mfkiwl/Cornell_CM_Rev2_HW/ClockBuilderPRO/docs/step_11b.jpg

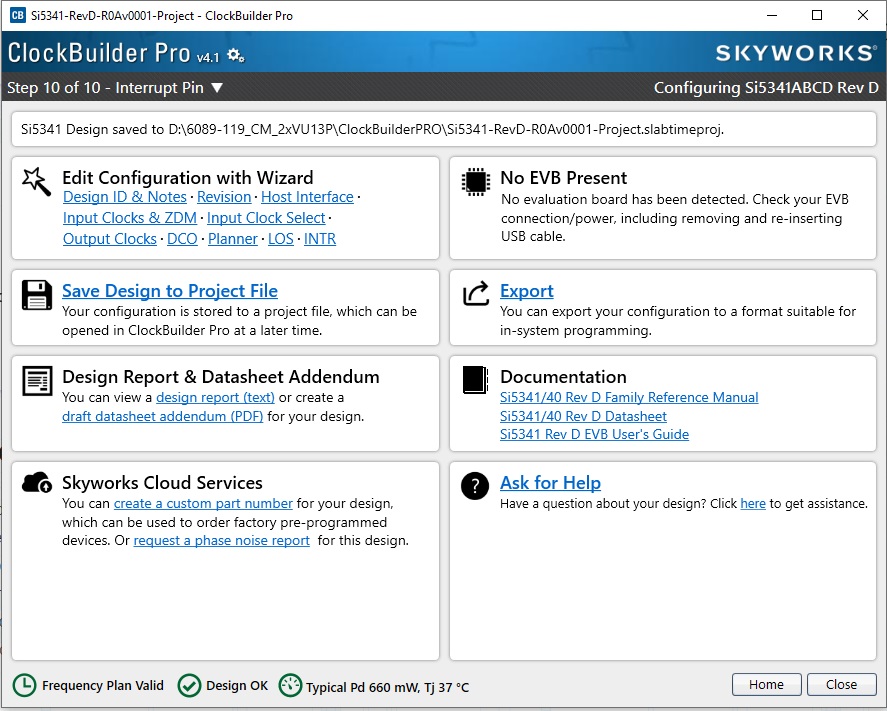
ClockBuilderPRO/docs/step_11b.jpg
