mfkiwl/Cornell_CM_Rev2_HW/ClockBuilderPRO/docs/step_12a.jpg

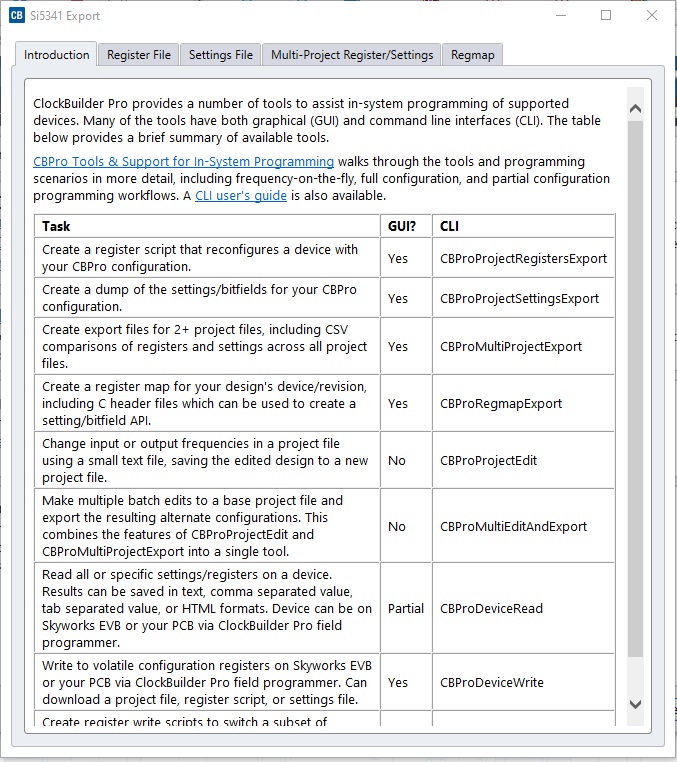
ClockBuilderPRO/docs/step_12a.jpg
