mfkiwl/Cornell_CM_Rev2_HW/Docs/MCU_serial_cable.pdf

MCU Serial Cable
1) The MCU serial cable should only be used when the CM is not mated to an SM. The connector just provides an on-board access point to a serial port that is connected to a serial port on the Zynq on the SM. Connecting the cable when the CM is mated to the SM could damage either the SM or the cable.
2) To use the MCU serial cable, connect it in the orientation shown in the photo below.

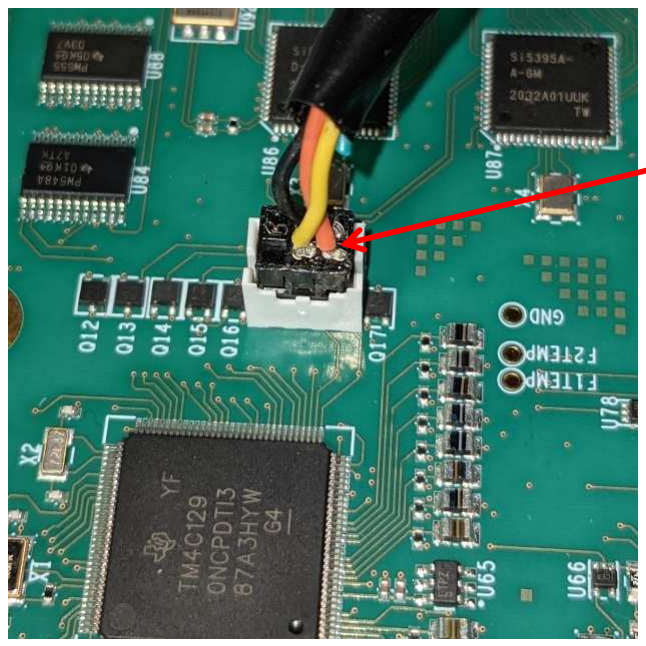
[picture p38: figure]

3) Notice that two pins should be cut off from inside the connector. If you insert the cable the wrong way, you would be trying to make a connection to these missing pins.

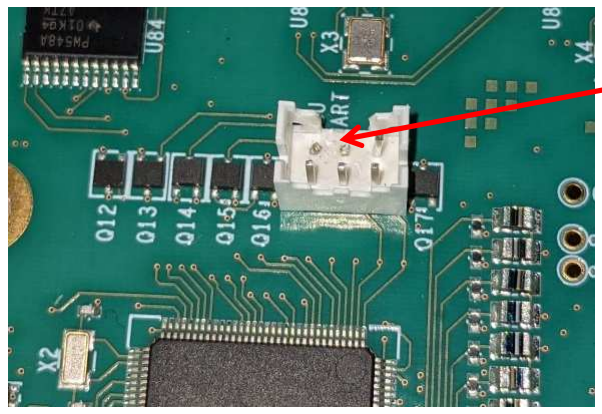
[picture p39: figure]

### Cut pins

### Orange wire at this

### corner
