mfkiwl/Cornell_CM_Rev2_HW/Docs/6089-119-RevB_summary_BOM_with_inventory_17May2022.xlsx

6089-119 |  | Rev B
Apollo Command Module V2, MK1
Qty | 11
Item | quan/board | Reference | Description | Vendor | Vendor Number | Manufacturer | Manufacturer Number | Value | Footprint | Required | On Hand | Excess | % Excess | Short | Unit Cost | Board Cost | DC Bias | Rating | Rating Mult
1 | 3 | BR1,BR2,BR3 | BRACKET FOR FRONT PANEL, SCREW M3 4 PIN PCB RA | DigiKey | 36-7761-ND | Keystone | 7761 | KEYSTONE_7761 | KEYSTONE_7761 | 33 | 35 | 2 | 6.060606061% | -2 | $0.34 | $1.03
2 | 4 | C97,C134,C136,C156 | CAP CER 12PF 50V C0G/NPO 0402 | DigiKey | 311-1641-6-ND | Yageo | CC0402FRNPO9BN120 | 12 PF | CAPC_EIA0402 | 44 | 100 | 56 | 127.2727273% | -56 | $0.02 | $0.09
3 | 2 | C296,C768 | CAP CER 470PF 16V NPO 0402 | DigiKey | 311-3745-6-ND | Yageo | CC0402JRNPO7BN471 | 470 PF | CAPC_EIA0402 | 22 | 100 | 78 | 354.5454545% | -78 | $0.03 | $0.07
4 | 6 | C2,C3,C4,C5,C6,C7 | CAP CER 10000PF 25V C0G/NP0 0603 | DigiKey | 399-7838-6-ND | Kemet | C0603C103J3GACTU | 0.01 UF | CAPC_EIA0603 | 66 | 82 | 16 | 24.24242424% | -16 | $0.21 | $1.25
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
18 | 8 | C455,C456,C488,C489,C673,C674,C702,C703 | CAP TANT POLY 220UF 6.3V 1411 | DigiKey | 399-5754-6-ND | Kemet | T520B227M006ATE035 | 220 UF | CAPTANT_3528_P1 | 88 | 94 | 6 | 6.818181818% | -6 | $0.71 | $5.70
19 | 10 | C22,C23,C24,C25,C26,C27,C227,C228,C295,C481 | CAP CER 330UF 2.5V X6S 1210 | DigiKey | 490-13972-6-ND | Murata | GRM32EC80E337ME05L | 330 UF | CAPC_EIA1210 | 110 | 106 | 8 | 7.272727273% | -8 | $1.13 | $11.33
 |  |  | Subst for Item 19 |  | 490-13974-1-ND | Murata | GRM32ER60E337ME05L | 330 UF | CAPC_EIA1210 |  | 12
20 | 48 | C449,C450,C451,C452,C453,C454,C482,C483,C484,C485,C486,C487,C500,C501,C504,C505,C516,C517,C518,C519,C525,C526,C527,C528,C586,C587,C588,C589,C609,C610,C611,C612,C627,C628,C645,C646,C667,C668,C669,C670,C671,C672,C696,C697,C698,C699,C700,C701 | CAP TANT 330UF 2.5V 20% 3528 | DigiKey | 399-18632-6-ND | Kemet | T520B337M2R5ATE018 | 330 UF | CAPTANT_3528_P1 | 528 | 524 | 54 | 10.22727273% | -54 | $0.57 | $27.41
 |  |  | Subst for Item 20 |  | 399-11709-1-ND | Kemet | T520B337M2R5ATE009 | 330 UF | CAPTANT_3528_P1 |  | 58
21 | 3 | D1,D2,D3 | LED RGB CLEAR 1206 SMD R/A | DigiKey | 1830-1052-1-ND | Inolux | IN-S126TASRGB | LED_RGB | LED_RGB_INS126T | 33 | 51 | 18 | 54.54545455% | -18 | $0.38 | $1.14
22 | 2 | D4,D5 | LED GREEN CLEAR 2SMD R/A | DigiKey | 754-1057-6-ND | Kingbright | APA2106CGCK | LED_GREEN | LED_APA2106 | 22 | 89 | 67 | 304.5454545% | -67 | $0.24 | $0.48
23 | 1 | J1 | MGRID HDR SHRD RA /SLOTSTDF | DigiKey | WM9841-ND | Molex | 878335320 | CON_2X7_RA | CON_2X7_2MM_RA_XILINX | 11 | 17 | 6 | 54.54545455% | -6 | $1.76 | $1.76
24 | 2 | J2,J3 | CONN RCPT USB2.0 MINI B SMD R/A | DigiKey | H11671CT-ND | Hirose | UX60SC-MB-5ST(80) | CON5 | USB_MINI_B_UX60SC_MB_5ST | 22 | 29 | 7 | 31.81818182% | -7 | $0.55 | $1.10
25 | 1 | J4 | CONN HEADER SMD R/A 10POS 1.27MM | DigiKey | SAM11216-ND | Samtec | FSH-105-04-L-DH-SL | CON10A | CONN_10PIN_FSH | 11 | 13 | 2 | 18.18181818% | -2 | $2.03 | $2.03
26 | 2 | J5,J6 | CONN RCPT HDMI 1.4 R/A NO FLANGE | DigiKey | 380-SS-53000-001-ND | Stewart | SS-53000-001 | CON_HDMI19_SS_53000_001 | CON_HDMI19_SS_53000_001 | 22 | 29 | 7 | 31.81818182% | -7 | $0.53 | $1.06
27 | 1 | J7 | PIN HEADER, SMT, DUAL ROW, 2.00 | DigiKey | 1849-PM20C03HBDN-ND | Metz | PM20C03HBDN | CON6 | HEADER_2MM_2x3_SMD_RA | 11 | 20 | 9 | 81.81818182% | -9 | $0.30 | $0.30
28 | 1 | J10 | TERM BLOCK HDR 4POS VERT 3.81MM | DigiKey | A98202-ND | TE | 284517-4 | TB4 | TB4 | 11 | 16 | 5 | 45.45454545% | -5 | $0.94 | $0.94
29 | 2 | J11,J12 | CONN HEADER SMD 20POS 1MM | DigiKey | SAM15625-ND | Samtec | FTM-110-03-L-DV | CON20A | CONN_FTM_20 | 22 | 23 | 1 | 4.545454545% | -1 | $3.95 | $7.89
30 | 4 | L1,L2,L3,L4 | FERRITE BEAD 600 OHM 0603 1LN | DigiKey | 732-1593-1-ND | Wurth | 742792651 | 600 OHM | IND_EIA0603 | 44 | 87 | 43 | 97.72727273% | -43 | $0.23 | $0.90
31 | 48 | L5,L6,L7,L8,L9,L10,L11,L12,L13,L14,L15,L16,L17,L18,L19,L20,L21,L22,L23,L24,L25,L26,L27,L28,L29,L30,L31,L32,L33,L34,L35,L36,L37,L38,L39,L40,L41,L42,L43,L44,L45,L46,L47,L48,L49,L50,L51,L52 | FIXED IND 1UH 2.8A 66 MOHM SMD | DigiKey | 445-180339-6-ND | TDK | TFM201608ALC-1R0MTCA | 1.0 UH | IND_0806 | 528 | 621 | 93 | 17.61363636% | -93 | $0.26 | $12.29
32 | 1 | P1 | CONN, RIGHT-ANGLE POWER/SIGNAL HEADER | Samtec | ET60T-D02-3-08-000-S-R1-S | Samtec | ET60T-D02-3-08-000-S-R1-S | ET60T | ET60T-02-24-00-X-RT1-GP | 11 | 12 | 1 | 9.090909091% | -1 | $8.40 | $8.40
33 | 2 | P2,P3 | CONN, RIGHT-ANGLE ERM8 2X13 | Samtec | ERM8-013-01-S-D-RA-TR | Samtec | ERM8-013-01-S-D-RA-TR | ERM8 | ERM8-RA-2X13 | 22 | 24 | 2 | 9.090909091% | -2 | $9.18 | $18.36
34 | 17 | Q1,Q2,Q3,Q4,Q5,Q6,Q7,Q8,Q9,Q10,Q11,Q12,Q13,Q14,Q15,Q16,Q17 | MOSFET N-CH 20V 1.5A 1.8V LOGIC LEVEL TUMT3 | DigiKey | RUF015N02TLDKR-ND | Rohm | RUF015N02TL | FET_N_1.8V | RUF015N02_FET | 187 | 260 | 73 | 39.03743316% | -73 | $0.26 | $4.42
35 | 12 | C882,C889,R301,R302,R384,R387,R399,R410,R421,R434,R441,R446 | RES SMD 0 OHM JUMPER 1/16W 0402 | DigiKey | 311-0.0JRTR-ND | Yageo | RC0402JR-070RL | 0 | CAPC_EIA0402 | 132 | 1000 | 868 | 657.5757576% | -868 | $0.0012 | $0.01
36 | 60 | R76,R77,R78,R79,R162,R187,R188,R190,R191,R205,R235,R268,R284,R287,R290,R292,R294,R309,R316,R335,R359,R374,R381,R382,R393,R462,R463,R464,R465,R466,R467,R473,R474,R480,R481,R484,R486,R487,R492,R494,R622,R623,R633,R634,R636,R638,R640,R642,R648,R652,R654,R656,R658,R663,R664,R665,R670,R676,R677,R678 | RES SMD 0.0OHM JUMPER 1/10W 0603 | DigiKey | 311-0.0GRTR-ND | Yageo | RC0603JR-070RL | 0 | RESC_EIA0603 | 660 | 1000 | 340 | 51.51515152% | -340 |  | $0.00
37 | 1 | R145 | RES 0.001 OHM 1% 3W 1216 | DigiKey | 541-3135-6-ND | Vishay | WSK12161L000FEB | 0.001 | RESC_WSK1216_4WIRE | 11 | 23 | 12 | 109.0909091% | -12 | $0.8080 | $0.81
38 | 2 | R20,R146 | RES 0.005 OHM 1% 1/2W 1206 4-WIRE | DigiKey | FC4TR005FERDKR-ND | Ohmite | FC4TR005FER‎ | 0.005 | RESC_FC4T_4WIRE_1206 | 22 | 81 | 59 | 268.1818182% | -59 | $0.3800 | $0.76
39 | 2 | R73,R74 | RES 0.01 OHM 1% 1/2W 1206 4-WIRE | DigiKey | FC4TR010FERDKR-ND | Ohmite | FC4TR010FER | 0.01 | RESC_FC4T_4WIRE_1206 | 22 | 84 | 62 | 281.8181818% | -62 | $0.3800 | $0.76
40 | 12 | R80,R83,R93,R97,R103,R108,R115,R119,R124,R129,R137,R138 | RES SMD 33 OHM 1% 1/10W 0603 | DigiKey | 311-33.0HRDKR-ND | Yageo | RC0603FR-0733RL | 33 | RESC_EIA0603 | 132 | 200 | 68 | 51.51515152% | -68 | $0.0029 | $0.03
41 | 80 | R33,R34,R35,R36,R37,R38,R39,R40,R41,R42,R43,R44,R45,R46,R47,R48,R49,R50,R51,R52,R53,R54,R55,R56,R57,R58,R59,R60,R61,R62,R63,R64,R65,R66,R67,R68,R69,R70,R71,R72,R498,R499,R500,R501,R502,R503,R504,R505,R506,R507,R508,R509,R510,R511,R512,R513,R514,R515,R516,R517,R518,R519,R520,R521,R522,R523,R524,R525,R526,R527,R528,R529,R530,R531,R532,R533,R534,R535,R536,R537 | RES SMD 49.9 OHM 1% 1/10W 0402 | DigiKey | 311-49.9LRDKR-ND | Yageo | RC0402FR-0749R9L | 49.9 | RESC_EIA0402 | 880 | 2000 | 1120 | 127.2727273% | -1120 | $0.0018 | $0.14
42 | 75 | R85,R86,R87,R88,R89,R90,R91,R92,R94,R96,R102,R104,R118,R121,R125,R127,R130,R132,R133,R135,R136,R139,R257,R258,R259,R260,R270,R271,R272,R273,R274,R275,R276,R277,R278,R279,R280,R281,R310,R311,R312,R313,R330,R331,R333,R334,R337,R338,R350,R351,R352,R353,R354,R355,R356,R358,R424,R425,R426,R427,R428,R429,R430,R431,R435,R436,R439,R440,R443,R444,R447,R469,R470,R471,R472 | RES SMD 100 OHM 0.1% 1/16W 0402 | DigiKey | YAG2301DKR-ND | Yageo | RT0402BRD07100RL | 100 | RESC_EIA0402 | 825 | 1210 | 385 | 46.66666667% | -385 | $0.0530 | $3.98
43 | 6 | R3,R4,R6,R7,R9,R10 | RES SMD 150 OHM 1% 1/10W 0603 | DigiKey | 311-150HRDKR-ND | Yageo | RC0603FR-07150RL | 150 | RESC_EIA0603 | 66 | 100 | 34 | 51.51515152% | -34 | $0.0032 | $0.02
44 | 14 | R317,R336,R370,R385,R386,R395,R400,R432,R442,R450,R453,R459,R461,R468 | RES SMD 240 OHM 1% 1/16W 0402 | DigiKey | 311-240LRCT-ND | Yageo | RC0402FR-07240RL | 240 | RESC_EIA0402 | 154 | 1000 | 846 | 549.3506494% | -846 | $0.0018 | $0.03
45 | 2 | R98,R99 | RES SMD 249 OHM 0.1% 1/5W 0805 | DigiKey | TNP249ABCT-ND | Vishay | TNP249ABCT-ND | 249 | RESC_EIA0805 | 22 | 29 | 7 | 31.81818182% | -7 | $0.3780 | $0.76
46 | 9 | R1,R2,R5,R8,R11,R185,R186,R189,R192 | RES SMD 270 OHM 1% 1/10W 0603 | DigiKey | 311-270HRDKR-ND | Yageo | RC0603FR-07270RL | 270 | RESC_EIA0603 | 99 | 200 | 101 | 102.020202% | -101 | $0.0029 | $0.03
47 | 1 | R675 | RES SMD 348 OHM 0.1% 1/10W 0603 | DigiKey | P348DBDKR-ND | Panasonic | ERA-3AEB3480V | 348 | RESC_EIA0603 | 11 | 50 | 39 | 354.5454545% | -39 | $0.1590 | $0.16
48 | 1 | R149 | RES SMD 432 OHM 0.1% 1/5W 0603 | DigiKey | P19930DKR-ND | Panasonic | ERJ-PB3B4320V | 432 | RESC_EIA0603 | 11 | 44 | 33 | 300% | -33 | $0.2290 | $0.23
49 | 1 | R107 | RES SMD 499 OHM 0.1% 1/16W 0402 | DigiKey | P499DCDKR-ND | Panasonic | ERA-2AEB4990X | 499 | RESC_EIA0402 | 11 | 84 | 73 | 663.6363636% | -73 | $0.1680 | $0.17
50 | 24 | R75,R140,R299,R300,R306,R307,R308,R375,R377,R388,R389,R394,R397,R409,R411,R422,R437,R438,R445,R448,R451,R452,R456,R460 | RES SMD 1K OHM 1% 1/16W 0402 | DigiKey | 311-1.00KLRCT-ND | Yageo | RC0402FR-071KL | 1K | RESC_EIA0402 | 264 | 1000 | 736 | 278.7878788% | -736 | $0.0018 | $0.04
51 | 92 | R113,R150,R151,R160,R161,R173,R174,R203,R204,R215,R216,R233,R234,R247,R248,R283,R285,R315,R332,R360,R361,R362,R363,R364,R365,R367,R368,R369,R371,R372,R373,R379,R392,R406,R417,R418,R457,R458,R495,R496,R540,R541,R544,R545,R548,R549,R552,R553,R556,R557,R560,R561,R564,R565,R568,R569,R572,R573,R576,R577,R580,R581,R584,R585,R588,R589,R592,R593,R596,R597,R600,R601,R604,R605,R608,R609,R612,R613,R616,R617,R639,R641,R643,R653,R655,R657,R659,R660,R661,R671,R672,R673 | RES SMD 2.2K OHM 1% 1/10W 0603 | DigiKey | 311-2.20KHRCT-ND | Yageo | RC0603FR-072K2L | 2.2k | RESC_EIA0603 | 1012 | 2000 | 988 | 97.6284585% | -988 | $0.0029 | $0.27
52 | 40 | R538,R539,R542,R543,R546,R547,R550,R551,R554,R555,R558,R559,R562,R563,R566,R567,R570,R571,R574,R575,R578,R579,R582,R583,R586,R587,R590,R591,R594,R595,R598,R599,R602,R603,R606,R607,R610,R611,R614,R615 | RES SMD 3.3K OHM 1% 1/10W 0603 | DigiKey | 311-3.30KHRDKR-ND | Yageo | RC0603FR-073K3L | 3.3K | RESC_EIA0603 | 440 | 1000 | 560 | 127.2727273% | -560 | $0.0029 | $0.12
53 | 8 | R153,R164,R165,R207,R208,R219,R237,R238 | RES SMD 3.74K OHM 1% 1/10W 0603 | DigiKey | P3.74KHDKR-ND | Panasonic | ERJ-3EKF3741V | 3.74K | RESC_EIA0603 | 88 | 200 | 112 | 127.2727273% | -112 | $0.0180 | $0.14
54 | 41 | R14,R15,R16,R17,R18,R19,R101,R114,R116,R126,R147,R148,R172,R176,R195,R196,R197,R198,R218,R295,R296,R297,R329,R383,R401,R402,R403,R404,R405,R412,R479,R483,R682,R683,R684,R685,R686,R687,R688,R689,R690 | RES SMD 4.7K OHM 1% 1/10W 0603 | DigiKey | 311-4.70KHRDKR-ND | Yageo | RC0603FR-074K7L | 4.7K | RESC_EIA0603 | 451 | 1000 | 549 | 121.72949% | -549 | $0.0029 | $0.12
55 | 96 | R12,R81,R82,R84,R95,R100,R105,R106,R117,R120,R122,R123,R128,R156,R157,R168,R169,R179,R180,R211,R212,R222,R223,R229,R230,R241,R242,R267,R269,R282,R286,R288,R289,R291,R293,R304,R314,R318,R320,R322,R324,R326,R328,R340,R342,R344,R345,R347,R349,R357,R366,R376,R378,R390,R398,R454,R455,R475,R476,R477,R478,R482,R485,R488,R489,R490,R491,R493,R497,R618,R619,R620,R621,R625,R626,R627,R628,R629,R630,R631,R632,R637,R644,R645,R646,R647,R649,R650,R651,R662,R666,R667,R668,R669,R674,R680 | RES SMD 10K OHM 1% 1/10W 0603 | DigiKey | 311-10.0KHRDKR-ND | Yageo | RC0603FR-0710KL | 10K | RESC_EIA0603 | 1056 | 2000 | 944 | 89.39393939% | -944 | $0.0029 | $0.28
56 | 3 | R175,R217,R256 | RES SMD 11K OHM 1% 1/10W 0603 | DigiKey | 311-11.0KHRDKR-ND | Yageo | RC0603FR-0711KL | 11.0K | RESC_EIA0603 | 33 | 100 | 67 | 203.030303% | -67 | $0.0029 | $0.01
57 | 5 | R13,R152,R226, R194,R253 | RES SMD 12.1K OHM 1% 1/10W 0603 | DigiKey | 311-12.1KHRTR-ND | Yageo | RC0603FR--712K1L | 12.1K | RESC_EIA0603 | 55 | 100 | 45 | 81.81818182% | -45 | $0.0029 | $0.01
58 | 4 | R199,R246,R262,R263 | RES SMD 16.2KOHM 0.1% 1/10W 0603 | DigiKey | P16.2KDBDKR-ND | Panasonic | ERA-3AEB1622V | 16.2K | RESC_EIA0603 | 44 | 85 | 41 | 93.18181818% | -41 | $0.1590 | $0.64
59 | 2 | R200,R261 | RES SMD 17.8K OHM 0.1% 1/5W 0603 | DigiKey | P20112DKR-ND | Panasonic | ERJ-PB3B1782V | 17.8K | RESC_EIA0603 | 22 | 41 | 19 | 86.36363636% | -19 | $0.2290 | $0.46
60 | 6 | R21,R22,R23,R24,R25,R26 | RES SMD 28K OHM 0.1% 1/10W 0603 | DigiKey | P28KDBDKR-ND | Panasonic | ERA-3AEB2802V | 28.0K | RESC_EIA0603 | 66 | 81 | 15 | 22.72727273% | -15 | $0.1590 | $0.95
61 | 2 | R201,R265 | RES SMD 31.6K OHM 0.1% 1/5W 0603 | DigiKey | P20141DKR-ND | Panasonic | ERJ-PB3B3162V | 31.6K | RESC_EIA0603 | 22 | 41 | 19 | 86.36363636% | -19 | $0.2290 | $0.46
62 | 1 | R236 | RES SMD 38.3KOHM 0.1% 1/10W 0603 | DigiKey | 311-38.3KHRTR-ND | Yageo | RC0603FR-0738K3L | 38.3K | RESC_EIA0603 | 11 | 100 | 89 | 809.0909091% | -89 | $0.1730 | $0.17
63 | 2 | R691,R692 | RES SMD 47K OHM 1% 1/10W 0603 | DigiKey | 311-47.0KHRDKR-ND | Yageo | RC0603FR-0747KL | 47K | RESC_EIA0603 | 22 | 100 | 78 | 354.5454545% | -78 | $0.0029 | $0.01
64 | 6 | R27,R28,R29,R30,R31,R32 | RES SMD 60.4KOHM 0.1% 1/10W 0603 | DigiKey | P60.4KDBDKR-ND | Panasonic | ERA-3AEB6042V | 60.4K | RESC_EIA0603 | 66 | 82 | 16 | 24.24242424% | -16 | $0.1590 | $0.95
65 | 1 | R266 | RES SMD 61.9KOHM 0.1% 1/10W 0603 | DigiKey | P61.9KDBDKR-ND | Panasonic | ERA-3AEB6192V | 61.9K | RESC_EIA0603 | 11 | 93 | 82 | 745.4545455% | -82 | $0.1590 | $0.16
66 | 2 | R193,R255 | RES SMD 110K OHM 0.1% 1/10W 0603 | DigiKey | P110KDBDKR-ND | Panasonic | ERA-3AEB114V | 110K | RESC_EIA0603 | 22 | 100 | 78 | 354.5454545% | -78 | $0.0029 | $0.01
67 | 16 | R154,R159,R166,R171,R177,R182,R209,R214,R220,R225,R227,R232,R239,R244,R245,R254 | RES SMD 121K OHM 1% 1/10W 0603 | DigiKey | 311-121KHRTR-ND | Yageo | RC0603FR-07121KL | 121K | RESC_EIA0603 | 176 | 1000 | 824 | 468.1818182% | -824 | $0.0028 | $0.04
68 | 1 | R264 | RES SMD 147K OHM 0.1% 1/16W 0603 | DigiKey | A124705DKR-ND | TE | RN73C1J147KBTD | 147K | RESC_EIA0603 | 11 | 18 | 7 | 63.63636364% | -7 | $0.7892 | $0.79
69 | 6 | SW1,SW2,SW3,SW4,SW5,SW6 | SWITCH SLIDE DPDT 200MA 12V GOLD | DigiKey | 563-1345-6-ND | Nidec | CL-SB-22B-12T | SW DPDT |  | 66 | 88 | 22 | 33.33333333% | -22 | $0.94 | $5.62
70 | 2 | U1,U122 | DC DC CONVERTER 0.59-5.1V 30W | DigiKey | 454-1280-ND | Artesyn | LDO06C-005W05-HJ | LDO06C_HJ | LDO06C_HJ | 22 | 24 | 2 | 9.090909091% | -2 | $9.71 | $19.42
71 | 6 | U10,U12,U15,U18,U83,U88 | IC I/O EXPANDER I2C 16B 24TSSOP | DigiKey | 296-24827-1-ND | TI | TCA9555PWR | TCA9555 | TSSOP-24 | 66 | 83 | 17 | 25.75757576% | -17 | $0.96 | $5.75
72 | 7 | U105,U106,U107,U108,U109,U117,U118 | DC DC CONVERTER, 2 X 0.6-5.2V 40 AMP | DigiKey | 454-1792-6-ND | Artesyn | LGA80D-00DADJJ | LGA80D | LGA80D | 77 | 75 | -2 | -2.597402597% | 2 | $33.08 | $231.58
73 | 6 | U13,U16,U19,U20,U21,U22 | IC REG LIN POS ADJ 400MA SOT223 | DigiKey | 296-16909-6-ND | TI | TPS73601DCQR | TPS73601 | TPS73601_SOT223_6 | 66 | 84 | 18 | 27.27272727% | -18 | $1.47 | $8.80
74 | 3 | U2,U47,U48 | IC VOLT SUPERVISOR 1.8V SOT23-6 | DigiKey | 296-17192-6-ND | TI | TPS3808G18DBVR | TPS3808-1.8 | SOT23-6 | 33 | 38 | 5 | 15.15151515% | -5 | $1.42 | $4.25
75 | 5 | U23,U45,U46,U120,U123 | IC CURR SENSE 1 CIRCUIT GAIN=100 8SOIC | DigiKey | 296-INA240A3QDRQ1DKR-ND | TI | INA240A3QDRQ1 | INA240A3-Q1 | SOIC050P240-8 | 55 | 55 | 0 | 0% | 0 | $3.25 | $16.25
76 | 6 | U3,U4,U5,U6,U7,U8 | TVS DIODE 5.5V 14V 10USON | DigiKey | 296-40696-6-ND | TI | TPD4E05U06QDQARQ1 | TVS_TPD4E05 | TPD4E05_USON_10 | 66 | 81 | 15 | 22.72727273% | -15 | $0.47 | $2.83
77 | 5 | U49,U58,U62,U63,U73 | IC BUFFER NON-INVERT 5.5V SOT5 | DigiKey | 296-18013-1-ND | TI | SN74LVC1G126DRLR | 74LVC1G126 | SOT5_DRL | 55 | 84 | 29 | 52.72727273% | -29 | $0.24 | $1.19
78 | 8 | U50,U51,U52,U53,U54,U55,U80,U81 | IC TRNSLTR UNIDIRECTIONAL SC70-5 | DigiKey | 296-34900-6-ND | TI | SN74AUP1T34DCKR | 74AUP1T34 | SC-70-5 | 88 | 229 | 141 | 160.2272727% | -141 | $0.28 | $2.24
79 | 2 | U56,U57 | IC REG LINEAR 1.8V 3A 16TSSOP | DigiKey | LT1764AEFE-1.8#PBF-ND | Analog Devices | LT1764AEFE-1.8#PBF | LT1764A-1.8 | TSSOP-16_PAD | 22 | 23 | 1 | 4.545454545% | -1 | $6.01 | $12.01
80 | 6 | U59,U60,U67,U69,U74,U78 | IC BUFFER NON-INVERT 5.5V SOT5 | DigiKey | 296-18012-6-ND | TI | SN74LVC1G125DRLR | 74LVC1G125 | SOT5_DRL | 66 | 106 | 40 | 60.60606061% | -40 | $0.25 | $1.52
81 | 15 | U61,U66,U70,U110,U111,U112,U113,U114,U115,U116,U119,U121,U124,U125,U126 | IC GATE AND 1CH 2-INP SOT5 | DigiKey | 296-18011-1-ND | TI | SN74LVC1G08DRLR | 74LVC1G08 | SOT5_DRL | 165 | 212 | 47 | 28.48484848% | -47 | $0.17 | $2.54
82 | 1 | U64 | IC VOLT SUPERVISOR 3.3V SOT23-6 | DigiKey | 296-17195-6-ND | TI | TPS3808G33DBVR | TPS3808-3.3 | SOT23-6 | 11 | 18 | 7 | 63.63636364% | -7 | $1.45 | $1.45
83 | 1 | U65 | IC VREF SERIES 2.5V SOT23-6 | DigiKey | LT1790BIS6-2.5#TRMPBFCT-ND | Linear | LT1790BIS6-2.5#TRMPBF | LT1790-2.5V | TSOT23-6 | 11 | 17 | 6 | 54.54545455% | -6 | $2.35 | $2.35
84 | 1 | U68 | IC MCU 32BIT 1MB FLASH 128TQFP | DigiKey | 296-43658-1-ND | TI | TM4C1290NCPDTI3R | TM4C1290NCPDT | LQFP128 | 11 | 13 | 2 | 18.18181818% | -2 | $9.32 | $9.32
85 | 1 | U71 | XTAL OSC XO 200.0000MHZ LVDS | DigiKey | 336-2666-ND | Silicon Labs | 510BBA200M000AAG | SI510_200P0000 | SI510 | 11 | 12 | 1 | 9.090909091% | -1 | $4.19 | $4.19
86 | 2 | U72,U85 | IC FLASH 1GBIT SPI/QUAD 16SOP | DigiKey | 1092-1258-ND | Macronix | MX66U1G45GMI00 | MM66U1G45 | MM66U1G45_SO16 | 22 | 23 | 1 | 4.545454545% | -1 | $9.76 | $19.52
87 | 0 | U76,U79 | DNP | DigiKey | 296-12605-6-ND | TI | SN74LVC2G157DCUR | DNP | VSSOP-8 | 0 |  |  |  | 0 | $0.54 | $0.00
88 | 1 | U82 | IC BUFFER 2:4 LVDS MUX 16QFN | DigiKey | 336-4763-6-ND | Silicon Labs | SI53340-B-GM | SI53340 | QFN-16 | 11 | 22 | 11 | 100% | -11 | $1.56 | $1.56
89 | 1 | U86 | SI5341A-D SYNTH, 10-OUT, 1.028 GHZ, 64QFN | DigiKey | 336-3769-ND | Silicon Labs | SI5341A-D-GM | SI5341 | SI5341_QFN64 | 11 | 38 | 27 | 245.4545455% | -27 | $15.81 | $15.81
90 | 4 | U87,U89,U90,U91 | IC SNGL PLL JITTER ATTEN 64QFN | DigiKey | 336-4802-ND | Silicon Labs | SI5395A-A-GM | SI5395 | SI5341_QFN64 | 44 | 41 | -3 | -6.818181818% | 3 | $27.00 | $108.00
91 | 7 | U9,U11,U14,U17,U44,U84,U102 | IC I2C SW 8CH W/RESET 24TSSOP | DigiKey | 296-34905-6-ND | TI | TCA9548APWR | TCA9548A | TSSOP-24 | 77 | 94 | 17 | 22.07792208% | -17 | $0.98 | $6.85
92 | 1 | U92 | XTAL OSC XO 322.265625MHZ LVDS | DigiKey | 336-6124-ND | Silicon Labs | 545BAA000274BBG | SI545_322P265625 | SI545 | 11 | 11 | 0 | 0% | 0 | $13.17 | $13.17
93 | 1 | U93 | 512K 3.4MHZ I2C SERIAL EEPROM | DigiKey | 150-24CS512T-I/SNCT-ND | Microchip | 24CS512T-I/SN | 24CS512 | SOIC050P240-8 | 11 | 24 | 13 | 118.1818182% | -13 | $0.32 | $0.32
94 | 2 | U94,U95 | SENSOR ANALOG -40C-125C 6DFN | DigiKey | LTC2997HDCB#TRMPBFDKR-ND | Analog Devices | LTC2997HDCB#TRMPBF | LTC2997H | LTC2997H_DFN6 | 22 | 42 | 20 | 90.90909091% | -20 | $2.86 | $5.72
95 | 8 | U96,U97,U98,U99,U100,U101,U103,U104 | SI53342 | SI53342_QFN24 | 336-3840-ND | Silicon Labs | SI53342-B-GM | Si53342 | SI53342_QFN24 | 88 | 88 | 0 | 0% | 0 | $2.00 | $16.00
96 | 1 | X1 | CRYSTAL 16.0000MHZ 9PF SMD | DigiKey | XC1611DKR-ND | ECS | ECS-160-9-42-CKM-TR | 16 MHz | CRYSTAL_ECS_4P0X2P5 | 11 | 13 | 2 | 18.18181818% | -2 | $1.10 | $1.10
97 | 1 | X2 | CRYSTAL 32.7680KHZ 7PF SMD | DigiKey | XC2126DKR-ND | ECS | ECS-.327-7-34R-TR | 32.768 KHZ | CRYSTAL_ECS_3P2x1P5 | 11 | 13 | 2 | 18.18181818% | -2 | $1.03 | $1.03
98 | 5 | X3,X4,X5,X6,X7 | CRYSTAL 48.0000MHZ 8PF SMD | DigiKey | 1253-1377-1-ND | Kyocera | CX3225SB48000D0FPJC1 | 48 MHz | CRYSTAL_SMD4 | 55 | 51 | 6 | 10.90909091% | -6 | $0.80 | $3.98
 |  |  | Subst for Item 98 |  | 478-CX3225SB48000D0WPSC1CT-ND |  | CX3225SB48000D0WPSC1 | 48 MHz | CRYSTAL_SMD4 |  | 10
ADD NOTE ABOUT HOW TO POPULATE 2 CONNECTORS WITH SAME REF NUMBER
SORT REF NUMBERS SEQUENTIALLY
99 | 20 | U24,U27,U32,U34,U37,U42, U25,U28,U33,U35,U38,U43, U26,U29,U30,U31,U36,U39,U40,U41 | CONN, FIREFLY POWER | DigiKey | SAM13041CT-ND | Samtec | UCC8-010-1-H-S-1-A | UCC8 | CONN_SAMTEC_UCC8 | 220 | 231 |  |  | -11 | $2.62 | $52.36
100 | 20 | U24,U27,U32,U34,U37,U42, U25,U28,U33,U35,U38,U43, U26,U29,U30,U31,U36,U39,U40,U41 | CONN, FIREFLY SIGNAL | DigiKey | 612-UEC5-019-2-H-D-RA-1CT-ND | Samtec | UEC5-019-2-H-D-RA-1 | UEC5 | CONN_SAMTEC_UEC5 | 220 | 227 |  |  | -7 | $9.77 | $195.32
101 | 2 | R163,R206 | RES SMD 23.7K OHM 1% 1/10W 0603 | DigiKey | 311-23.7KHRDKR-ND | Yageo | RC0603FR-0723K7L | 23.7K | RESC_EIA0603 | 22 | 100 |  |  | -78 |  | $0.00
Parts below this line are DO NOT POPULATE
 | 6 | BR4,BR5,BR6,BR7,BR8,BR9 | COVER | ATCA_COVER_BLOCK | ATCA COVER BLOCK
 | 4 | C30,C31,C115,C1229 | CAP CER TBD | - | - | - | - | TBD | CAPC_EIA0603 |  |  |  |  |  | $0.00 | $0.00
 | 8 | H1,H2,H3,H4,H5,H6,H7,H8 | HOLE FOR M2.5 SCREW, PART OF PCB |  |  |  |  | DNP | HOLE_M2P5_STANDOFF |  |  |  |  |  | $0.00 | $0.00
 | 2 | J8,J9 | JUMPER ARRAY, DP3T, 0402 PADS |  |  |  |  | DNP | CAP_JUMPER_DP3T |  |  |  |  |  | $0.00 | $0.00
 | 26 | PM1,PM2,PM3,PM4,PM5,PM6,PM7,PM8,PM9,PM10,PM11,PM12,PM13,PM14,PM15,PM16,PM17,PM18,PM19,PM20,PM21,PM22,PM23,PM24,PM25,PM26 | THRU_TestPoint | TESTPT_C55H35 |  |  |  | DNP |  |  |  |  |  |  | $0.00 | $0.00
 | 23 | R109,R110,R111,R112,R141,R142,R143,R144,R319,R321,R323,R325,R327,R339,R341,R343,R346,R348,R408,R624,R635,R679,R681 | RESISTOR | DigiKey |  |  |  | DNP | RESC_EIA0603 |  |  |  |  |  | $0.00 | $0.00
 | 8 | R155,R158,R178,R181,R221,R224,R228,R231 | DNP | RESC_EIA0603 | RES SMD 10K OHM 1% 1/10W 0603 | DigiKey | 311-10.0KHRDKR-ND | Yageo | RC0603FR-0710KL |  |  |  |  |  | $0.00 | $0.00
 | 15 | R131,R134,R167,R170,R183,R184,R202,R210,R213,R240,R243,R249,R250,R251,R252 | DNP | RESC_EIA0603 | RES SMD TBD 1/10W 0603 | DigiKey | TBD | TBD | TBD |  |  |  |  |  | $0.00 | $0.00
 | 2 | R298,R305 | DNP | RESC_EIA0402 | RESISTOR | DigiKey |  |  |  |  |  |  |  |  | $0.00 | $0.00
 | 8 | R303,R380,R391,R396,R407,R423,R433,R449 | DNP | RESC_EIA0402 | RES SMD 0.0OHM JUMPER 0402 | DigiKey |  | Yageo |  |  |  |  |  |  | $0.00 | $0.00
 | 6 | R413,R414,R415,R416,R419,R420 | DNP | RESC_EIA0603 | RES SMD 2.2K OHM 1% 1/10W 0603 | DigiKey | 311-2.20KHRCT-ND | Yageo | RC0603FR-072K2L |  |  |  |  |  | $0.00 | $0.00
 | 2 | SP1,SP2 | SPLICE PLATE, CORNELL DWG 6089-???-RevA | - | - | - | - | DNP | SPLICE_PLATE_APOLLO |  |  |  |  |  | $0.00 | $0.00
 | 3 | TP1,TP2,TP3 | TEST POINT, PART OF PCB |  |  |  |  | DNP | TESTPT_SMPAD |  |  |  |  |  | $0.00 | $0.00
 | 104 | VA1,VA2,VA3,VA4,VA5,VA6,VA7,VA8,VA9,VA10,VA11,VA12,VA13,VA14,VA15,VA16,VA17,VA18,VA19,VA20,VA21,VA22,VA23,VA24,VA25,VA26,VA27,VA28,VA29,VA30,VA31,VA32,VA33,VA34,VA35,VA36,VA37,VA38,VA39,VA40,VA41,VA42,VA43,VA44,VA45,VA46,VA47,VA48,VA49,VA50,VA51,VA52,VA53,VA54,VA55,VA56,VA57,VA58,VA59,VA60,VA61,VA62,VA63,VA64,VA65,VA66,VA67,VA68,VA69,VA70,VA71,VA72,VA73,VA74,VA75,VA76,VA77,VA78,VA79,VA80,VA81,VA82,VA83,VA84,VA85,VA86,VA87,VA88,VA89,VA90,VA91,VA92,VA93,VA94,VA95,VA96,VA97,VA98,VA99,VA100,VA101,VA102,VA103,VA104 | VIA ARRAY, PART OF PCB |  |  |  |  | DNP | VIA_ARRAY_19H10 |  |  |  |  |  | $0.00 | $0.00
 | 2 | U75,U77 | FPGA_VU13P_A2577 |  |  |  |  |  | FPGA_A2577 |  |  |  |  |  | $0.00 | $0.00
 | 2320
