mfkiwl/Cornell_CM_Rev2_HW/Docs/6089-119-RevB_HARDWARE_BOM_17May2022.xlsx

6089-119
ATCA MEZZANINE BOARD WITH DUAL VU13P
Qty | 11
Item | quan/board | Description | Vendor | Vendor Number | Manufacturer | Manufacturer Number | Value | Required | Min Excess | Min Qty | On Hand | Short | Ordered | Received | Unit Cost | Board Cost | Total Cost | Cost Source
 | 1 | HEAT SINK, TOP FPGA, CORNELL DWG 6089-123-RevA |  |  |  |  |  | 11 | 0 | 11 | 14 |  |  |  | $50.00 | $50.00 | $0.00 | $34 in quantity
 | 1 | HEAT SINK, BOTTOM FPGA, CORNELL DWG 6089-124-RevA |  |  |  |  |  | 11 | 0 | 11 | 11 |  |  |  | $50.00 | $50.00 | $0.00 | $34 in quantity
 | 1 | HEAT SINK, FIREFLY, CORNELL DWG 6089-121-RevA |  |  |  |  |  | 11 | 0 | 11 | 12 |  |  |  | $50.00 | $50.00 | $0.00
 | 1 | HEAT SINK, LGA80D, CORNELL DWG 6089-122-RevA |  |  |  |  |  | 11 | 0 | 11 | 12 |  |  |  | $50.00 | $50.00 | $0.00
 | 2 | SPLICE PLATE, CORNELL DWG 6089-114-RevA |  |  |  |  |  | 22 | 0 | 22 | 24 |  |  |  | $10.00 | $20.00 | $0.00
 | 1 | FRONT SUBPANEL, CORNELL DWG 6089-xxx-RevA |  |  |  |  |  | 11 | 0 | 11 | 6 | 5 |  |  | $60.00 | $60.00 | $0.00
 | 14 | ATCA COVER MOUNTING BLOCK, CORNELL DWG 6089-120 6 FOR CM, 8 FOR SM |  |  |  |  |  | 154 | 0 | 154 | 160
 | 8 | PEMNUT, M3 THREAD, 3 MM LONG FOR SPLICE PLATES | D.B. Roberts | SOA-M3-3 | Penn Engineering | SOA-M3-3 |  | 88 | 6 | 94 | 100 |  |  |  | $0.18 | $1.48 | $0.00
 | 8 | SPRING, PRESSURE FOR FPGA HEAT SINK | Alpha Novatech | S001YJ24 | Alpha Novatech | S001YJ24 |  | 88 | 6 | 94 | 77 | 17 |  |  | $0.95 | $7.60 | $0.00
 | 4 | SPRING, PRESSURE FOR FIREFLY HEAT SINK | Alpha Novatech | S001YJ1D | Alpha Novatech | S001YJ1D |  | 44 | 4 | 48 | 95 |  |  |  | $0.95 | $3.80 | $0.00
 | 8 | HEX STANDOFF M3 12 MM 8 FOR FPGA HEATSINK CUSTOM ORDER NOT NECESSARY | DigiKey | 36-24434-ND | Keystone | 24434 | 12 MM X M3 | 88 | 6 | 94 | 200 |  |  |  | $1.42 | $11.38 | $0.00
 | 5 | HEX STANDOFF M2.5X0.45 BRASS 8MM 4 FOR FIREFLY HEATSINK 1 FOR TOP COVER LOCATION UNDER THE SM'S FRONT PANEL BOARD CUSTOM ORDER NOT NECESSARY | DigiKey | AE10868-ND | Assmann | V6516B | 8 MM X M2.5 | 55 | 4 | 59 | 86 |  |  |  | $0.13 | $0.64 | $0.00
 | 8 | HEX STANDOFF M2.5 45 MM FOR FRONT PANEL FIBER FEEDTHRUS CONSIDER SHORTER STANDOFFS IF FIREFLY BOOTS ALLOW | DigiKey | 732-13036-ND | Wurth | 970450155 | 45 MM X M2.5 | 88 | 6 | 94 | 0 | 94 | 100 |  | $1.04 | $8.32 | $104.06
 | 15 | HEX STANDOFF M2.5 20 MM 5 MOUNTED ON CM FOR TOP COVERS 10 MOUNTED ON SM FOR TOP COVERS CUSTOM ORDER 21.5 MM LENGTH | DigiKey | 732-12874-ND | Wurth | 970200154 | 20 MM X M2.5 | 165 | 10 | 175 | 24 | 151 | 150 |  | $0.55 | $8.23 | $82.32
 | 4 | HEX STANDOFF M2.5 12 MM FOR LGA80D HEATSINK CUSTOM ORDER 13 MM LENGTH | DigiKey | AE10793-ND | Assmann | V6622C | 12 MM X M2.5 | 44 | 4 | 48 | 65 |  |  |  | $0.16 | $0.66 | $0.00
 | 8 | SHOULDER WASHER M3 8 FOR FPGA HEATSINK | DigiKey | RPC4366-ND | Essentra | MNI M3-2.5 |  | 88 | 6 | 94 | 91 |  | 100
 | 4 | SHOULDER WASHER M2.5 4 FOR FIREFLY HEATSINK | DigiKey | RP932-ND | Essentra | MNI-M2.5-1.3 |  | 44 | 4 | 48 | 92 |  | 100
 | 8 | SCREW, M3-0.5, 12 MM LONG, PHILLIPS CHEESE HEAD, 8 FOR FPGA HEATSINK DO NOT CHANGE THE LENGTH. THE 12 MM SCREW FROM THE TOP SHOULD HIT THE 8 MM SCREW FROM THE BOTTOM. | Grainger | 31JT08 |  |  |  | 88 | 6 | 94 | 200 |  |  |  | $0.05 | $0.44 | $0.00
 | 8 | SCREW, M3-0.5, 8 MM LONG, PHILLIPS CHEESE HEAD, 8 FOR FPGA HEATSINK STANDOFFS DO NOT CHANGE THE LENGTH. THE 12 MM SCREW FROM THE TOP SHOULD HIT THE 8 MM SCREW FROM THE BOTTOM. | Grainger | 31JT06 |  |  |  | 88 | 6 | 94 | 200 |  |  |  | $0.05 | $0.44 | $0.00
 | 11 | SCREW,M3-0.5, 6 MM LONG, PHILLIPS CHEESE HEAD 8 FOR SPLICE PLATES 3 FOR FRONT SUBPANEL | Grainger | 31JT05 |  |  |  | 121 | 8 | 129 | 200 |  |  |  | $0.06 | $0.62 | $0.00
 | 12 | SCREW, M2.5-0.45, 6 MM LONG, SLOTTED CHEESE HEAD, 4 FOR LGA80D HEATSINK STANDOFFS 4 FOR FIREFLY HEATSINK STANDOFFS 4 FOR LGA80D HEATSINK | Grainger | 6HY87 |  |  |  | 132 | 8 | 140 | 200 |  |  |  | $0.05 | $0.65 | $0.00
 | 14 | SCREW, M2.5-0.45, 8 MM LONG, SLOTTED CHEESE HEAD, 6 FOR CM BOTTOM COVER MOUNTING BLOCKS 8 FOR SM BOTTOM COVER MOUNTING BLOCKS THESE MUST BE SLOTTED. THE HOLE IS NOT DEEP ENOUGH FOR A PHILLIPS PLUS A LOCKWASHER. | Grainger | 6HY88 |  |  |  | 154 | 9 | 163 | 200 |  |  |  | $0.05 | $0.76 | $0.00
 | 12 | SCREW, M2.5-0.45, 12 MM LONG, SLOTTED CHEESE HEAD, 4 FOR FIREFLY HEATSINK 8 FOR MTP FEEDTRHU TO STANDOFF | Grainger | 6HY90 |  |  |  | 132 | 8 | 140 | 200 |  |  |  | $0.05 | $0.65 | $0.00
 | 29 | SCREW, M2.5-0.45, 4 MM LONG, PHILLIPS FLAT HEAD, 9 FOR CM TOP COVER 6 FOR CM BOTTOM COVER 6 FOR SM TOP COVER 8 FOR SM BOTTOM COVER | Grainger | 38EA08 |  |  |  | 319 | 17 | 336 | 200 |  |  |  | $0.05 | $1.58 | $0.00
 | 8 | LOCK WASHER, M3 8 FOR FPGA HEATSINK | Grainger | 22UK30 |  |  |  | 88 | 6 | 94 | 200 |  |  |  |  | $0.00
 | 35 | LOCK WASHER, M2.5 15 FOR BOTTOM COVER MOUNTING BLOCKS 4 FOR FIREFLY HEATSINK STANDOFFS 4 FOR LGA80D HEATSINK STANDOFFS 4 FOR LGA80D HEATSINK 8 FOR FRONT PANEL FIBER FEEDTHRUS | Grainger | 22UK29 |  |  |  | 385 | 21 | 406 |  |  |  |  |  | $0.00
 | 4 | MTP FEEDTHRU, GANGED 1X6, STRAIGHT | FiberTronics | 12697 | US Conec | 12697 |  | 44 | 4 | 48 | 10 |  | 25 |  | $32.48 | $129.92 | $812.00
 |  |  |  |  |  |  |  |  |  |  |  |  |  |  |  | $0.00
 |  |  |  |  |  |  |  |  |  |  |  |  |  |  |  | $457.17
