mfkiwl/Cornell_CM_Rev2_HW/Docs/Segger_adapter_wiring.pdf

Segger MCU JTAG Adapter
1) Plug the cable for the Segger adapter into the front panel MCU JTAG connector. The polarization pin and the red stripe should be as shown below.

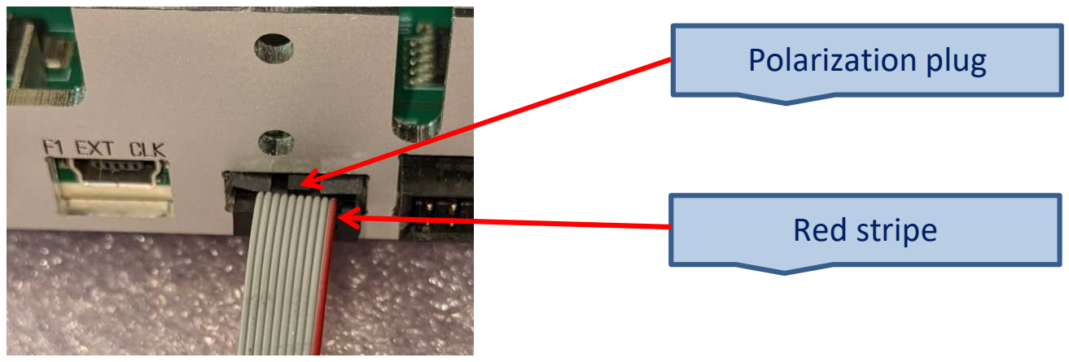
[picture p52: figure]
Polarization plug; Red stripe

2) Connect the other end of the cable to a Segger adapter that is wired according to the following table and the photo as shown below. The names in the “Segger 20-pin header name” column are printed on the left side of the adapter. The numbers in the “Adapter 10-pin cable number” column are printed on the right side of the adapter.
Segger 20-pin header number | Segger 20-pin header name | Adapter 10-pin cable number | Color
1 | VTREF (1) | 10 | Yellow
5 | TDI (5) | 1 | Blue
7 | TMS/SWDIO (7) | 7 | Red
9 | TCK/SWCLK (9) | 5 | Red
13 | TDO/SWO (13) | 3 | Yellow
| GND | 2, 4, 6, 8 | White

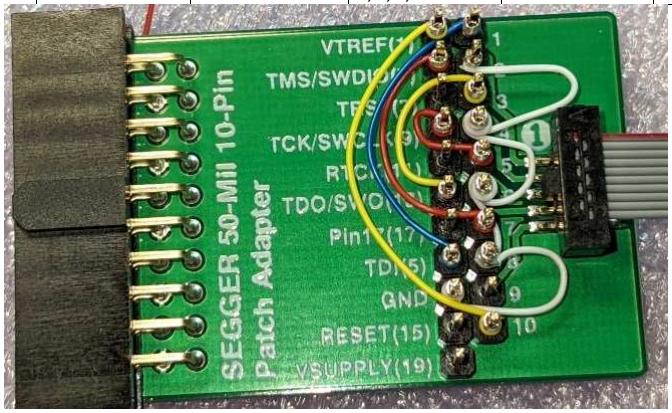
[picture p53: figure]
