mfkiwl/Cornell_CM_Rev2_HW/ClockBuilderPRO/projects/ConfigurationIndex.xlsx

Name | Xtal | In 0 | In 1 | In 2 | FB In | Out 0A | Out 0 | Out 1 | Out 2 | Out 3 | Out 4 | Out 5 | Out 6 | Out 7 | Out 8 | Out 9 | Out 9A
R0Av0001 |  | 322.265625 |  |  | 322.265625 |  |  |  | 322.265625 | 322.265625 |  |  |  |  |  | 322.265625
R0Av0002 |  | 322.265625 |  |  | 322.265625 |  |  | 322.265625 | 322.265625 | 322.265625 | 322.265625
R0Av0003 |  | 322.265625 |  |  | 322.265625 |  |  |  |  |  |  |  |  |  | 40
R0Av0004 |  | 322.265625 |  |  | 322.265625 |  | 322.265625 | 322.265625 | 322.265625 | 322.265625 | 322.265625 | 322.265625 | 322.265625 | 322.265625 | 322.265625 | 322.265625
R0Av0005 |  | 322.265625 |  |  |  |  | 200 | 200 | 243 | 265 | 312 | 312 | 243 | 265 | 300
R0Av0006 |  | 322.265625 |  |  |  |  | 320 | 320 | 320 | 320 | 320 | 320 | 320 | 320 | 320 | 320
R0Bv0001 | 48 |  |  |  |  |  | 322.265625 | 322.265625 | 322.265625 | 322.265625 | 322.265625 | 322.265625 | 322.265625 | 322.265625 | 322.265625 |  | 322.265625
R0Bv0002 |  |  |  | 40 |  |  | 320 | 320 | 320 | 320 | 320 | 320 | 320 | 320 | 320
R0Bv0003 |  | 40 |  |  | 40 |  | 320 | 320 | 320 | 320 | 320 | 320 | 320 | 320 | 320 |  | 40
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
