mfkiwl/Cornell_CM_Rev2_HW/ClockBuilderPRO/projects/R1Bv0005_outputs.jpg

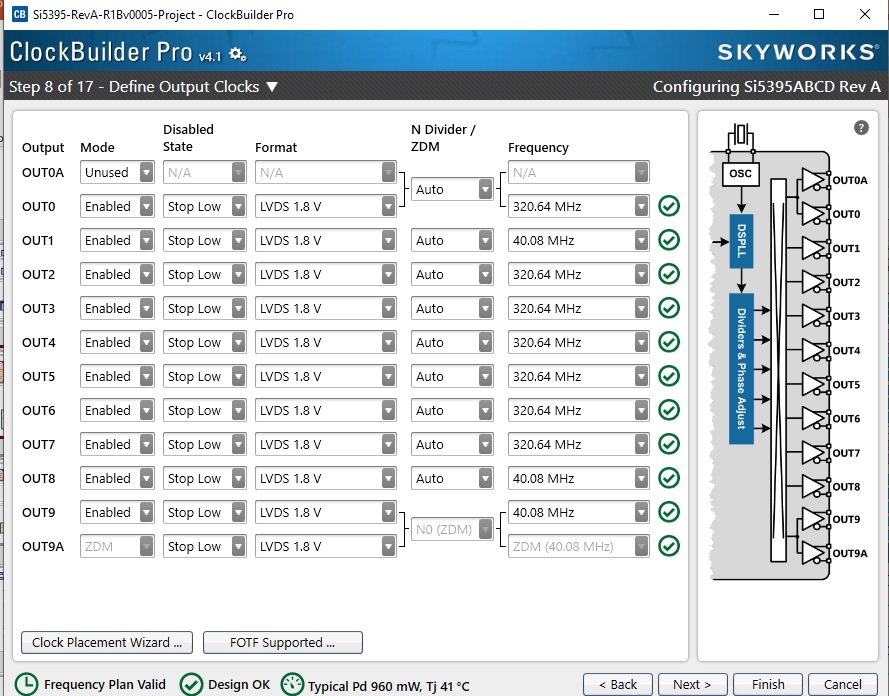
ClockBuilderPRO/projects/R1Bv0005_outputs.jpg
