mfkiwl/Cornell_CM_Rev2_HW/PCB_Rev2B/Schematic_6089-119-revb_13Feb2023.pdf

D | D
C | C
B | B
A | A

# THIS IS A FLAT SCHEMATIC, NOT A HIERARCHICAL ONE. NETS USE "OFFPAGE CONNECTOR" SYMBOLS TO GO FROM PAGE TO PAGE. ON ANY PAGE, THE NUMBER OF THE CONNECTING PAGE(S) IS SHOWN IN A SMALL NUMBER

BELOW THE SIGNAL NAME.

THE SCHEMATIC IS DIVIDED INTO SECTIONS OF RELATED FUNCTIONALITY.

THE SECTIONS ARE: 1: NOTES AND BLOCK DIAGRAMS 2: OFF-BOARD SIGNALS (SM AND FRONT PANEL), GLOBAL CLOCKING 3: POWER SOURCES AND CONTROLS 4: I2C CONTROLS 5: FPGA#1 POWER AND SIGNAL (NON-MGT) 6: FPGA#2 POWER AND SIGNAL (NON-MGT) 7: FPGA#1 GTY TRANSCEIVERS (MOSTLY FIREFLY) 8: FPGA#2 GTY TRANSCEIVERS (MOSTLY FIREFLY) 9: BETWEEN-FPGA GTY TRANSCEIVERS

# TO DO:

# These are some general signal naming conventions:

1) Signals connected to the FPGAs contain either "F1" or "F2".
2) Signals connected to the Service Module contain "SM".
3) Signals connected to the Front Panel contain "FP".

# 4) Signal names starting with “PG” are “Power Good” signals from power

modules.

# 5) Signal names starting with “EN” are “Enable” signals to turn on power

modules.

6) GTY reference clock names indicate FPGA followed by side (F1L, F1R,

# F2L, F2R), then the reference clock (R0 or R1), finishing with the sequence

order (1 thru 7).

# 7) Power source names start with "V_", then the voltage with the letter "V" as a decimal point. (V_3V3 is a 3.3 volt source)

# 8) The MCU I/Os are 3.3 volt and the FPGA I/Os are 1.8 volt. Level shifters are used for the conversion. Signal names on the FPGA side are prefaced with "lov" (low voltage) and signals on the MCU side are prefaced with "hiv"

(high voltage).

Title

Size | Document Number | Rev
Date: | Sheet | of
| 6089-119 | B

# 1.01: NOTES

Tuesday, January 25, 2022 | 1 | 84

# APOLLO CM W/ DUAL A2577, MK1

# 1.01: NOTES

Tuesday, January 25, 2022 | 1 | 84

# 1.01: NOTES

Tuesday, January 25, 2022 | 1 | 84

# 1.02: BLOCK DIAGRAM

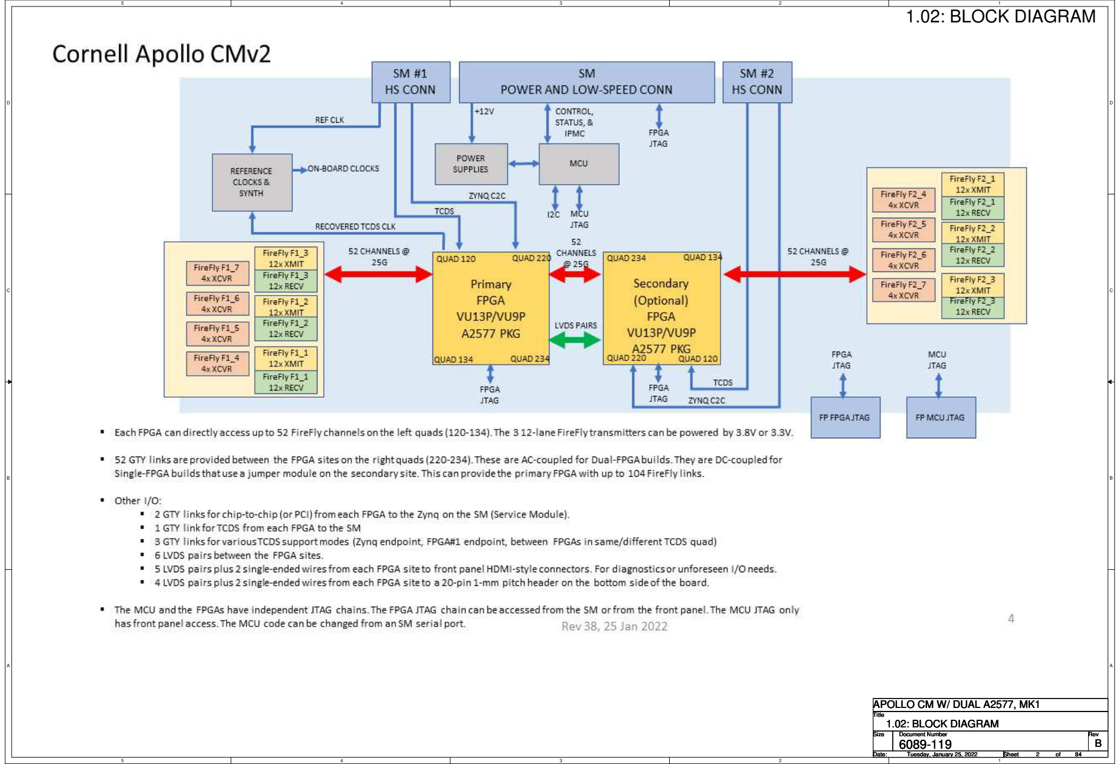
[picture p55: page 2]
1.02: BLOCK DIAGRAM; Tuesday, January 25, 2022

# 1.03: DUAL VU13P

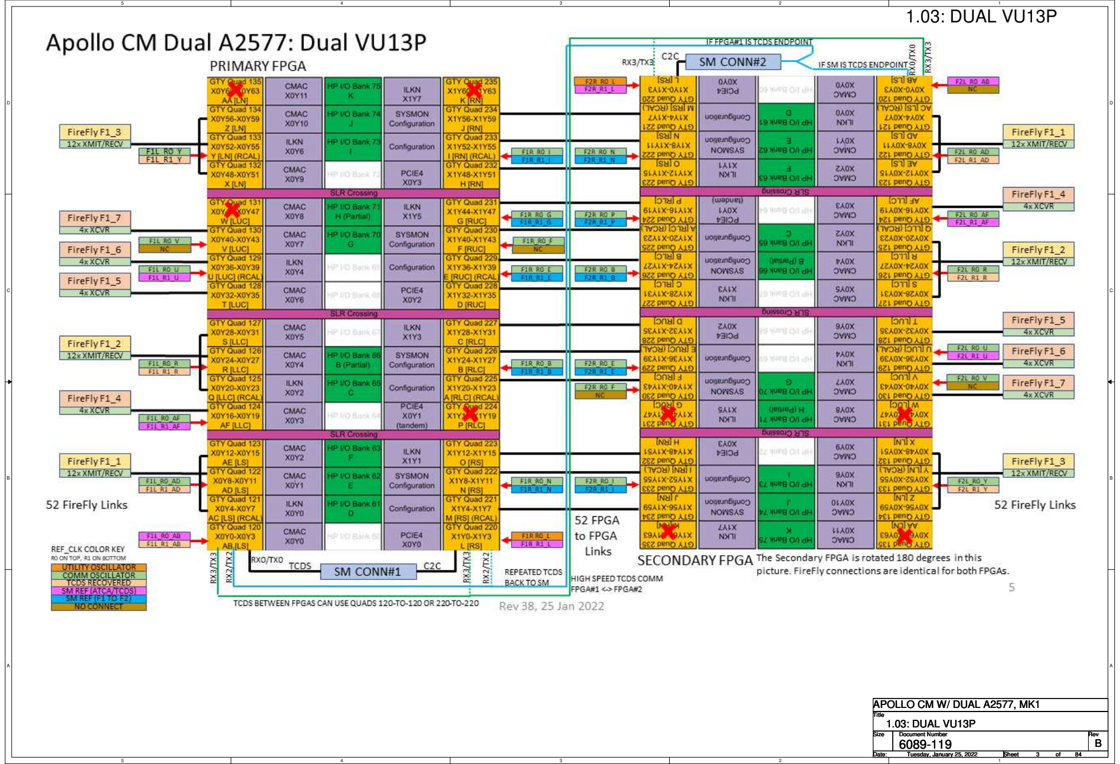
[picture p56: page 3]
1.03: DUAL VU13P; Tuesday, January 25, 2022

# 1.04: SINGLE VU13P AND JUMPER

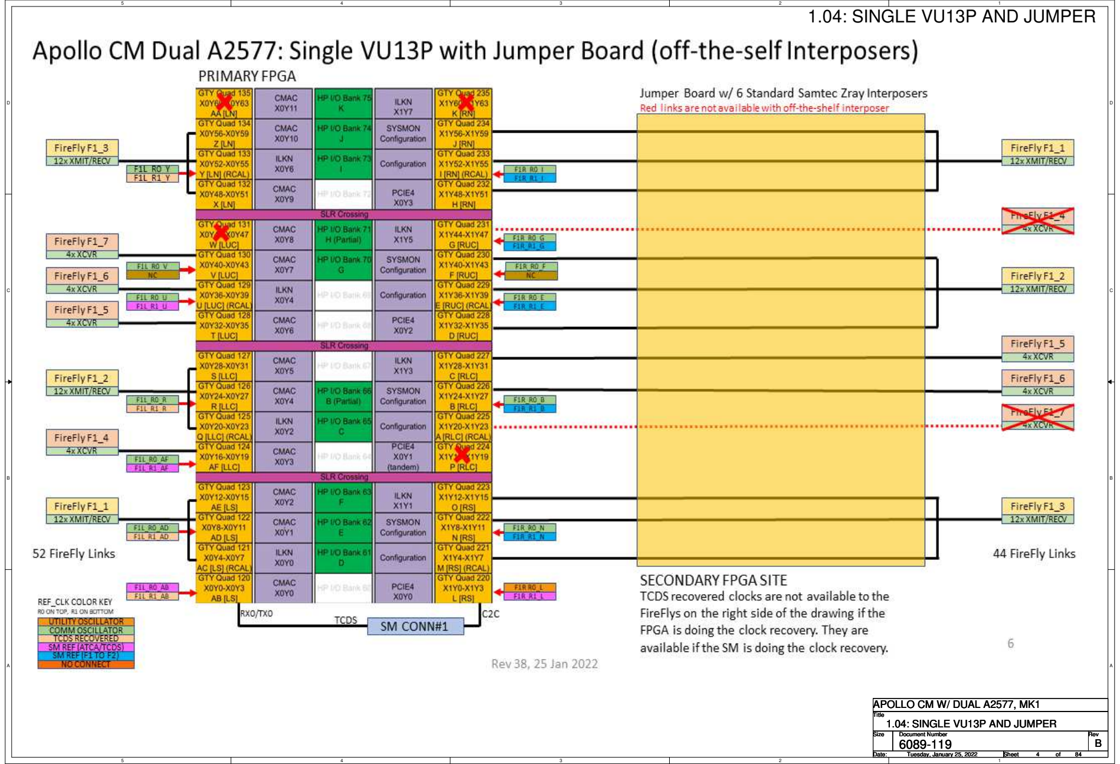
[picture p57: page 4]
Tuesday, January 25, 2022

1.04: SINGLE VU13P AND JUMPER

# 1.05: SINGLE VU13P

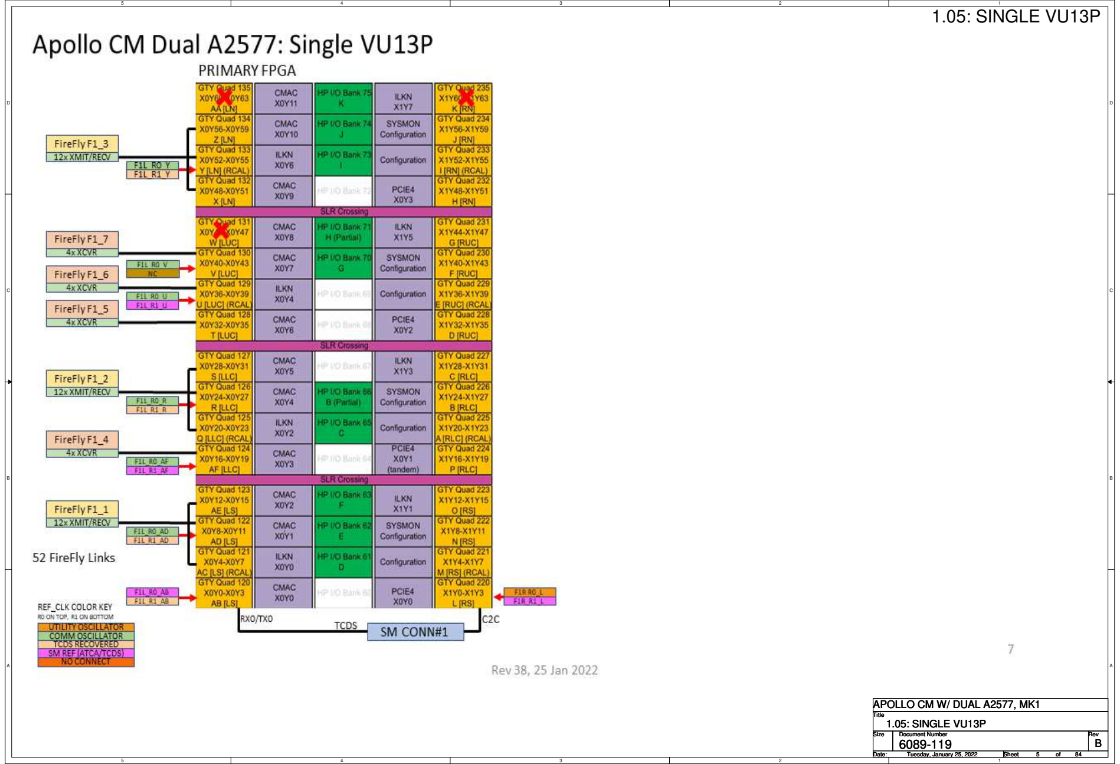
[picture p58: page 5]
1.05: SINGLE VU13P; Tuesday, January 25, 2022

# 1.06: DUAL VU9P

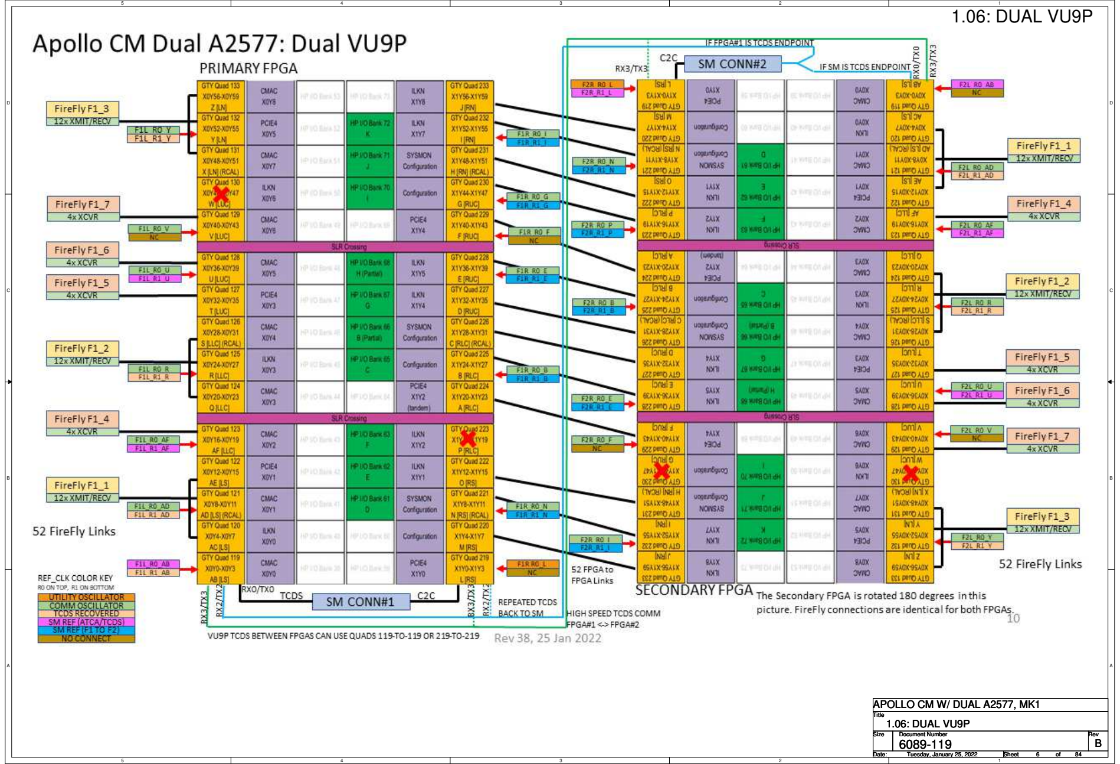
[picture p59: page 6]
1.06: DUAL VU9P; Tuesday, January 25, 2022

# 1.07: SIX 10X20 INTERPOSERS

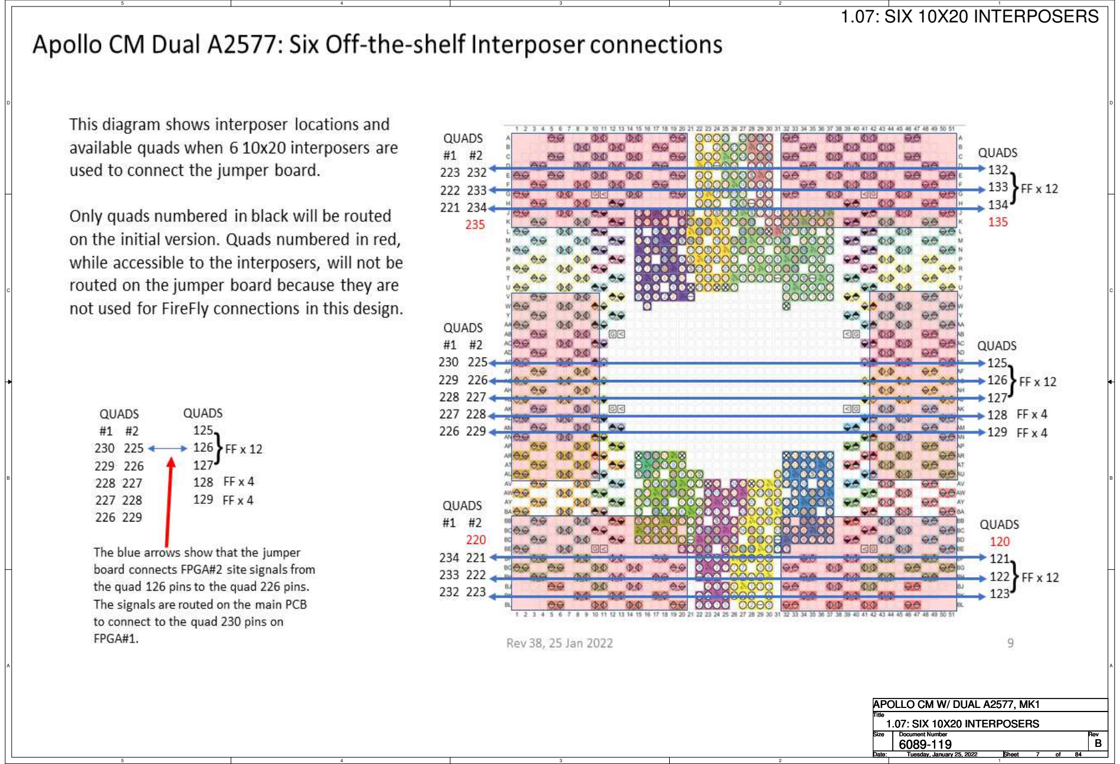
[picture p60: page 7]
1.07: SIX 10X20 INTERPOSERS; Tuesday, January 25, 2022

# 1.08: POWER

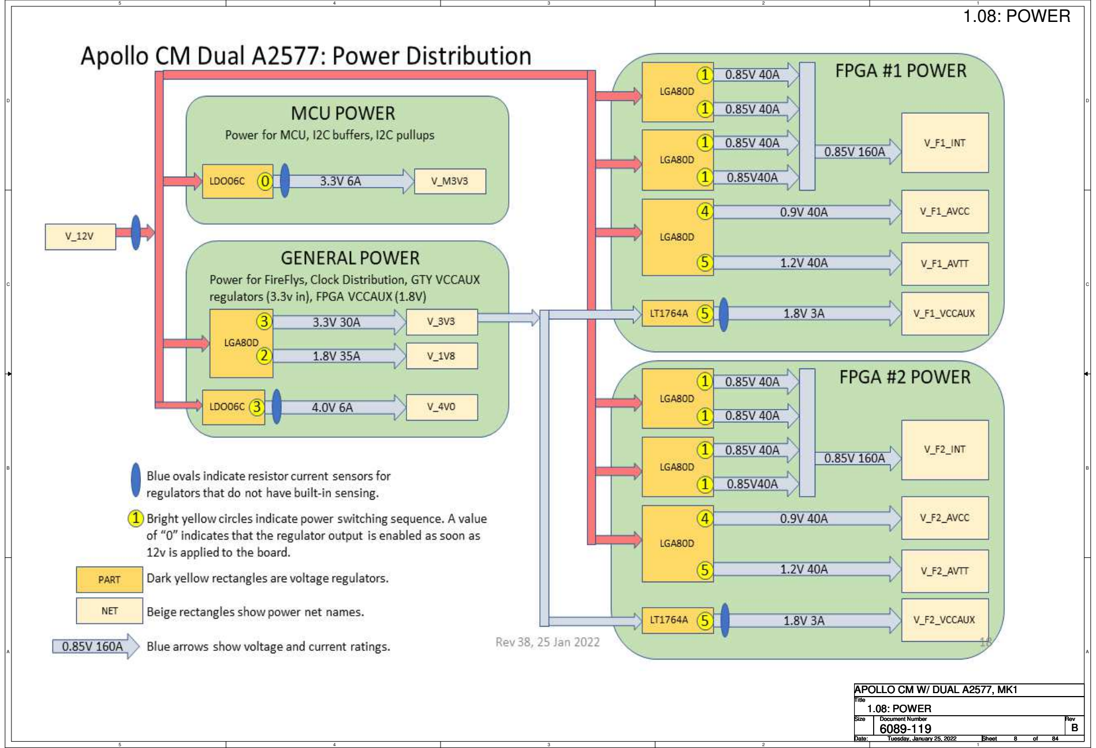
[picture p61: page 8]
1.08: POWER; Tuesday, January 25, 2022

# 1.09: ON-BOARD OSCILLATOR CLOCKS

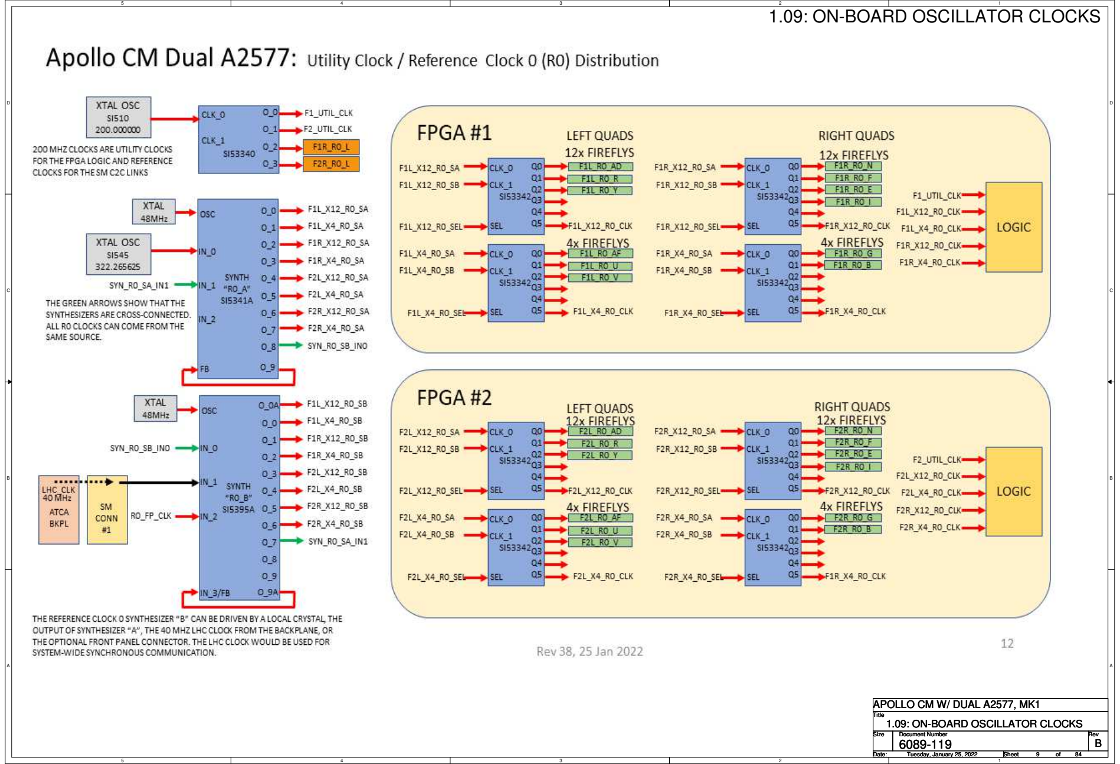
[picture p62: page 9]
Tuesday, January 25, 2022

1.09: ON-BOARD OSCILLATOR CLOCKS

# 1.10: EXTERNAL CLOCKS

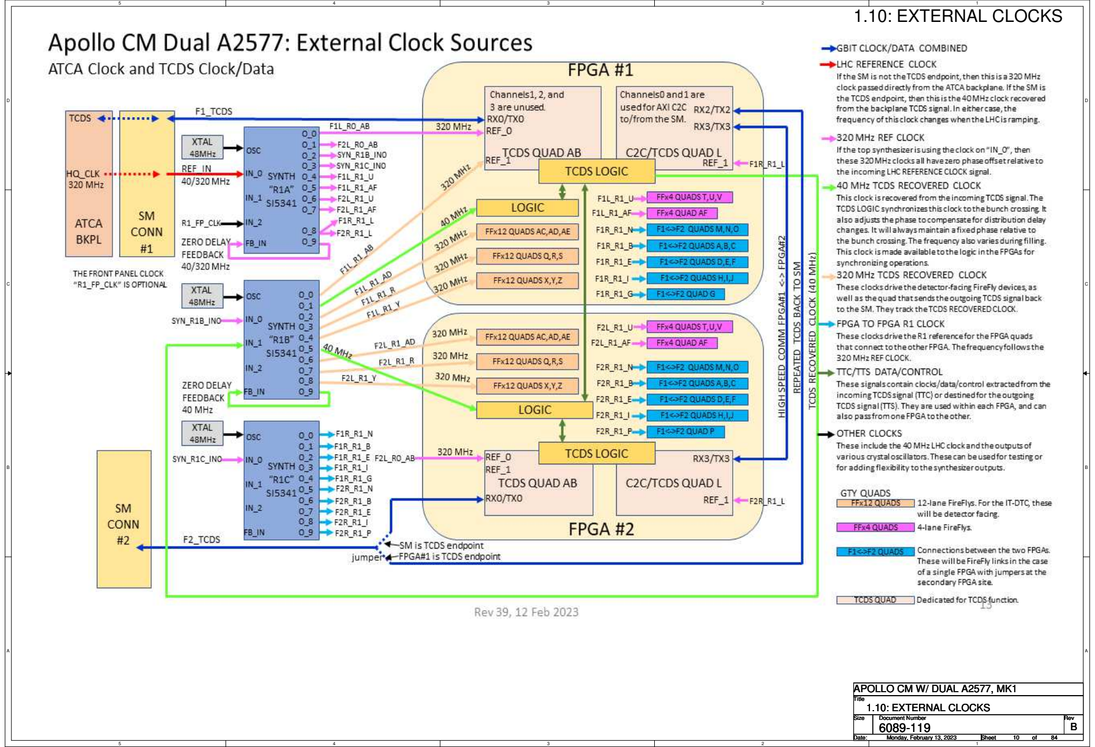
[picture p63: page 10]
1.10: EXTERNAL CLOCKS; Monday, February 13, 2023

# 1.11: TCDS SIMPLIFIED

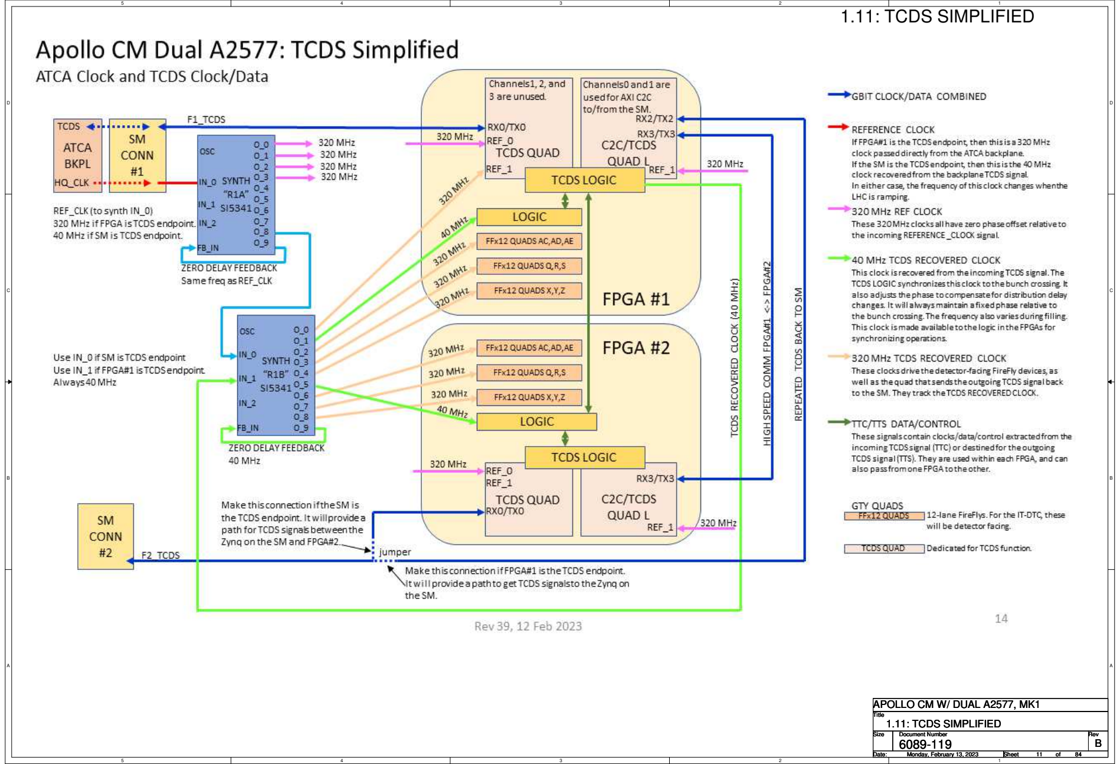
[picture p64: page 11]
1.11: TCDS SIMPLIFIED; Monday, February 13, 2023

# 1.12: MCU I/O AND INTERNALS

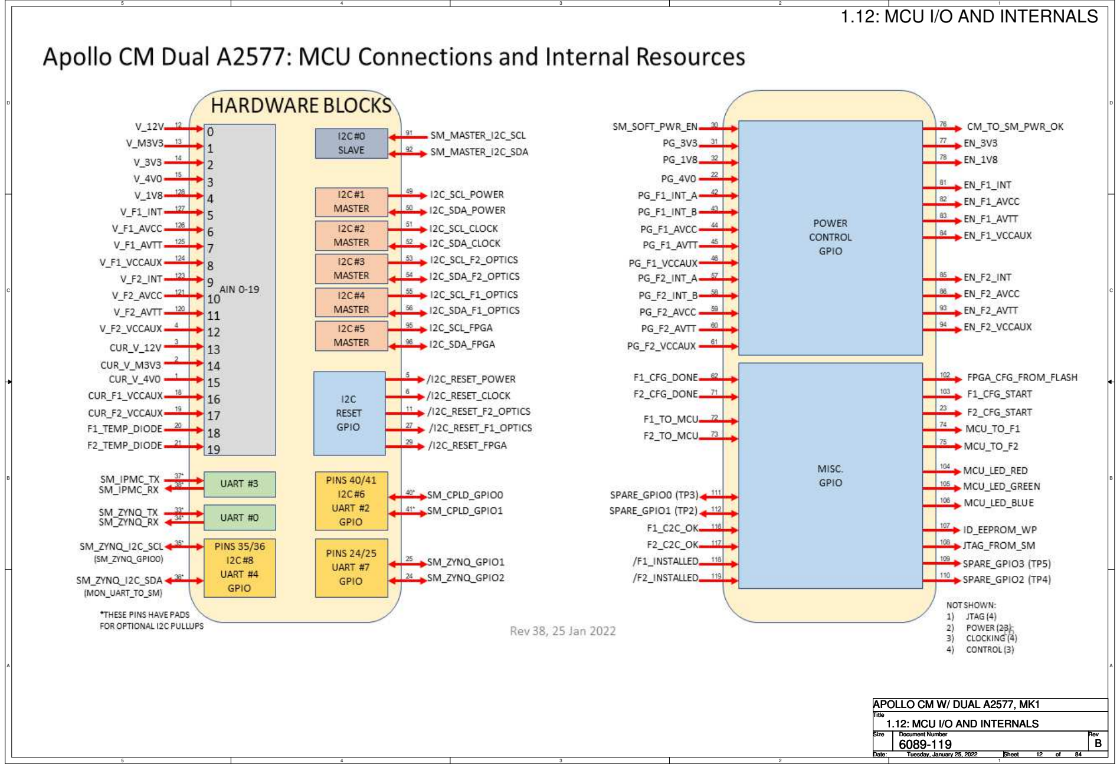
[picture p65: page 12]
Tuesday, January 25, 2022

1.12: MCU I/O AND INTERNALS

# 2.01: SM POWER AND CONTROL CONNECTOR

## V_12V

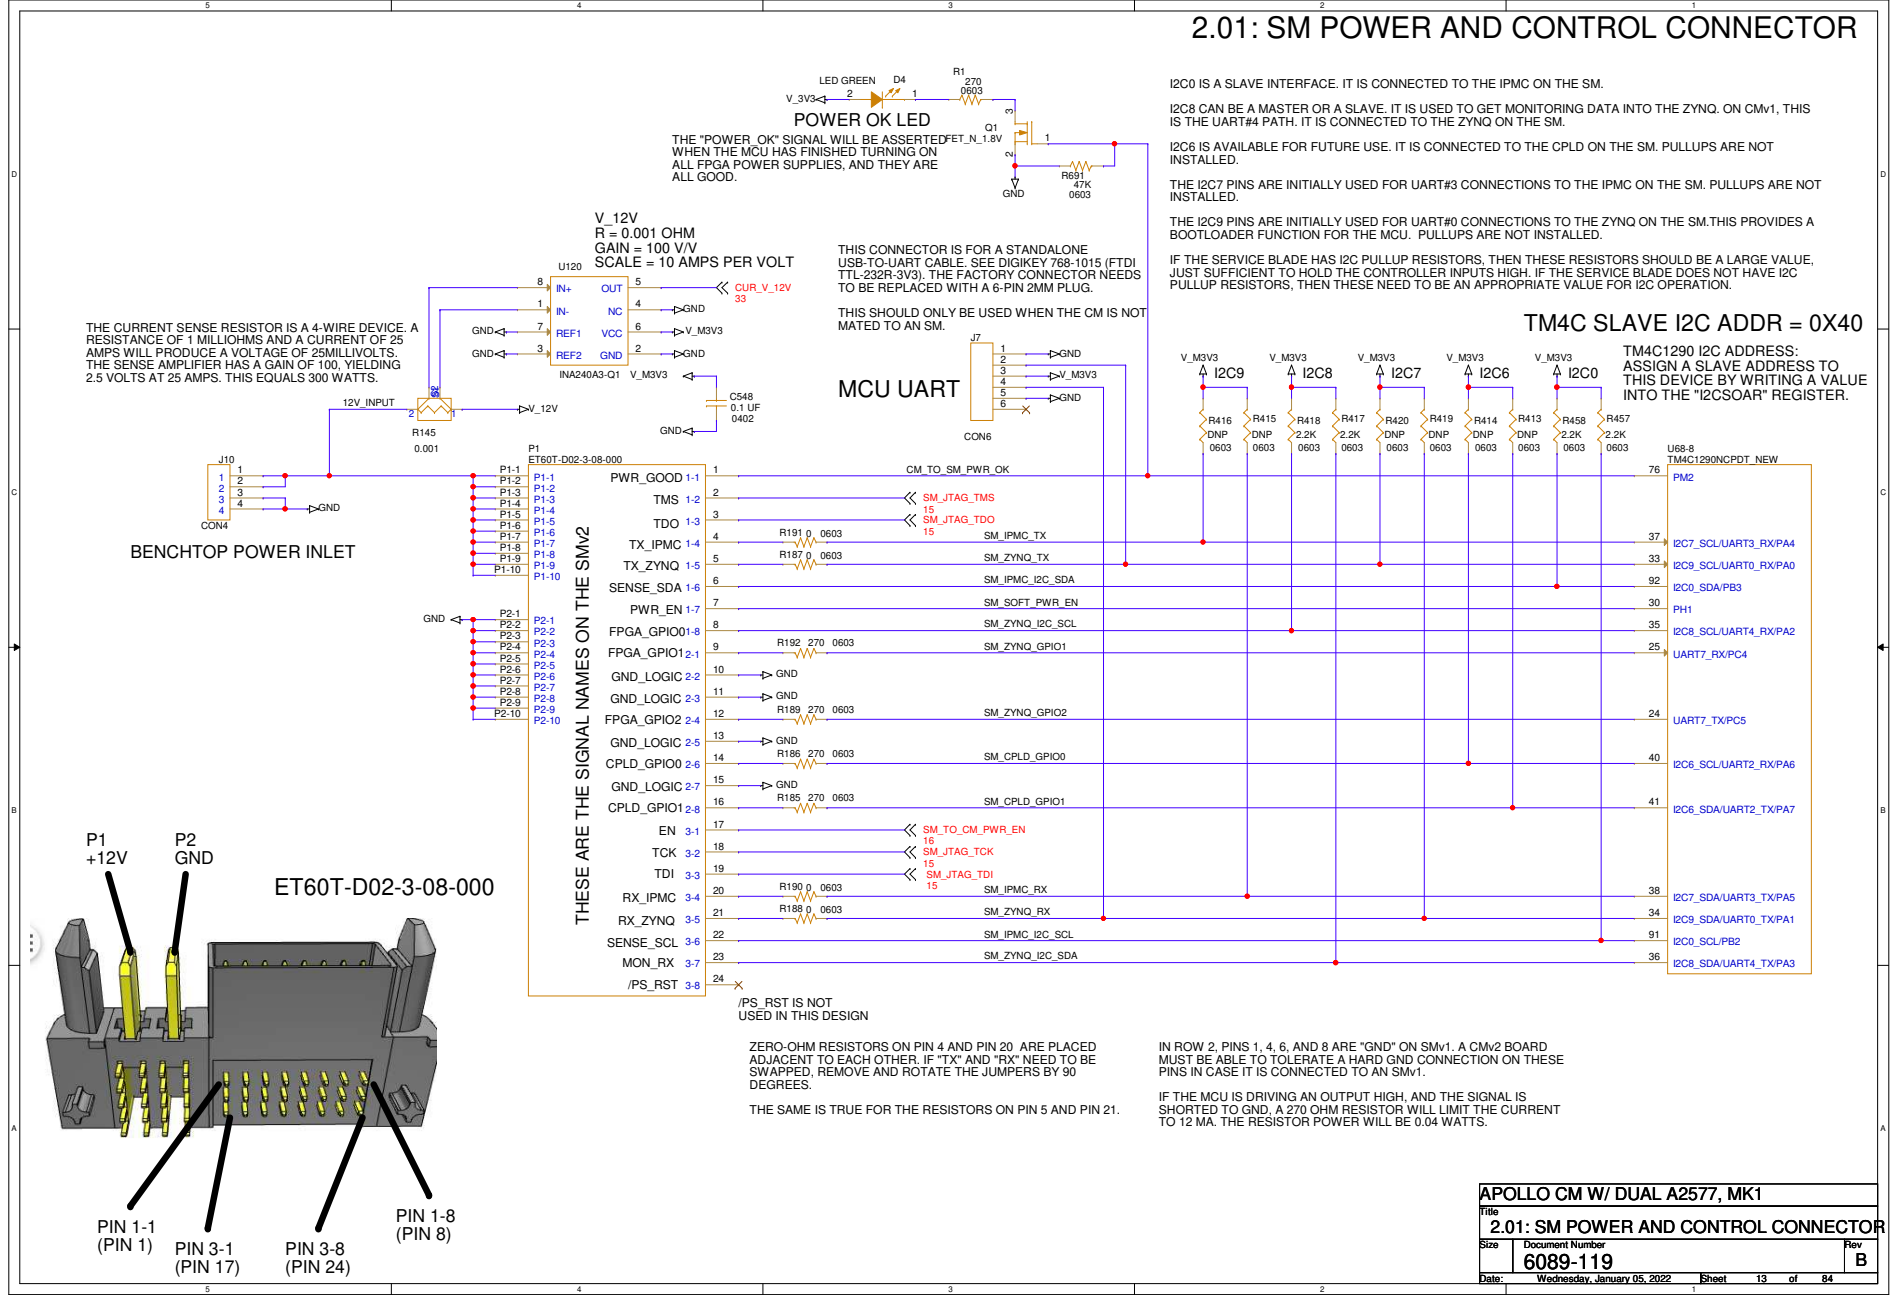
[picture p66: page 13]

I2C0 IS A SLAVE INTERFACE. IT IS CONNECTED TO THE IPMC ON THE SM.

I2C8 CAN BE A MASTER OR A SLAVE. IT IS USED TO GET MONITORING DATA INTO THE ZYNQ. ON CMv1, THIS
IS THE UART#4 PATH. IT IS CONNECTED TO THE ZYNQ ON THE SM.

THE "POWER_OK" SIGNAL WILL BE ASSERTED
WHEN THE MCU HAS FINISHED TURNING ON
ALL FPGA POWER SUPPLIES, AND THEY ARE
ALL GOOD.

I2C6 IS AVAILABLE FOR FUTURE USE. IT IS CONNECTED TO THE CPLD ON THE SM. PULLUPS ARE NOT
INSTALLED.

THE I2C7 PINS ARE INITIALLY USED FOR UART#3 CONNECTIONS TO THE IPMC ON THE SM. PULLUPS ARE NOT

R = 0.001 OHM
GAIN = 100 V/V
SCALE = 10 AMPS PER VOLT

THE I2C9 PINS ARE INITIALLY USED FOR UART#0 CONNECTIONS TO THE ZYNQ ON THE SM.THIS PROVIDES A
BOOTLOADER FUNCTION FOR THE MCU. PULLUPS ARE NOT INSTALLED.

THIS CONNECTOR IS FOR A STANDALONE
USB-TO-UART CABLE. SEE DIGIKEY 768-1015 (FTDI
TTL-232R-3V3). THE FACTORY CONNECTOR NEEDS
TO BE REPLACED WITH A 6-PIN 2MM PLUG.

IF THE SERVICE BLADE HAS I2C PULLUP RESISTORS, THEN THESE RESISTORS SHOULD BE A LARGE VALUE,
JUST SUFFICIENT TO HOLD THE CONTROLLER INPUTS HIGH. IF THE SERVICE BLADE DOES NOT HAVE I2C
PULLUP RESISTORS, THEN THESE NEED TO BE AN APPROPRIATE VALUE FOR I2C OPERATION.

THIS SHOULD ONLY BE USED WHEN THE CM IS NOT
MATED TO AN SM.

THE CURRENT SENSE RESISTOR IS A 4-WIRE DEVICE. A
RESISTANCE OF 1 MILLIOHMS AND A CURRENT OF 25
AMPS WILL PRODUCE A VOLTAGE OF 25MILLIVOLTS.
THE SENSE AMPLIFIER HAS A GAIN OF 100, YIELDING
2.5 VOLTS AT 25 AMPS. THIS EQUALS 300 WATTS.

TM4C1290 I2C ADDRESS:
ASSIGN A SLAVE ADDRESS TO
THIS DEVICE BY WRITING A VALUE
INTO THE "I2CSOAR" REGISTER.

THESE ARE THE SIGNAL NAMES ON THE SMv2 GND_LOGIC GND_LOGIC GND_LOGIC FPGA_GPIO1 FPGA_GPIO2 CPLD_GPIO1 CPLD_GPIO0 BENCHTOP POWER INLET

/PS_RST IS NOT
USED IN THIS DESIGN

ZERO-OHM RESISTORS ON PIN 4 AND PIN 20 ARE PLACED
ADJACENT TO EACH OTHER. IF "TX" AND "RX" NEED TO BE
SWAPPED, REMOVE AND ROTATE THE JUMPERS BY 90
DEGREES.

IN ROW 2, PINS 1, 4, 6, AND 8 ARE "GND" ON SMv1. A CMv2 BOARD
MUST BE ABLE TO TOLERATE A HARD GND CONNECTION ON THESE
PINS IN CASE IT IS CONNECTED TO AN SMv1.

THE SAME IS TRUE FOR THE RESISTORS ON PIN 5 AND PIN 21.

IF THE MCU IS DRIVING AN OUTPUT HIGH, AND THE SIGNAL IS
SHORTED TO GND, A 270 OHM RESISTOR WILL LIMIT THE CURRENT
TO 12 MA. THE RESISTOR POWER WILL BE 0.04 WATTS.

2.01: SM POWER AND CONTROL CONNECTOR

# FPGA#1 AND BACKPLANE CLOCK SIGNALS

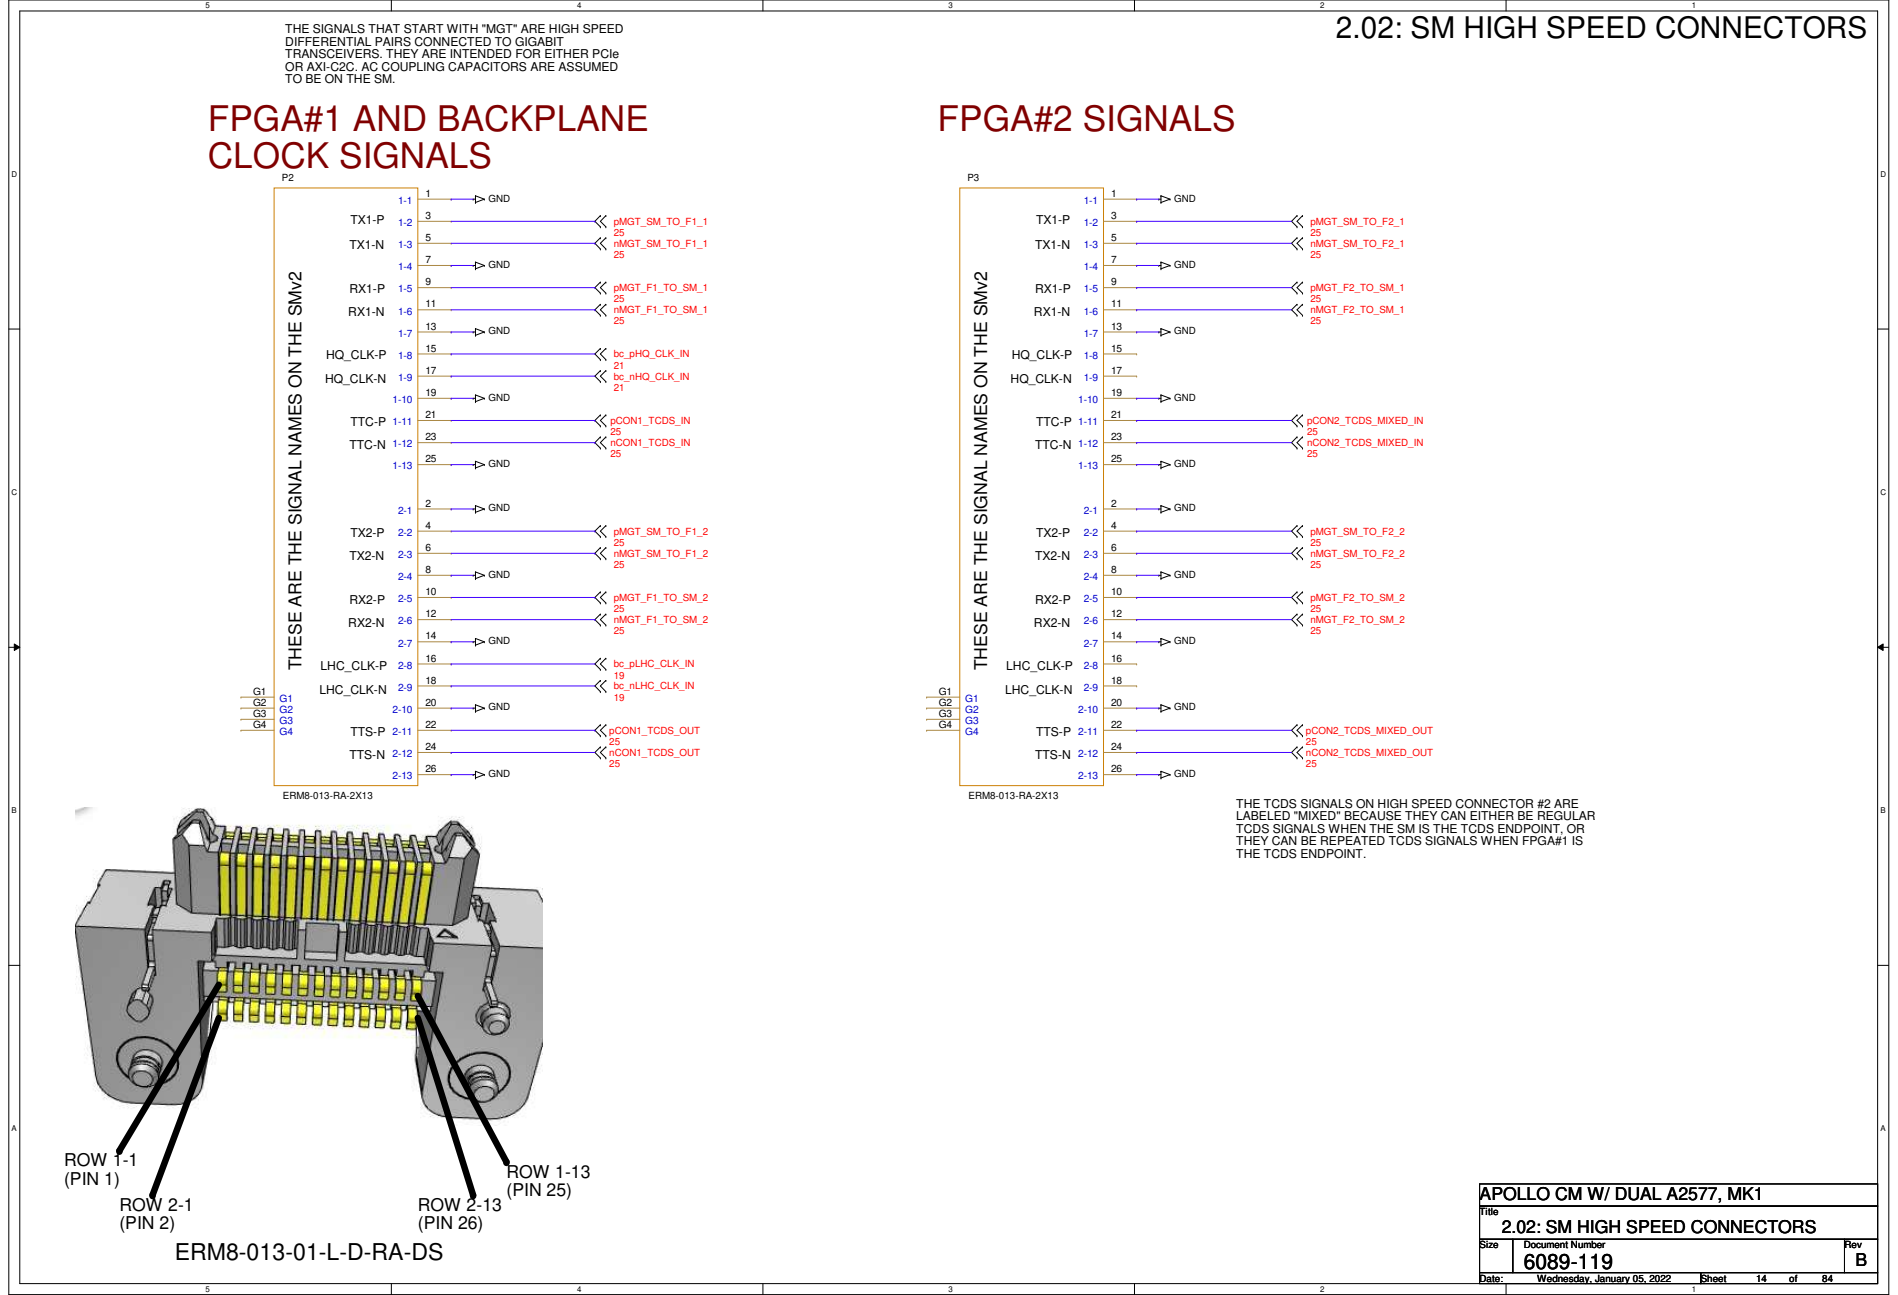
[picture p67: page 14]
ERM8-013-01-L-D-RA-DS; ROW 1-1 (PIN 1); ROW 2-13 (PIN 26); ROW 2-1 (PIN 2); ROW 1-13 (PIN 25); LHC_CLK-P; LHC_CLK-N; HQ_CLK-P; HQ_CLK-N; TTC-P; TTC-N; TTS-P; TTS-N; FPGA#2 SIGNALS; GND; bc_pLHC_CLK_IN 19 bc_nLHC_CLK_IN 19; bc_pHQ_CLK_IN 21 bc_nHQ_CLK_IN 21; pMGT_SM_TO_F1_1 25 nMGT_SM_TO_F1_1 25; pMGT_F1_TO_SM_1 25 nMGT_F1_TO_SM_1 25; pMGT_SM_TO_F1_2 25 nMGT_SM_TO_F1_2 25; pMGT_F1_TO_SM_2 25 nMGT_F1_TO_SM_2 25; pMGT_SM_TO_F2_1 25 nMGT_SM_TO_F2_1 25; pMGT_F2_TO_SM_1 25 nMGT_F2_TO_SM_1 25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

2.02: SM HIGH SPEED CONNECTORS

THE SIGNALS THAT START WITH "MGT" ARE HIGH SPEED
DIFFERENTIAL PAIRS CONNECTED TO GIGABIT
TRANSCEIVERS. THEY ARE INTENDED FOR EITHER PCIe
OR AXI-C2C. AC COUPLING CAPACITORS ARE ASSUMED
TO BE ON THE SM.

THESE ARE THE SIGNAL NAMES ON THE SMv2

THE TCDS SIGNALS ON HIGH SPEED CONNECTOR #2 ARE
LABELED "MIXED" BECAUSE THEY CAN EITHER BE REGULAR
TCDS SIGNALS WHEN THE SM IS THE TCDS ENDPOINT, OR
THEY CAN BE REPEATED TCDS SIGNALS WHEN FPGA#1 IS
THE TCDS ENDPOINT.

# FPGA#2 JTAG

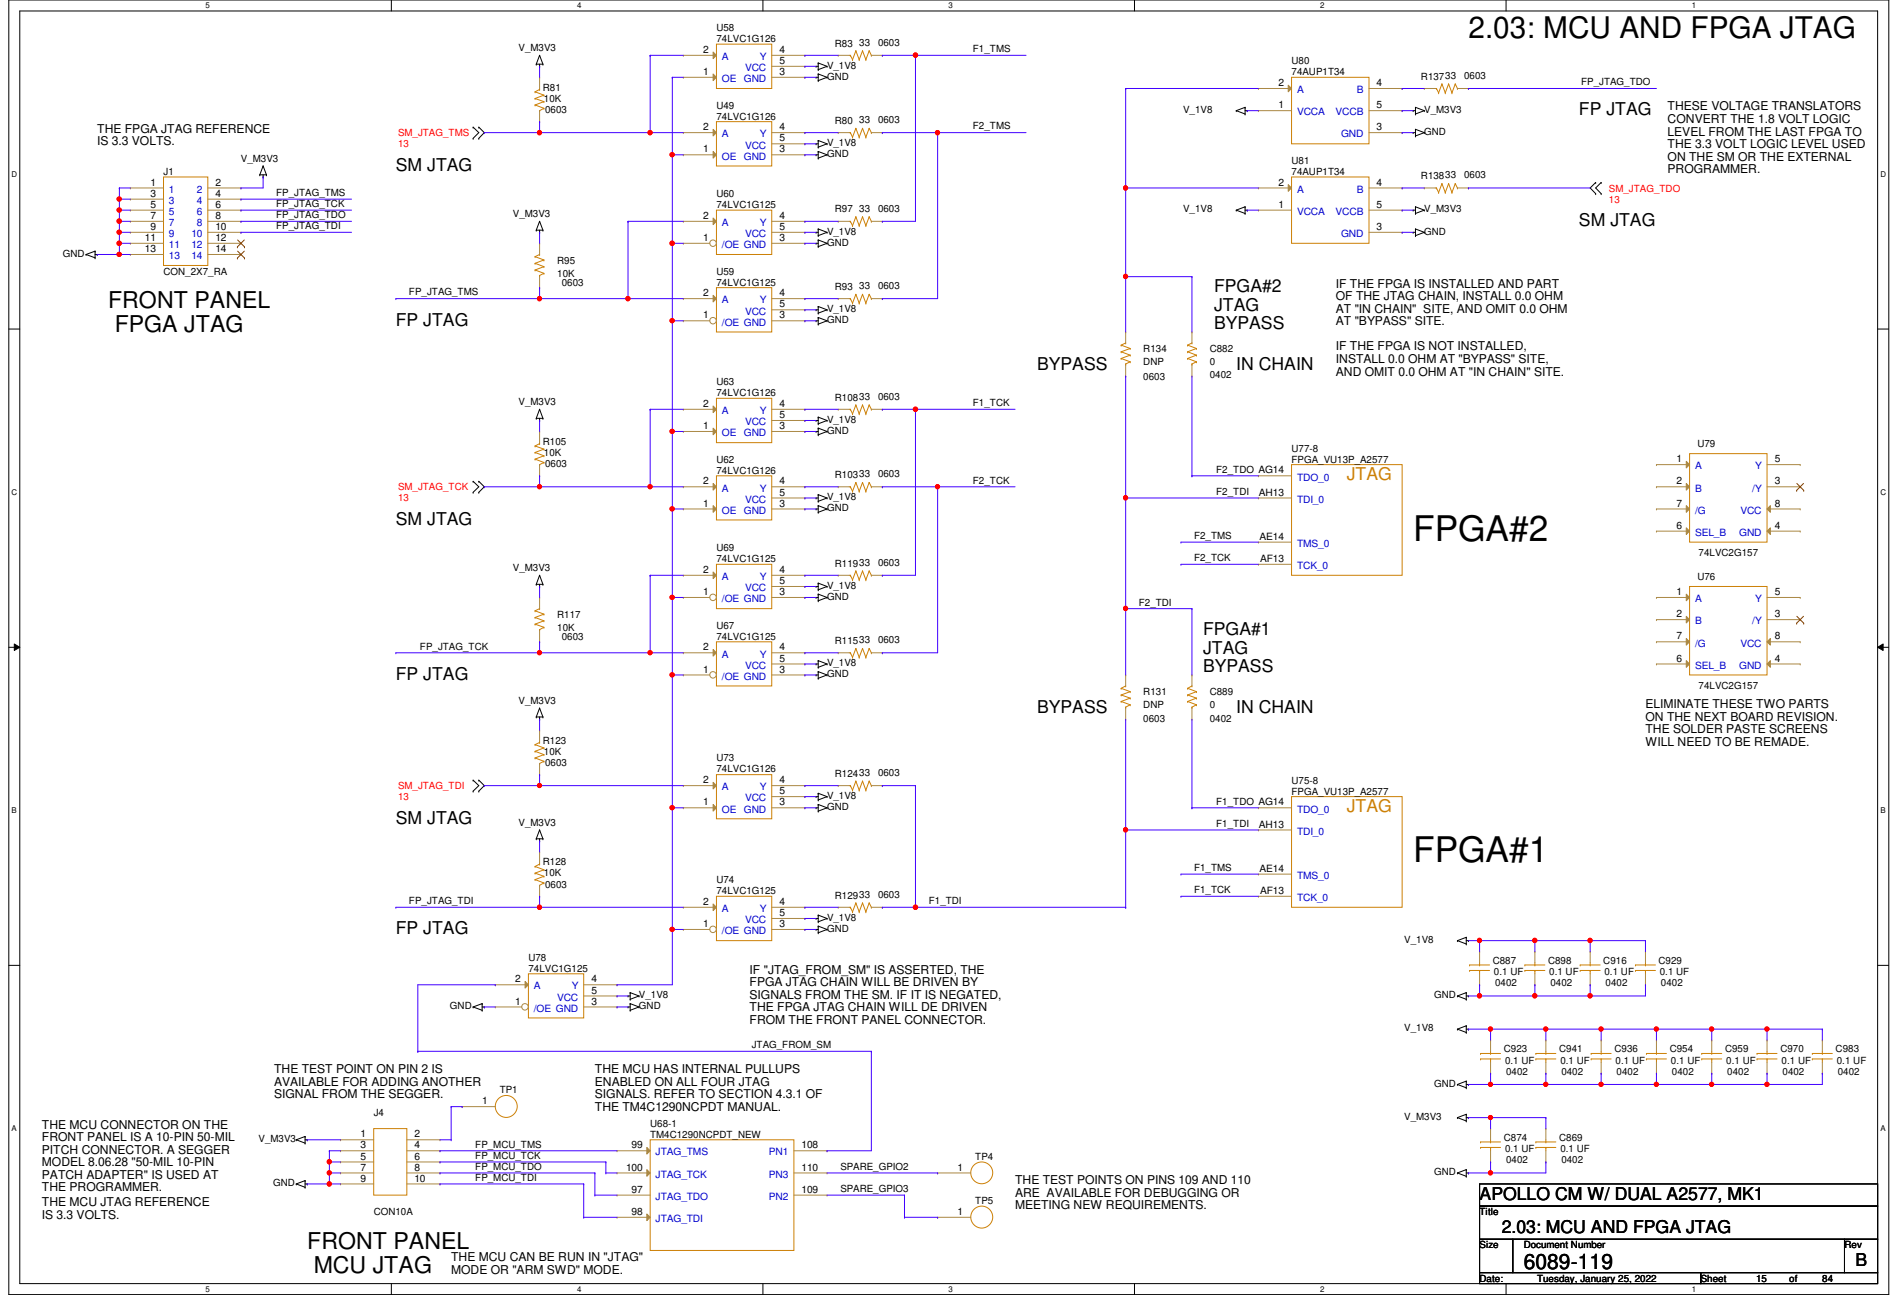
[picture p68: page 15]

2.03: MCU AND FPGA JTAG

THESE VOLTAGE TRANSLATORS
CONVERT THE 1.8 VOLT LOGIC
LEVEL FROM THE LAST FPGA TO
THE 3.3 VOLT LOGIC LEVEL USED
ON THE SM OR THE EXTERNAL
PROGRAMMER.

THE FPGA JTAG REFERENCE
IS 3.3 VOLTS.

IF THE FPGA IS INSTALLED AND PART
OF THE JTAG CHAIN, INSTALL 0.0 OHM
AT "IN CHAIN" SITE, AND OMIT 0.0 OHM
AT "BYPASS" SITE.

IF THE FPGA IS NOT INSTALLED,
INSTALL 0.0 OHM AT "BYPASS" SITE,

AND OMIT 0.0 OHM AT "IN CHAIN" SITE. BYPASS

ELIMINATE THESE TWO PARTS
ON THE NEXT BOARD REVISION.
THE SOLDER PASTE SCREENS
WILL NEED TO BE REMADE.

IF "JTAG_FROM_SM" IS ASSERTED, THE
FPGA JTAG CHAIN WILL BE DRIVEN BY
SIGNALS FROM THE SM. IF IT IS NEGATED,
THE FPGA JTAG CHAIN WILL DE DRIVEN
FROM THE FRONT PANEL CONNECTOR.

THE TEST POINT ON PIN 2 IS
AVAILABLE FOR ADDING ANOTHER
SIGNAL FROM THE SEGGER.

THE MCU HAS INTERNAL PULLUPS
ENABLED ON ALL FOUR JTAG
SIGNALS. REFER TO SECTION 4.3.1 OF
THE TM4C1290NCPDT MANUAL.

THE MCU CONNECTOR ON THE
FRONT PANEL IS A 10-PIN 50-MIL
PITCH CONNECTOR. A SEGGER
MODEL 8.06.28 "50-MIL 10-PIN
PATCH ADAPTER" IS USED AT
THE PROGRAMMER.
THE MCU JTAG REFERENCE

THE TEST POINTS ON PINS 109 AND 110
ARE AVAILABLE FOR DEBUGGING OR
MEETING NEW REQUIREMENTS.

THE MCU CAN BE RUN IN "JTAG"
MODE OR "ARM SWD" MODE.

# 2.04: MCU I/O AND POWER

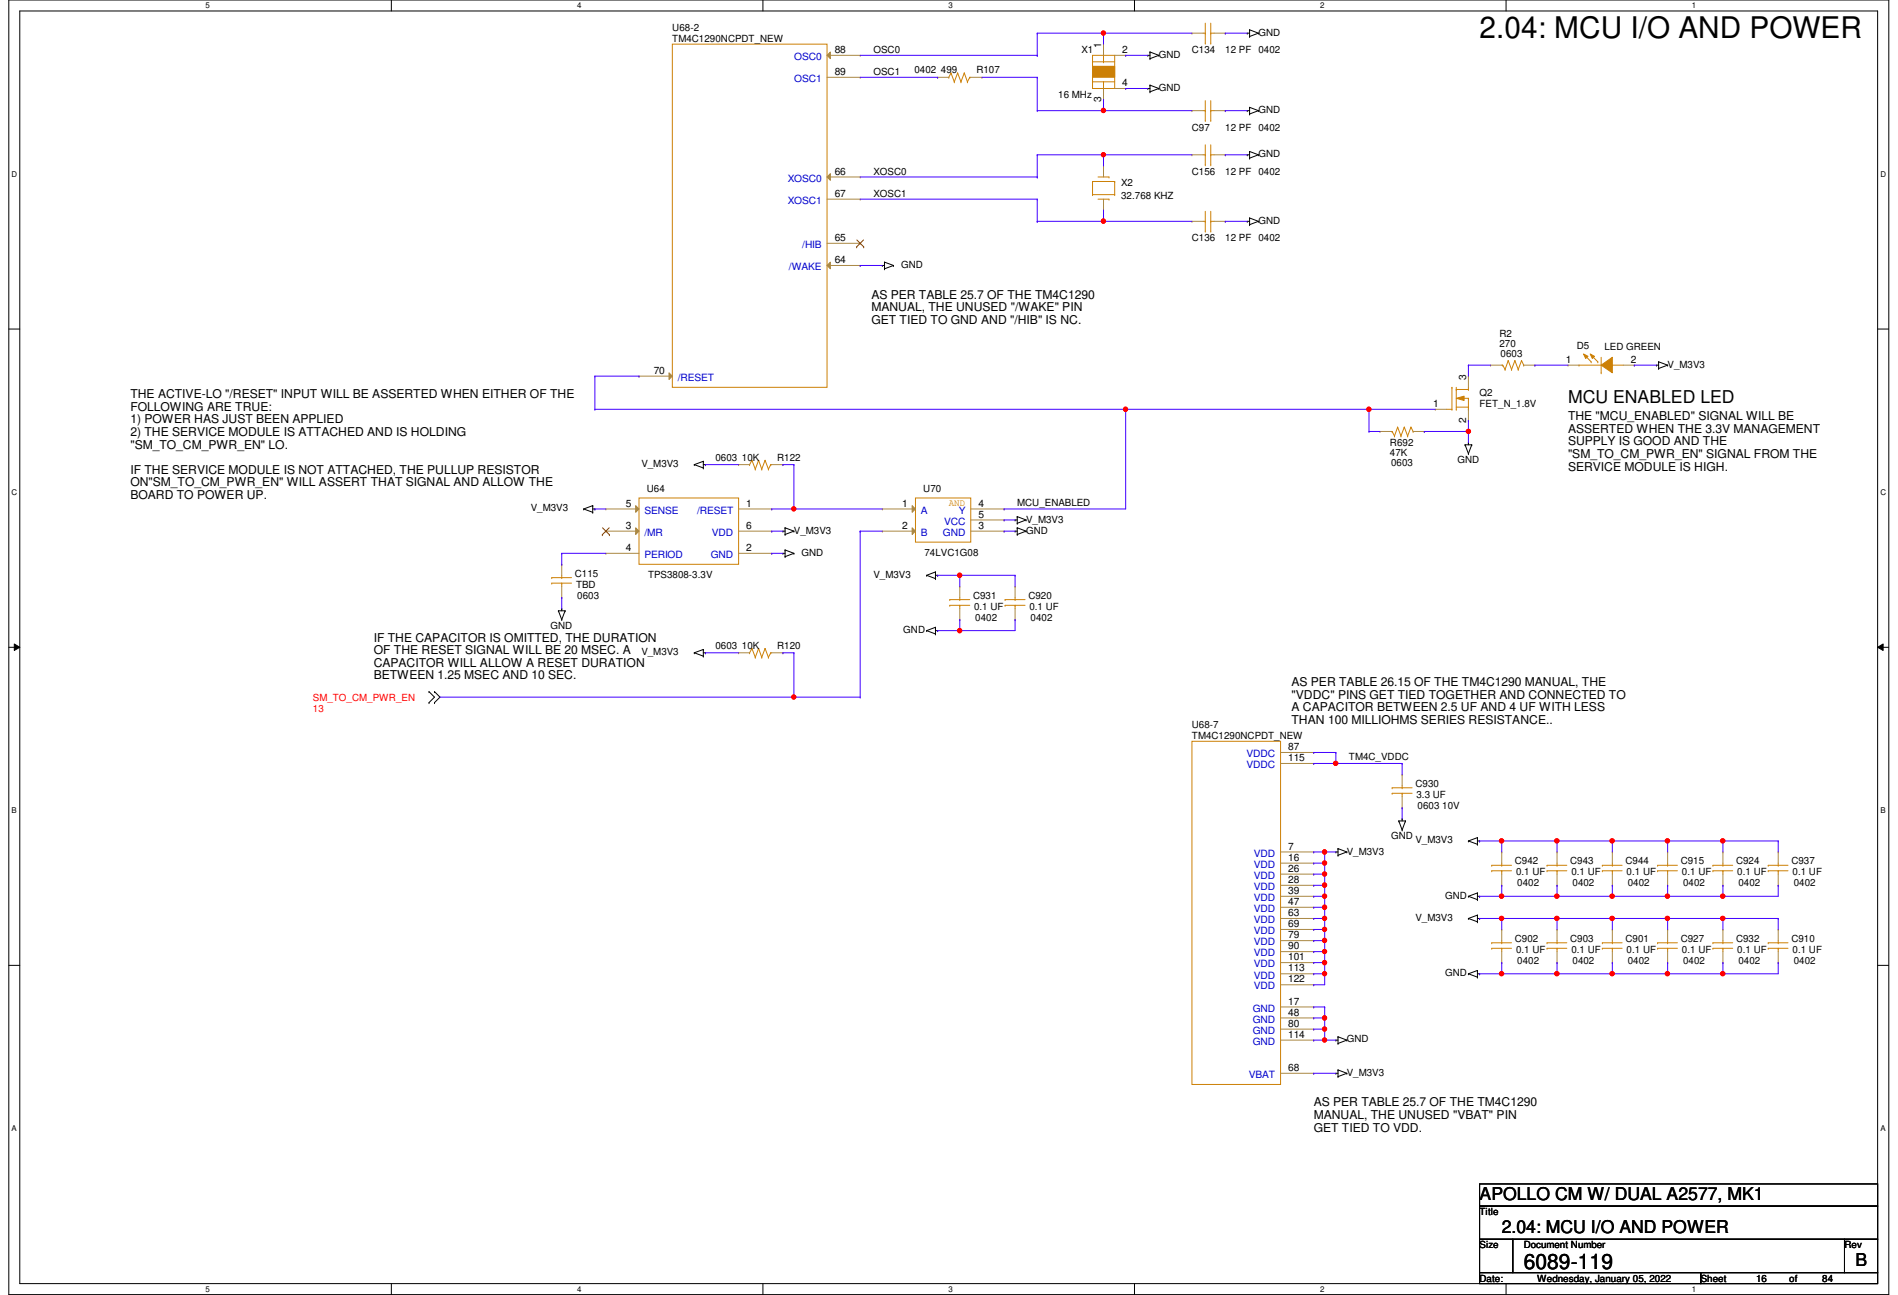
[picture p69: page 16]

AS PER TABLE 25.7 OF THE TM4C1290
MANUAL, THE UNUSED "/WAKE" PIN
GET TIED TO GND AND "/HIB" IS NC.

THE ACTIVE-LO "/RESET" INPUT WILL BE ASSERTED WHEN EITHER OF THE
FOLLOWING ARE TRUE:
1) POWER HAS JUST BEEN APPLIED
2) THE SERVICE MODULE IS ATTACHED AND IS HOLDING
"SM_TO_CM_PWR_EN" LO.

MCU ENABLED LED
THE "MCU_ENABLED" SIGNAL WILL BE
ASSERTED WHEN THE 3.3V MANAGEMENT
SUPPLY IS GOOD AND THE
"SM_TO_CM_PWR_EN" SIGNAL FROM THE
SERVICE MODULE IS HIGH.

IF THE SERVICE MODULE IS NOT ATTACHED, THE PULLUP RESISTOR
ON"SM_TO_CM_PWR_EN" WILL ASSERT THAT SIGNAL AND ALLOW THE
BOARD TO POWER UP.

IF THE CAPACITOR IS OMITTED, THE DURATION
OF THE RESET SIGNAL WILL BE 20 MSEC. A
CAPACITOR WILL ALLOW A RESET DURATION
BETWEEN 1.25 MSEC AND 10 SEC.

AS PER TABLE 26.15 OF THE TM4C1290 MANUAL, THE
"VDDC" PINS GET TIED TOGETHER AND CONNECTED TO
A CAPACITOR BETWEEN 2.5 UF AND 4 UF WITH LESS
THAN 100 MILLIOHMS SERIES RESISTANCE..

MANUAL, THE UNUSED "VBAT" PIN
GET TIED TO VDD.

# 2.05: UTILITY CLOCK

# F2 LOGIC

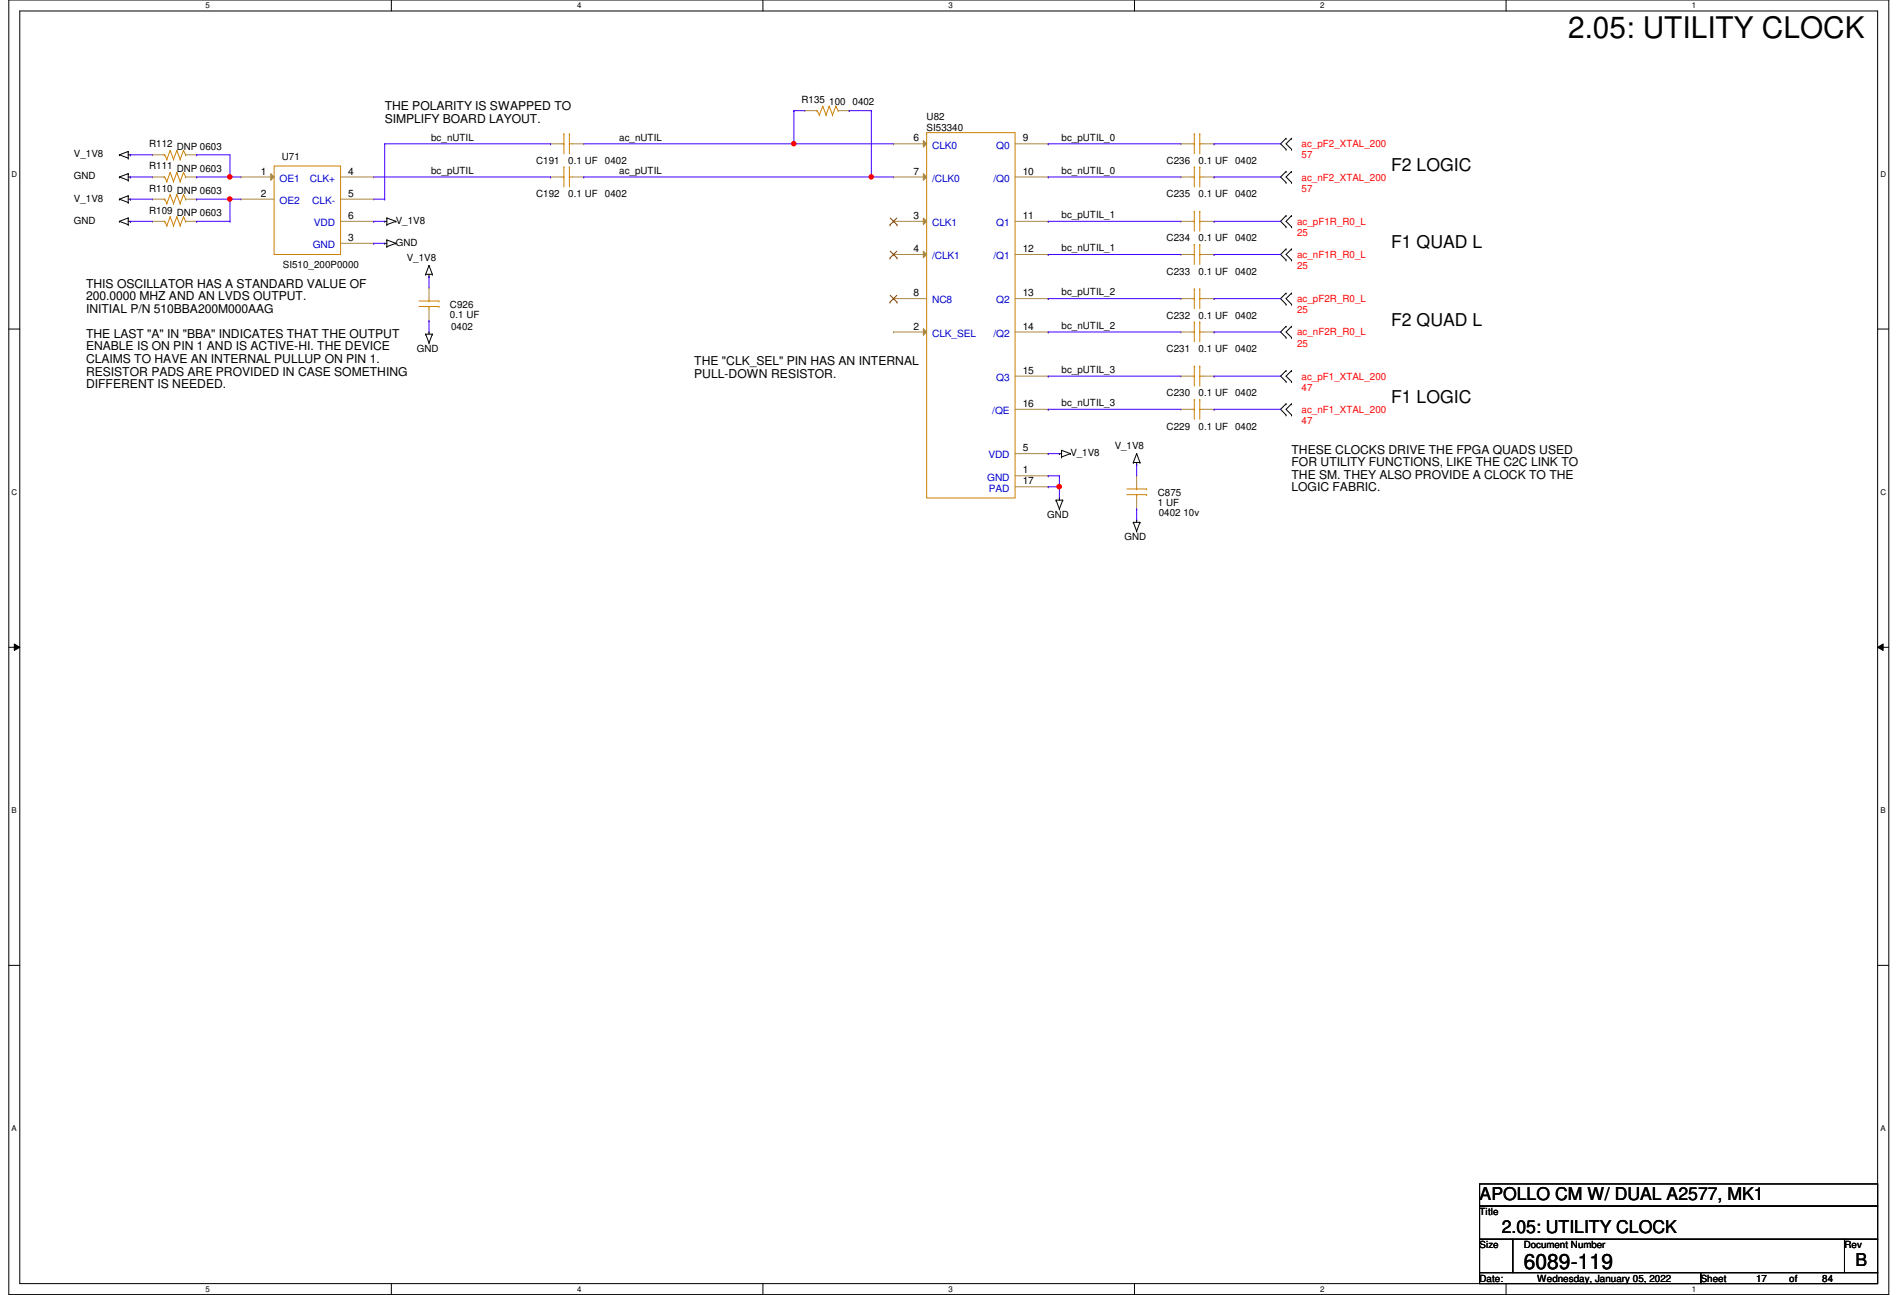
[picture p70: page 17]

THE POLARITY IS SWAPPED TO
SIMPLIFY BOARD LAYOUT.

THIS OSCILLATOR HAS A STANDARD VALUE OF
200.0000 MHZ AND AN LVDS OUTPUT.
INITIAL P/N 510BBA200M000AAG

THE LAST "A" IN "BBA" INDICATES THAT THE OUTPUT
ENABLE IS ON PIN 1 AND IS ACTIVE-HI. THE DEVICE
CLAIMS TO HAVE AN INTERNAL PULLUP ON PIN 1.
RESISTOR PADS ARE PROVIDED IN CASE SOMETHING
DIFFERENT IS NEEDED.

THE "CLK_SEL" PIN HAS AN INTERNAL
PULL-DOWN RESISTOR.

THESE CLOCKS DRIVE THE FPGA QUADS USED
FOR UTILITY FUNCTIONS, LIKE THE C2C LINK TO
THE SM. THEY ALSO PROVIDE A CLOCK TO THE
LOGIC FABRIC.

# 2.06: REFCLK SYNTHESIZER R0A

# F1 R0 LEFT QUADS

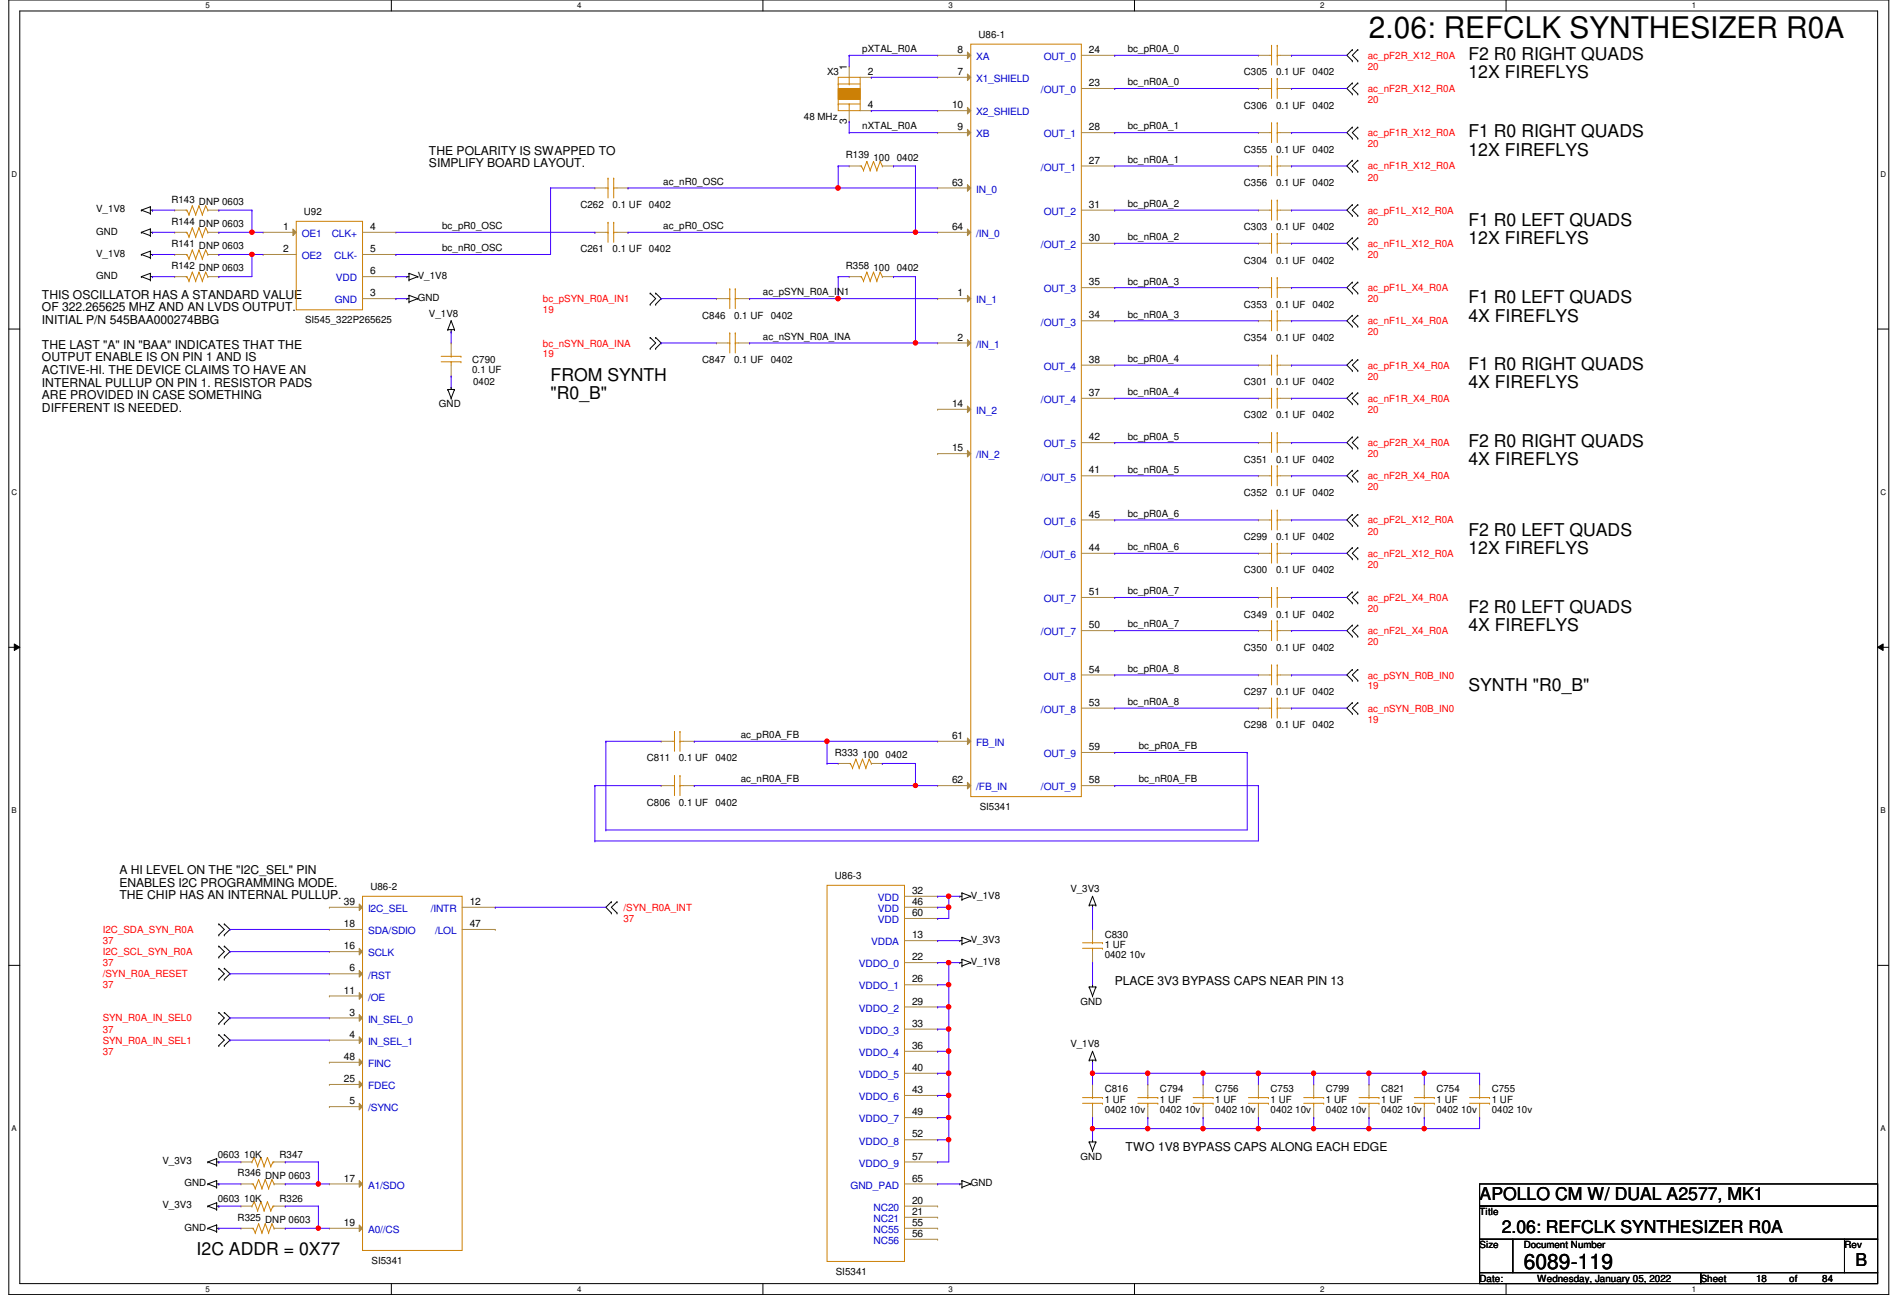
[picture p71: page 18]

THE POLARITY IS SWAPPED TO
SIMPLIFY BOARD LAYOUT.

THIS OSCILLATOR HAS A STANDARD VALUE
OF 322.265625 MHZ AND AN LVDS OUTPUT.
INITIAL P/N 545BAA000274BBG

THE LAST "A" IN "BAA" INDICATES THAT THE
OUTPUT ENABLE IS ON PIN 1 AND IS
ACTIVE-HI. THE DEVICE CLAIMS TO HAVE AN
INTERNAL PULLUP ON PIN 1. RESISTOR PADS
ARE PROVIDED IN CASE SOMETHING
DIFFERENT IS NEEDED.

A HI LEVEL ON THE "I2C_SEL" PIN
ENABLES I2C PROGRAMMING MODE.
THE CHIP HAS AN INTERNAL PULLUP.

PLACE 3V3 BYPASS CAPS NEAR PIN 13

TWO 1V8 BYPASS CAPS ALONG EACH EDGE

# LHC_CLK

# 2.07: REFCLK SYNTHESIZER R0B

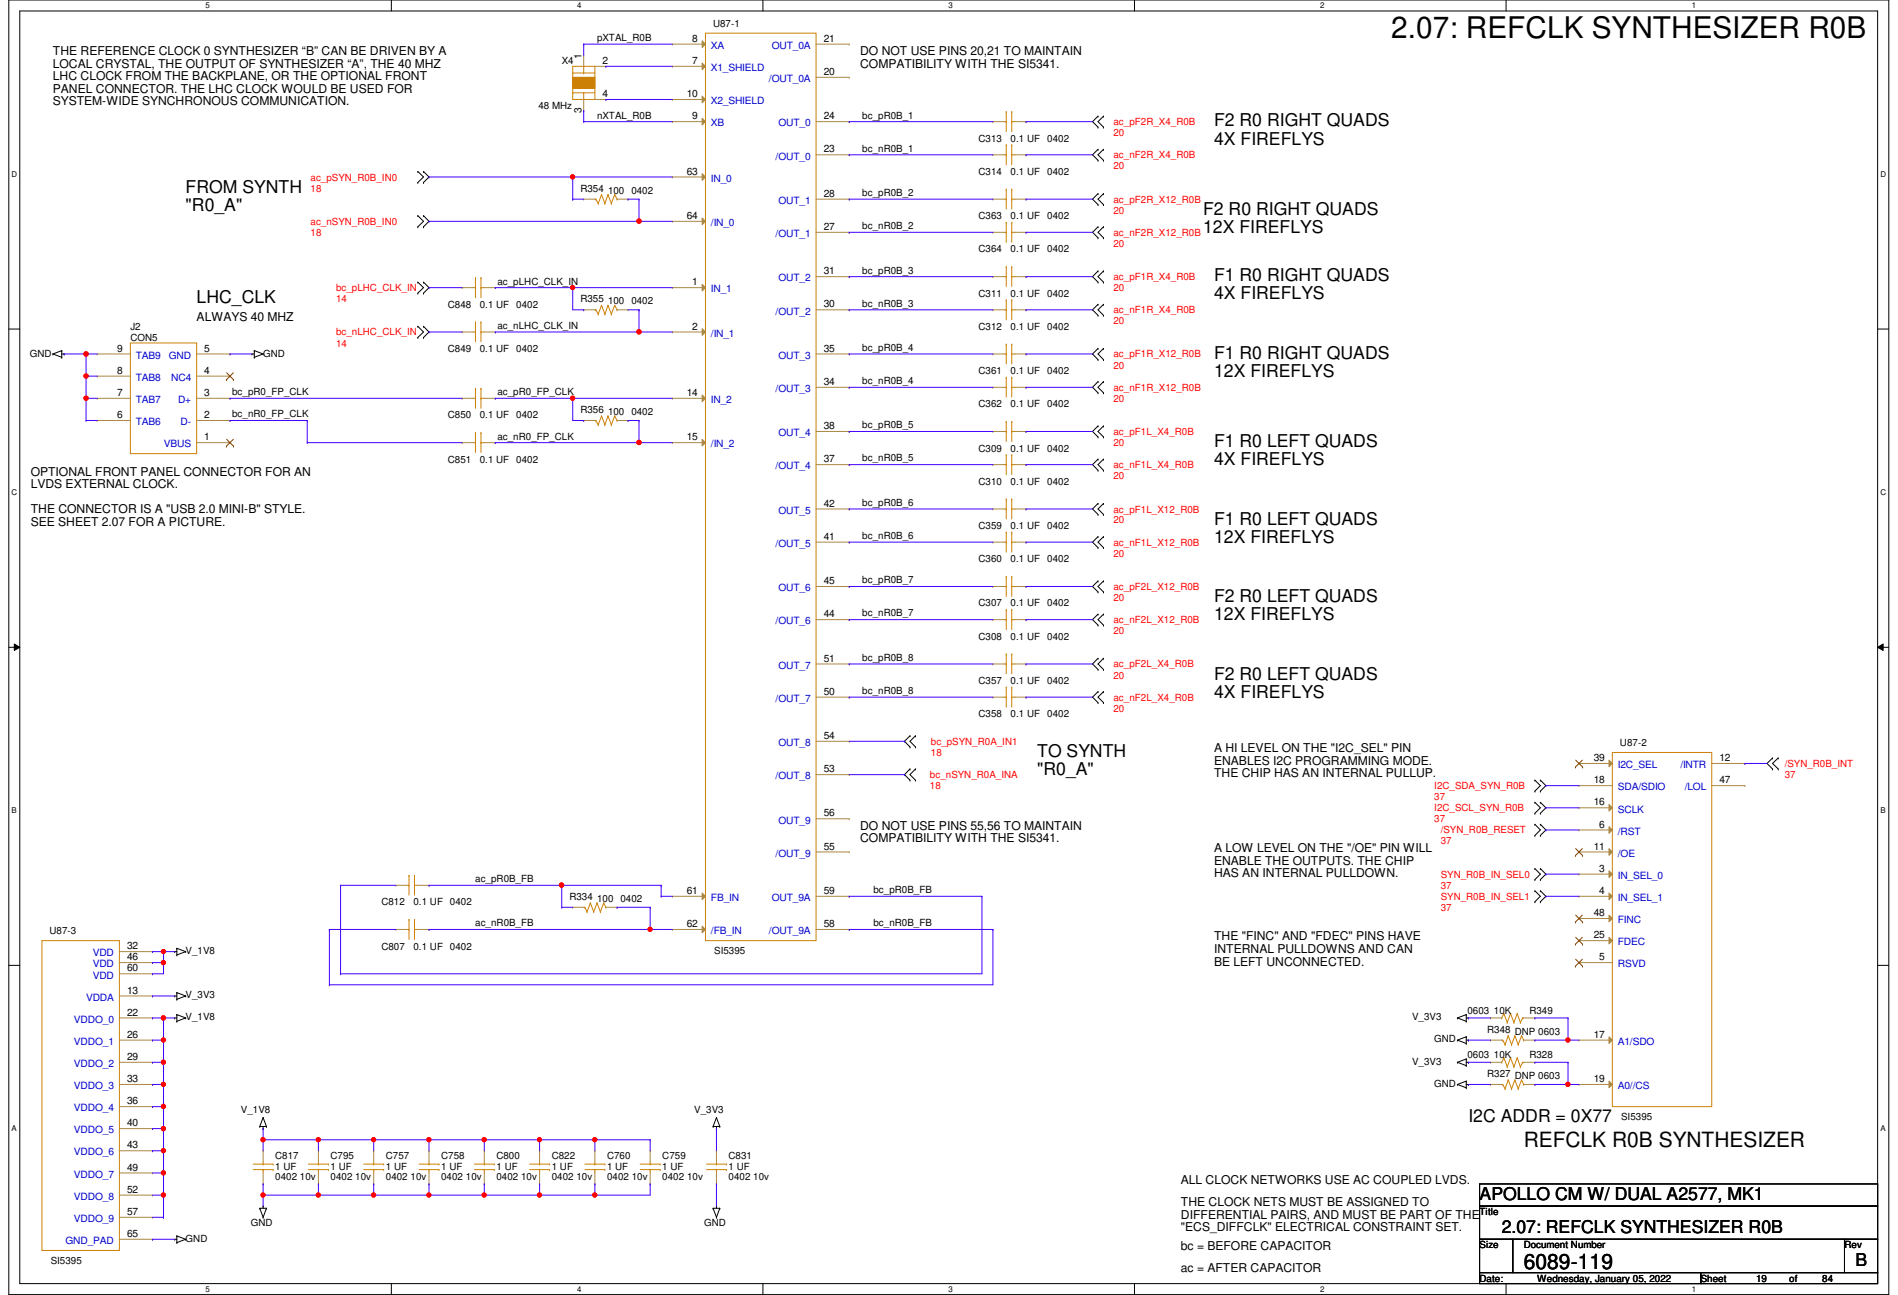
[picture p72: page 19]

THE REFERENCE CLOCK 0 SYNTHESIZER “B” CAN BE DRIVEN BY A
LOCAL CRYSTAL, THE OUTPUT OF SYNTHESIZER “A”, THE 40 MHZ
LHC CLOCK FROM THE BACKPLANE, OR THE OPTIONAL FRONT
PANEL CONNECTOR. THE LHC CLOCK WOULD BE USED FOR
SYSTEM-WIDE SYNCHRONOUS COMMUNICATION.

DO NOT USE PINS 20,21 TO MAINTAIN
COMPATIBILITY WITH THE SI5341.

OPTIONAL FRONT PANEL CONNECTOR FOR AN
LVDS EXTERNAL CLOCK.

THE CONNECTOR IS A "USB 2.0 MINI-B" STYLE.
SEE SHEET 2.07 FOR A PICTURE.

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

DO NOT USE PINS 55,56 TO MAINTAIN

A LOW LEVEL ON THE "/OE" PIN WILL
ENABLE THE OUTPUTS. THE CHIP
HAS AN INTERNAL PULLDOWN.

THE "FINC" AND "FDEC" PINS HAVE
INTERNAL PULLDOWNS AND CAN
BE LEFT UNCONNECTED.

ALL CLOCK NETWORKS USE AC COUPLED LVDS.

THE CLOCK NETS MUST BE ASSIGNED TO
DIFFERENTIAL PAIRS, AND MUST BE PART OF THE
"ECS_DIFFCLK" ELECTRICAL CONSTRAINT SET.
bc = BEFORE CAPACITOR

FPGA#1 LEFT | FPGA#1 RIGHT

# 2.08: REFCK_R0_FANOUT

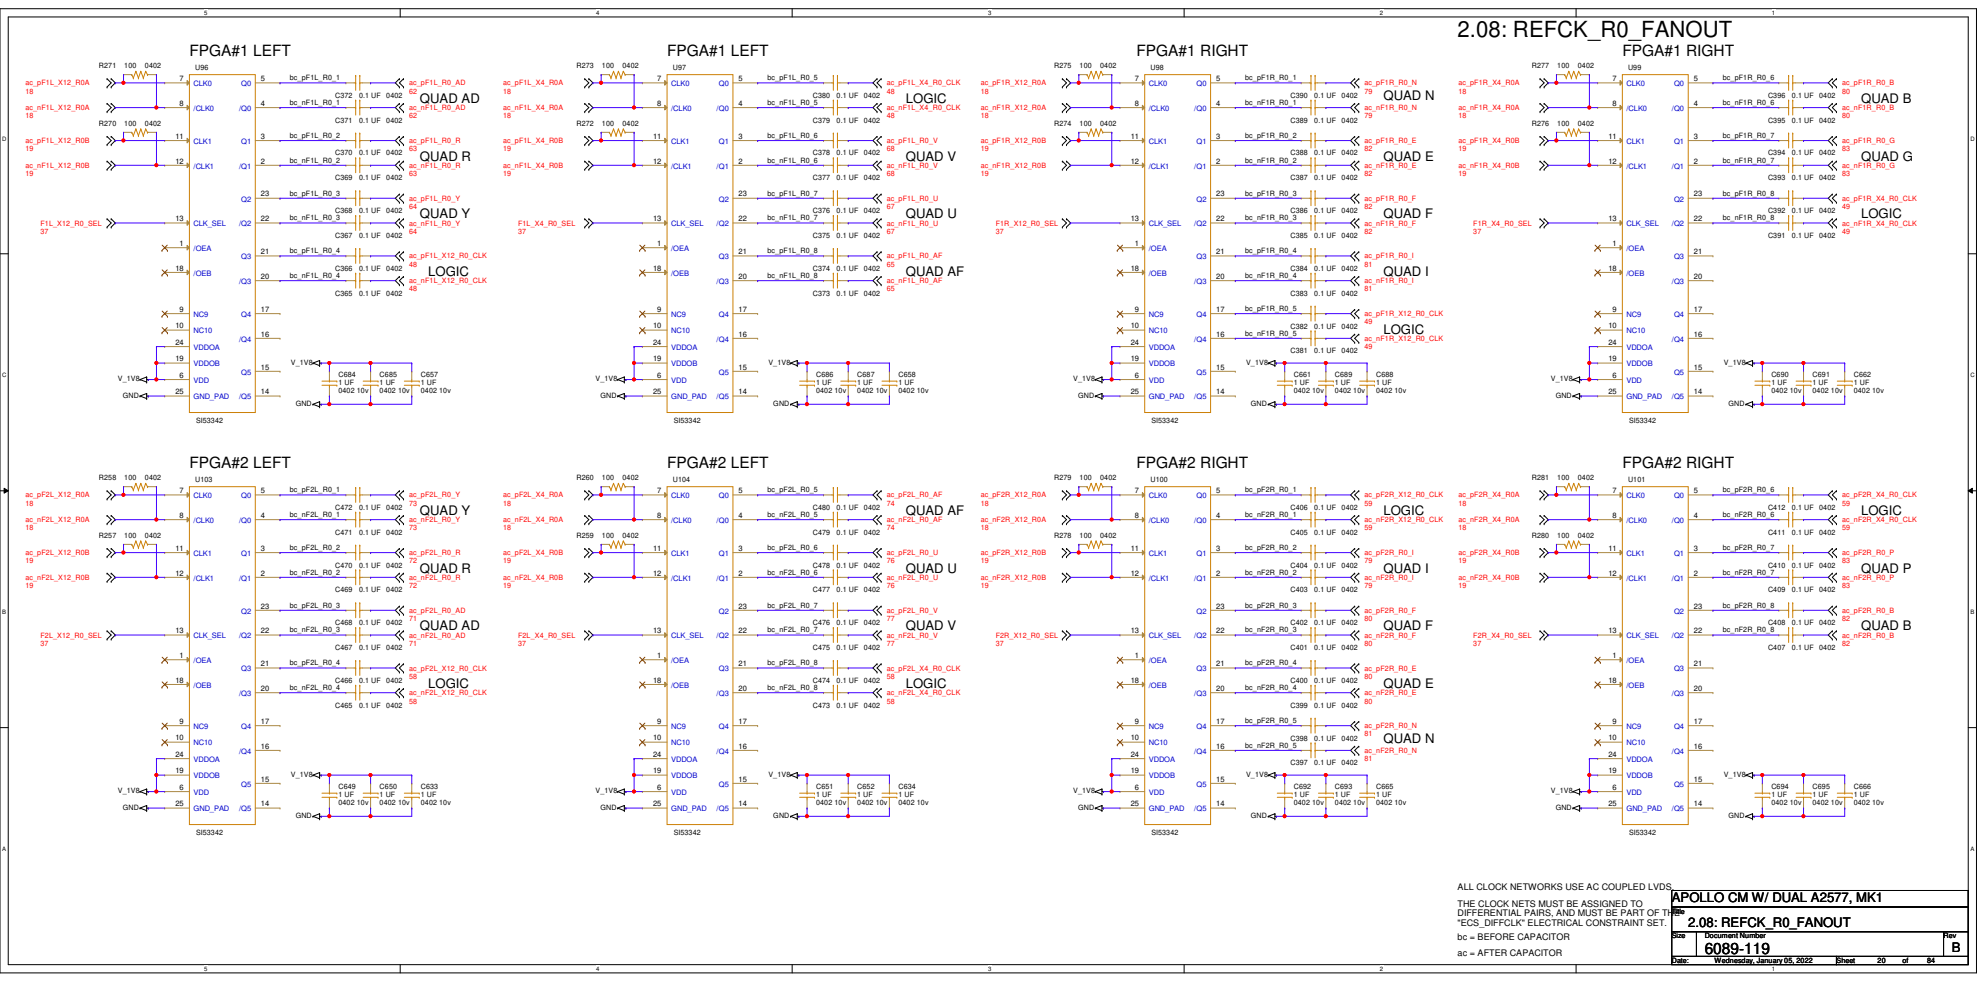
[picture p73: page 20]

ALL CLOCK NETWORKS USE AC COUPLED LVDS.
THE CLOCK NETS MUST BE ASSIGNED TO
DIFFERENTIAL PAIRS, AND MUST BE PART OF THE
"ECS_DIFFCLK" ELECTRICAL CONSTRAINT SET.
bc = BEFORE CAPACITOR
ac = AFTER CAPACITOR

# HQ_CLK

# 2.09: REFCLK SYNTHESIZER R1A

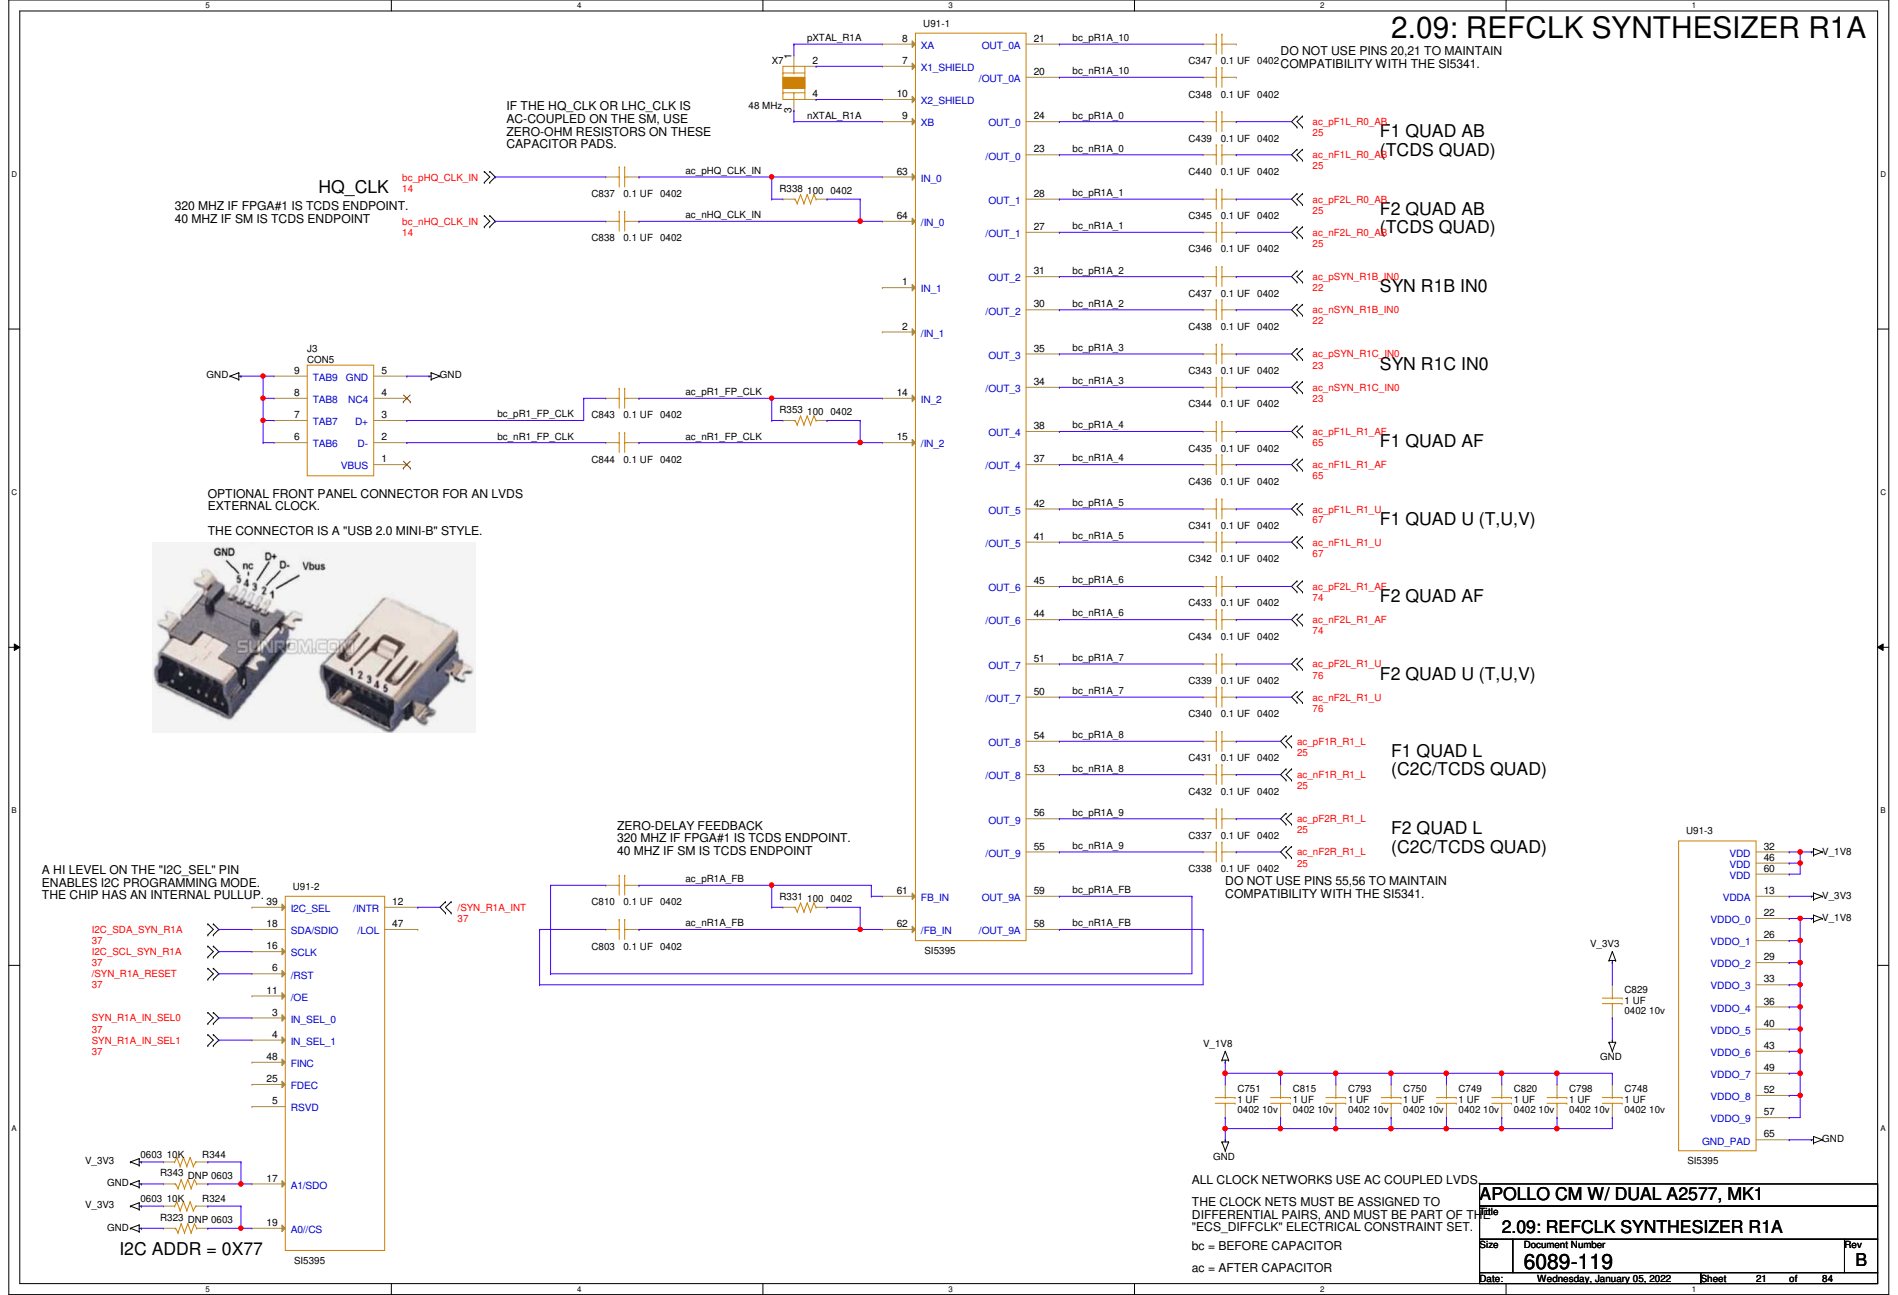
[picture p74: page 21]

DO NOT USE PINS 20,21 TO MAINTAIN
COMPATIBILITY WITH THE SI5341.

IF THE HQ_CLK OR LHC_CLK IS
AC-COUPLED ON THE SM, USE
ZERO-OHM RESISTORS ON THESE
CAPACITOR PADS.

320 MHZ IF FPGA#1 IS TCDS ENDPOINT.
40 MHZ IF SM IS TCDS ENDPOINT

OPTIONAL FRONT PANEL CONNECTOR FOR AN LVDS
EXTERNAL CLOCK.

THE CONNECTOR IS A "USB 2.0 MINI-B" STYLE.

ZERO-DELAY FEEDBACK

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

DO NOT USE PINS 55,56 TO MAINTAIN

ALL CLOCK NETWORKS USE AC COUPLED LVDS.

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

# F1 QUAD AB (TCDS QUAD)

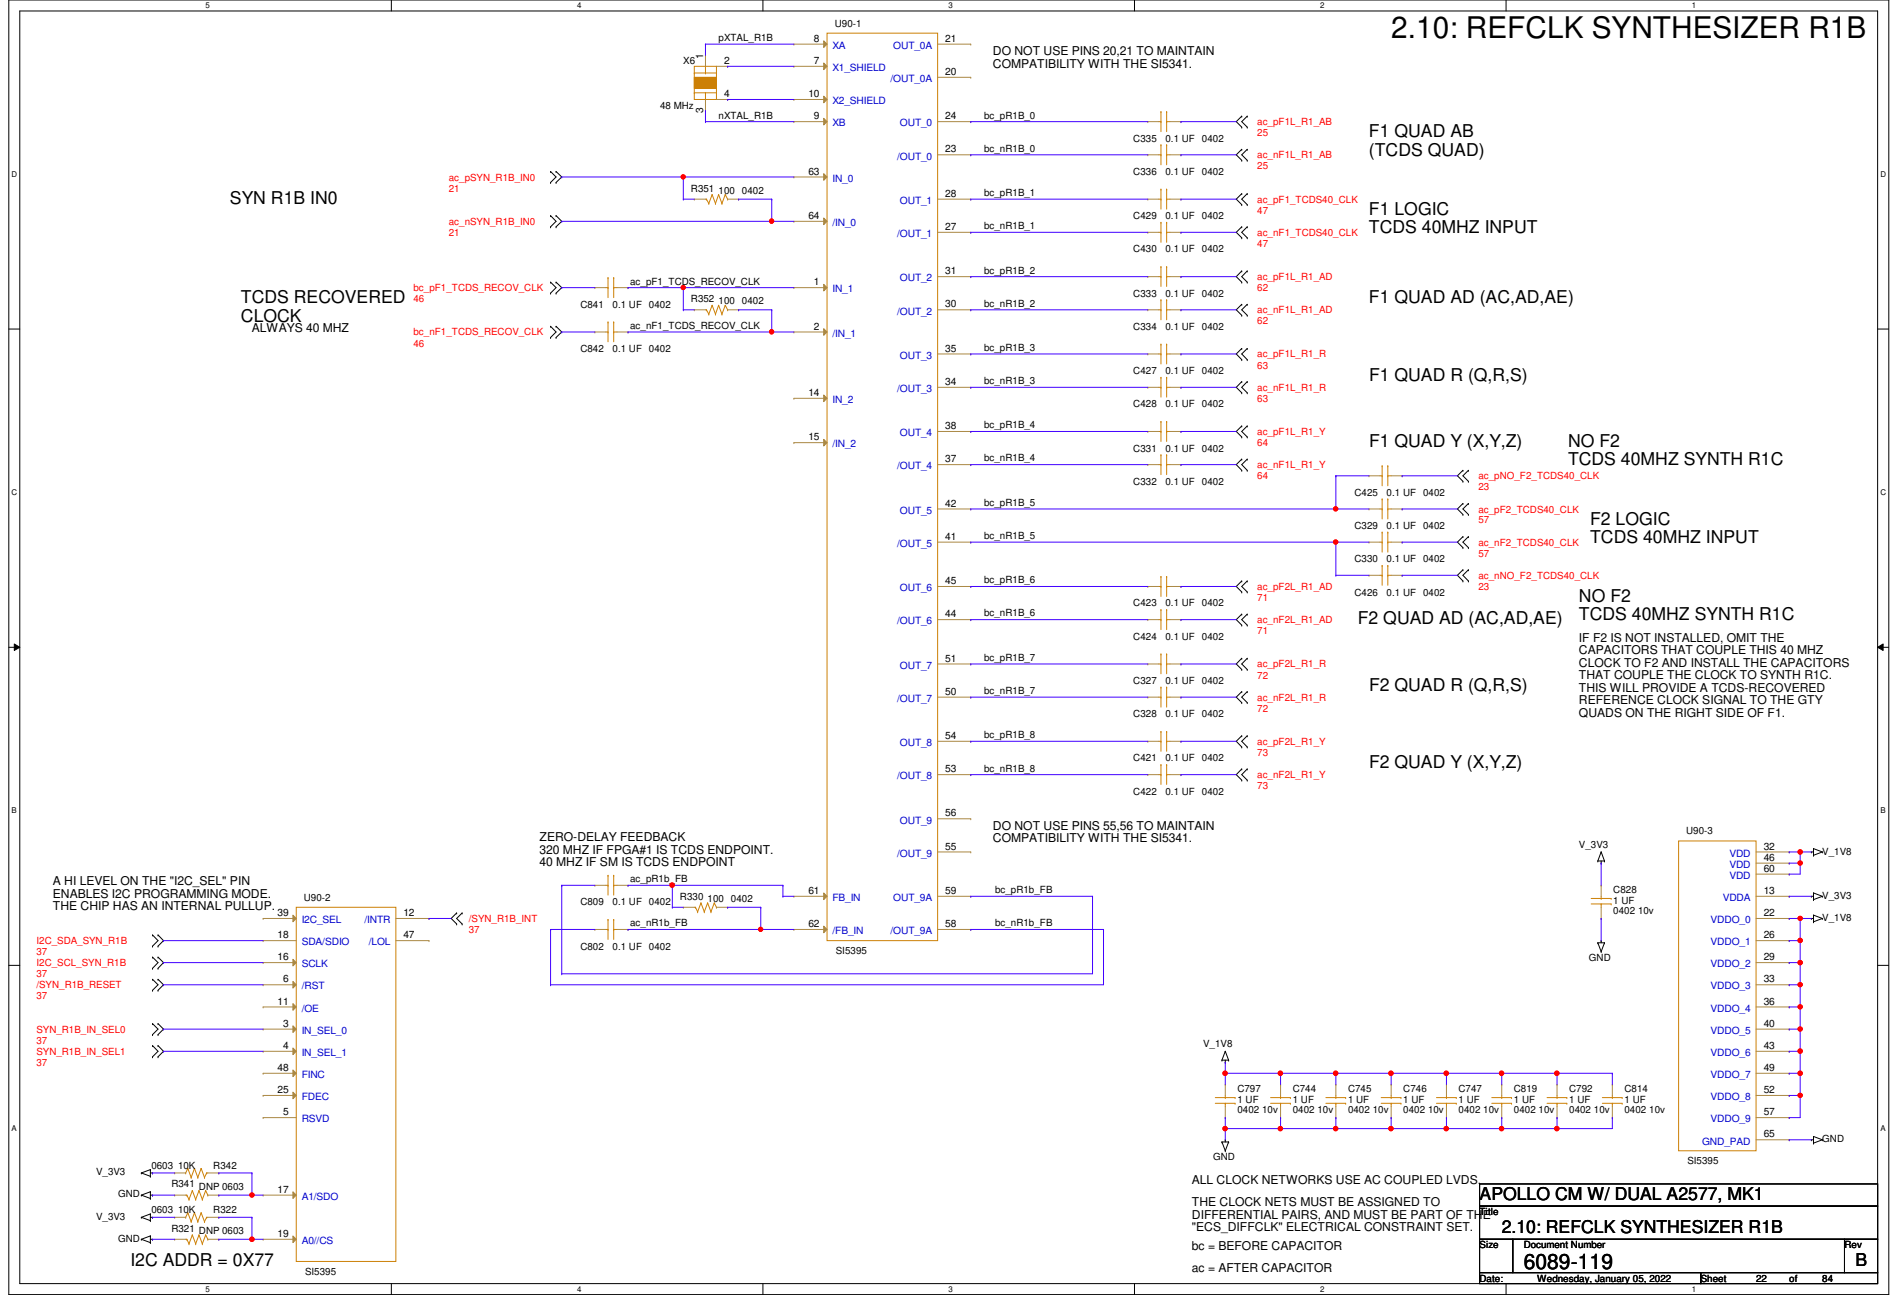
[picture p75: page 22]

DO NOT USE PINS 20,21 TO MAINTAIN
COMPATIBILITY WITH THE SI5341.

F2 QUAD AD (AC,AD,AE)

IF F2 IS NOT INSTALLED, OMIT THE
CAPACITORS THAT COUPLE THIS 40 MHZ
CLOCK TO F2 AND INSTALL THE CAPACITORS
THAT COUPLE THE CLOCK TO SYNTH R1C.
THIS WILL PROVIDE A TCDS-RECOVERED
REFERENCE CLOCK SIGNAL TO THE GTY
QUADS ON THE RIGHT SIDE OF F1.

DO NOT USE PINS 55,56 TO MAINTAIN

ZERO-DELAY FEEDBACK
320 MHZ IF FPGA#1 IS TCDS ENDPOINT.
40 MHZ IF SM IS TCDS ENDPOINT

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

ALL CLOCK NETWORKS USE AC COUPLED LVDS.

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

# SYN R1C IN0

# NO F2

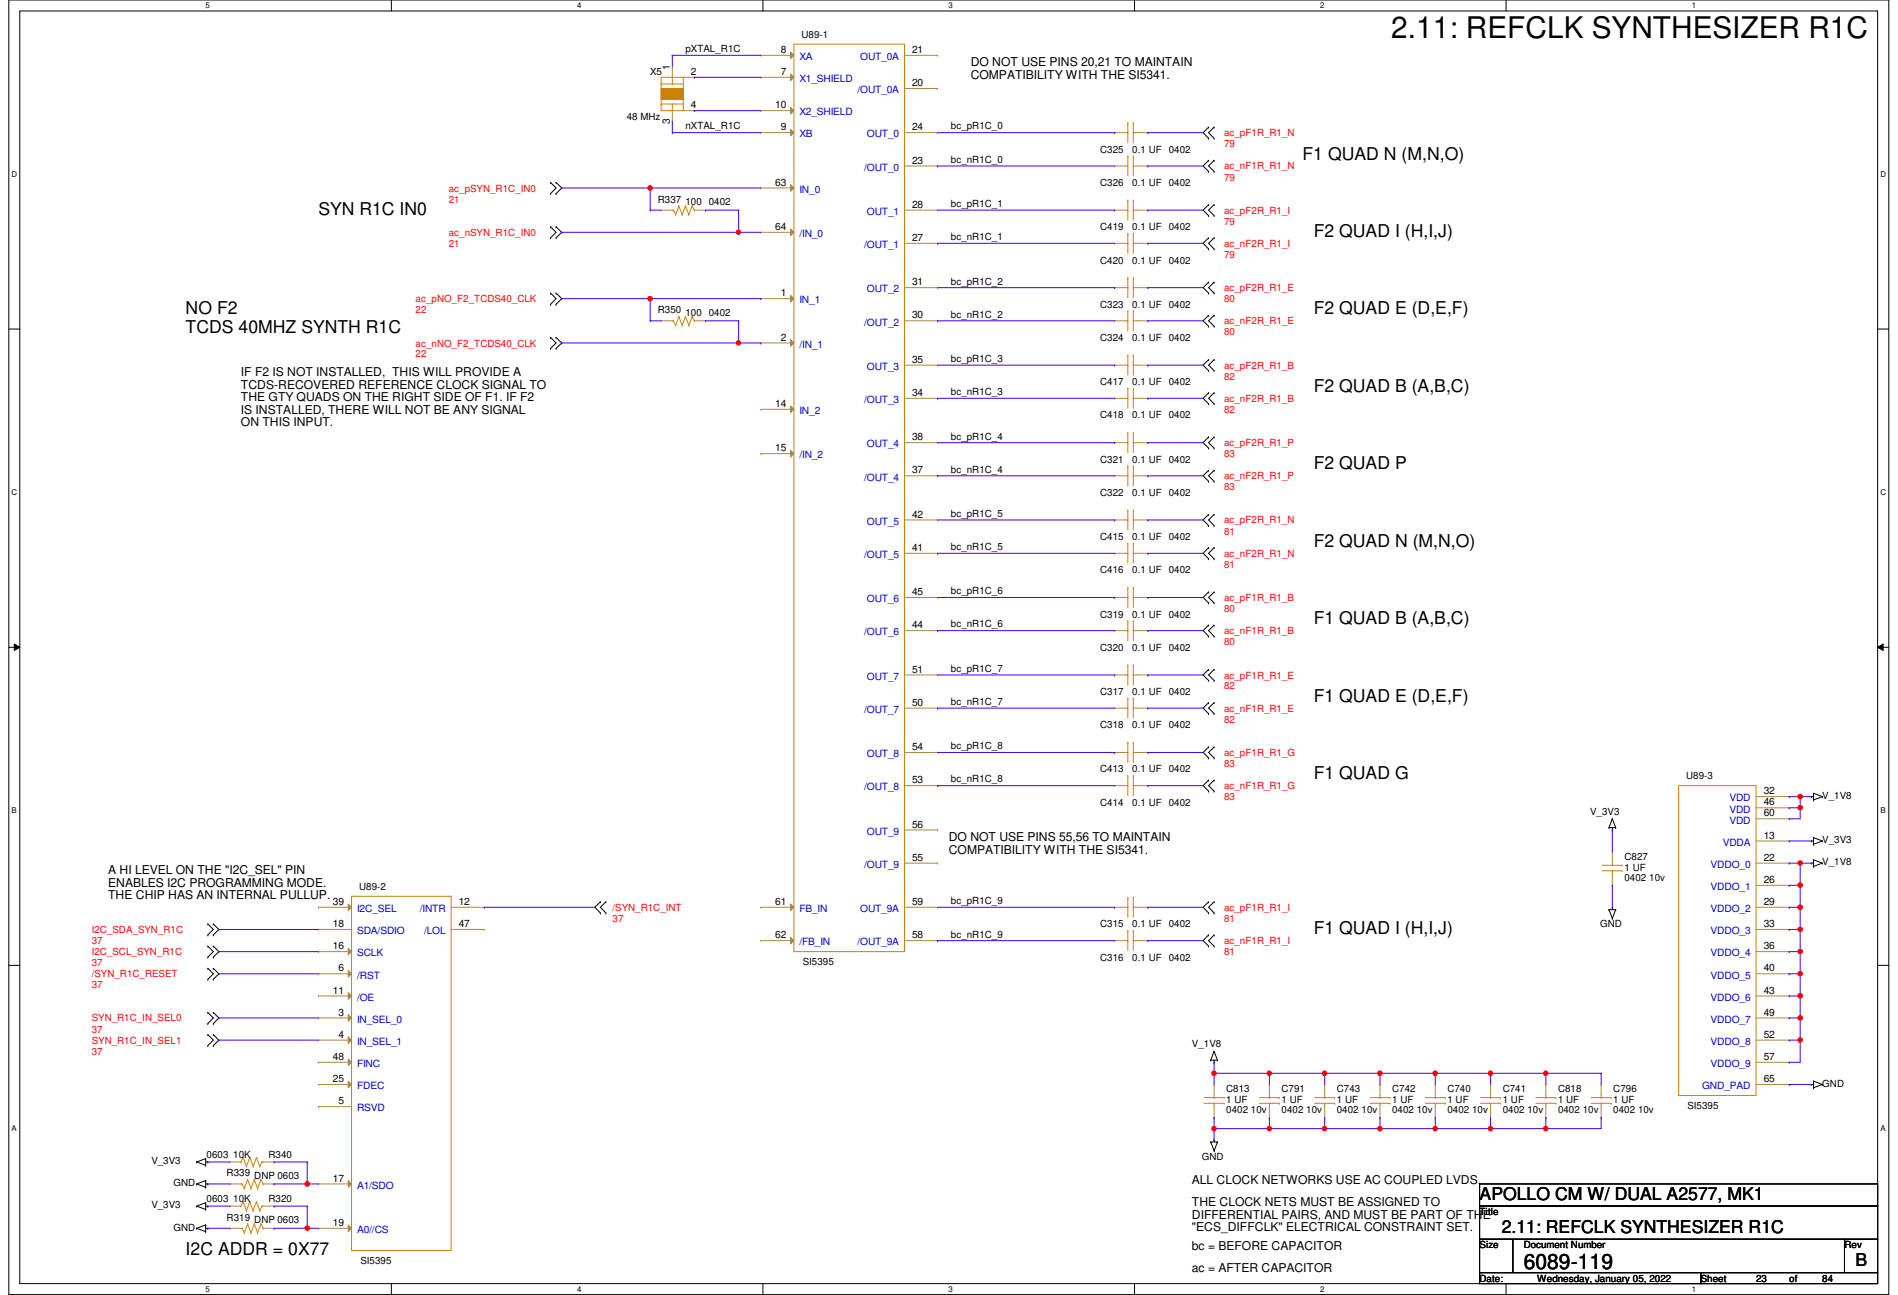
[picture p76: page 23]

DO NOT USE PINS 20,21 TO MAINTAIN
COMPATIBILITY WITH THE SI5341.

IF F2 IS NOT INSTALLED, THIS WILL PROVIDE A
TCDS-RECOVERED REFERENCE CLOCK SIGNAL TO
THE GTY QUADS ON THE RIGHT SIDE OF F1. IF F2
IS INSTALLED, THERE WILL NOT BE ANY SIGNAL
ON THIS INPUT.

DO NOT USE PINS 55,56 TO MAINTAIN

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

ALL CLOCK NETWORKS USE AC COUPLED LVDS.

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

# 2.12: LEDS AND LEVEL SHIFTERS

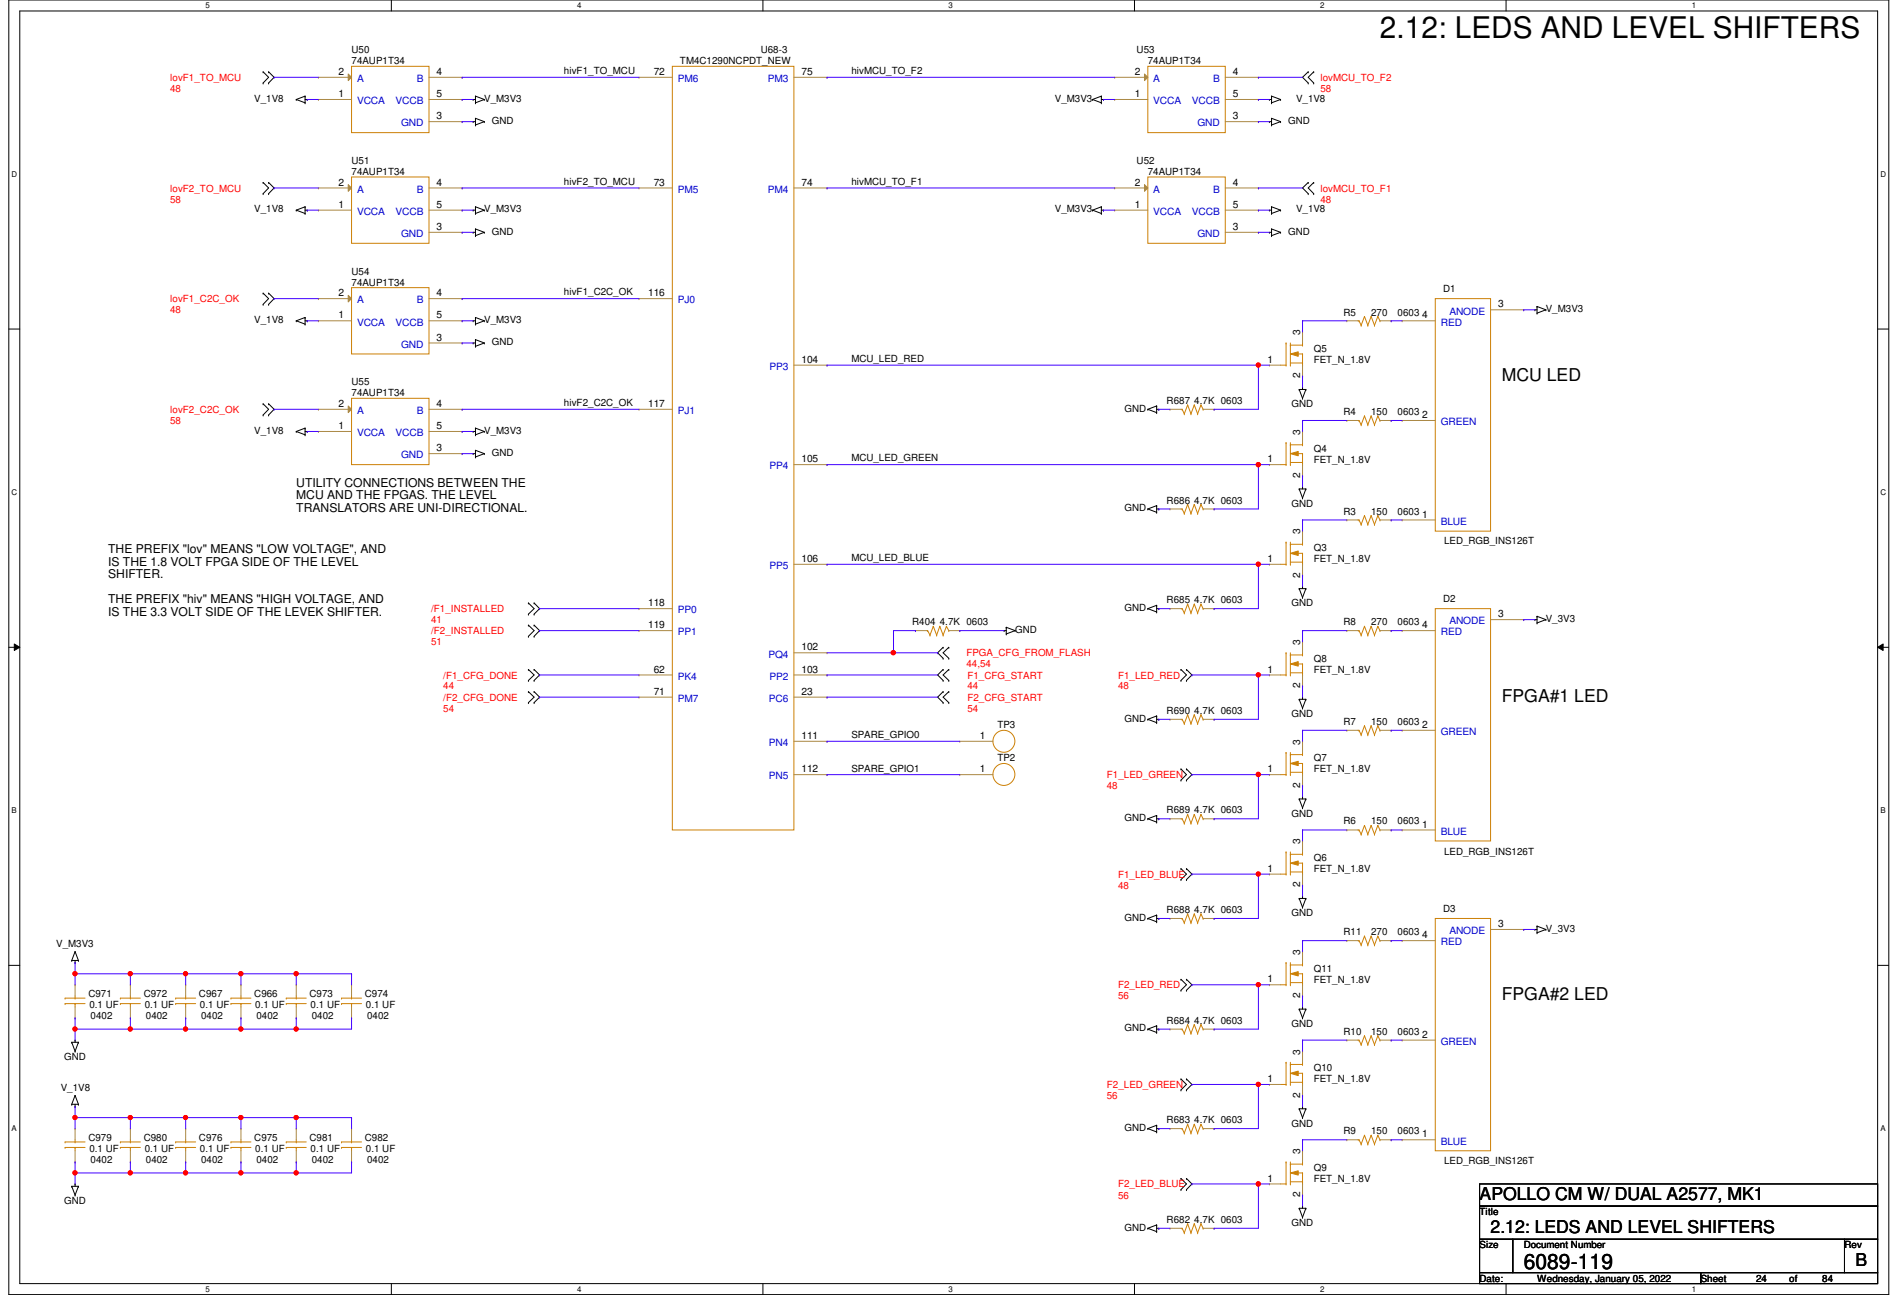
[picture p77: page 24]

UTILITY CONNECTIONS BETWEEN THE
MCU AND THE FPGAS. THE LEVEL
TRANSLATORS ARE UNI-DIRECTIONAL.

THE PREFIX "lov" MEANS "LOW VOLTAGE", AND
IS THE 1.8 VOLT FPGA SIDE OF THE LEVEL
SHIFTER.

THE PREFIX "hiv" MEANS "HIGH VOLTAGE, AND
IS THE 3.3 VOLT SIDE OF THE LEVEK SHIFTER.

2.12: LEDS AND LEVEL SHIFTERS

# THE "AB" QUADS ARE DEDICATED TO TCDS SIGNALS. THE "L" QUADS CONTAIN BOTH

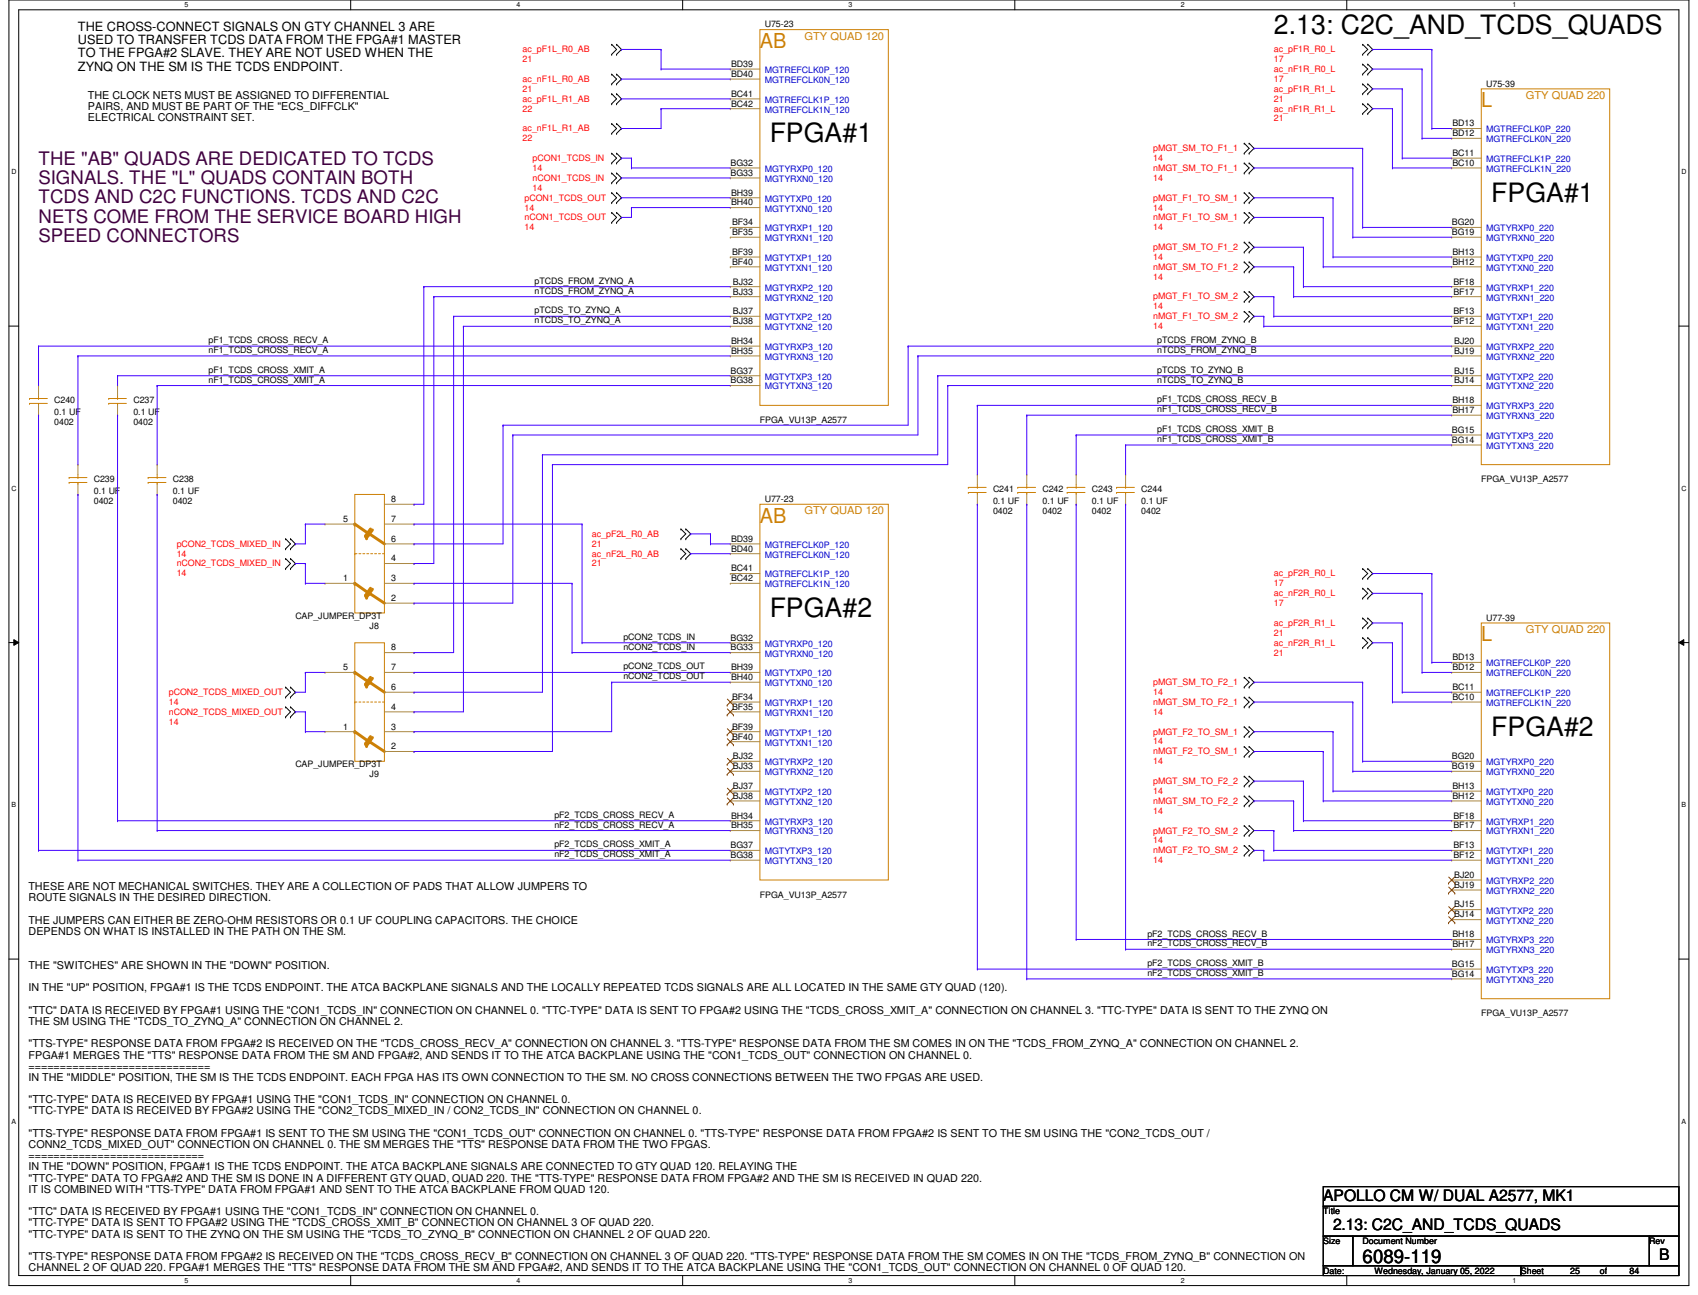
[picture p78: page 25]

THE CROSS-CONNECT SIGNALS ON GTY CHANNEL 3 ARE
USED TO TRANSFER TCDS DATA FROM THE FPGA#1 MASTER
TO THE FPGA#2 SLAVE. THEY ARE NOT USED WHEN THE
ZYNQ ON THE SM IS THE TCDS ENDPOINT.

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

TCDS AND C2C FUNCTIONS. TCDS AND C2C
NETS COME FROM THE SERVICE BOARD HIGH
SPEED CONNECTORS

THESE ARE NOT MECHANICAL SWITCHES. THEY ARE A COLLECTION OF PADS THAT ALLOW JUMPERS TO
ROUTE SIGNALS IN THE DESIRED DIRECTION.

THE JUMPERS CAN EITHER BE ZERO-OHM RESISTORS OR 0.1 UF COUPLING CAPACITORS. THE CHOICE
DEPENDS ON WHAT IS INSTALLED IN THE PATH ON THE SM.

THE "SWITCHES" ARE SHOWN IN THE "DOWN" POSITION.

IN THE "UP" POSITION, FPGA#1 IS THE TCDS ENDPOINT. THE ATCA BACKPLANE SIGNALS AND THE LOCALLY REPEATED TCDS SIGNALS ARE ALL LOCATED IN THE SAME GTY QUAD (120).

"TTC" DATA IS RECEIVED BY FPGA#1 USING THE "CON1_TCDS_IN" CONNECTION ON CHANNEL 0. "TTC-TYPE" DATA IS SENT TO FPGA#2 USING THE "TCDS_CROSS_XMIT_A" CONNECTION ON CHANNEL 3. "TTC-TYPE" DATA IS SENT TO THE ZYNQ ON
THE SM USING THE "TCDS_TO_ZYNQ_A" CONNECTION ON CHANNEL 2.

"TTS-TYPE" RESPONSE DATA FROM FPGA#2 IS RECEIVED ON THE "TCDS_CROSS_RECV_A" CONNECTION ON CHANNEL 3. "TTS-TYPE" RESPONSE DATA FROM THE SM COMES IN ON THE "TCDS_FROM_ZYNQ_A" CONNECTION ON CHANNEL 2.
FPGA#1 MERGES THE "TTS" RESPONSE DATA FROM THE SM AND FPGA#2, AND SENDS IT TO THE ATCA BACKPLANE USING THE "CON1_TCDS_OUT" CONNECTION ON CHANNEL 0.
IN THE "MIDDLE" POSITION, THE SM IS THE TCDS ENDPOINT. EACH FPGA HAS ITS OWN CONNECTION TO THE SM. NO CROSS CONNECTIONS BETWEEN THE TWO FPGAS ARE USED.

"TTC-TYPE" DATA IS RECEIVED BY FPGA#1 USING THE "CON1_TCDS_IN" CONNECTION ON CHANNEL 0.
"TTC-TYPE" DATA IS RECEIVED BY FPGA#2 USING THE "CON2_TCDS_MIXED_IN / CON2_TCDS_IN" CONNECTION ON CHANNEL 0.
"TTS-TYPE" RESPONSE DATA FROM FPGA#1 IS SENT TO THE SM USING THE "CON1_TCDS_OUT" CONNECTION ON CHANNEL 0. "TTS-TYPE" RESPONSE DATA FROM FPGA#2 IS SENT TO THE SM USING THE "CON2_TCDS_OUT /
CONN2_TCDS_MIXED_OUT" CONNECTION ON CHANNEL 0. THE SM MERGES THE "TTS" RESPONSE DATA FROM THE TWO FPGAS.
IN THE "DOWN" POSITION, FPGA#1 IS THE TCDS ENDPOINT. THE ATCA BACKPLANE SIGNALS ARE CONNECTED TO GTY QUAD 120. RELAYING THE
"TTC-TYPE" DATA TO FPGA#2 AND THE SM IS DONE IN A DIFFERENT GTY QUAD, QUAD 220. THE "TTS-TYPE" RESPONSE DATA FROM FPGA#2 AND THE SM IS RECEIVED IN QUAD 220.
IT IS COMBINED WITH "TTS-TYPE" DATA FROM FPGA#1 AND SENT TO THE ATCA BACKPLANE FROM QUAD 120.

"TTC" DATA IS RECEIVED BY FPGA#1 USING THE "CON1_TCDS_IN" CONNECTION ON CHANNEL 0.
"TTC-TYPE" DATA IS SENT TO FPGA#2 USING THE "TCDS_CROSS_XMIT_B" CONNECTION ON CHANNEL 3 OF QUAD 220.
"TTC-TYPE" DATA IS SENT TO THE ZYNQ ON THE SM USING THE "TCDS_TO_ZYNQ_B" CONNECTION ON CHANNEL 2 OF QUAD 220.

"TTS-TYPE" RESPONSE DATA FROM FPGA#2 IS RECEIVED ON THE "TCDS_CROSS_RECV_B" CONNECTION ON CHANNEL 3 OF QUAD 220. "TTS-TYPE" RESPONSE DATA FROM THE SM COMES IN ON THE "TCDS_FROM_ZYNQ_B" CONNECTION ON
CHANNEL 2 OF QUAD 220. FPGA#1 MERGES THE "TTS" RESPONSE DATA FROM THE SM AND FPGA#2, AND SENDS IT TO THE ATCA BACKPLANE USING THE "CON1_TCDS_OUT" CONNECTION ON CHANNEL 0 OF QUAD 120.

# 3.01: POWER MANAGEMENT M3V3

## NOTE 1

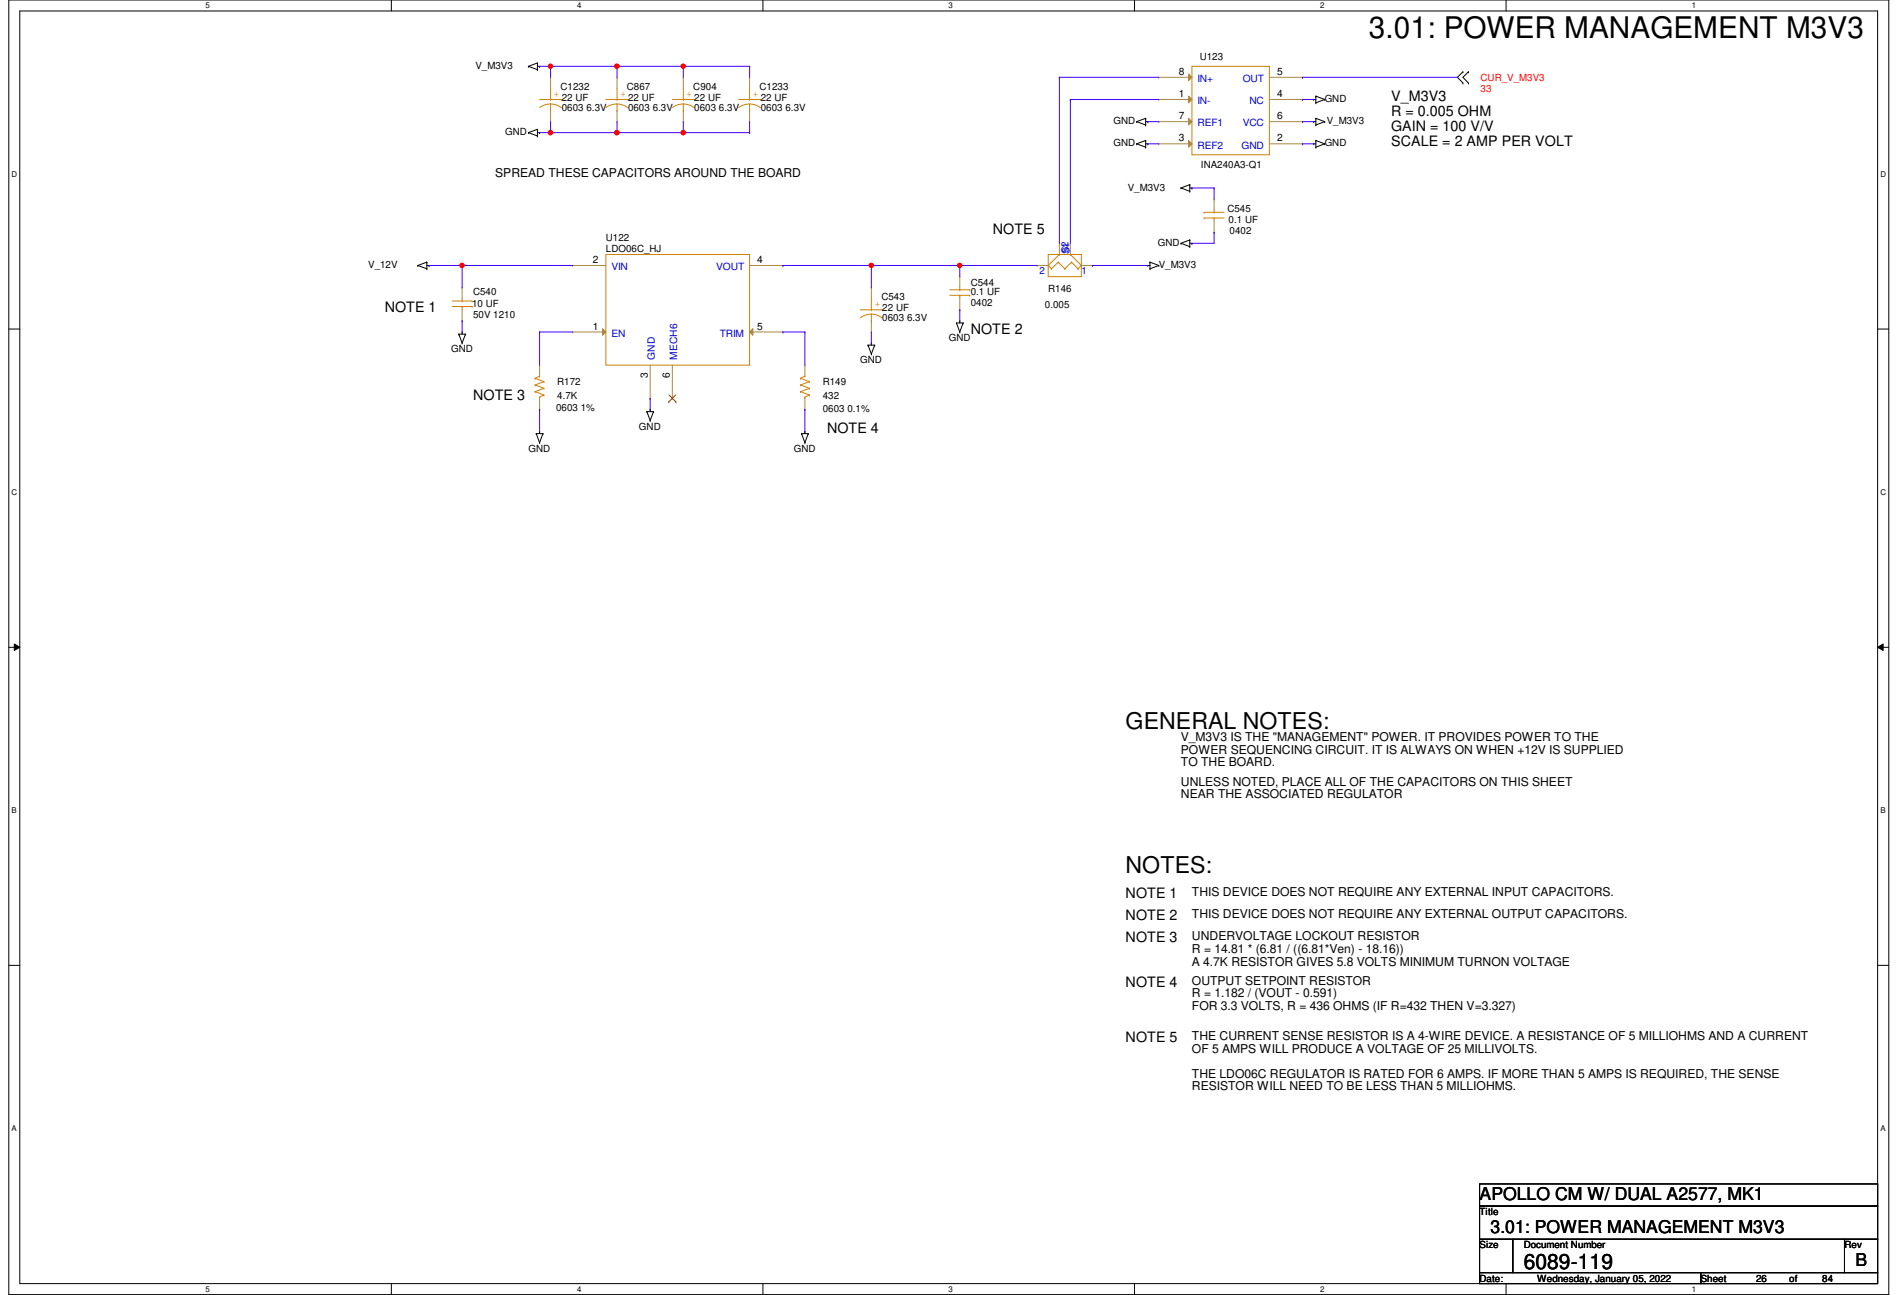
[picture p79: page 26]

SPREAD THESE CAPACITORS AROUND THE BOARD

V_M3V3 IS THE "MANAGEMENT" POWER. IT PROVIDES POWER TO THE
POWER SEQUENCING CIRCUIT. IT IS ALWAYS ON WHEN +12V IS SUPPLIED
TO THE BOARD.
UNLESS NOTED, PLACE ALL OF THE CAPACITORS ON THIS SHEET
NEAR THE ASSOCIATED REGULATOR

THIS DEVICE DOES NOT REQUIRE ANY EXTERNAL INPUT CAPACITORS.

THIS DEVICE DOES NOT REQUIRE ANY EXTERNAL OUTPUT CAPACITORS.

UNDERVOLTAGE LOCKOUT RESISTOR
R = 14.81 * (6.81 / ((6.81*Ven) - 18.16))
A 4.7K RESISTOR GIVES 5.8 VOLTS MINIMUM TURNON VOLTAGE
OUTPUT SETPOINT RESISTOR
R = 1.182 / (VOUT - 0.591)
FOR 3.3 VOLTS, R = 436 OHMS (IF R=432 THEN V=3.327)

THE CURRENT SENSE RESISTOR IS A 4-WIRE DEVICE. A RESISTANCE OF 5 MILLIOHMS AND A CURRENT
OF 5 AMPS WILL PRODUCE A VOLTAGE OF 25 MILLIVOLTS.

THE LDO06C REGULATOR IS RATED FOR 6 AMPS. IF MORE THAN 5 AMPS IS REQUIRED, THE SENSE
RESISTOR WILL NEED TO BE LESS THAN 5 MILLIOHMS.

# I2C ADDR = 0X40 (AND 0X41)

## NOTE 5

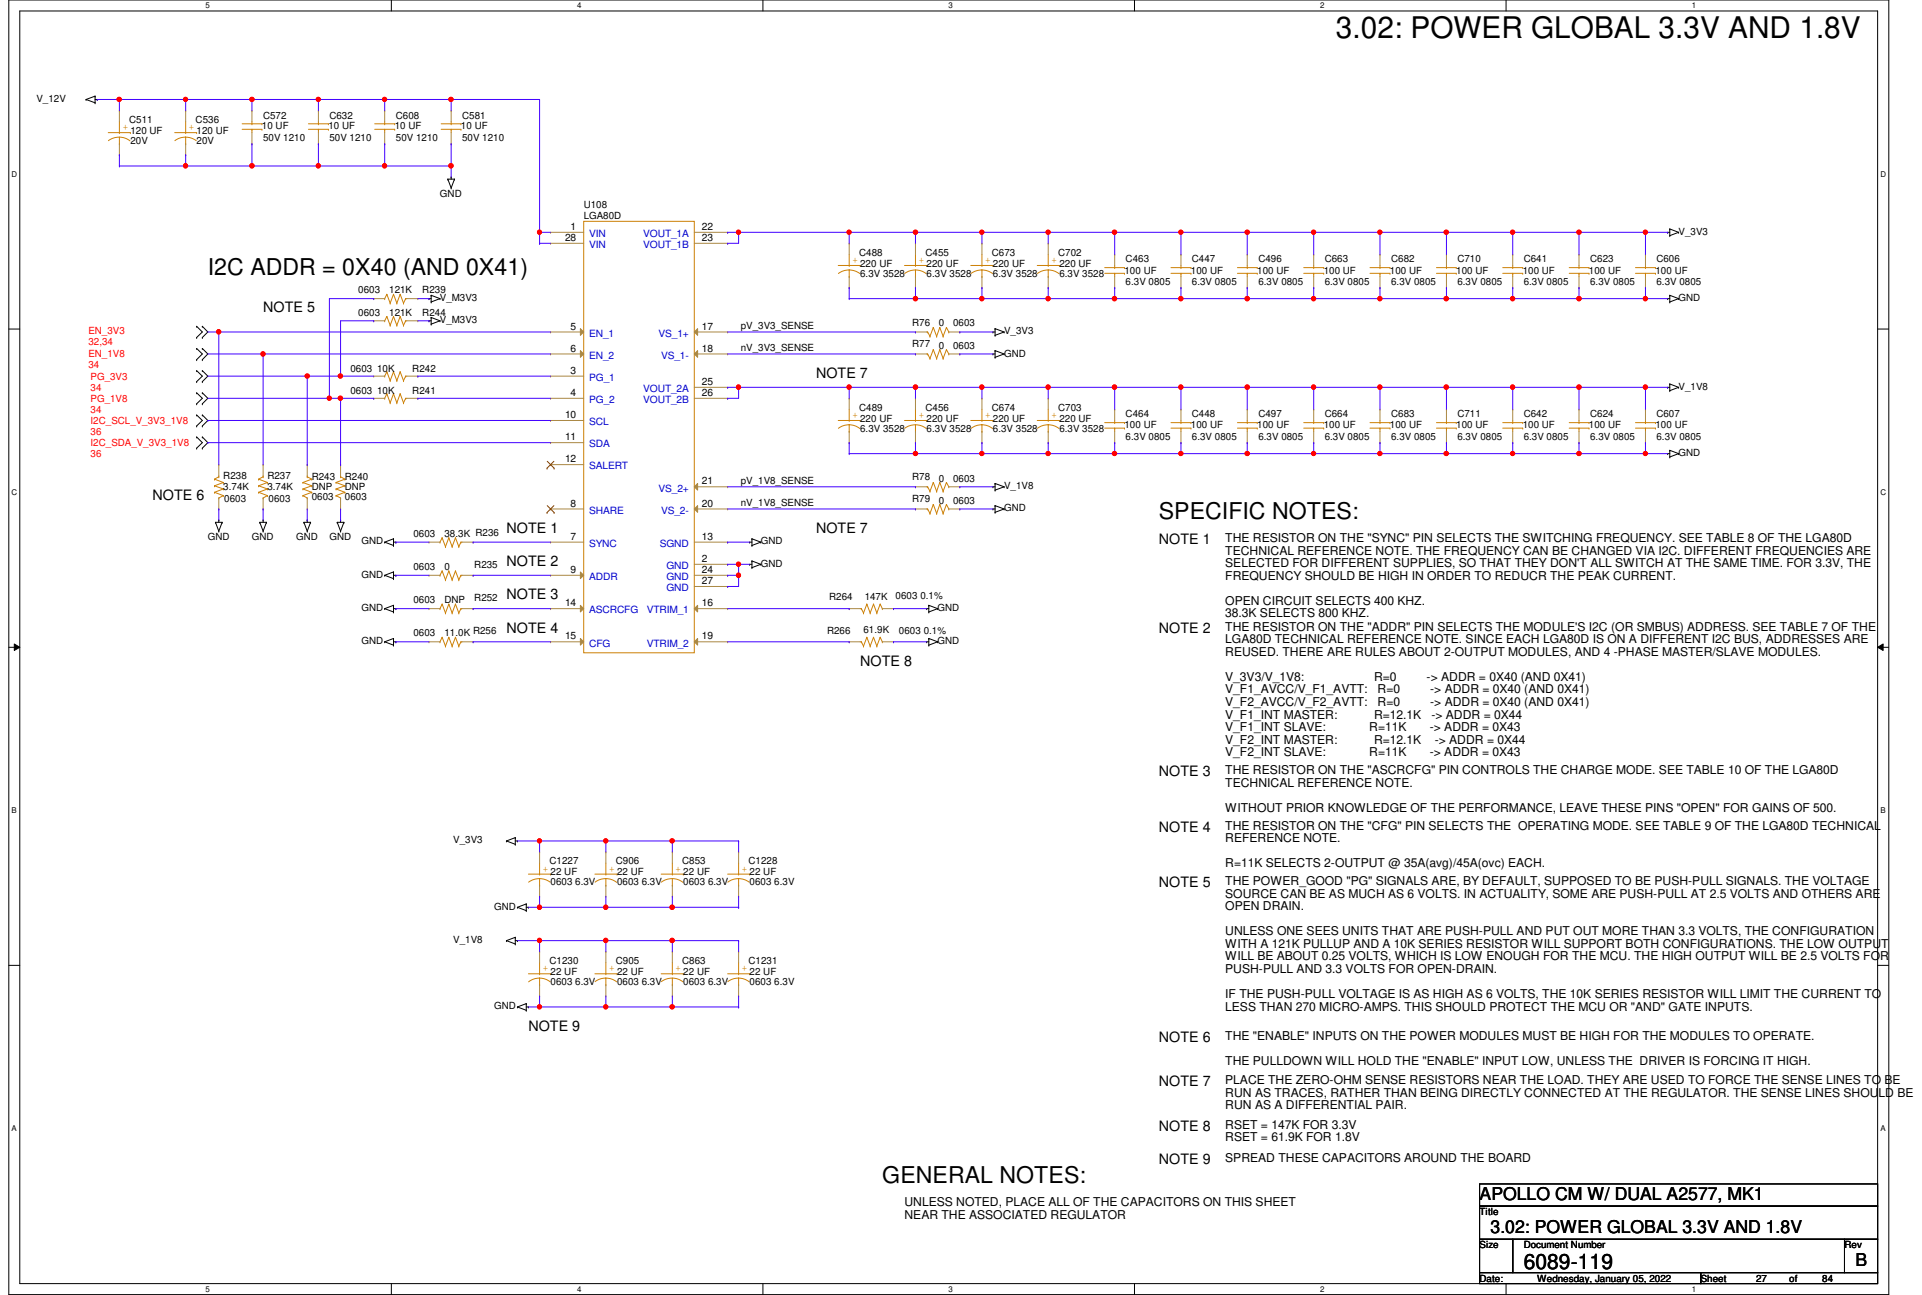
[picture p80: page 27]

THE RESISTOR ON THE "SYNC" PIN SELECTS THE SWITCHING FREQUENCY. SEE TABLE 8 OF THE LGA80D
TECHNICAL REFERENCE NOTE. THE FREQUENCY CAN BE CHANGED VIA I2C. DIFFERENT FREQUENCIES ARE
SELECTED FOR DIFFERENT SUPPLIES, SO THAT THEY DON'T ALL SWITCH AT THE SAME TIME. FOR 3.3V, THE
FREQUENCY SHOULD BE HIGH IN ORDER TO REDUCR THE PEAK CURRENT.

OPEN CIRCUIT SELECTS 400 KHZ.
38.3K SELECTS 800 KHZ.
THE RESISTOR ON THE "ADDR" PIN SELECTS THE MODULE'S I2C (OR SMBUS) ADDRESS. SEE TABLE 7 OF THE
LGA80D TECHNICAL REFERENCE NOTE. SINCE EACH LGA80D IS ON A DIFFERENT I2C BUS, ADDRESSES ARE
REUSED. THERE ARE RULES ABOUT 2-OUTPUT MODULES, AND 4 -PHASE MASTER/SLAVE MODULES.

THE RESISTOR ON THE "ASCRCFG" PIN CONTROLS THE CHARGE MODE. SEE TABLE 10 OF THE LGA80D
TECHNICAL REFERENCE NOTE.

WITHOUT PRIOR KNOWLEDGE OF THE PERFORMANCE, LEAVE THESE PINS "OPEN" FOR GAINS OF 500.
THE RESISTOR ON THE "CFG" PIN SELECTS THE OPERATING MODE. SEE TABLE 9 OF THE LGA80D TECHNICAL
REFERENCE NOTE.

R=11K SELECTS 2-OUTPUT @ 35A(avg)/45A(ovc) EACH.
THE POWER_GOOD "PG" SIGNALS ARE, BY DEFAULT, SUPPOSED TO BE PUSH-PULL SIGNALS. THE VOLTAGE
SOURCE CAN BE AS MUCH AS 6 VOLTS. IN ACTUALITY, SOME ARE PUSH-PULL AT 2.5 VOLTS AND OTHERS ARE
OPEN DRAIN.

UNLESS ONE SEES UNITS THAT ARE PUSH-PULL AND PUT OUT MORE THAN 3.3 VOLTS, THE CONFIGURATION
WITH A 121K PULLUP AND A 10K SERIES RESISTOR WILL SUPPORT BOTH CONFIGURATIONS. THE LOW OUTPUT
WILL BE ABOUT 0.25 VOLTS, WHICH IS LOW ENOUGH FOR THE MCU. THE HIGH OUTPUT WILL BE 2.5 VOLTS FOR
PUSH-PULL AND 3.3 VOLTS FOR OPEN-DRAIN.

IF THE PUSH-PULL VOLTAGE IS AS HIGH AS 6 VOLTS, THE 10K SERIES RESISTOR WILL LIMIT THE CURRENT TO
LESS THAN 270 MICRO-AMPS. THIS SHOULD PROTECT THE MCU OR "AND" GATE INPUTS.

THE "ENABLE" INPUTS ON THE POWER MODULES MUST BE HIGH FOR THE MODULES TO OPERATE.

THE PULLDOWN WILL HOLD THE "ENABLE" INPUT LOW, UNLESS THE DRIVER IS FORCING IT HIGH.
PLACE THE ZERO-OHM SENSE RESISTORS NEAR THE LOAD. THEY ARE USED TO FORCE THE SENSE LINES TO BE
RUN AS TRACES, RATHER THAN BEING DIRECTLY CONNECTED AT THE REGULATOR. THE SENSE LINES SHOULD BE
RUN AS A DIFFERENTIAL PAIR.
RSET = 147K FOR 3.3V
RSET = 61.9K FOR 1.8V
SPREAD THESE CAPACITORS AROUND THE BOARD

UNLESS NOTED, PLACE ALL OF THE CAPACITORS ON THIS SHEET
NEAR THE ASSOCIATED REGULATOR

A

## NOTE 5

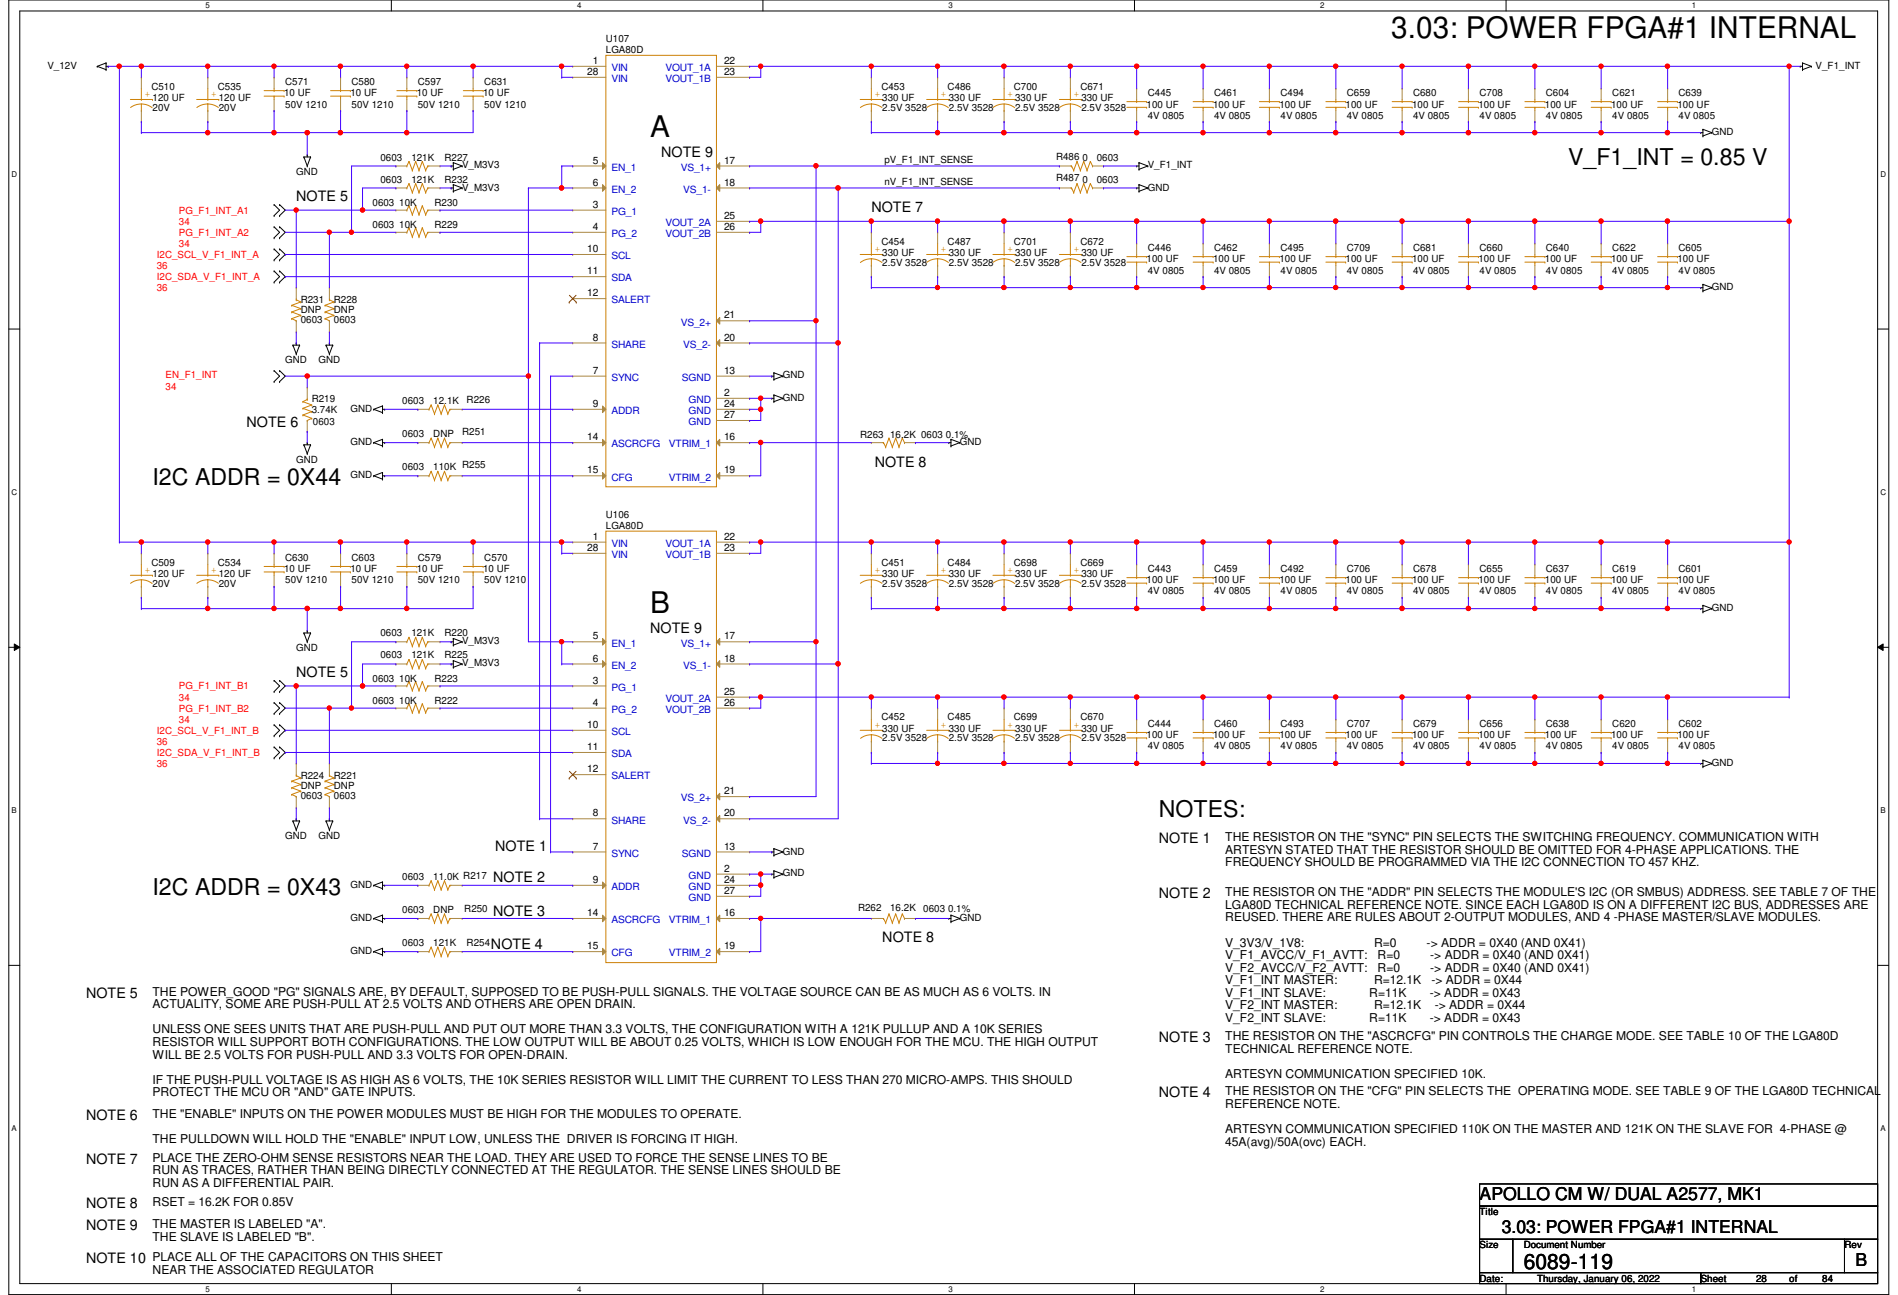
[picture p81: page 28]

THE RESISTOR ON THE "SYNC" PIN SELECTS THE SWITCHING FREQUENCY. COMMUNICATION WITH
ARTESYN STATED THAT THE RESISTOR SHOULD BE OMITTED FOR 4-PHASE APPLICATIONS. THE
FREQUENCY SHOULD BE PROGRAMMED VIA THE I2C CONNECTION TO 457 KHZ.

NOTE 2 THE RESISTOR ON THE "ADDR" PIN SELECTS THE MODULE'S I2C (OR SMBUS) ADDRESS. SEE TABLE 7 OF THE

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

IF THE PUSH-PULL VOLTAGE IS AS HIGH AS 6 VOLTS, THE 10K SERIES RESISTOR WILL LIMIT THE CURRENT TO LESS THAN 270 MICRO-AMPS. THIS SHOULD
PROTECT THE MCU OR "AND" GATE INPUTS.
THE "ENABLE" INPUTS ON THE POWER MODULES MUST BE HIGH FOR THE MODULES TO OPERATE.

ARTESYN COMMUNICATION SPECIFIED 10K.
THE RESISTOR ON THE "CFG" PIN SELECTS THE OPERATING MODE. SEE TABLE 9 OF THE LGA80D TECHNICAL
REFERENCE NOTE.

ARTESYN COMMUNICATION SPECIFIED 110K ON THE MASTER AND 121K ON THE SLAVE FOR 4-PHASE @
45A(avg)/50A(ovc) EACH.

THE PULLDOWN WILL HOLD THE "ENABLE" INPUT LOW, UNLESS THE DRIVER IS FORCING IT HIGH.
PLACE THE ZERO-OHM SENSE RESISTORS NEAR THE LOAD. THEY ARE USED TO FORCE THE SENSE LINES TO BE
RUN AS TRACES, RATHER THAN BEING DIRECTLY CONNECTED AT THE REGULATOR. THE SENSE LINES SHOULD BE
RUN AS A DIFFERENTIAL PAIR.
RSET = 16.2K FOR 0.85V

NOTE 9 THE MASTER IS LABELED "A".

THE SLAVE IS LABELED "B".
PLACE ALL OF THE CAPACITORS ON THIS SHEET
NEAR THE ASSOCIATED REGULATOR

# V_F1_AVCC = 0.9 V

# V_F1_AVTT = 1.2 V

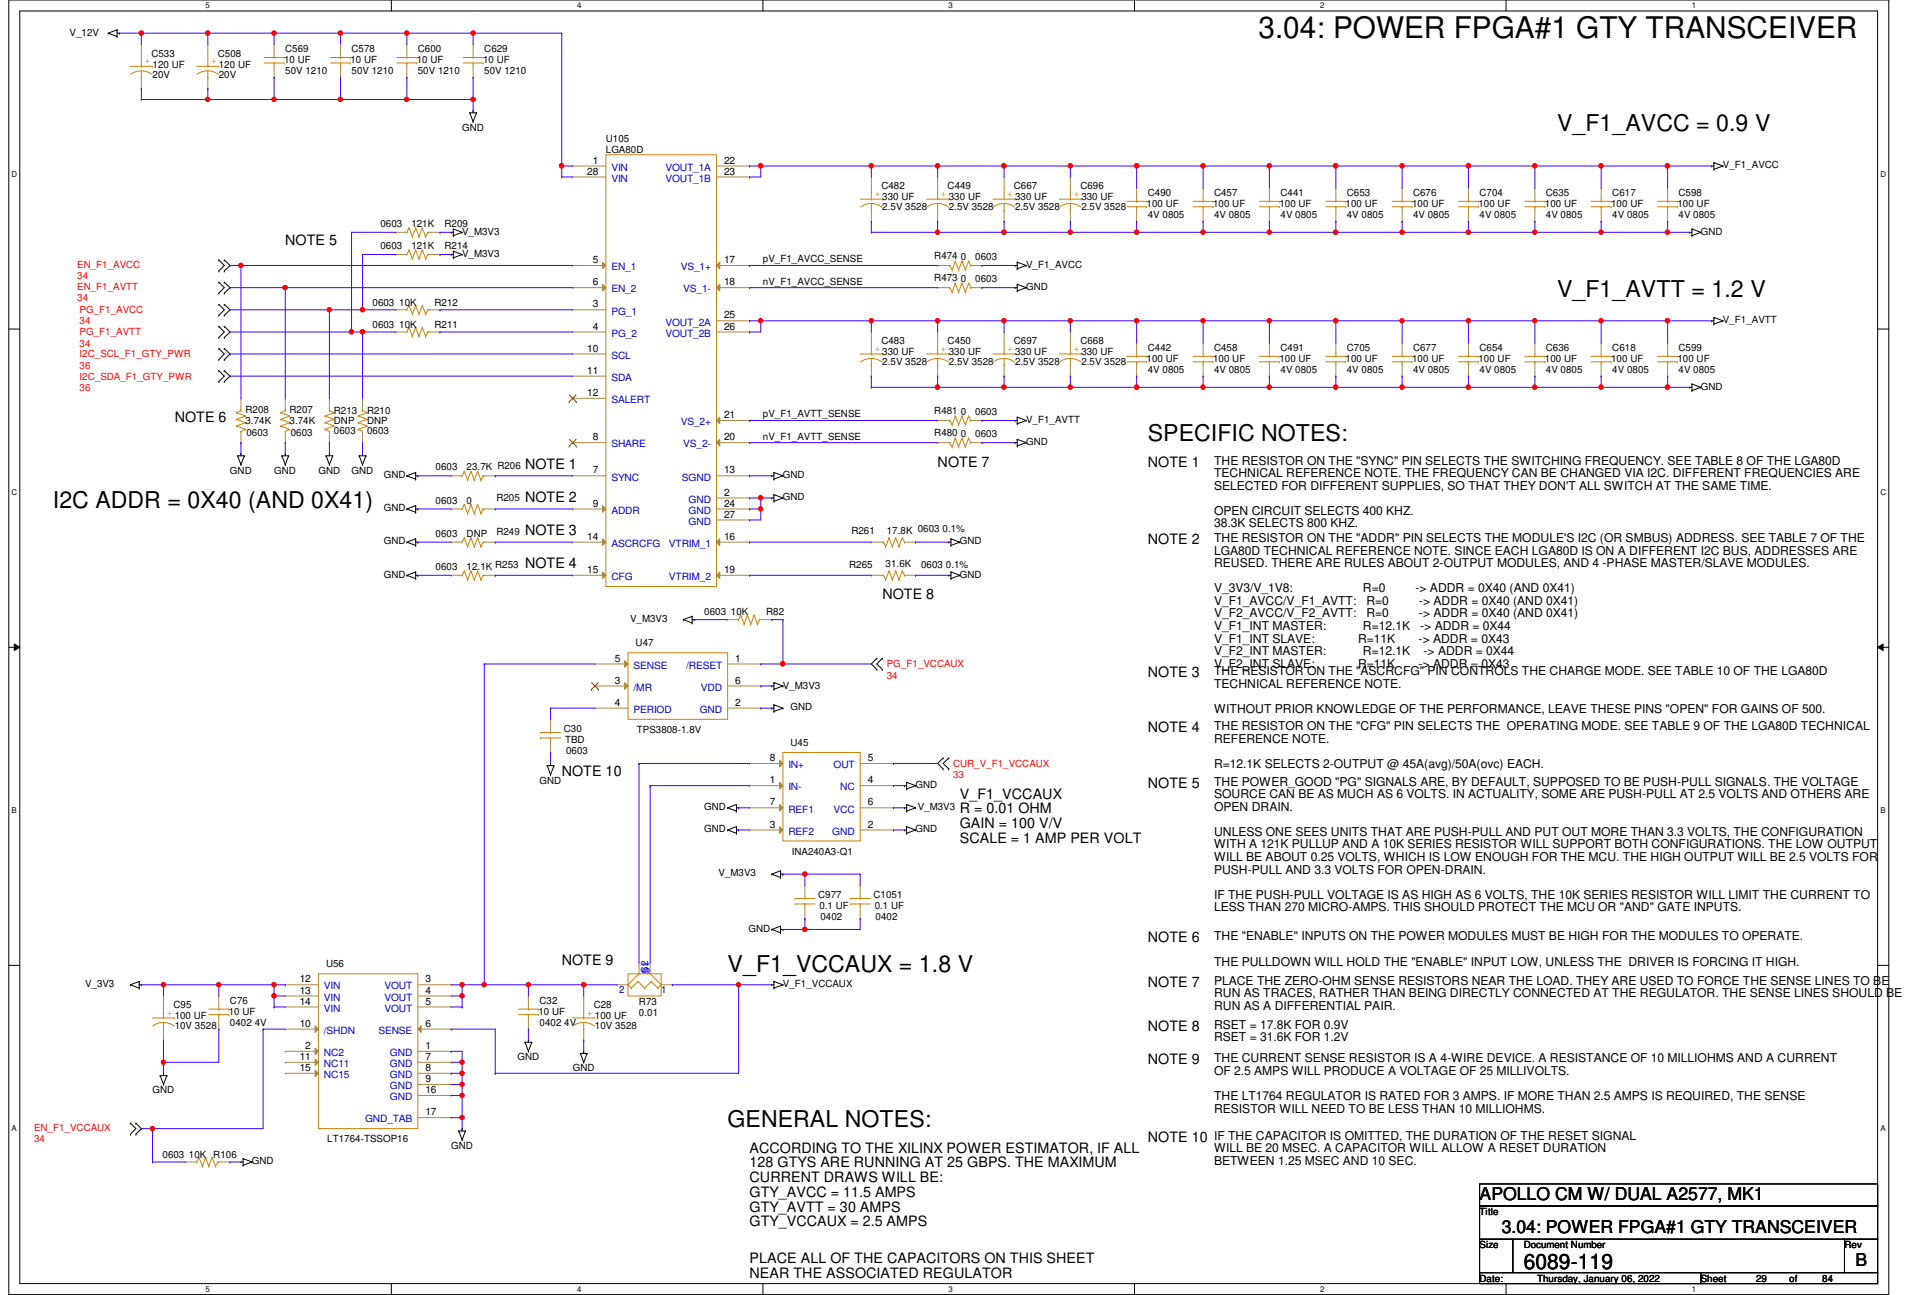
[picture p82: page 29]

3.04: POWER FPGA#1 GTY TRANSCEIVER

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

R=12.1K SELECTS 2-OUTPUT @ 45A(avg)/50A(ovc) EACH.

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

THE "ENABLE" INPUTS ON THE POWER MODULES MUST BE HIGH FOR THE MODULES TO OPERATE.

THE PULLDOWN WILL HOLD THE "ENABLE" INPUT LOW, UNLESS THE DRIVER IS FORCING IT HIGH.
PLACE THE ZERO-OHM SENSE RESISTORS NEAR THE LOAD. THEY ARE USED TO FORCE THE SENSE LINES TO BE
RUN AS TRACES, RATHER THAN BEING DIRECTLY CONNECTED AT THE REGULATOR. THE SENSE LINES SHOULD BE
RUN AS A DIFFERENTIAL PAIR.
RSET = 17.8K FOR 0.9V
RSET = 31.6K FOR 1.2V
THE CURRENT SENSE RESISTOR IS A 4-WIRE DEVICE. A RESISTANCE OF 10 MILLIOHMS AND A CURRENT
OF 2.5 AMPS WILL PRODUCE A VOLTAGE OF 25 MILLIVOLTS.

THE LT1764 REGULATOR IS RATED FOR 3 AMPS. IF MORE THAN 2.5 AMPS IS REQUIRED, THE SENSE

RESISTOR WILL NEED TO BE LESS THAN 10 MILLIOHMS. GENERAL NOTES:

NOTE 10 IF THE CAPACITOR IS OMITTED, THE DURATION OF THE RESET SIGNAL

ACCORDING TO THE XILINX POWER ESTIMATOR, IF ALL
128 GTYS ARE RUNNING AT 25 GBPS. THE MAXIMUM
CURRENT DRAWS WILL BE:
GTY_AVCC = 11.5 AMPS
GTY_AVTT = 30 AMPS
GTY_VCCAUX = 2.5 AMPS

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

PLACE ALL OF THE CAPACITORS ON THIS SHEET
NEAR THE ASSOCIATED REGULATOR

# 3.05: POWER FPGA#2 INTERNAL

## NOTE 5

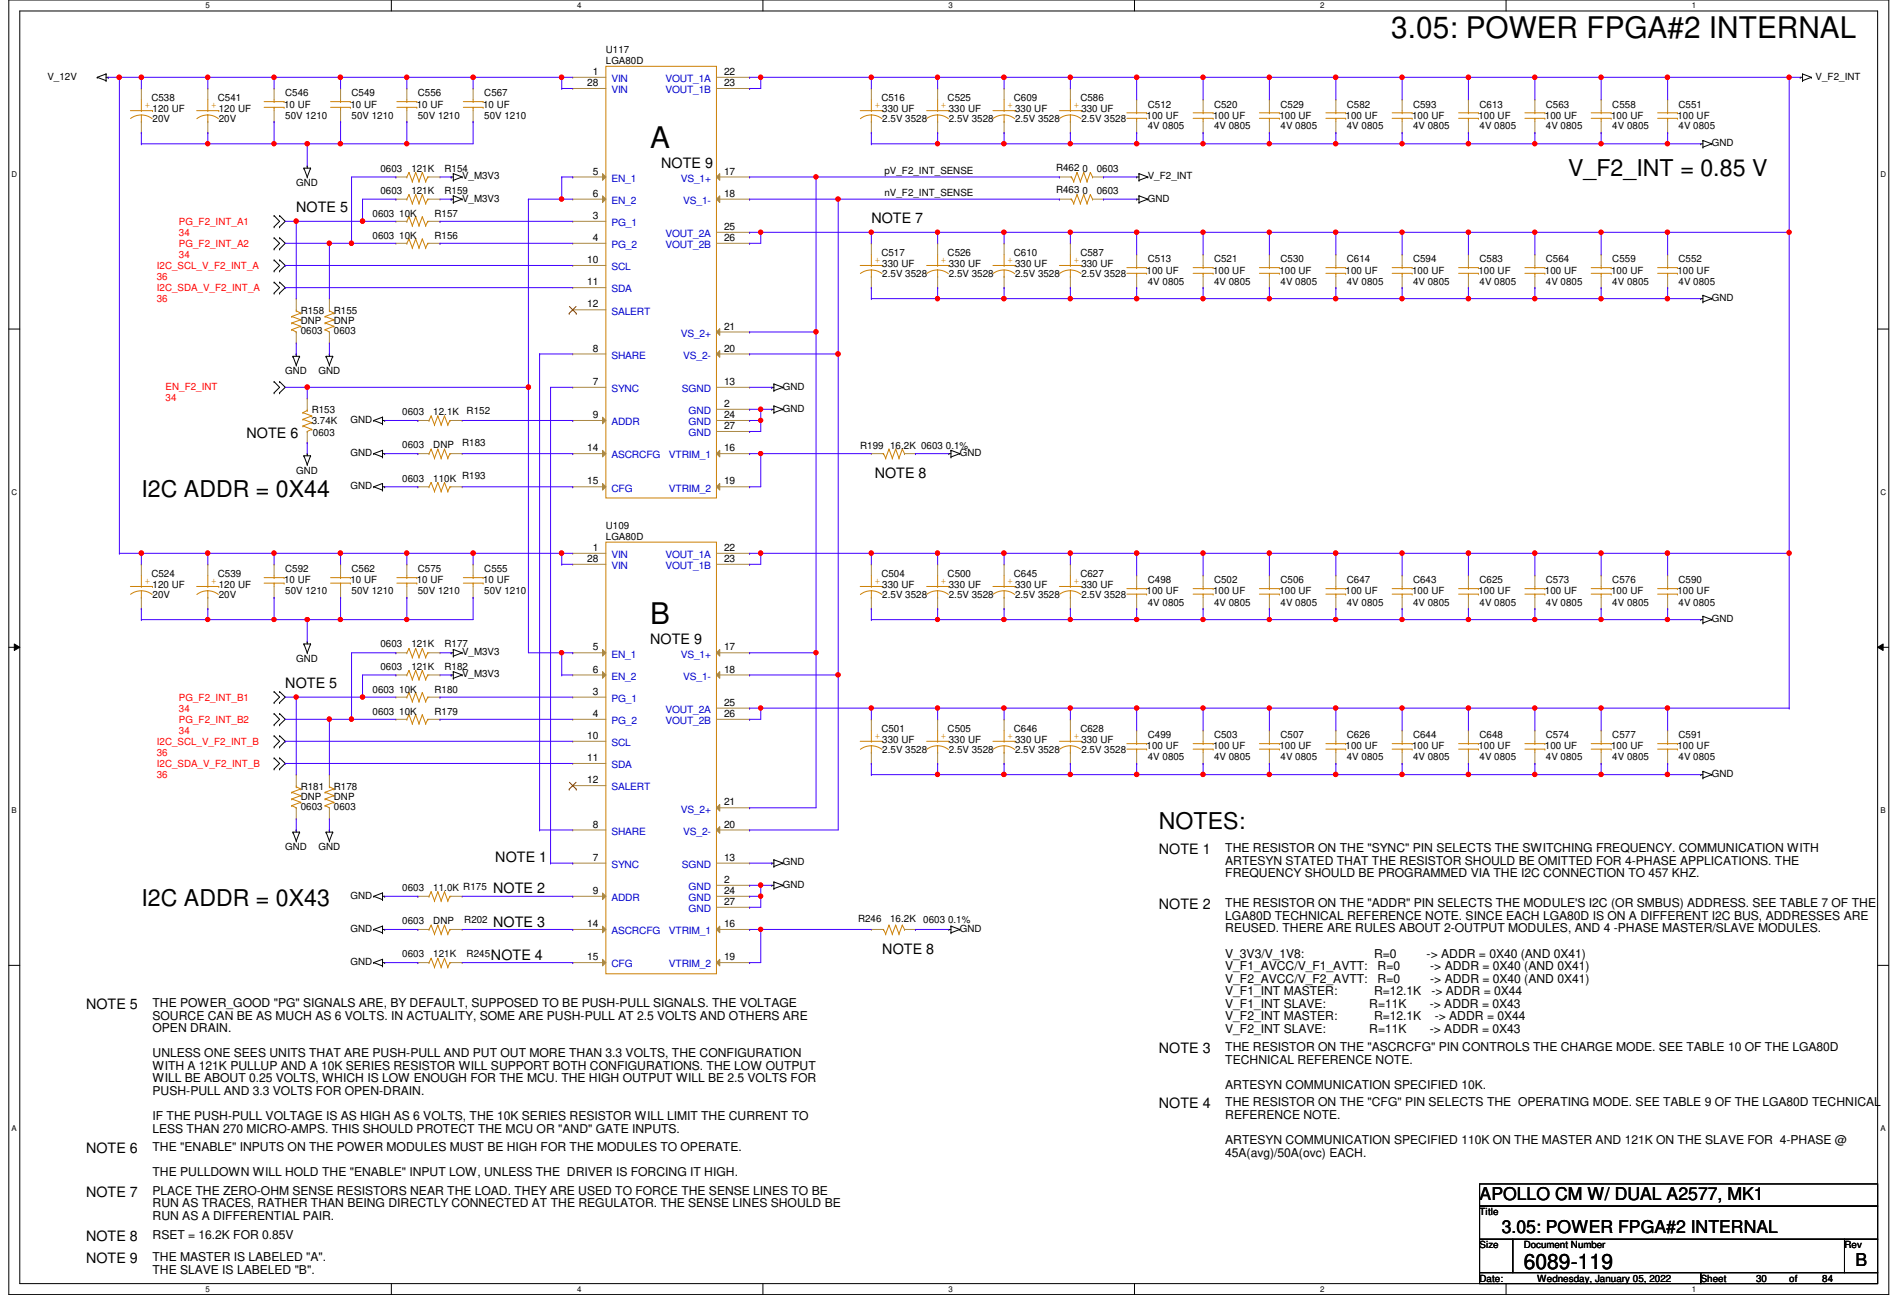
[picture p83: page 30]
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

THE PULLDOWN WILL HOLD THE "ENABLE" INPUT LOW, UNLESS THE DRIVER IS FORCING IT HIGH.

NOTE 7 PLACE THE ZERO-OHM SENSE RESISTORS NEAR THE LOAD. THEY ARE USED TO FORCE THE SENSE LINES TO BE

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

NOTE 9 THE MASTER IS LABELED "A".

THE SLAVE IS LABELED "B".

# 3.06: POWER FPGA#2 GTY TRANSCEIVER
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
