mfkiwl/Cornell_CM_Rev2_HW/PCB_Rev2A/Schematic_6089-119_reva_a2577x2_11July2021.pdf

D | D
C | 9: BETWEEN-FPGA GTY TRANSCEIVERS These are some general signal naming conventions: 1) Signals connected to the FPGAs contain either "F1" or "F2". 2) Signals connected to the Service Module contain "SM". 3) Signals connected to the Front Panel contain "FP". 4) Signal names starting with “PG” are “Power Good” signals from power modules. 5) Signal names starting with “EN” are “Enable” signals to turn on power modules. 6) GTY reference clock names indicate FPGA followed by side (F1L, F1R, | C
B | order (1 thru 7). 7) Power source names start with "V_", then the voltage with the letter "V" as a decimal point. (V_3V3 is a 3.3 volt source) 8) The MCU I/Os are 3.3 volt and the FPGA I/Os are 1.8 volt. Level shifters are used for the conversion. Signal names on the FPGA side are prefaced with "lov" (low voltage) and signals on the MCU side are prefaced with "hiv" (high voltage). | B
| APOLLO CM W/ DUAL A2577, MK1 Title 1.01: NOTES 1.01: NOTES 1.01: NOTES Size Document Number Rev 6089-119 A Date: Tuesday, June 15, 2021 Tuesday, June 15, 2021 Tuesday, June 15, 2021 Sheet 1 1 1 of 84 84 84
A | A

# THIS IS A FLAT SCHEMATIC, NOT A HIERARCHICAL ONE. NETS USE "OFFPAGE CONNECTOR" SYMBOLS TO GO FROM PAGE TO PAGE. ON ANY PAGE, THE NUMBER OF THE CONNECTING PAGE(S) IS SHOWN IN A SMALL NUMBER

BELOW THE SIGNAL NAME.

THE SCHEMATIC IS DIVIDED INTO SECTIONS OF RELATED FUNCTIONALITY.

THE SECTIONS ARE: 1: NOTES AND BLOCK DIAGRAMS 2: OFF-BOARD SIGNALS (SM AND FRONT PANEL), GLOBAL CLOCKING 3: POWER SOURCES AND CONTROLS 4: I2C CONTROLS 5: FPGA#1 POWER AND SIGNAL (NON-MGT) 6: FPGA#2 POWER AND SIGNAL (NON-MGT) 7: FPGA#1 GTY TRANSCEIVERS (MOSTLY FIREFLY) 8: FPGA#2 GTY TRANSCEIVERS (MOSTLY FIREFLY)

# TO DO:

# F2L, F2R), then the reference clock (R0 or R1), finishing with the sequence

# THIS DESIGN INCLUDES FPGA CONFIGURATION MEMORIES. WE SHOULD STILL VERIFY THAT

PROGRAMMING AND BOOTING WORK ON CMv1.

# VERIFY PROPER RESISTOR VALUES FOR ALL LGA80D

CONFIGURATIONS.

# 1.02: BLOCK DIAGRAM

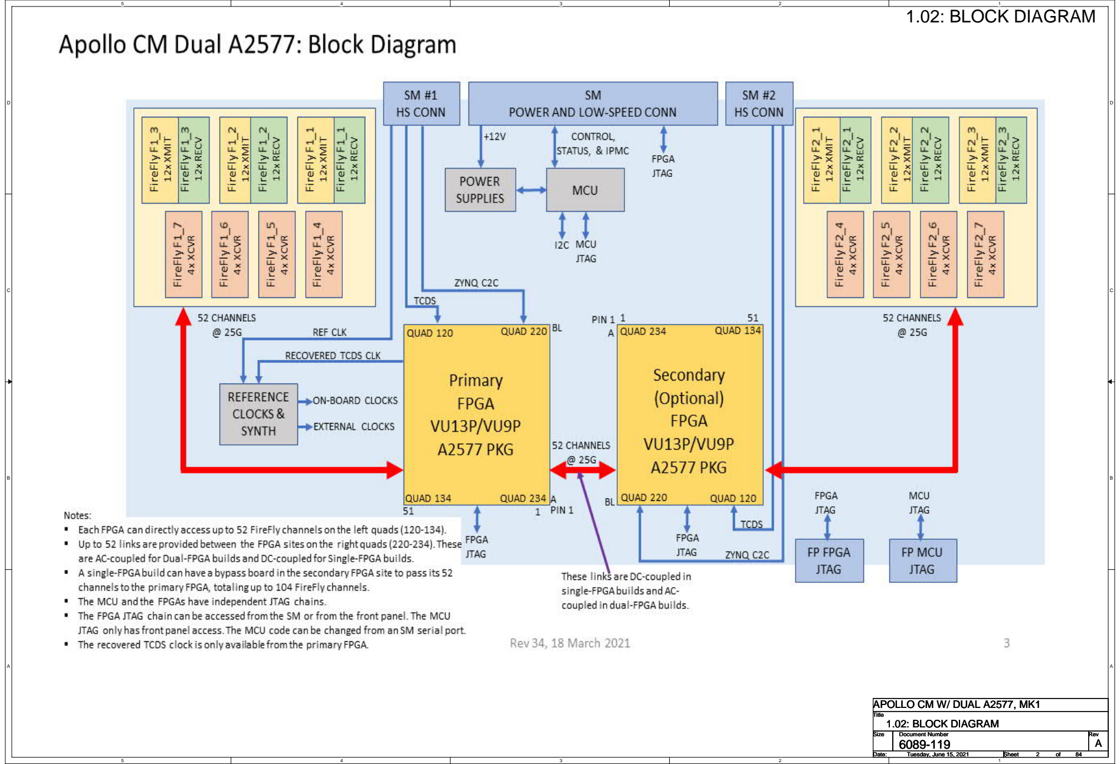
[picture p84: page 2]

1.02: BLOCK DIAGRAM 1.02: BLOCK DIAGRAM 1.02: BLOCK DIAGRAM Tuesday, June 15, 2021 Tuesday, June 15, 2021 Tuesday, June 15, 2021 2 2 2 84 84 84

# 1.03: DUAL VU13P

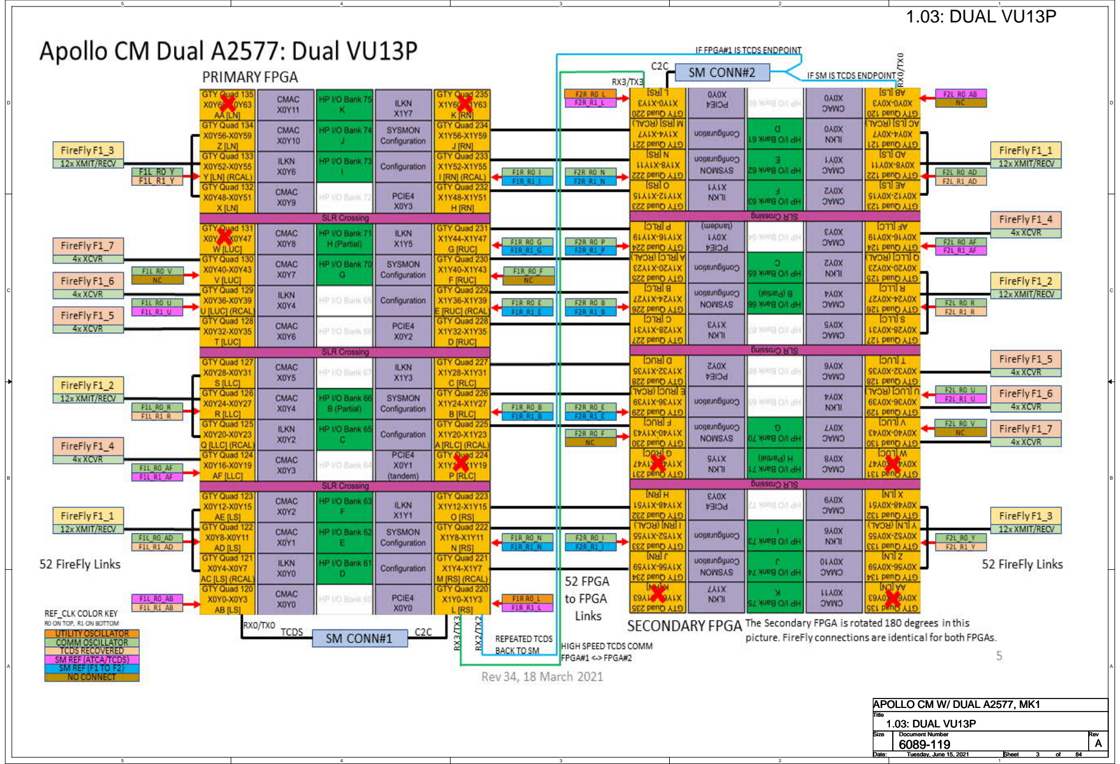
[picture p85: page 3]

1.03: DUAL VU13P 1.03: DUAL VU13P 1.03: DUAL VU13P Tuesday, June 15, 2021 Tuesday, June 15, 2021 Tuesday, June 15, 2021 3 3 3 84 84 84

# 1.04: SINGLE VU13P AND JUMPER

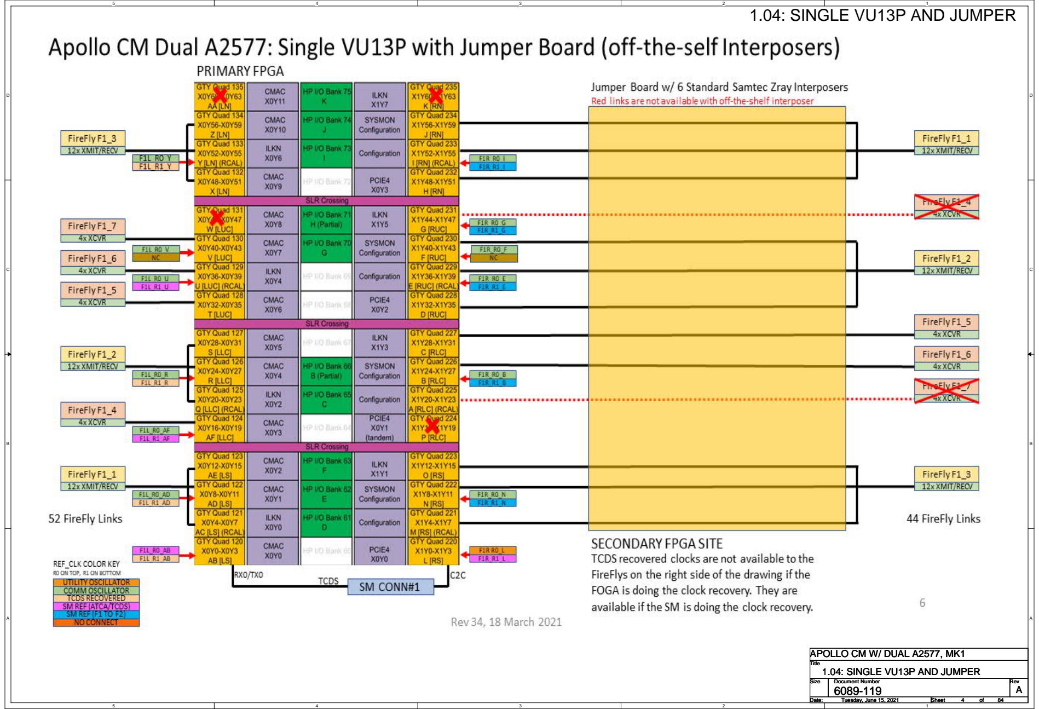
[picture p86: page 4]

1.04: SINGLE VU13P AND JUMPER 1.04: SINGLE VU13P AND JUMPER 1.04: SINGLE VU13P AND JUMPER Tuesday, June 15, 2021 Tuesday, June 15, 2021 Tuesday, June 15, 2021 4 4 4 84 84 84

# 1.05: SINGLE VU13P

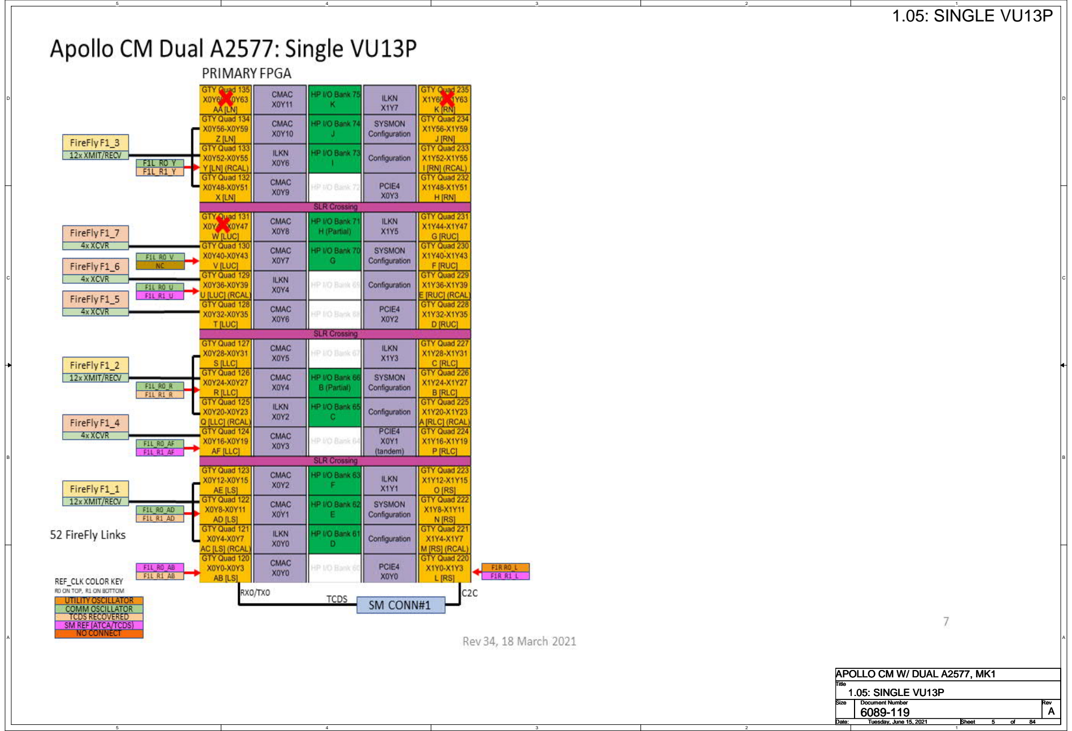
[picture p87: page 5]

1.05: SINGLE VU13P 1.05: SINGLE VU13P 1.05: SINGLE VU13P Tuesday, June 15, 2021 Tuesday, June 15, 2021 Tuesday, June 15, 2021 5 5 5 84 84 84

# 1.06: DUAL VU9P

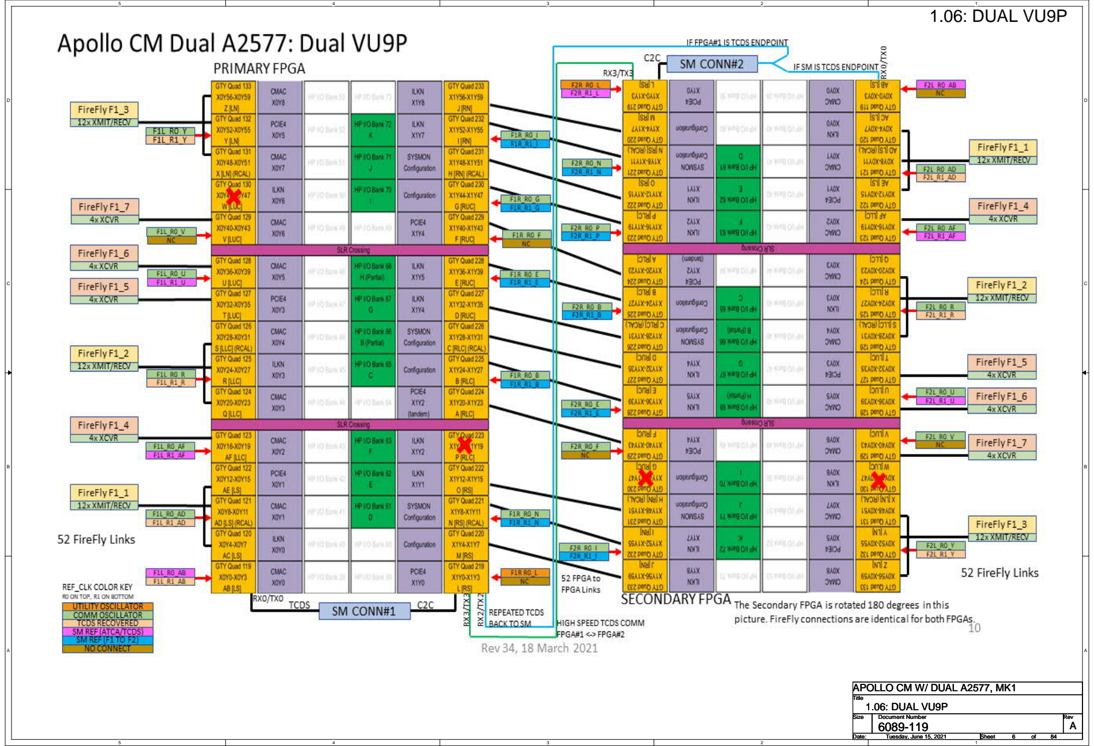
[picture p88: page 6]

1.06: DUAL VU9P 1.06: DUAL VU9P 1.06: DUAL VU9P Tuesday, June 15, 2021 Tuesday, June 15, 2021 Tuesday, June 15, 2021 6 6 6 84 84 84

# 1.07: SIX 10X20 INTERPOSERS

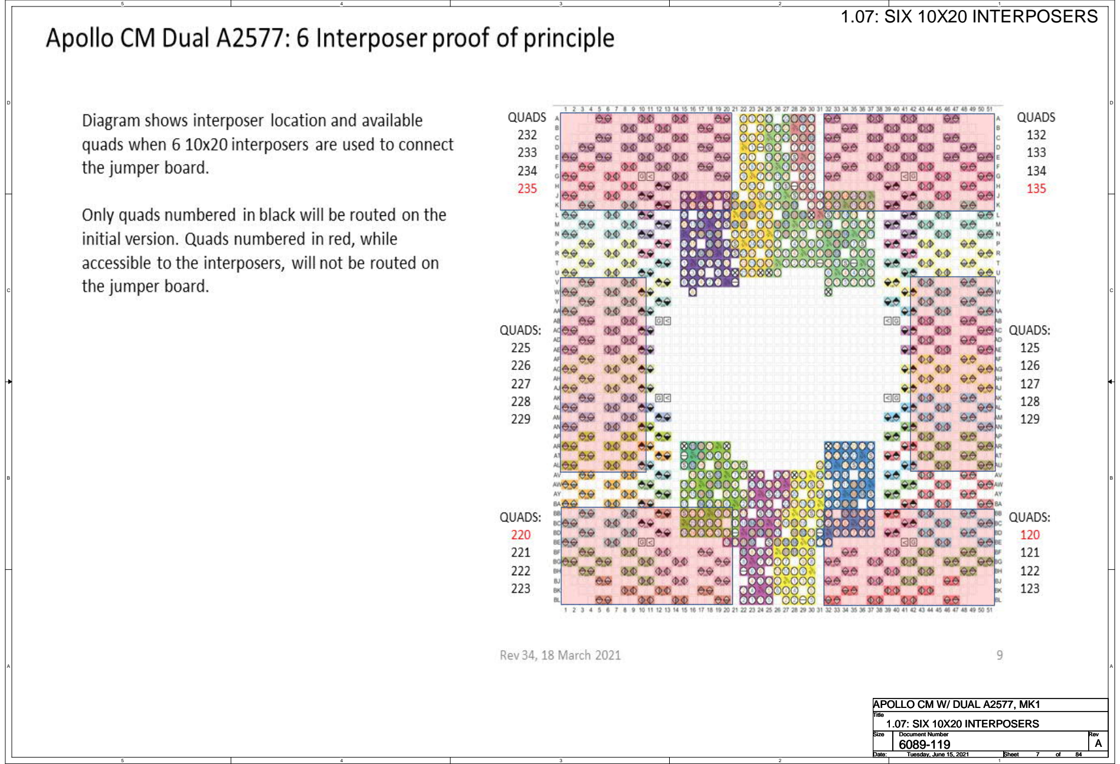
[picture p89: page 7]

1.07: SIX 10X20 INTERPOSERS 1.07: SIX 10X20 INTERPOSERS 1.07: SIX 10X20 INTERPOSERS Tuesday, June 15, 2021 Tuesday, June 15, 2021 Tuesday, June 15, 2021 7 7 7 84 84 84

# 1.08: POWER

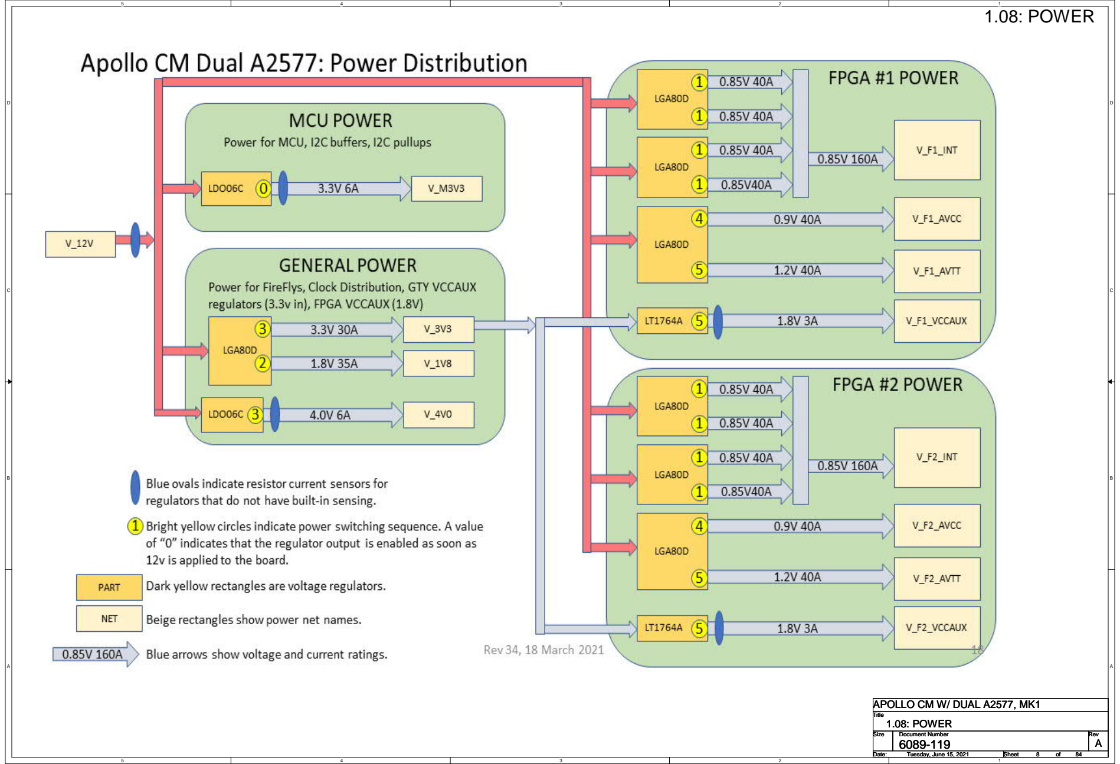
[picture p90: page 8]

1.08: POWER 1.08: POWER 1.08: POWER Tuesday, June 15, 2021 Tuesday, June 15, 2021 Tuesday, June 15, 2021 8 8 8 84 84 84

# 1.09: ON-BOARD OSCILLATOR CLOCKS

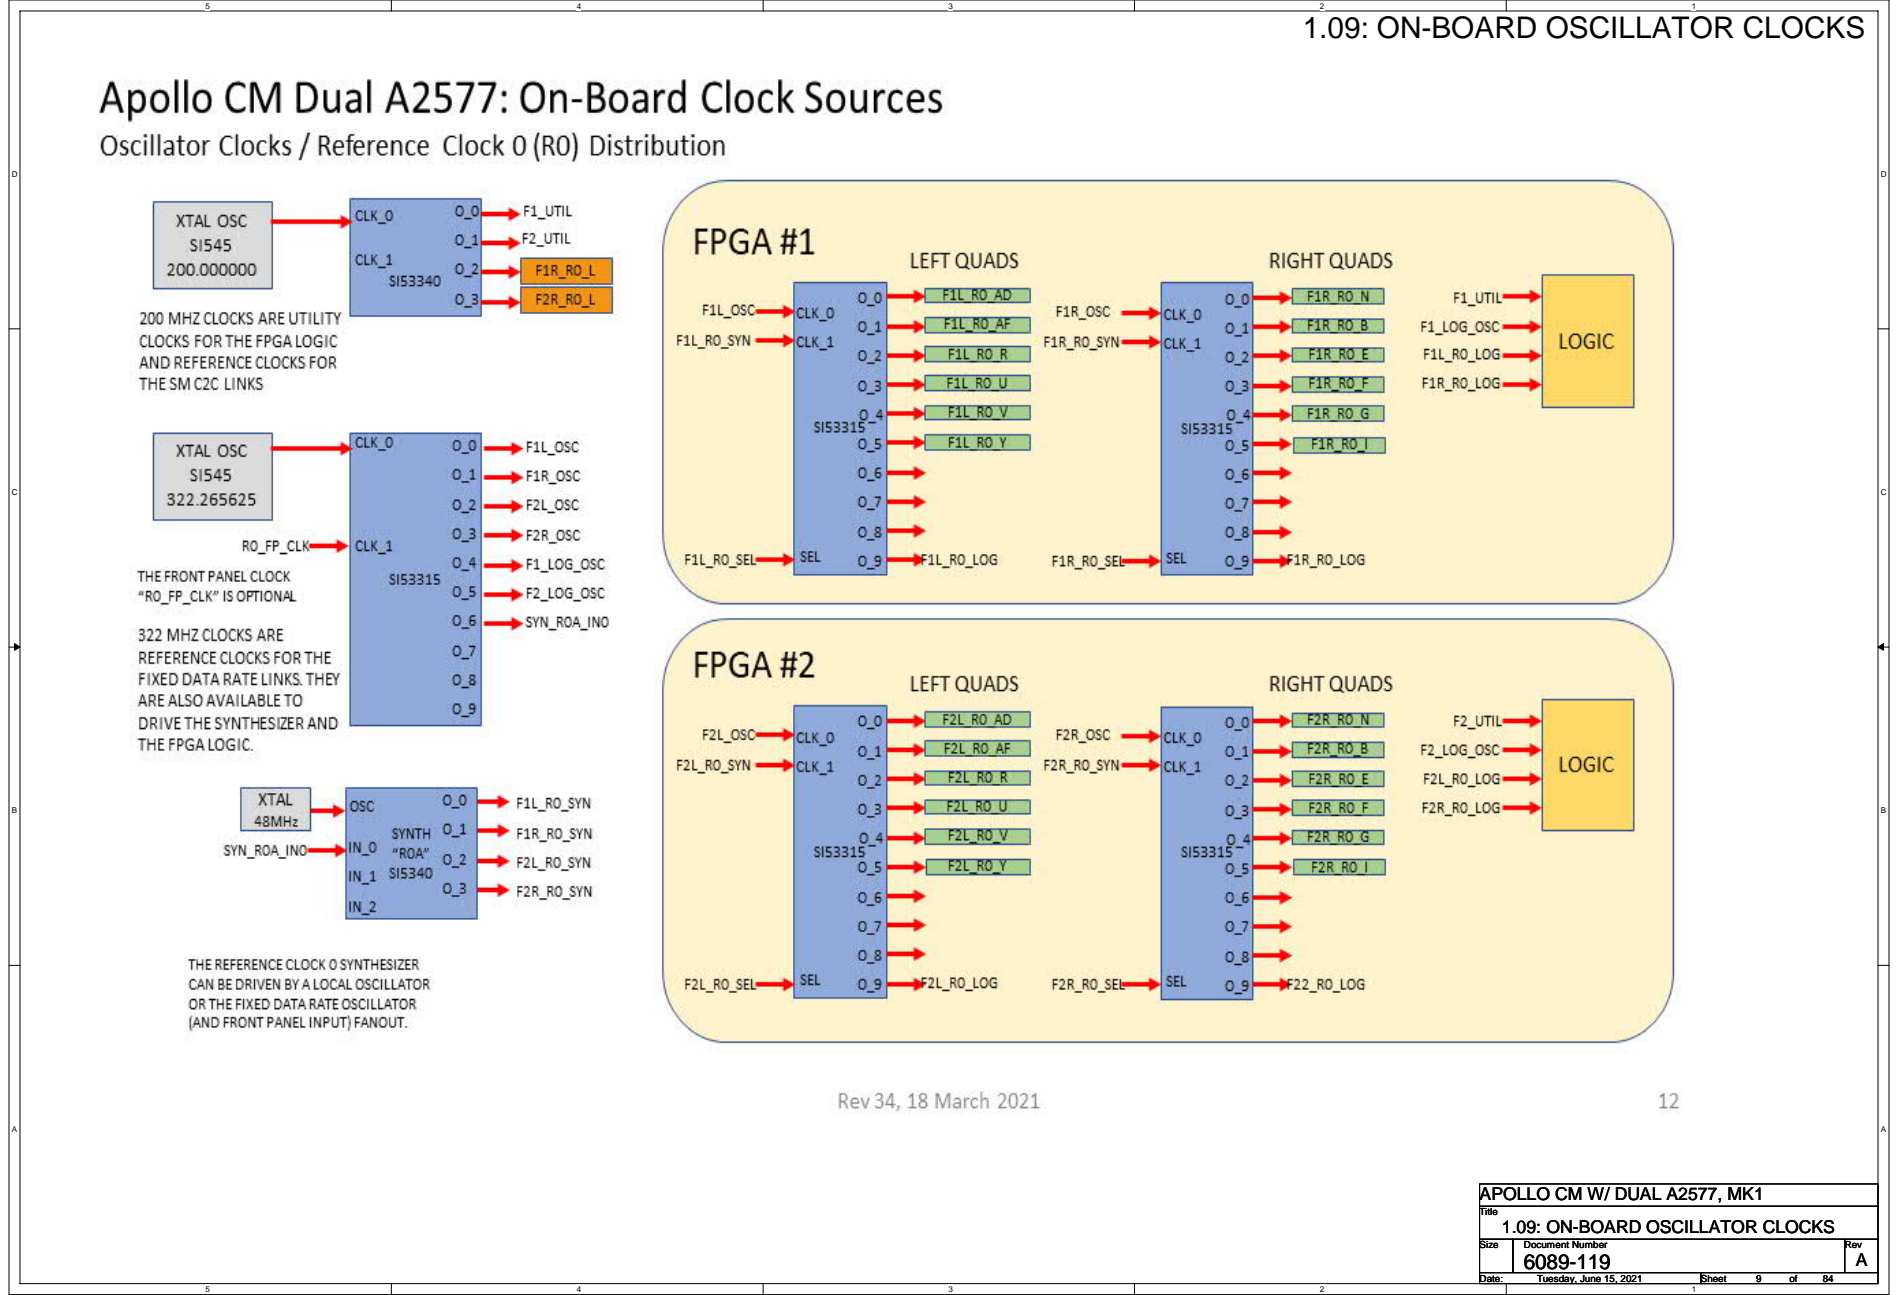
[picture p91: page 9]

1.09: ON-BOARD OSCILLATOR CLOCKS 1.09: ON-BOARD OSCILLATOR CLOCKS 1.09: ON-BOARD OSCILLATOR CLOCKS Tuesday, June 15, 2021 Tuesday, June 15, 2021 Tuesday, June 15, 2021 9 9 9 84 84 84

# 1.10: EXTERNAL CLOCKS

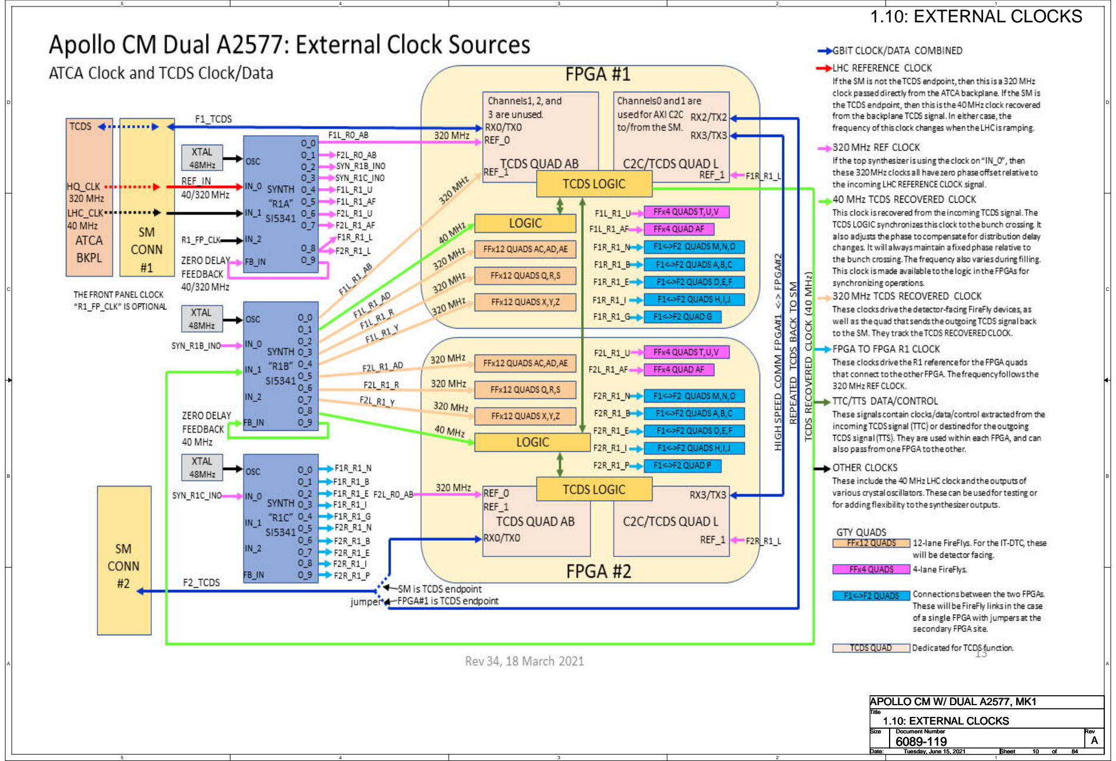
[picture p92: page 10]

1.10: EXTERNAL CLOCKS 1.10: EXTERNAL CLOCKS 1.10: EXTERNAL CLOCKS Tuesday, June 15, 2021 Tuesday, June 15, 2021 Tuesday, June 15, 2021 10 10 10 84 84 84

# 1.11: TCDS SIMPLIFIED

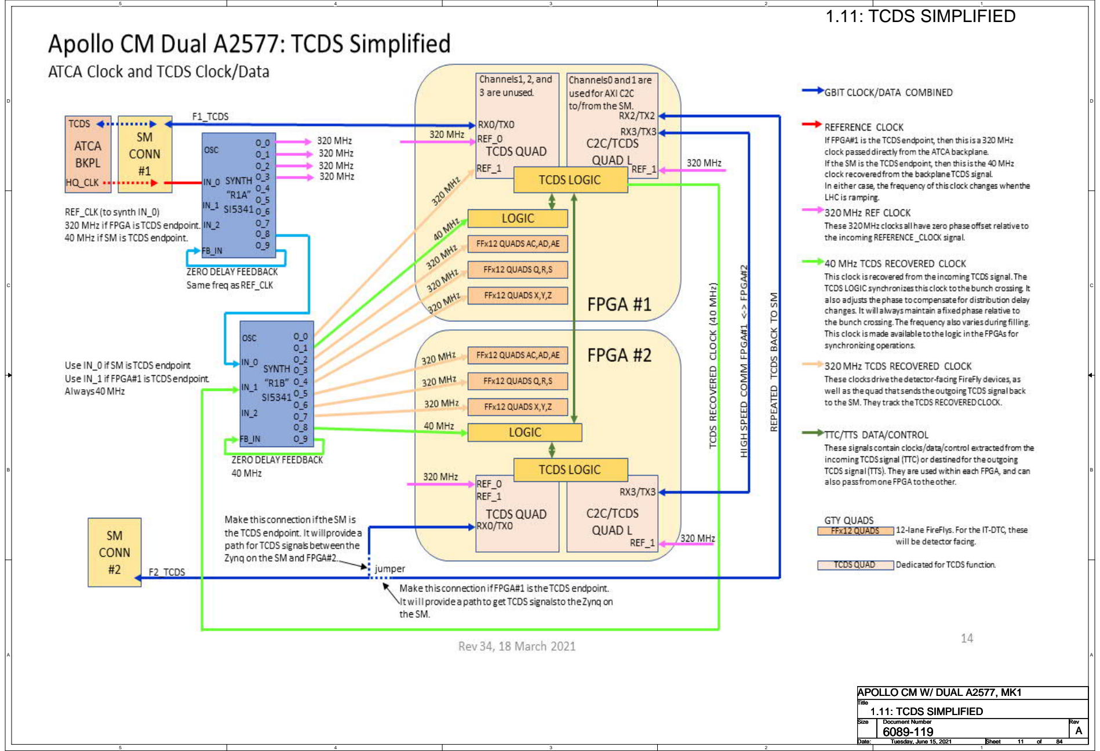
[picture p93: page 11]

1.11: TCDS SIMPLIFIED 1.11: TCDS SIMPLIFIED 1.11: TCDS SIMPLIFIED Tuesday, June 15, 2021 Tuesday, June 15, 2021 Tuesday, June 15, 2021 11 11 11 84 84 84

# 1.12: MCU I/O AND INTERNALS

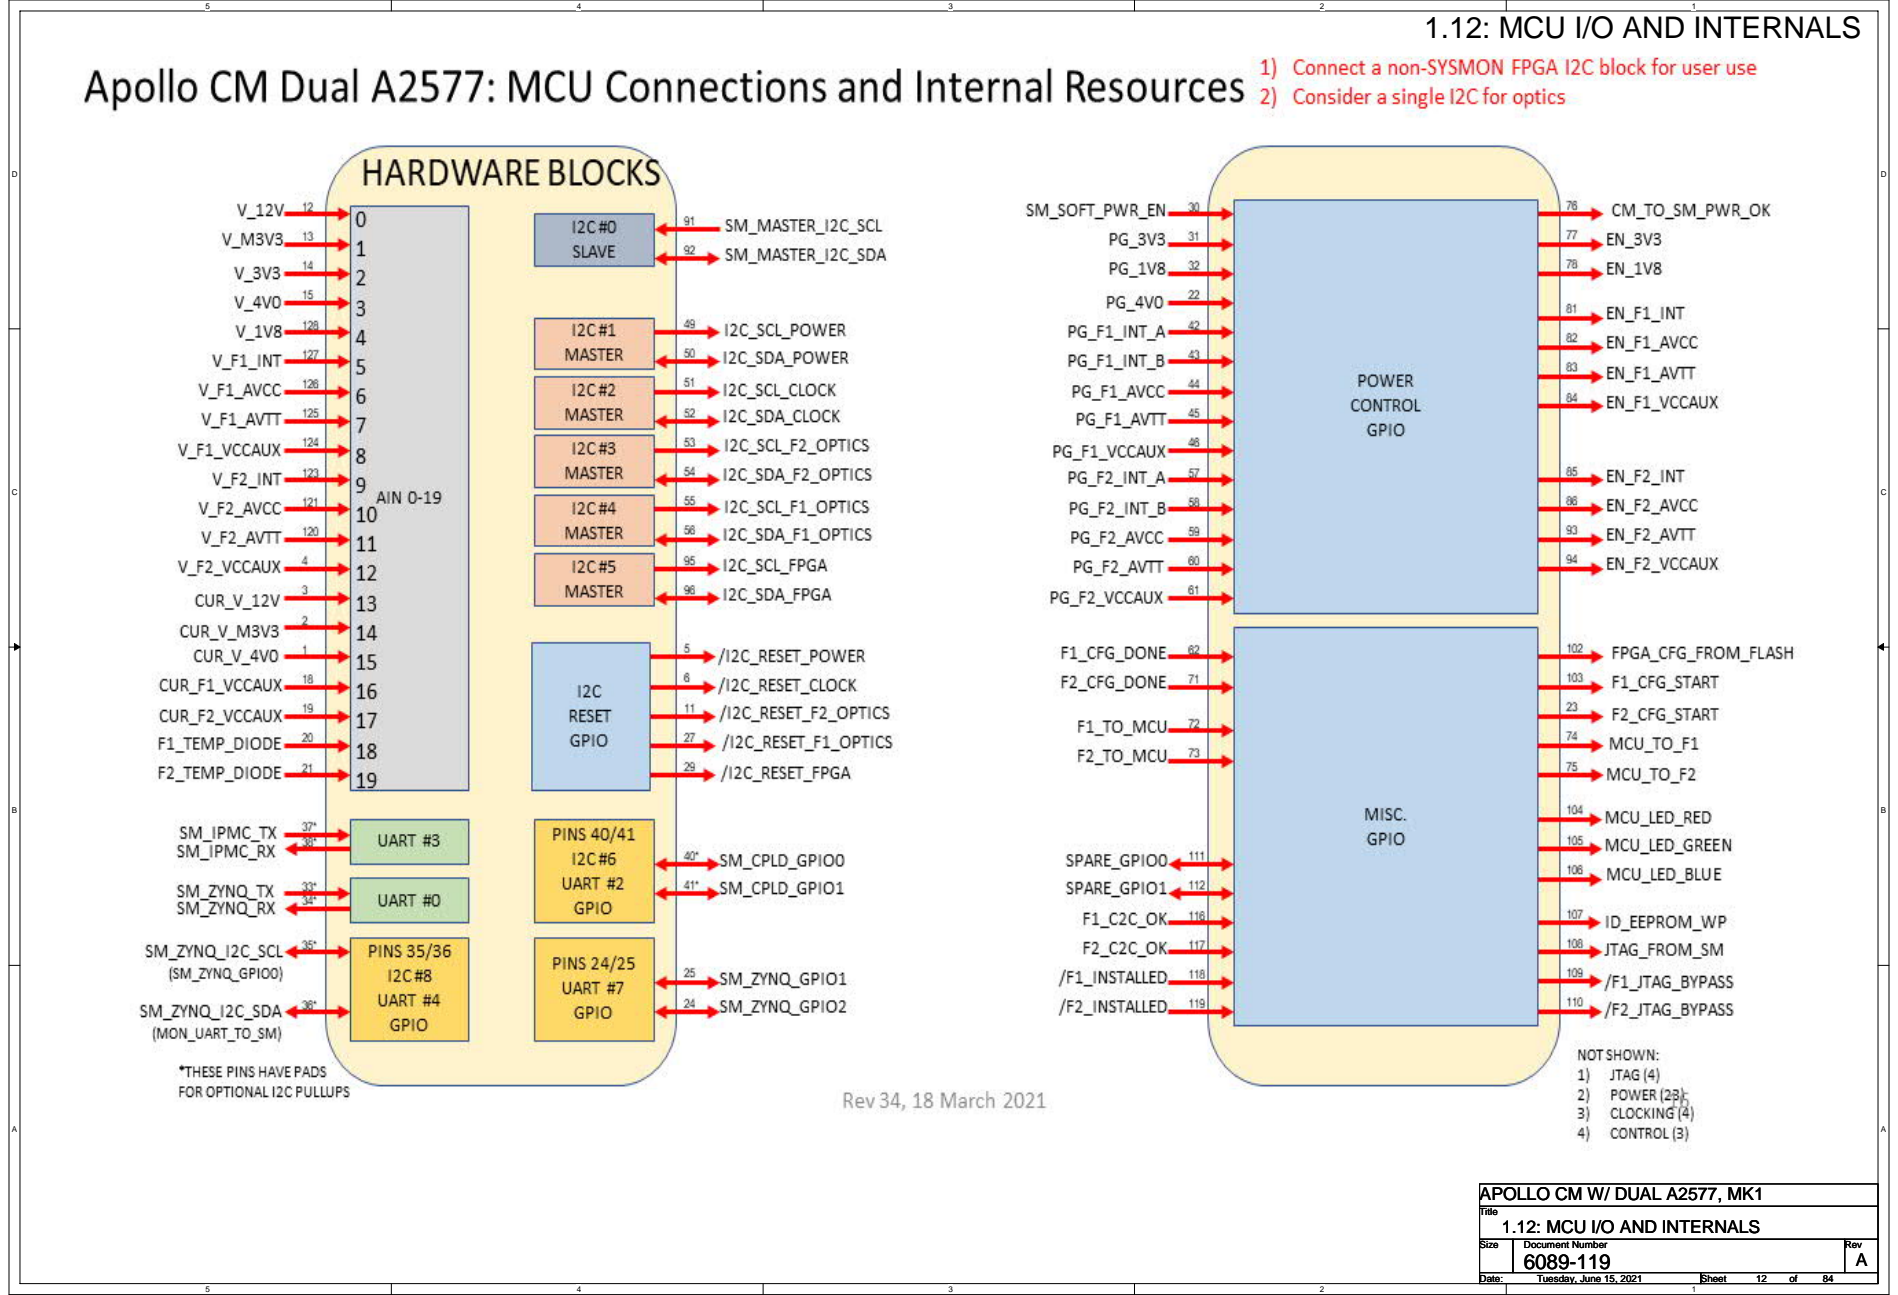
[picture p94: page 12]

1.12: MCU I/O AND INTERNALS 1.12: MCU I/O AND INTERNALS 1.12: MCU I/O AND INTERNALS Tuesday, June 15, 2021 Tuesday, June 15, 2021 Tuesday, June 15, 2021 12 12 12 84 84 84

R1 LED GREEN D4 | 2.01: SM POWER AND CONTROL CONNECTOR I2C0 IS A SLAVE INTERFACE. IT IS CONNECTED TO THE IPMC ON THE SM.

## THE CURRENT SENSE RESISTOR IS A 4-WIRE DEVICE. A

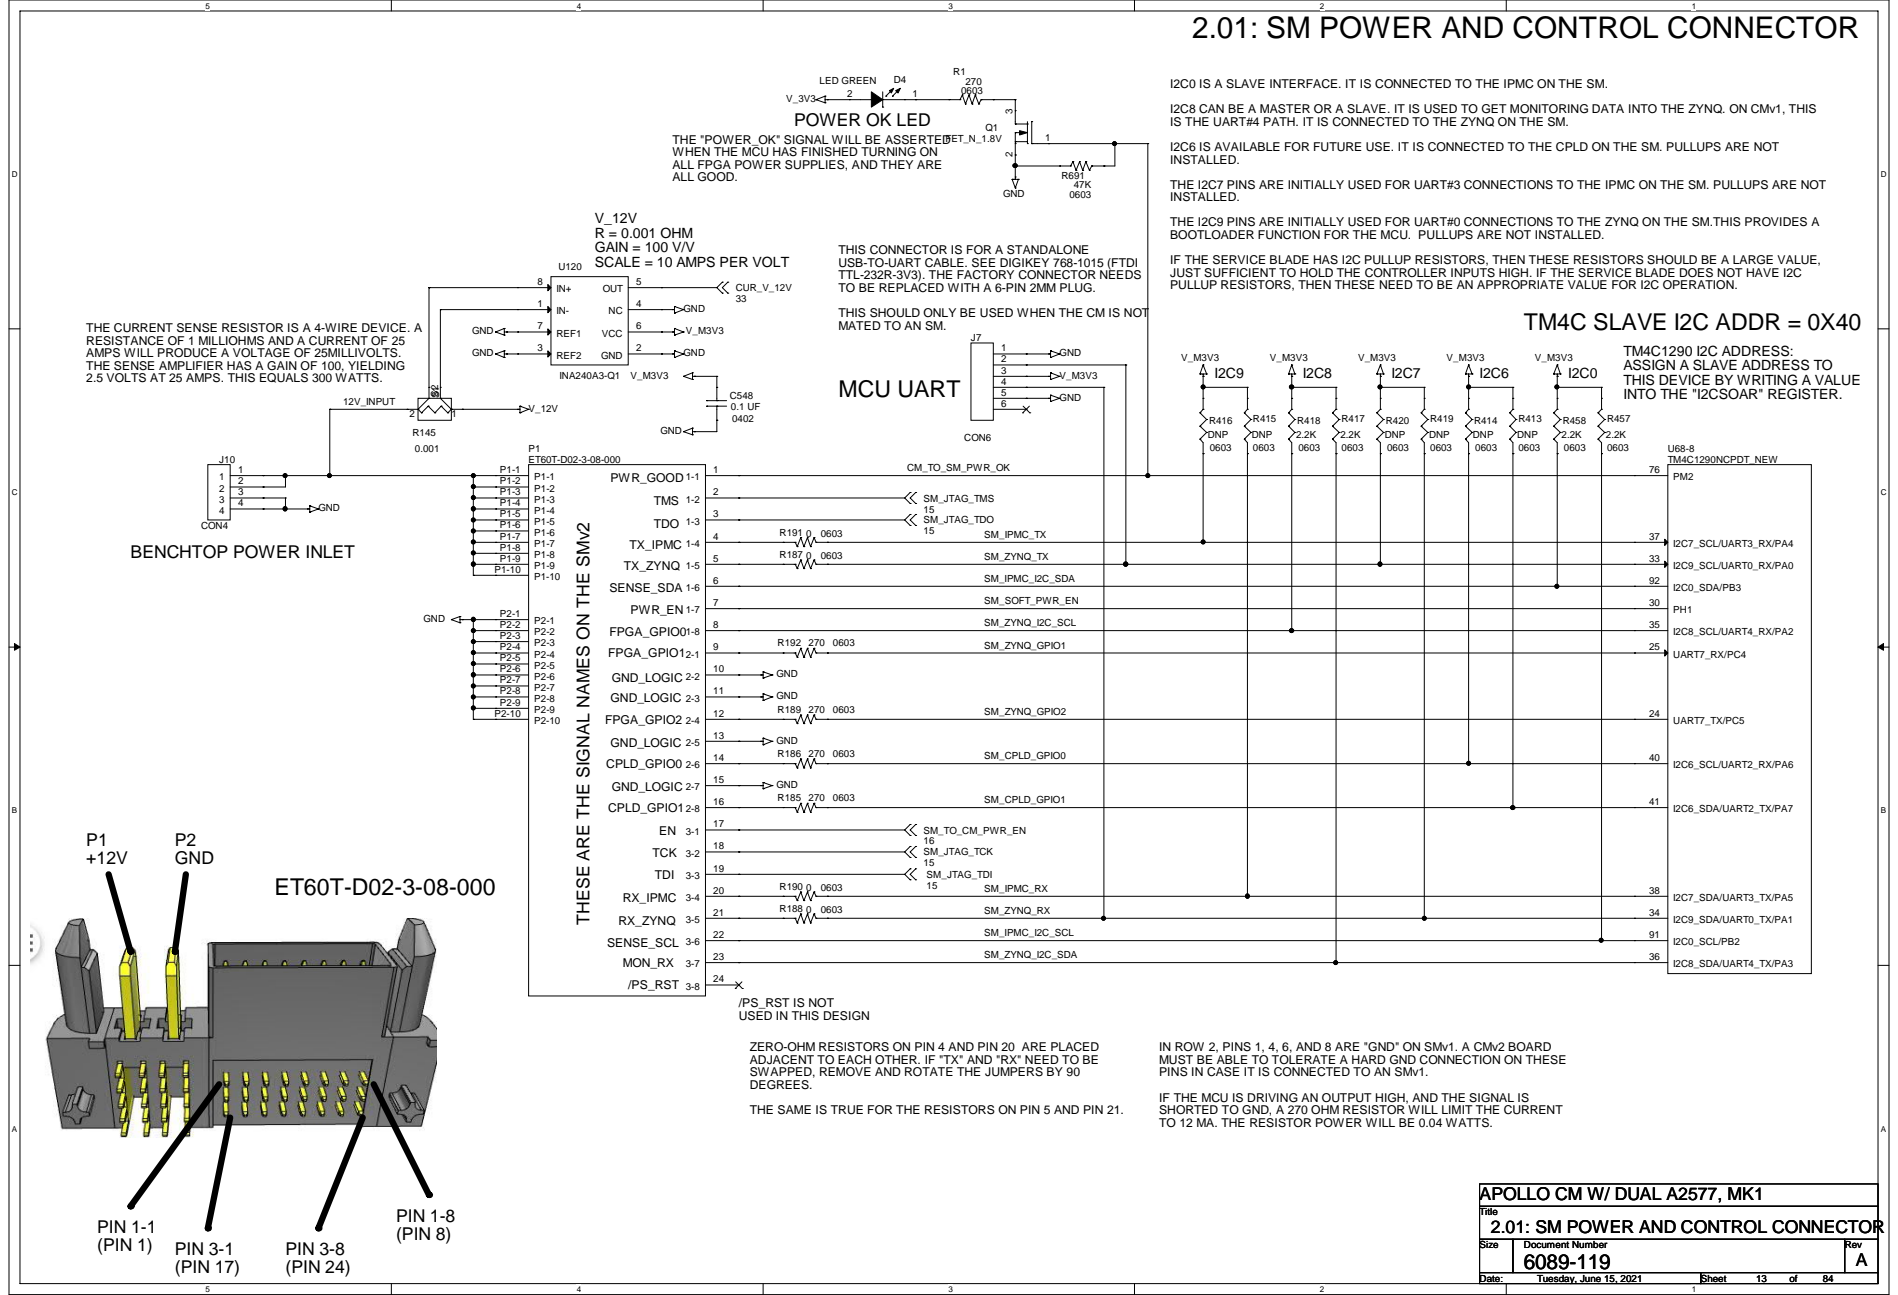
[picture p95: page 13]

I2C8 CAN BE A MASTER OR A SLAVE. IT IS USED TO GET MONITORING DATA INTO THE ZYNQ. ON CMv1, THIS
IS THE UART#4 PATH. IT IS CONNECTED TO THE ZYNQ ON THE SM.
I2C6 IS AVAILABLE FOR FUTURE USE. IT IS CONNECTED TO THE CPLD ON THE SM. PULLUPS ARE NOT
INSTALLED.
THE I2C7 PINS ARE INITIALLY USED FOR UART#3 CONNECTIONS TO THE IPMC ON THE SM. PULLUPS ARE NOT
THE I2C9 PINS ARE INITIALLY USED FOR UART#0 CONNECTIONS TO THE ZYNQ ON THE SM.THIS PROVIDES A
BOOTLOADER FUNCTION FOR THE MCU. PULLUPS ARE NOT INSTALLED.
IF THE SERVICE BLADE HAS I2C PULLUP RESISTORS, THEN THESE RESISTORS SHOULD BE A LARGE VALUE,
JUST SUFFICIENT TO HOLD THE CONTROLLER INPUTS HIGH. IF THE SERVICE BLADE DOES NOT HAVE I2C
PULLUP RESISTORS, THEN THESE NEED TO BE AN APPROPRIATE VALUE FOR I2C OPERATION.

THE "POWER_OK" SIGNAL WILL BE ASSERTED
WHEN THE MCU HAS FINISHED TURNING ON
ALL FPGA POWER SUPPLIES, AND THEY ARE
ALL GOOD.

THIS CONNECTOR IS FOR A STANDALONE
USB-TO-UART CABLE. SEE DIGIKEY 768-1015 (FTDI
TTL-232R-3V3). THE FACTORY CONNECTOR NEEDS
TO BE REPLACED WITH A 6-PIN 2MM PLUG.
THIS SHOULD ONLY BE USED WHEN THE CM IS NOT
MATED TO AN SM.

RESISTANCE OF 1 MILLIOHMS AND A CURRENT OF 25
AMPS WILL PRODUCE A VOLTAGE OF 25MILLIVOLTS.
THE SENSE AMPLIFIER HAS A GAIN OF 100, YIELDING
2.5 VOLTS AT 25 AMPS. THIS EQUALS 300 WATTS.

TM4C1290 I2C ADDRESS:
ASSIGN A SLAVE ADDRESS TO
THIS DEVICE BY WRITING A VALUE
INTO THE "I2CSOAR" REGISTER.

THESE ARE THE SIGNAL NAMES ON THE SMv2

/PS_RST IS NOT
USED IN THIS DESIGN

ZERO-OHM RESISTORS ON PIN 4 AND PIN 20 ARE PLACED
ADJACENT TO EACH OTHER. IF "TX" AND "RX" NEED TO BE
SWAPPED, REMOVE AND ROTATE THE JUMPERS BY 90
DEGREES.
THE SAME IS TRUE FOR THE RESISTORS ON PIN 5 AND PIN 21.

IN ROW 2, PINS 1, 4, 6, AND 8 ARE "GND" ON SMv1. A CMv2 BOARD
MUST BE ABLE TO TOLERATE A HARD GND CONNECTION ON THESE
PINS IN CASE IT IS CONNECTED TO AN SMv1.
IF THE MCU IS DRIVING AN OUTPUT HIGH, AND THE SIGNAL IS
SHORTED TO GND, A 270 OHM RESISTOR WILL LIMIT THE CURRENT
TO 12 MA. THE RESISTOR POWER WILL BE 0.04 WATTS.

2.01: SM POWER AND CONTROL CONNECTOR

## TX1-P

## TX1-N

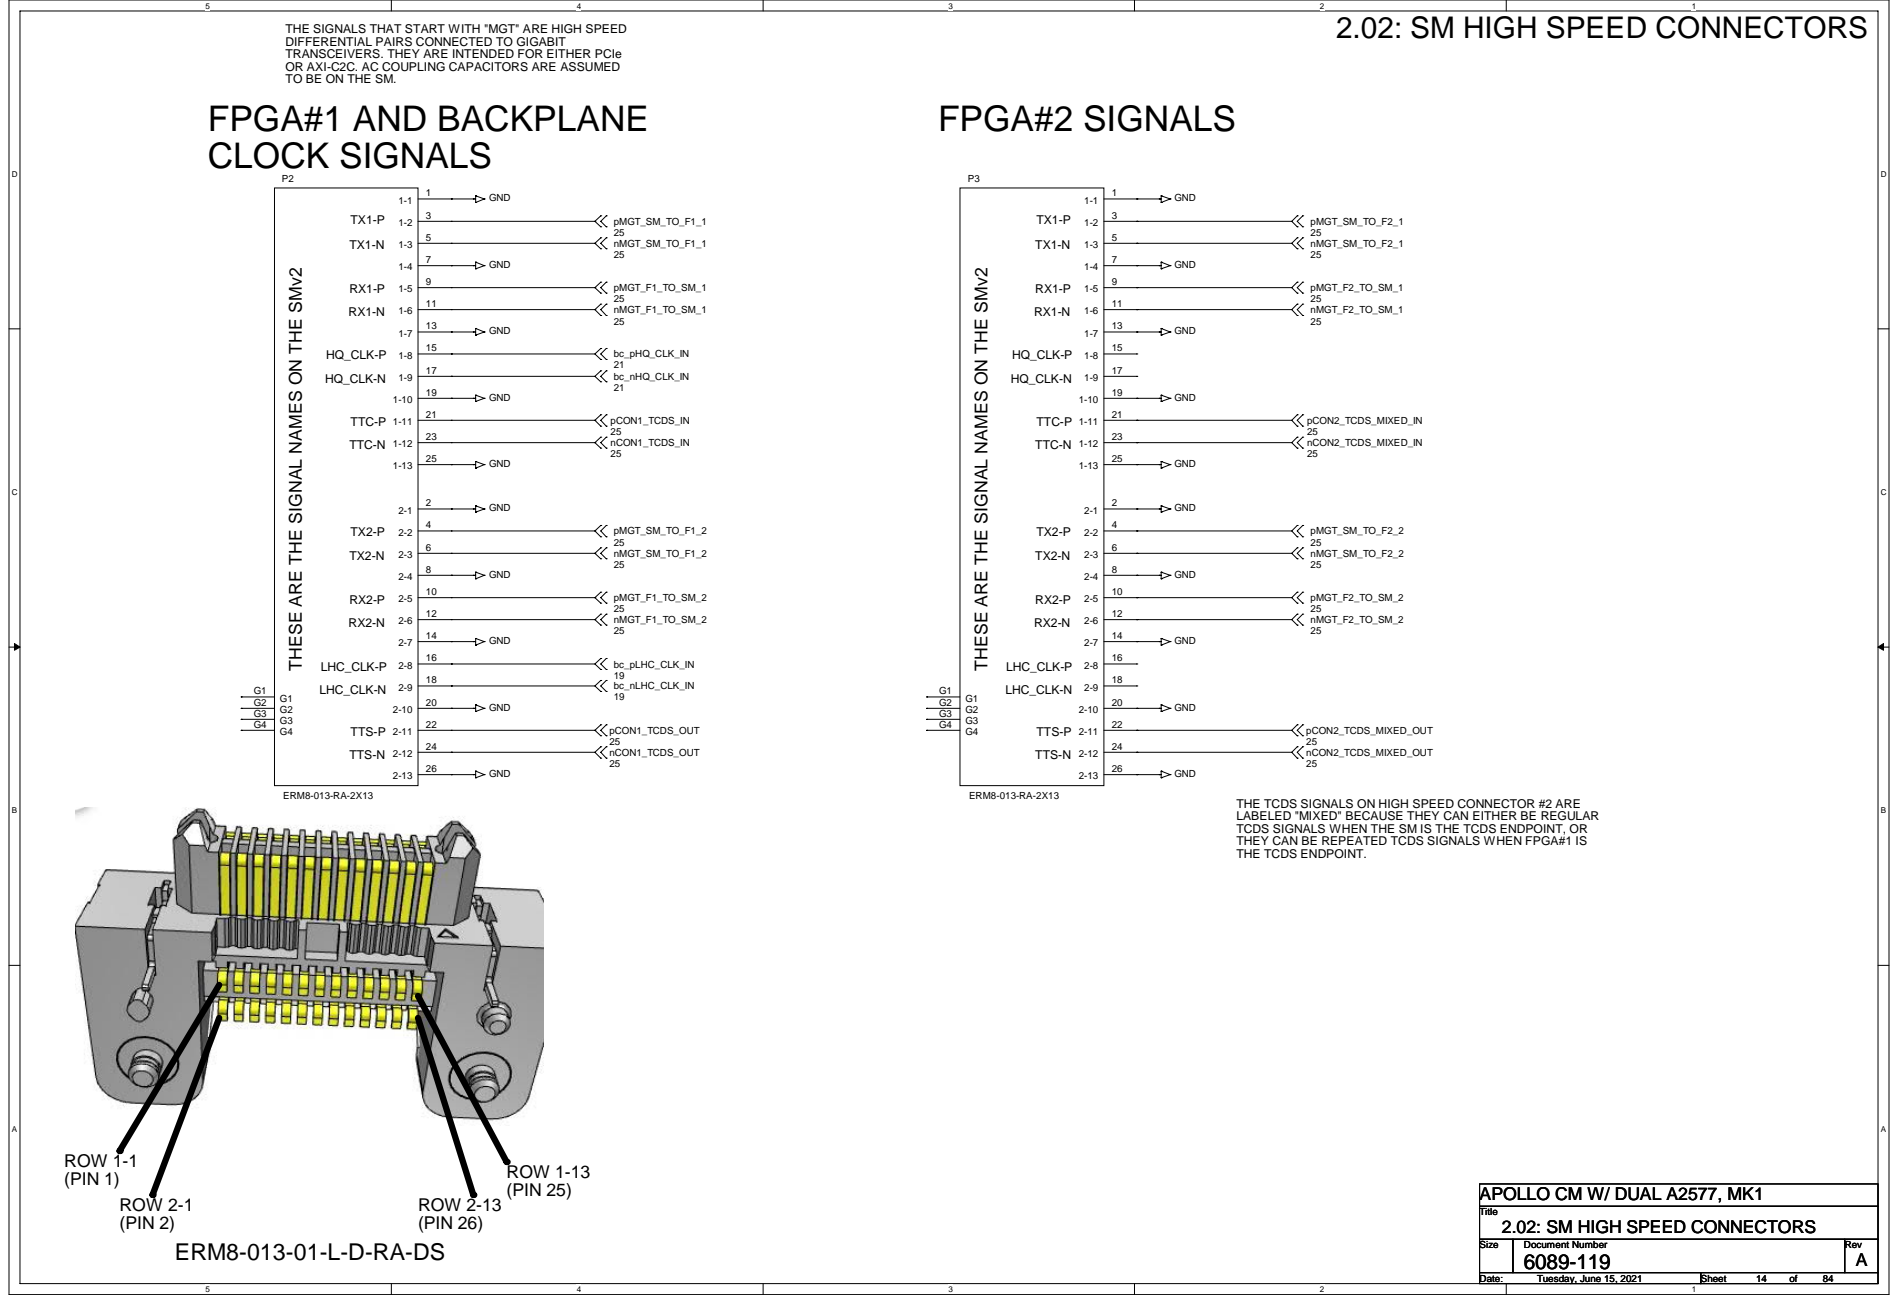
[picture p96: page 14]
HQ_CLK-P; HQ_CLK-N; TTC-P; TTC-N; FPGA#2 SIGNALS; GND; bc_pHQ_CLK_IN 21 bc_nHQ_CLK_IN 21; pMGT_SM_TO_F1_1 25 nMGT_SM_TO_F1_1 25; pMGT_F1_TO_SM_1 25 nMGT_F1_TO_SM_1 25; pMGT_SM_TO_F1_2 25 nMGT_SM_TO_F1_2 25; pMGT_F1_TO_SM_2 25 nMGT_F1_TO_SM_2 25; pMGT_SM_TO_F2_1 25 nMGT_SM_TO_F2_1 25; pMGT_F2_TO_SM_1 25 nMGT_F2_TO_SM_1 25; pMGT_SM_TO_F2_2 25 nMGT_SM_TO_F2_2 25; pMGT_F2_TO_SM_2 25 nMGT_F2_TO_SM_2 25; pCON2_TCDS_MIXED_IN 25 nCON2_TCDS_MIXED_IN 25; pCON1_TCDS_IN 25 nCON1_TCDS_IN 25

2.02: SM HIGH SPEED CONNECTORS

THE SIGNALS THAT START WITH "MGT" ARE HIGH SPEED
DIFFERENTIAL PAIRS CONNECTED TO GIGABIT
TRANSCEIVERS. THEY ARE INTENDED FOR EITHER PCIe
OR AXI-C2C. AC COUPLING CAPACITORS ARE ASSUMED
TO BE ON THE SM.
FPGA#1 AND BACKPLANE

CLOCK SIGNALS THESE ARE THE SIGNAL NAMES ON THE SMv2

THESE ARE THE SIGNAL NAMES ON THE SMv2

B | 16 16 LHC_CLK-P bc_pLHC_CLK_IN LHC_CLK-P 2-8 2-8 18 19 18 LHC_CLK-N 2-9 bc_nLHC_CLK_IN LHC_CLK-N 2-9 G1 G1 G1 19 G1 G2 20 G2 20 GND GND G3 G2 2-10 G3 G2 2-10 G3 G3 G4 22 G4 22 G4 TTS-P 2-11 pCON1_TCDS_OUT G4 TTS-P 2-11 pCON2_TCDS_MIXED_OUT 25 25 24 24 TTS-N nCON1_TCDS_OUT TTS-N nCON2_TCDS_MIXED_OUT 2-12 2-12 25 25 26 26 2-13 GND 2-13 GND ERM8-013-RA-2X13 ERM8-013-RA-2X13 THE TCDS SIGNALS ON HIGH SPEED CONNECTOR #2 ARE LABELED "MIXED" BECAUSE THEY CAN EITHER BE REGULAR TCDS SIGNALS WHEN THE SM IS THE TCDS ENDPOINT, OR THEY CAN BE REPEATED TCDS SIGNALS WHEN FPGA#1 IS THE TCDS ENDPOINT. | B

ROW 1-1 ROW 1-13 (PIN 1) (PIN 25) ROW 2-1 ROW 2-13 (PIN 2) (PIN 26) 2.02: SM HIGH SPEED CONNECTORS 2.02: SM HIGH SPEED CONNECTORS 2.02: SM HIGH SPEED CONNECTORS ERM8-013-01-L-D-RA-DS Tuesday, June 15, 2021 Tuesday, June 15, 2021 Tuesday, June 15, 2021 14 14 14 84 84 84

## THESE VOLTAGE TRANSLATORS CONVERT THE 1.8 VOLT LOGIC

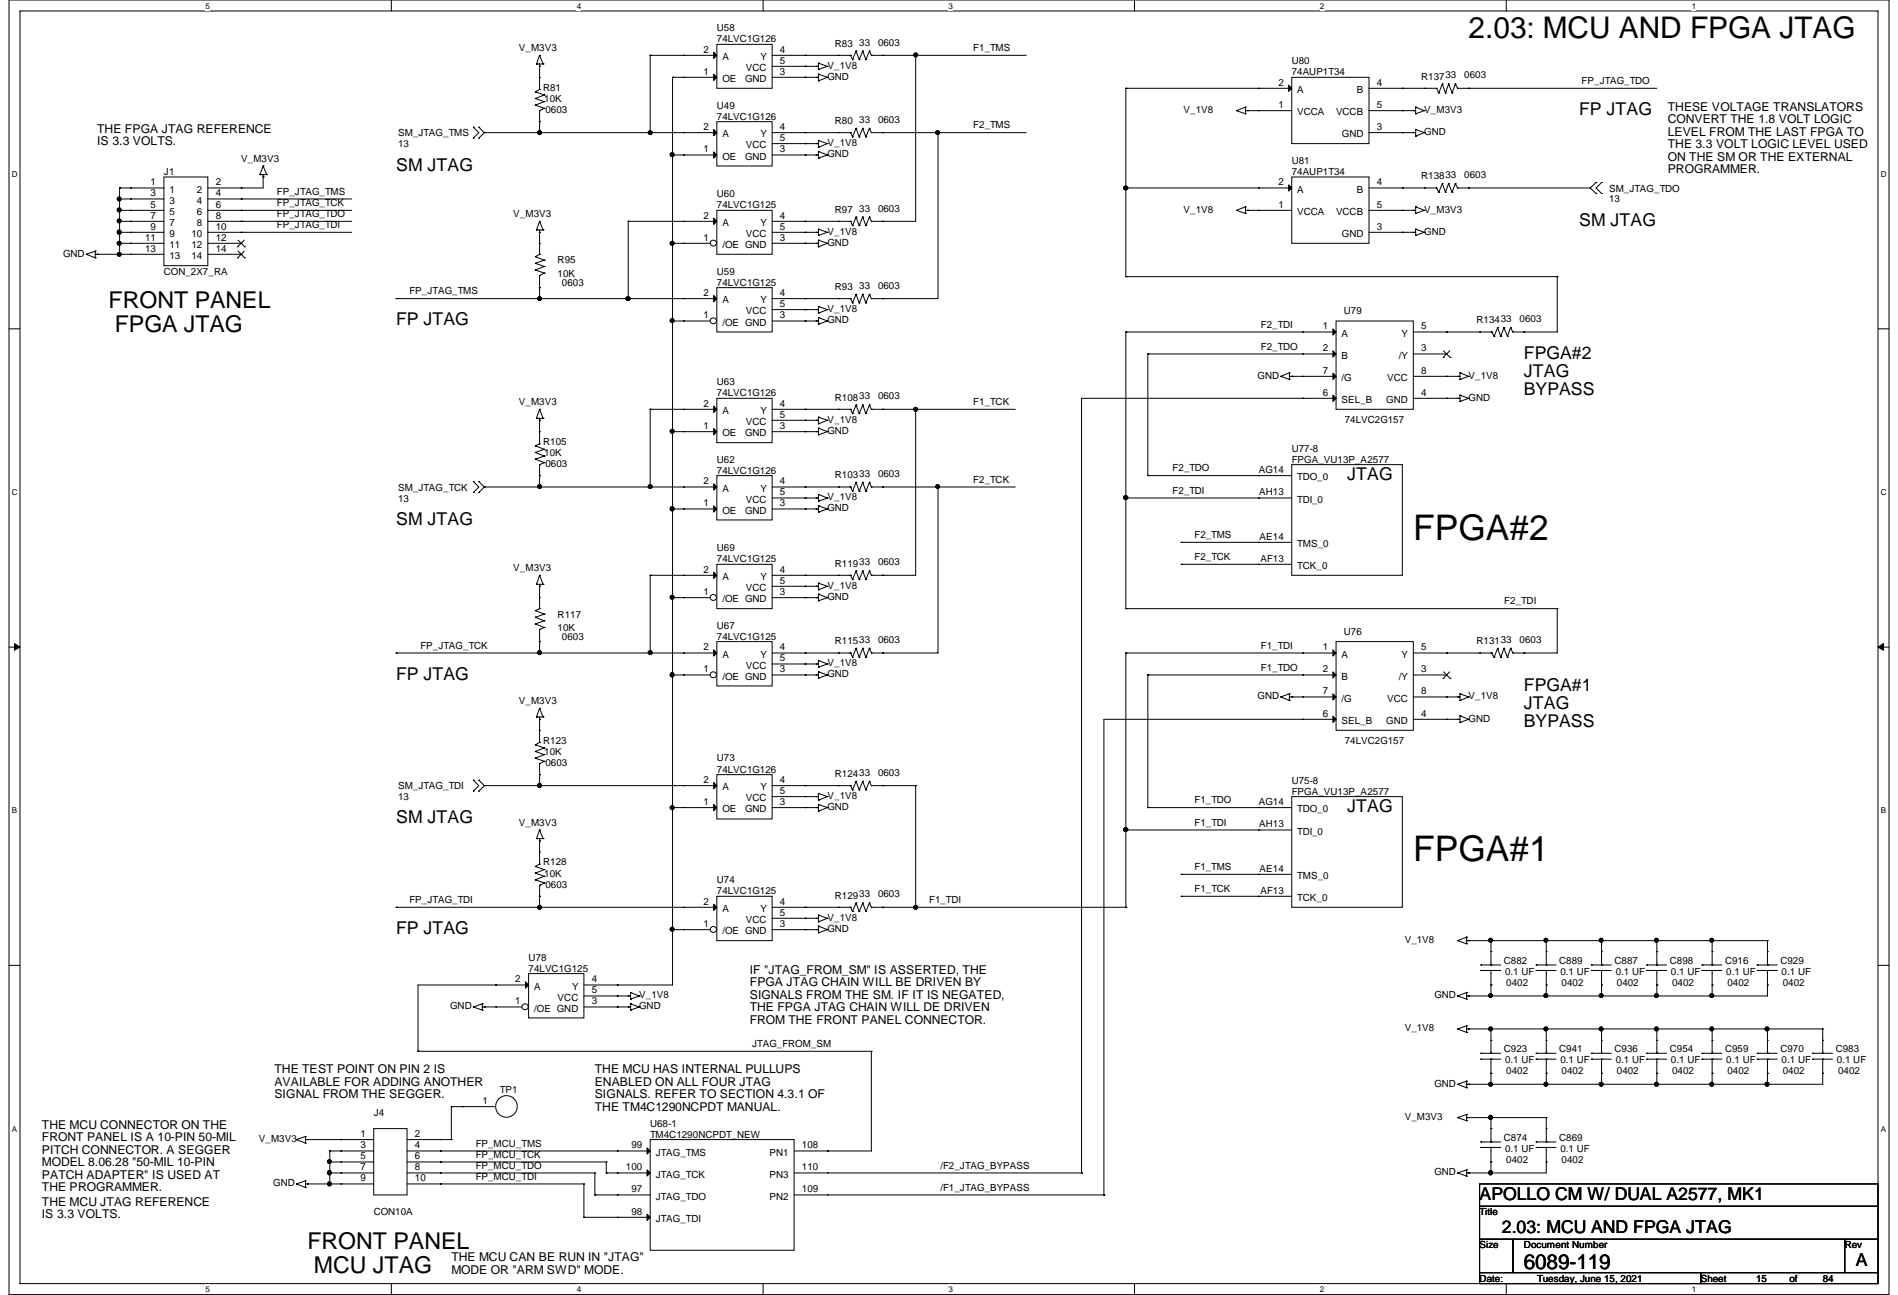
[picture p97: page 15]

V_M3V3 | U58 74LVC1G126 R83 33 0603 | F1_TMS | 2.03: MCU AND FPGA JTAG

THE FPGA JTAG REFERENCE
IS 3.3 VOLTS.

LEVEL FROM THE LAST FPGA TO
THE 3.3 VOLT LOGIC LEVEL USED
ON THE SM OR THE EXTERNAL
PROGRAMMER.

C | V_M3V3 13 SM JTAG V_M3V3 | | | F2_TDO 2 3 F2_TDI AH13 TDI_0 FPGA#2 F2_TMS AE14 TMS_0 F2_TCK AF13 TCK_0 F2_TDI | C

B | FP JTAG V_M3V3 10K 13 SM JTAG V_M3V3 R128 10K 0603 FP JTAG U78 | 5 V_1V8 1 VCC 3 GND /OE GND U73 74LVC1G126 R12433 0603 2 4 5 VCC V_1V8 1 3 GND /OE GND | | | B

4 FRONT PANEL MCU JTAG | | 2.03: MCU AND FPGA JTAG 2.03: MCU AND FPGA JTAG 2.03: MCU AND FPGA JTAG Tuesday, June 15, 2021 Tuesday, June 15, 2021 Tuesday, June 15, 2021 | 15 15 15 | 84 84 84

IF "JTAG_FROM_SM" IS ASSERTED, THE
FPGA JTAG CHAIN WILL BE DRIVEN BY
SIGNALS FROM THE SM. IF IT IS NEGATED,
THE FPGA JTAG CHAIN WILL DE DRIVEN
FROM THE FRONT PANEL CONNECTOR.

THE TEST POINT ON PIN 2 IS
AVAILABLE FOR ADDING ANOTHER
SIGNAL FROM THE SEGGER.

THE MCU HAS INTERNAL PULLUPS
ENABLED ON ALL FOUR JTAG
SIGNALS. REFER TO SECTION 4.3.1 OF
THE TM4C1290NCPDT MANUAL.

THE MCU CONNECTOR ON THE
FRONT PANEL IS A 10-PIN 50-MIL
PITCH CONNECTOR. A SEGGER
MODEL 8.06.28 "50-MIL 10-PIN
PATCH ADAPTER" IS USED AT
THE PROGRAMMER.
THE MCU JTAG REFERENCE

THE MCU CAN BE RUN IN "JTAG"
MODE OR "ARM SWD" MODE.

## AS PER TABLE 25.7 OF THE TM4C1290 MANUAL, THE UNUSED "/WAKE" PIN

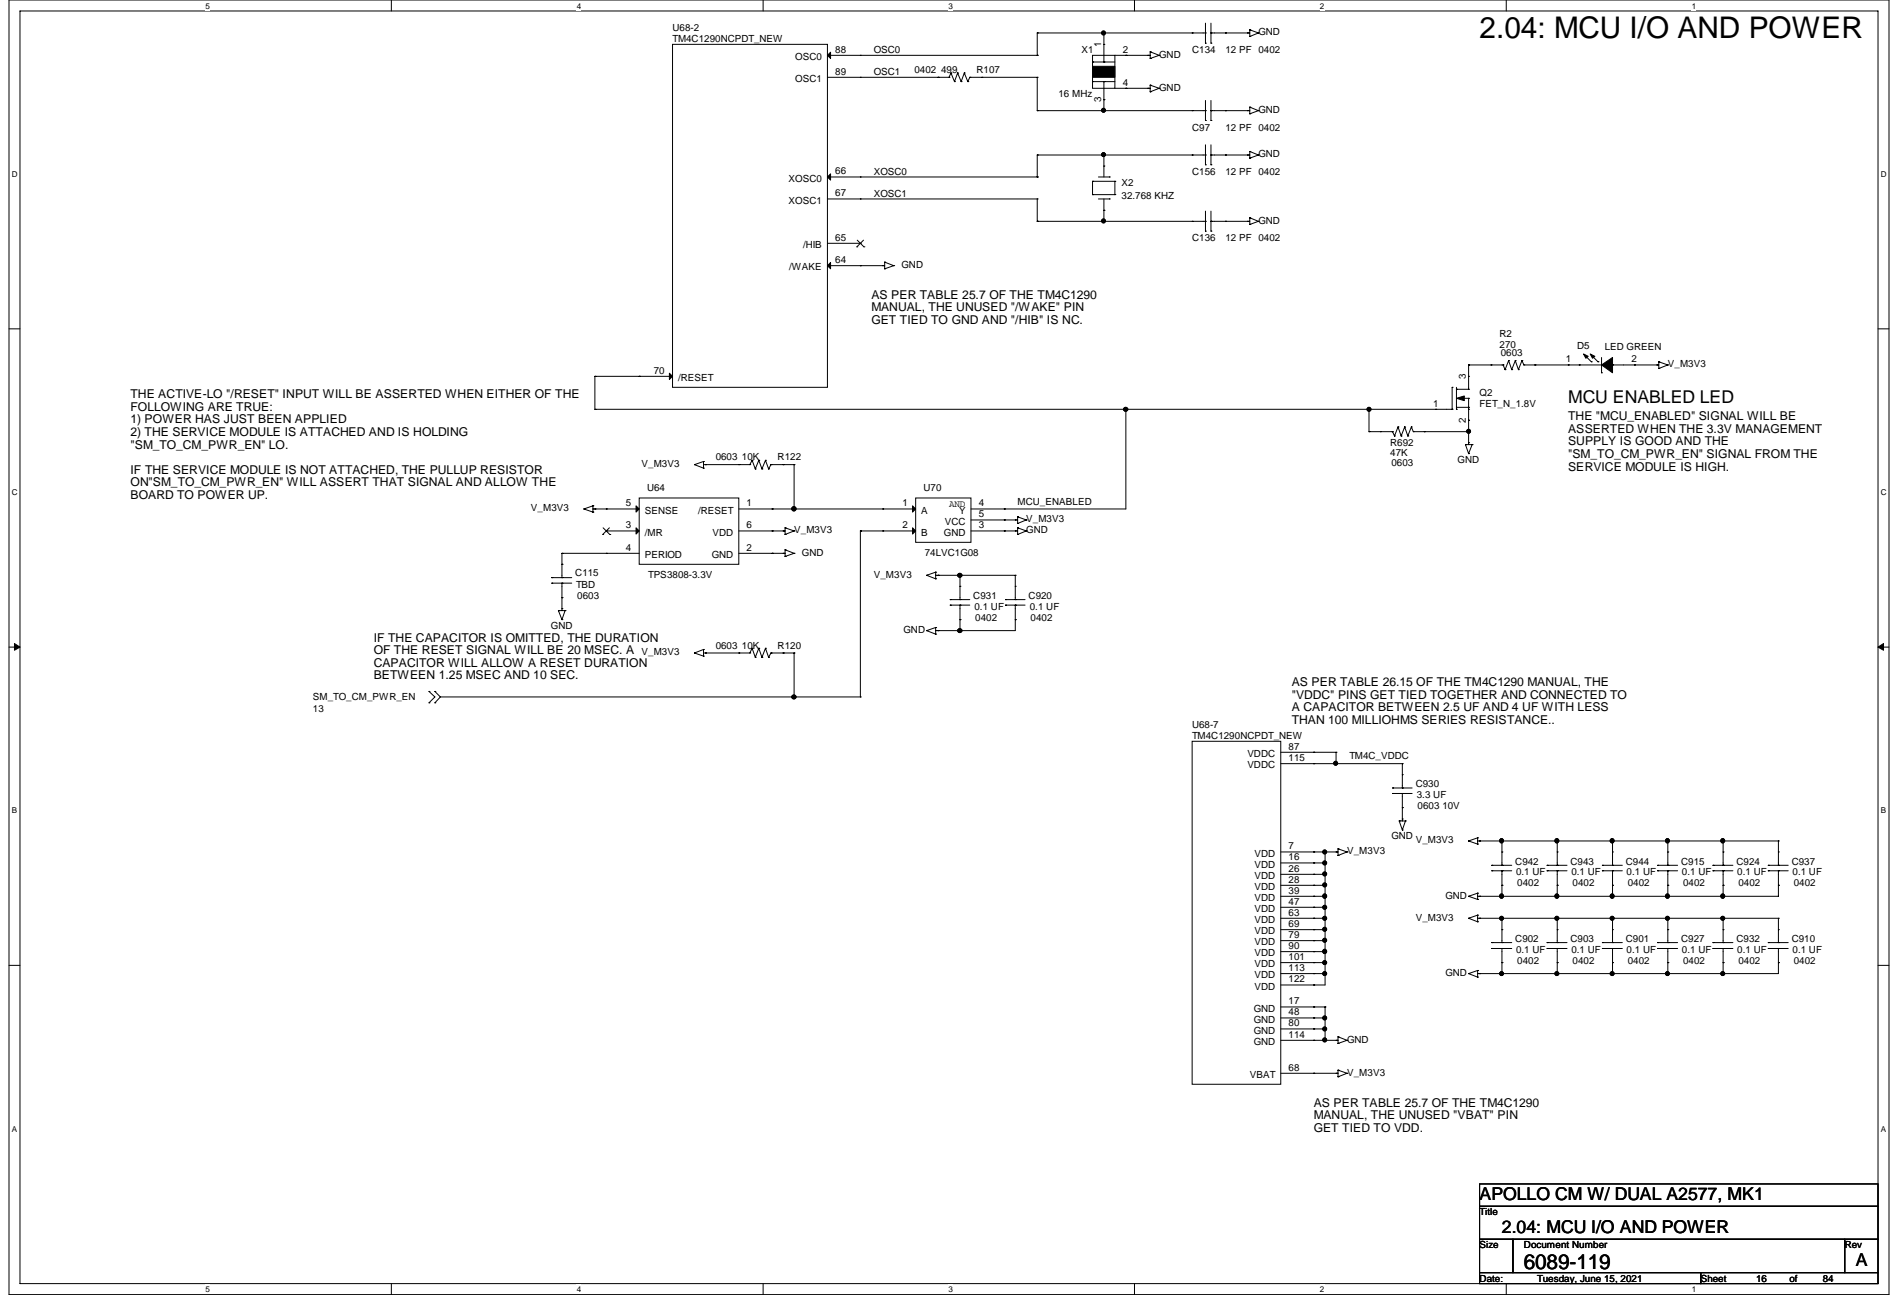
[picture p98: page 16]

GET TIED TO GND AND "/HIB" IS NC.

C | 3 6 | 5 VCC V_M3V3 2 3 | R2 270 D5 LED GREEN 0603 | C

MCU ENABLED LED
THE "MCU_ENABLED" SIGNAL WILL BE
ASSERTED WHEN THE 3.3V MANAGEMENT
SUPPLY IS GOOD AND THE
"SM_TO_CM_PWR_EN" SIGNAL FROM THE
SERVICE MODULE IS HIGH.

THE ACTIVE-LO "/RESET" INPUT WILL BE ASSERTED WHEN EITHER OF THE
FOLLOWING ARE TRUE:
1) POWER HAS JUST BEEN APPLIED
2) THE SERVICE MODULE IS ATTACHED AND IS HOLDING
"SM_TO_CM_PWR_EN" LO.
IF THE SERVICE MODULE IS NOT ATTACHED, THE PULLUP RESISTOR
ON"SM_TO_CM_PWR_EN" WILL ASSERT THAT SIGNAL AND ALLOW THE
BOARD TO POWER UP.

IF THE CAPACITOR IS OMITTED, THE DURATION
OF THE RESET SIGNAL WILL BE 20 MSEC. A
CAPACITOR WILL ALLOW A RESET DURATION
BETWEEN 1.25 MSEC AND 10 SEC.

AS PER TABLE 26.15 OF THE TM4C1290 MANUAL, THE
"VDDC" PINS GET TIED TOGETHER AND CONNECTED TO

B | 13 A CAPACITOR BETWEEN 2.5 UF AND 4 UF WITH LESS THAN 100 MILLIOHMS SERIES RESISTANCE.. U68-7 TM4C1290NCPDT_NEW 87 GND | 3.3 UF | B

17 68 V_M3V3 VBAT AS PER TABLE 25.7 OF THE TM4C1290 MANUAL, THE UNUSED "VBAT" PIN GET TIED TO VDD. 2.04: MCU I/O AND POWER 2.04: MCU I/O AND POWER 2.04: MCU I/O AND POWER Tuesday, June 15, 2021 Tuesday, June 15, 2021 Tuesday, June 15, 2021 16 16 16 84 84 84

## THIS OSCILLATOR HAS A STANDARD VALUE OF

200.0000 MHZ AND AN LVDS OUTPUT.

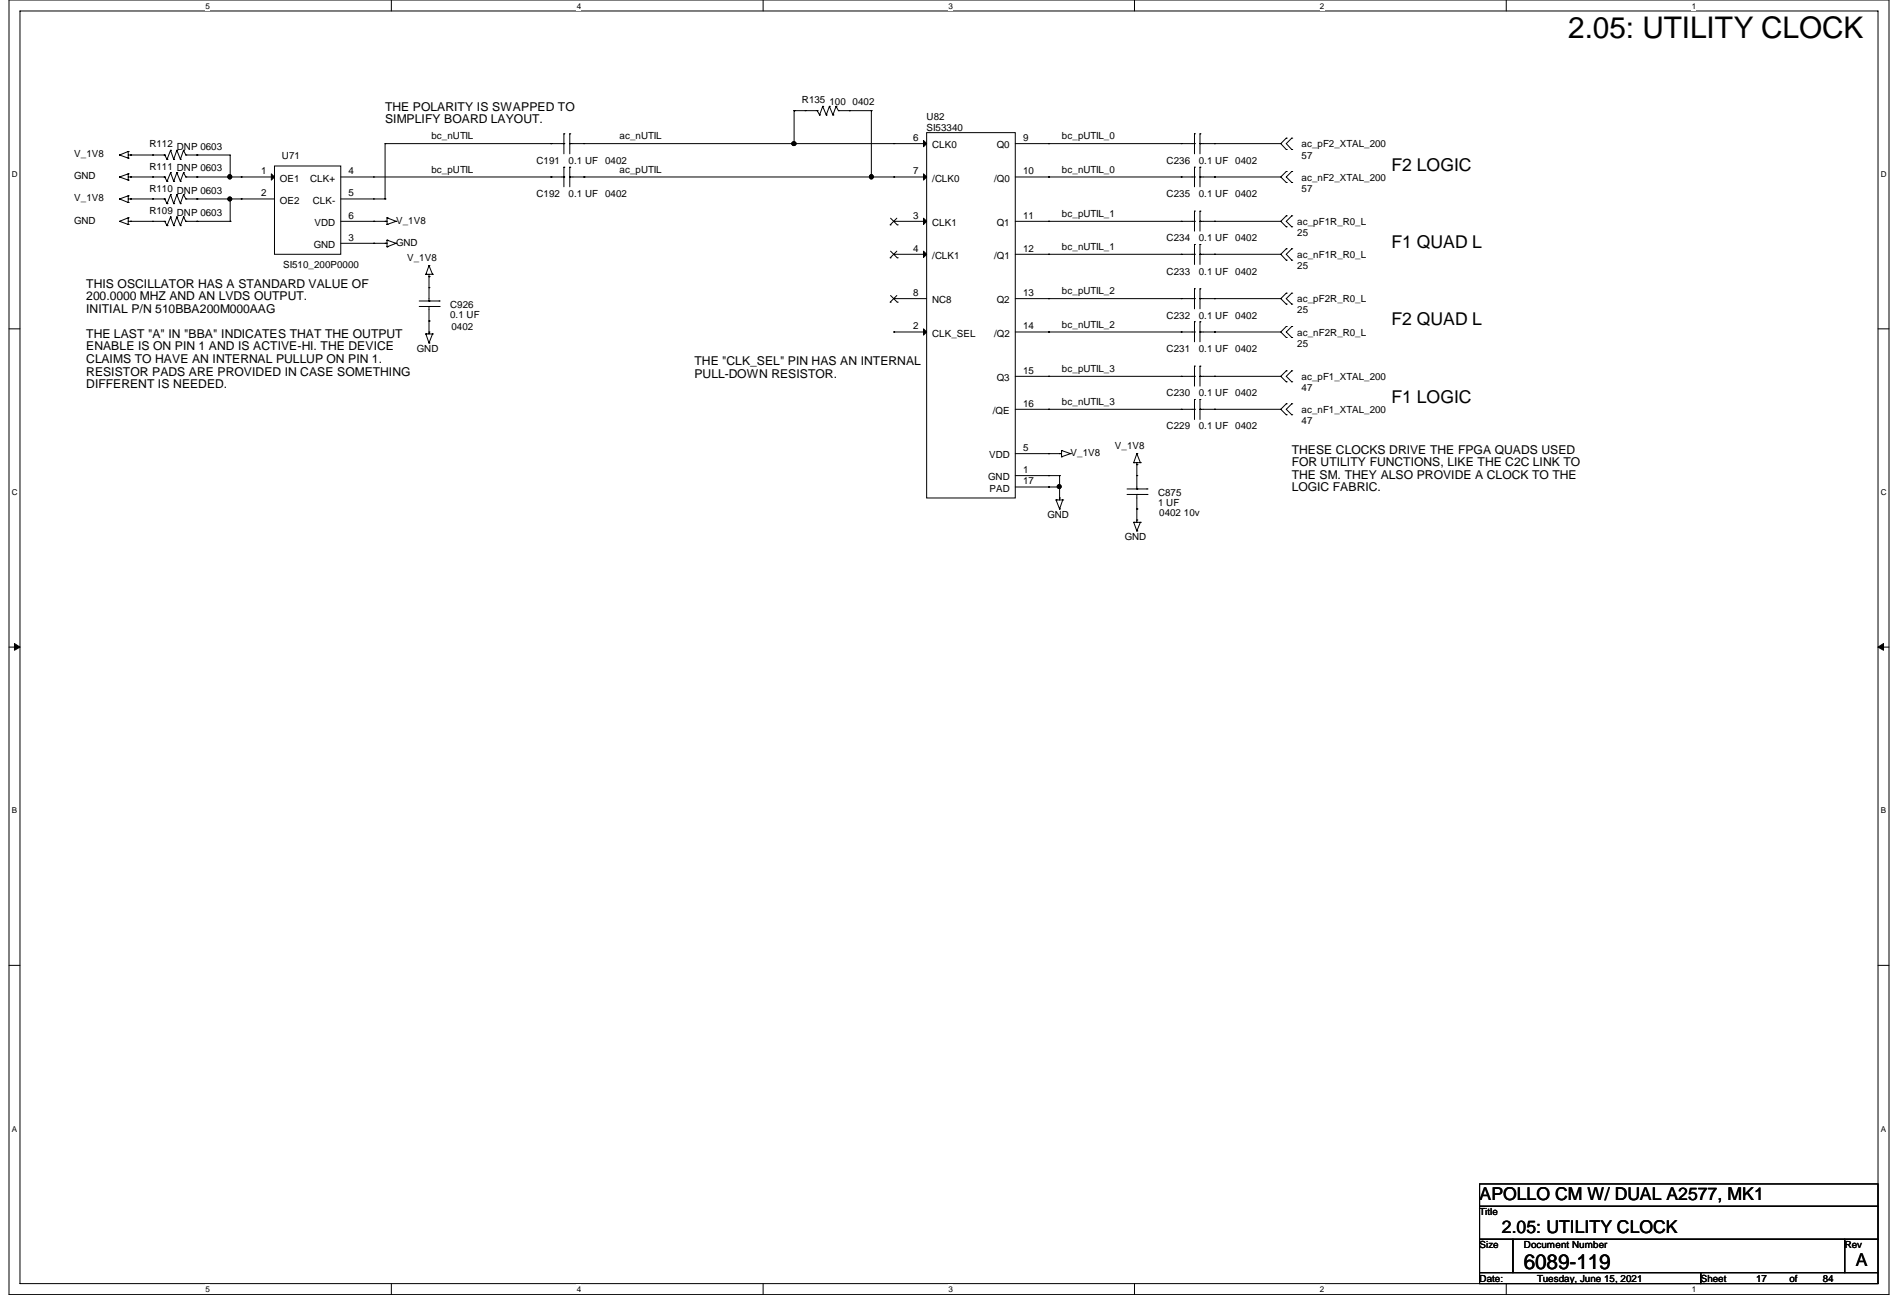
[picture p99: page 17]

3 | THE POLARITY IS SWAPPED TO GND | R135 100 0402 | C234 0.1 UF 0402 C233 0.1 UF 0402 | 2.05: UTILITY CLOCK F1 QUAD L

INITIAL P/N 510BBA200M000AAG
THE LAST "A" IN "BBA" INDICATES THAT THE OUTPUT

C | ENABLE IS ON PIN 1 AND IS ACTIVE-HI. THE DEVICE GND CLAIMS TO HAVE AN INTERNAL PULLUP ON PIN 1. THE "CLK_SEL" PIN HAS AN INTERNAL 5 VDD | C231 0.1 UF 0402 C230 0.1 UF 0402 F1 LOGIC C229 0.1 UF 0402 V_1V8 V_1V8 THESE CLOCKS DRIVE THE FPGA QUADS USED FOR UTILITY FUNCTIONS, LIKE THE C2C LINK TO GND | C

RESISTOR PADS ARE PROVIDED IN CASE SOMETHING
DIFFERENT IS NEEDED.

THE SM. THEY ALSO PROVIDE A CLOCK TO THE
LOGIC FABRIC.

2.05: UTILITY CLOCK 2.05: UTILITY CLOCK 2.05: UTILITY CLOCK Tuesday, June 15, 2021 Tuesday, June 15, 2021 Tuesday, June 15, 2021 17 17 17 84 84 84

THE POLARITY IS SWAPPED TO | | U86-1 C355 0.1 UF 0402 | 2.06: REFCLK SYNTHESIZER R0A 12X FIREFLYS

# F1 R0 LEFT QUADS

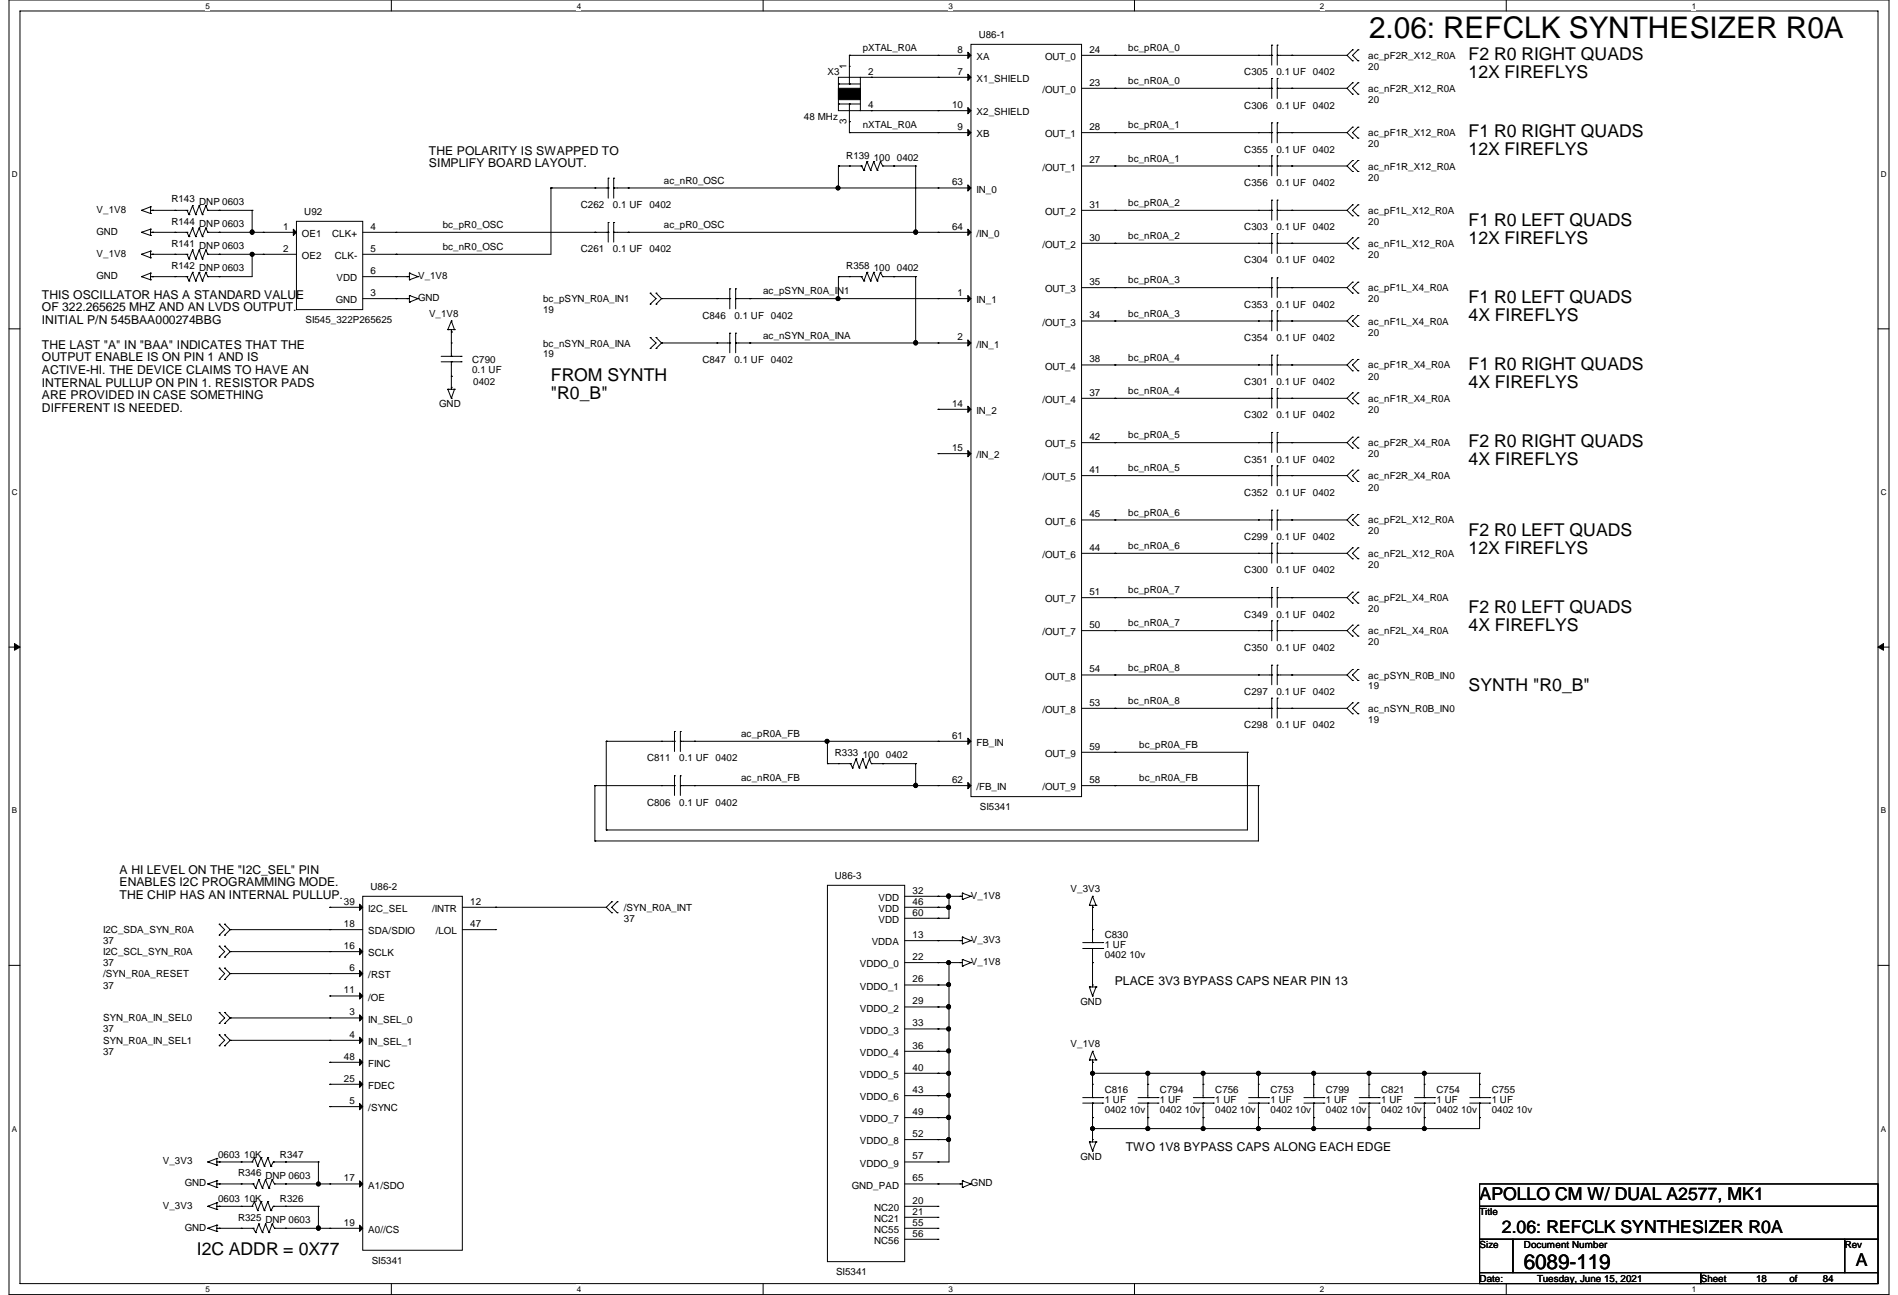
[picture p100: page 18]

THIS OSCILLATOR HAS A STANDARD VALUE
OF 322.265625 MHZ AND AN LVDS OUTPUT.
INITIAL P/N 545BAA000274BBG
THE LAST "A" IN "BAA" INDICATES THAT THE
OUTPUT ENABLE IS ON PIN 1 AND IS
ACTIVE-HI. THE DEVICE CLAIMS TO HAVE AN
INTERNAL PULLUP ON PIN 1. RESISTOR PADS
ARE PROVIDED IN CASE SOMETHING
DIFFERENT IS NEEDED.

C | IN_2 C302 0.1 UF 0402 /IN_2 4X FIREFLYS C351 0.1 UF 0402 C352 0.1 UF 0402 C299 0.1 UF 0402 C300 0.1 UF 0402 C349 0.1 UF 0402 | C

B | A HI LEVEL ON THE "I2C_SEL" PIN ENABLES I2C PROGRAMMING MODE. U86-2 37 16 I2C_SCL_SYN_R0A SCLK | | C297 0.1 UF 0402 C298 0.1 UF 0402 | B

THE CHIP HAS AN INTERNAL PULLUP.

0603 10K R326 NC56 I2C ADDR = 0X77 SI5341 SI5341 | GND Tuesday, June 15, 2021 Tuesday, June 15, 2021 Tuesday, June 15, 2021 18 18 18 84 84 84

TWO 1V8 BYPASS CAPS ALONG EACH EDGE

## THE REFERENCE CLOCK 0 SYNTHESIZER “B” CAN BE DRIVEN BY A LOCAL CRYSTAL, THE OUTPUT OF SYNTHESIZER “A”, THE 40 MHZ

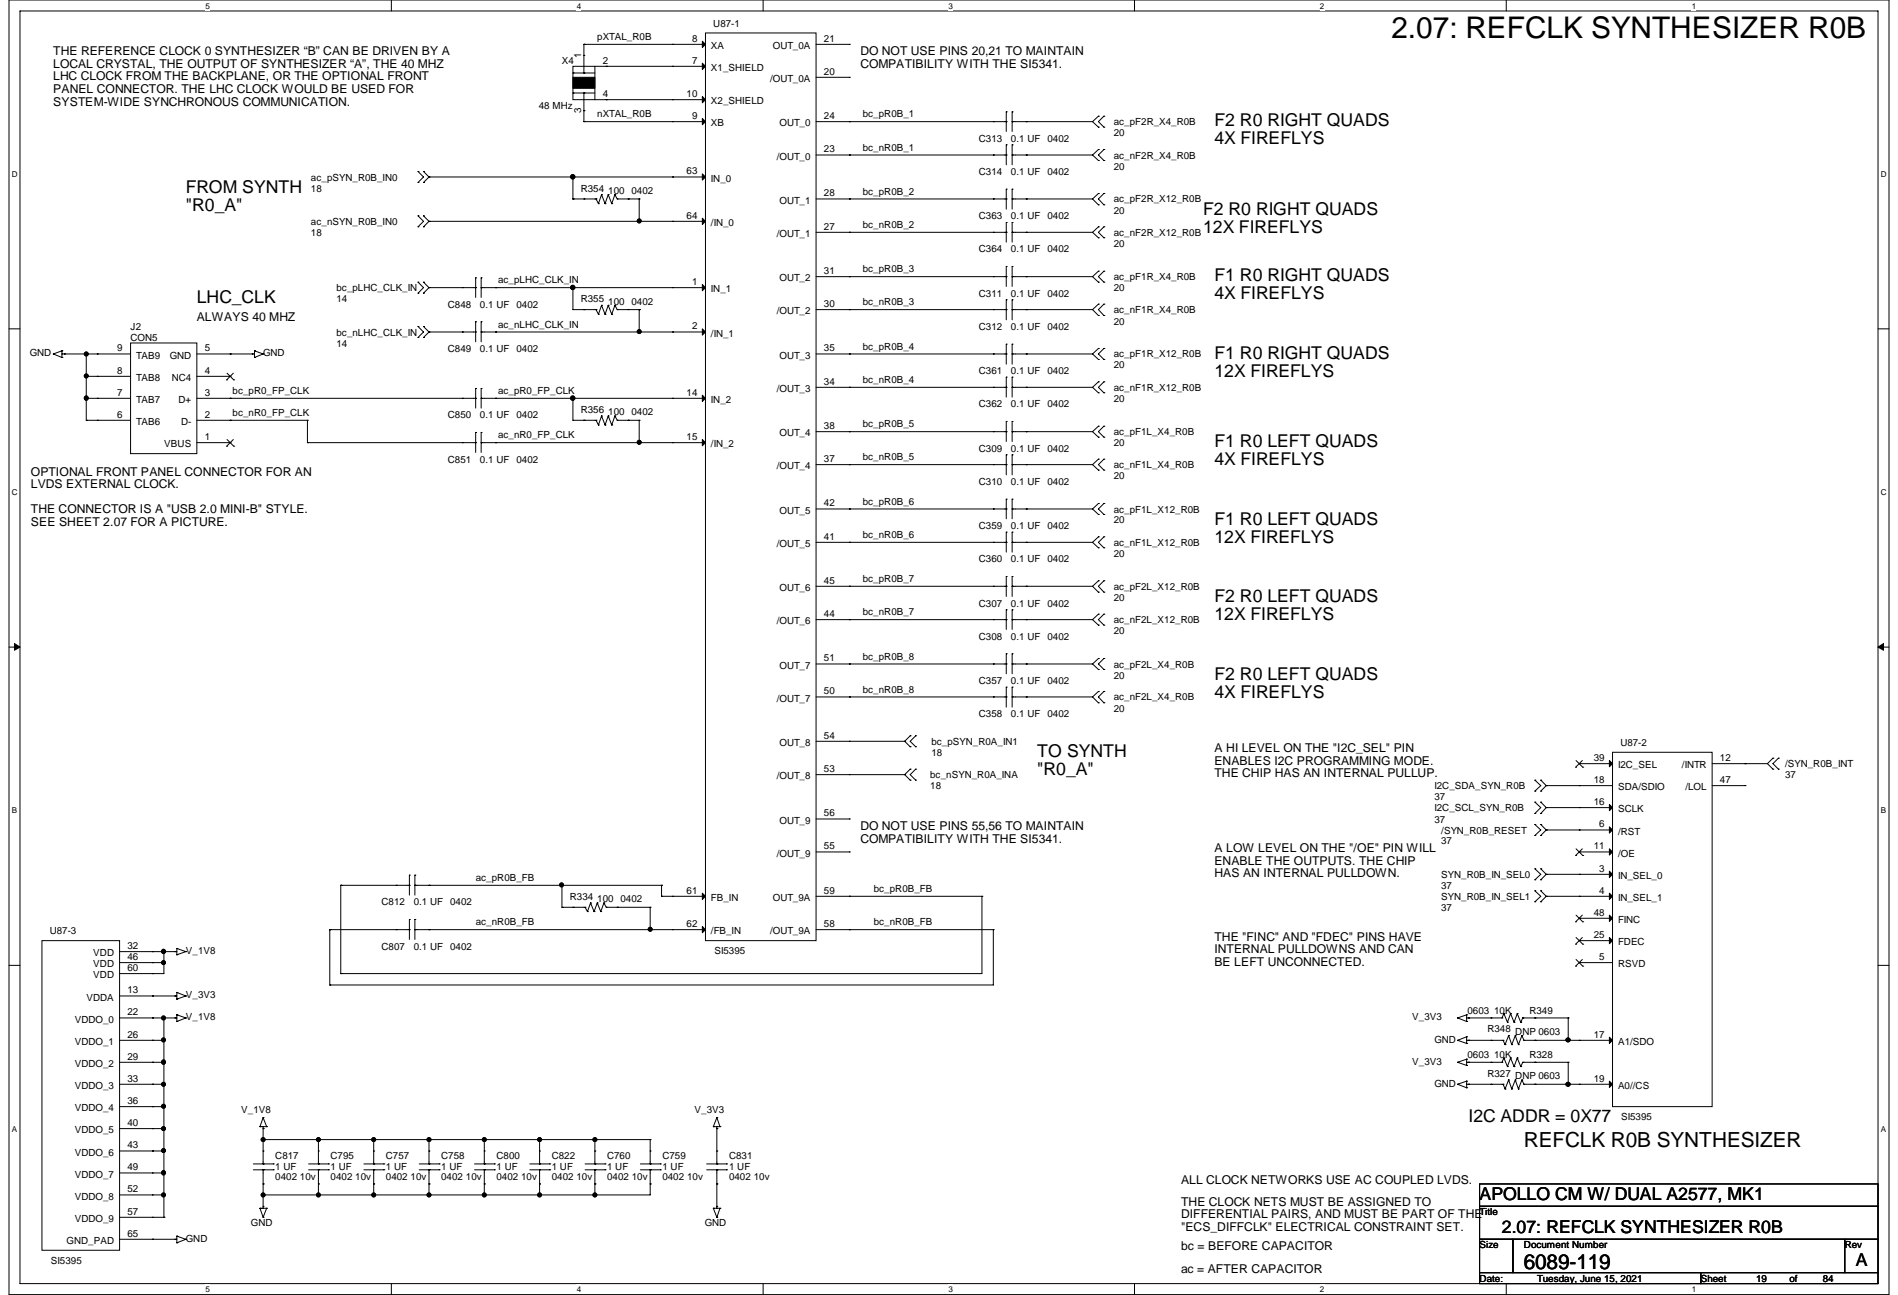
[picture p101: page 19]

DO NOT USE PINS 20,21 TO MAINTAIN
COMPATIBILITY WITH THE SI5341.

LHC CLOCK FROM THE BACKPLANE, OR THE OPTIONAL FRONT
PANEL CONNECTOR. THE LHC CLOCK WOULD BE USED FOR
SYSTEM-WIDE SYNCHRONOUS COMMUNICATION.

C | LVDS EXTERNAL CLOCK. C310 0.1 UF 0402 SEE SHEET 2.07 FOR A PICTURE. C359 0.1 UF 0402 C360 0.1 UF 0402 C307 0.1 UF 0402 C308 0.1 UF 0402 | C

OPTIONAL FRONT PANEL CONNECTOR FOR AN

THE CONNECTOR IS A "USB 2.0 MINI-B" STYLE.

B | C357 0.1 UF 0402 C358 0.1 UF 0402 54 OUT_8 bc_pSYN_R0A_IN1 U87-2 TO SYNTH A HI LEVEL ON THE "I2C_SEL" PIN 18 39 12 ENABLES I2C PROGRAMMING MODE. "R0_A" I2C_SEL /INTR /SYN_R0B_INT 53 THE CHIP HAS AN INTERNAL PULLUP. /OUT_8 bc_nSYN_R0A_INA 37 18 47 18 I2C_SDA_SYN_R0B SDA/SDIO /LOL 37 16 I2C_SCL_SYN_R0B SCLK 56 OUT_9 37 DO NOT USE PINS 55,56 TO MAINTAIN 6 /SYN_R0B_RESET /RST COMPATIBILITY WITH THE SI5341. 37 55 A LOW LEVEL ON THE "/OE" PIN WILL 11 /OUT_9 /OE ENABLE THE OUTPUTS. THE CHIP 3 HAS AN INTERNAL PULLDOWN. | B

THE "FINC" AND "FDEC" PINS HAVE
INTERNAL PULLDOWNS AND CAN
BE LEFT UNCONNECTED.

13 VDDA 22 GND_PAD SI5395 | V_3V3 0603 10K R349 2.07: REFCLK SYNTHESIZER R0B 2.07: REFCLK SYNTHESIZER R0B 2.07: REFCLK SYNTHESIZER R0B "ECS_DIFFCLK" ELECTRICAL CONSTRAINT SET. GND bc = BEFORE CAPACITOR ac = AFTER CAPACITOR Tuesday, June 15, 2021 Tuesday, June 15, 2021 Tuesday, June 15, 2021 19 19 19 84 84 84

ALL CLOCK NETWORKS USE AC COUPLED LVDS.
THE CLOCK NETS MUST BE ASSIGNED TO
DIFFERENTIAL PAIRS, AND MUST BE PART OF THE

FPGA#1 LEFT | FPGA#1 RIGHT

# 2.08: REFCK_R0_FANOUT

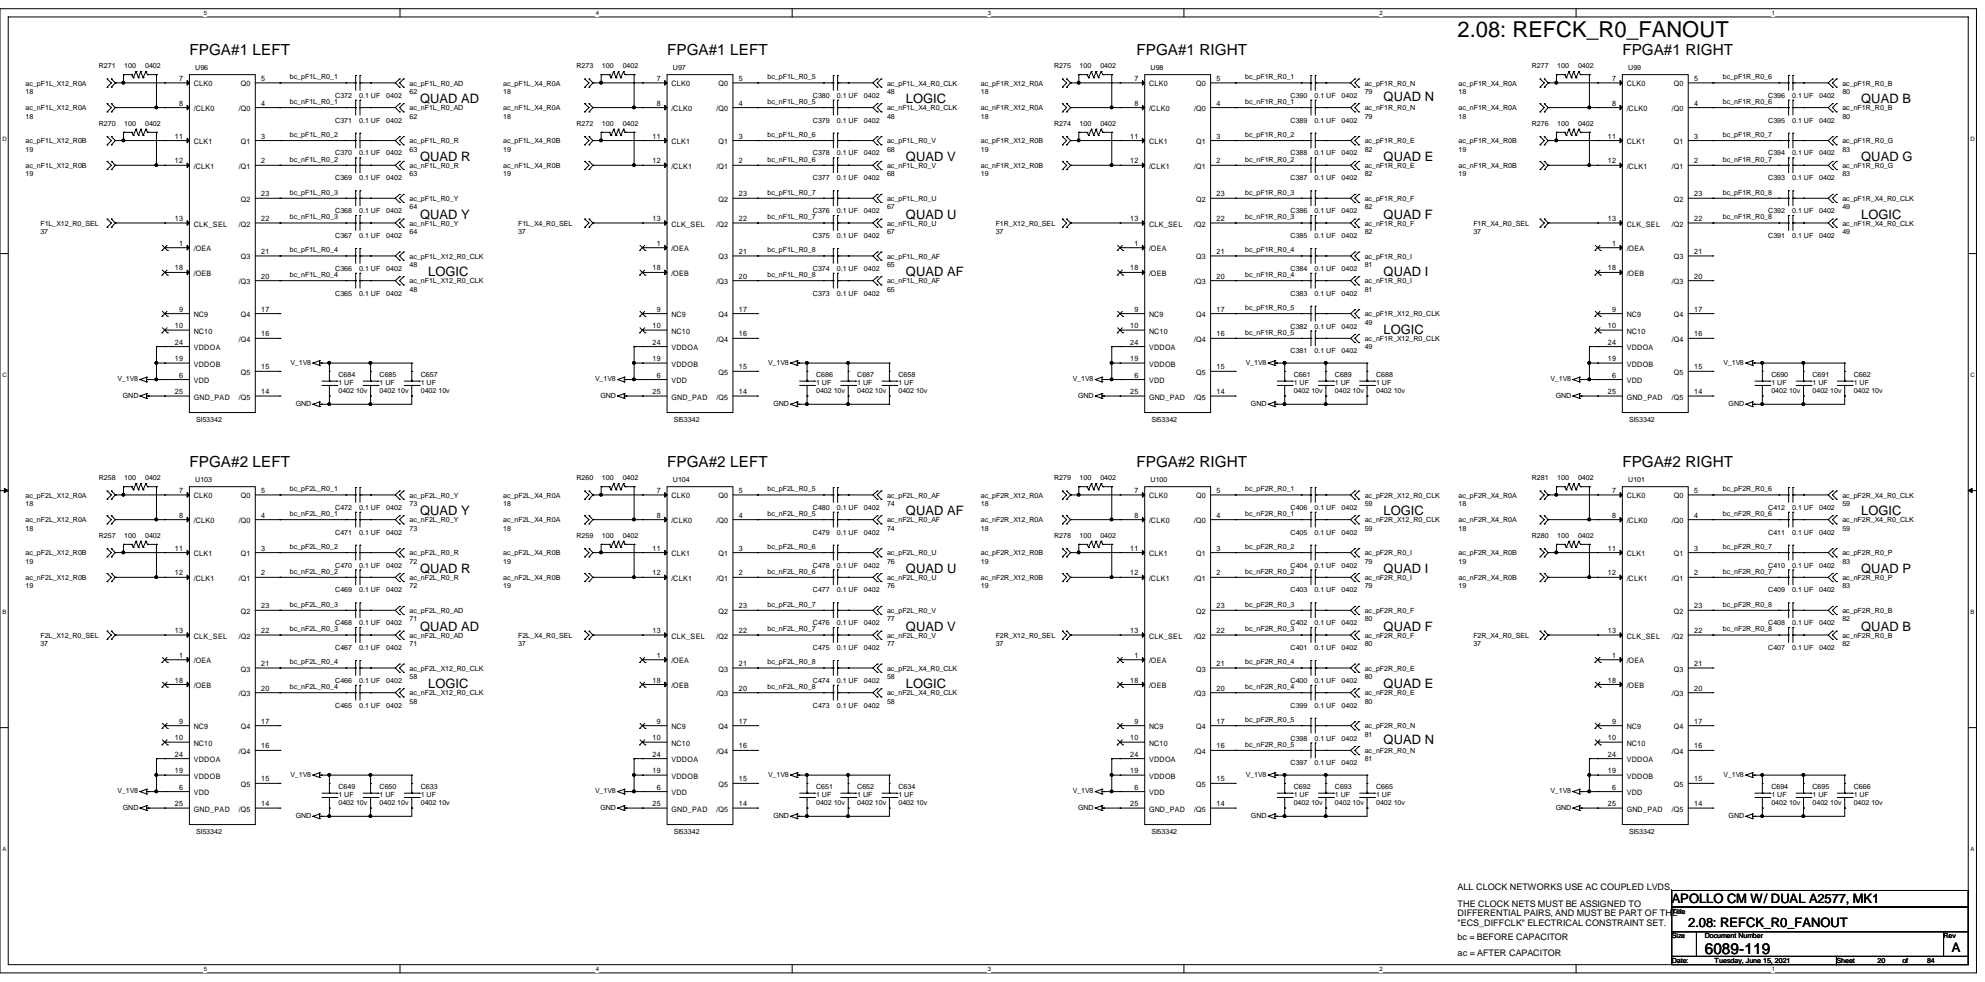
[picture p102: page 20]

ALL CLOCK NETWORKS USE AC COUPLED LVDS.
THE CLOCK NETS MUST BE ASSIGNED TO
DIFFERENTIAL PAIRS, AND MUST BE PART OF THE
"ECS_DIFFCLK" ELECTRICAL CONSTRAINT SET.
bc = BEFORE CAPACITOR
ac = AFTER CAPACITOR

## IF THE HQ_CLK OR LHC_CLK IS AC-COUPLED ON THE SM, USE

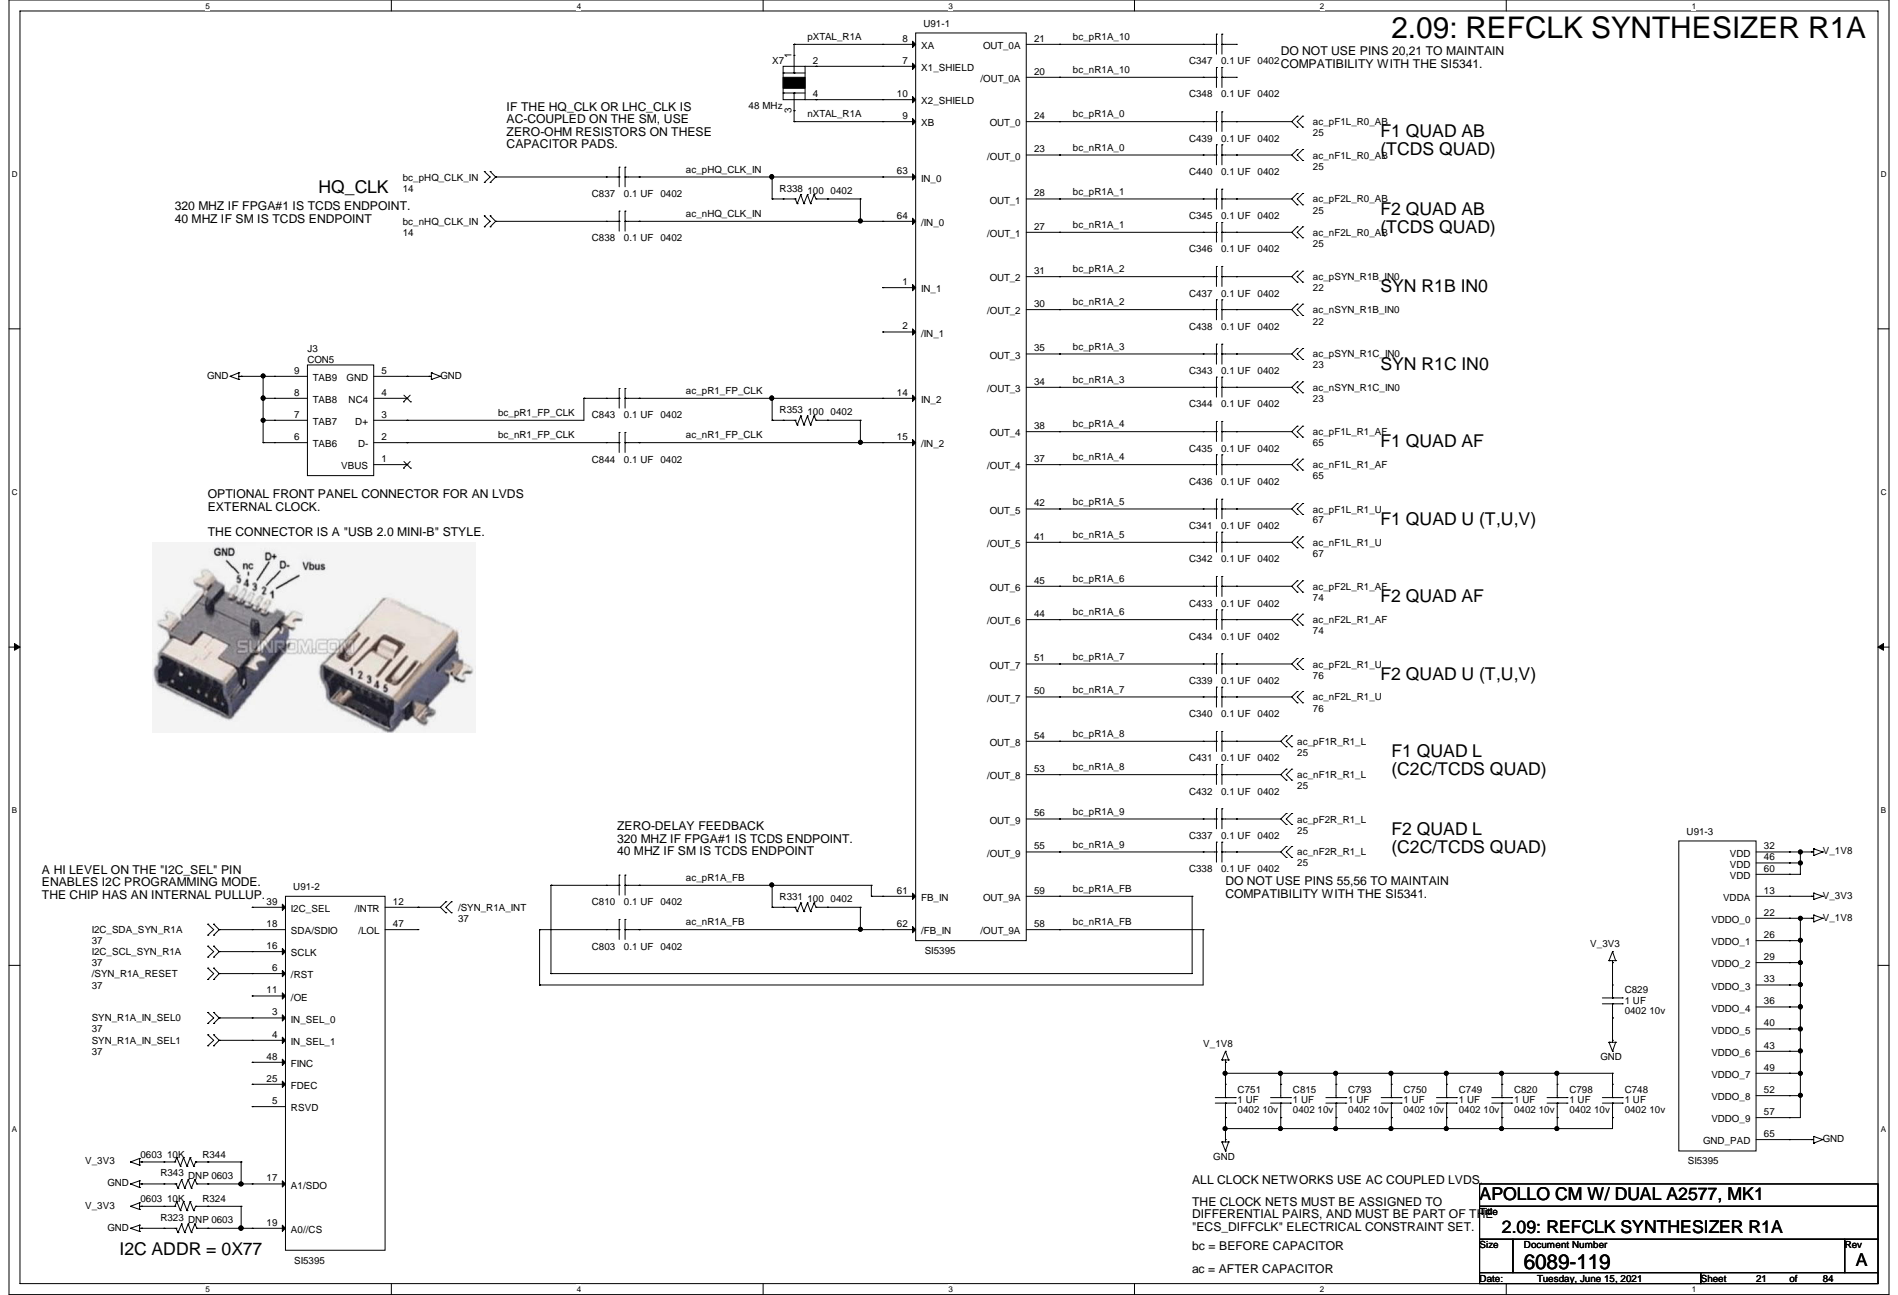
[picture p103: page 21]

2.09: REFCLK SYNTHESIZER R1A U91-1 C439 0.1 UF 0402 C346 0.1 UF 0402 IN_1 C437 0.1 UF 0402 2 C438 0.1 UF 0402

DO NOT USE PINS 20,21 TO MAINTAIN
COMPATIBILITY WITH THE SI5341.

ZERO-OHM RESISTORS ON THESE
CAPACITOR PADS.

320 MHZ IF FPGA#1 IS TCDS ENDPOINT.
40 MHZ IF SM IS TCDS ENDPOINT

C | /IN_1 9 5 C343 0.1 UF 0402 C436 0.1 UF 0402 OPTIONAL FRONT PANEL CONNECTOR FOR AN LVDS C341 0.1 UF 0402 C342 0.1 UF 0402 C433 0.1 UF 0402 C434 0.1 UF 0402 | C

EXTERNAL CLOCK.
THE CONNECTOR IS A "USB 2.0 MINI-B" STYLE.

B | C339 0.1 UF 0402 C340 0.1 UF 0402 320 MHZ IF FPGA#1 IS TCDS ENDPOINT. | U91-3 | B

ZERO-DELAY FEEDBACK

A HI LEVEL ON THE "I2C_SEL" PIN
ENABLES I2C PROGRAMMING MODE.
THE CHIP HAS AN INTERNAL PULLUP.

DO NOT USE PINS 55,56 TO MAINTAIN

GND
ALL CLOCK NETWORKS USE AC COUPLED LVDS.
THE CLOCK NETS MUST BE ASSIGNED TO
DIFFERENTIAL PAIRS, AND MUST BE PART OF THE
"ECS_DIFFCLK" ELECTRICAL CONSTRAINT SET.
bc = BEFORE CAPACITOR
ac = AFTER CAPACITOR

# F1 QUAD AB (TCDS QUAD)

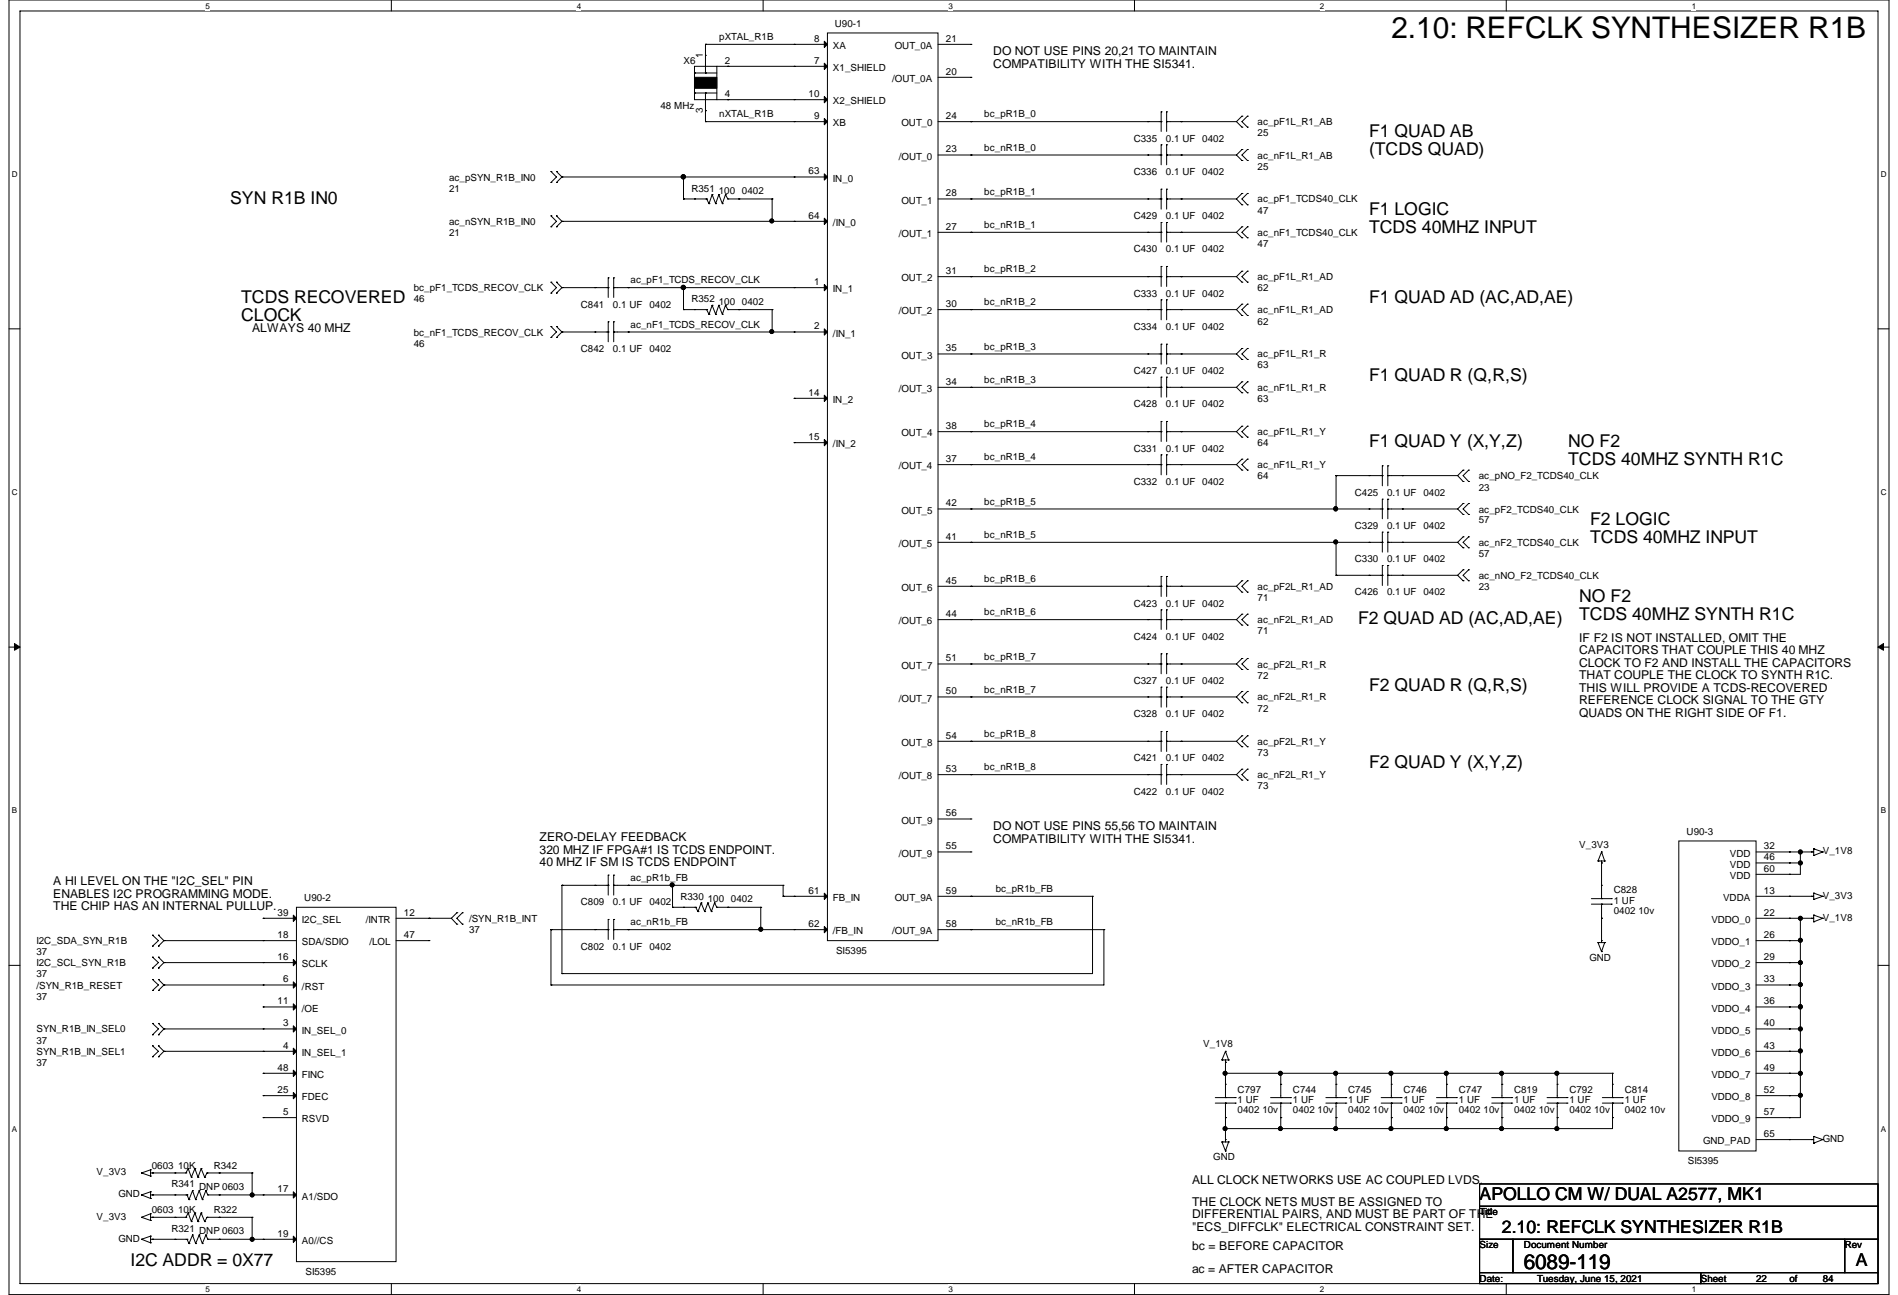
[picture p104: page 22]

DO NOT USE PINS 20,21 TO MAINTAIN
COMPATIBILITY WITH THE SI5341.

C | C427 0.1 UF 0402 IN_2 C428 0.1 UF 0402 /IN_2 C331 0.1 UF 0402 C423 0.1 UF 0402 C424 0.1 UF 0402 | F1 QUAD R (Q,R,S) C329 0.1 UF 0402 IF F2 IS NOT INSTALLED, OMIT THE | C

F2 QUAD AD (AC,AD,AE)

B | C327 0.1 UF 0402 C328 0.1 UF 0402 C421 0.1 UF 0402 C422 0.1 UF 0402 56 OUT_9 DO NOT USE PINS 55,56 TO MAINTAIN ZERO-DELAY FEEDBACK COMPATIBILITY WITH THE SI5341. 55 320 MHZ IF FPGA#1 IS TCDS ENDPOINT. | CAPACITORS THAT COUPLE THIS 40 MHZ F2 QUAD R (Q,R,S) QUADS ON THE RIGHT SIDE OF F1. F2 QUAD Y (X,Y,Z) U90-3 V_3V3 32 V_1V8 | B

CLOCK TO F2 AND INSTALL THE CAPACITORS
THAT COUPLE THE CLOCK TO SYNTH R1C.
THIS WILL PROVIDE A TCDS-RECOVERED
REFERENCE CLOCK SIGNAL TO THE GTY

40 MHZ IF SM IS TCDS ENDPOINT

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

# SYN R1C IN0

# NO F2

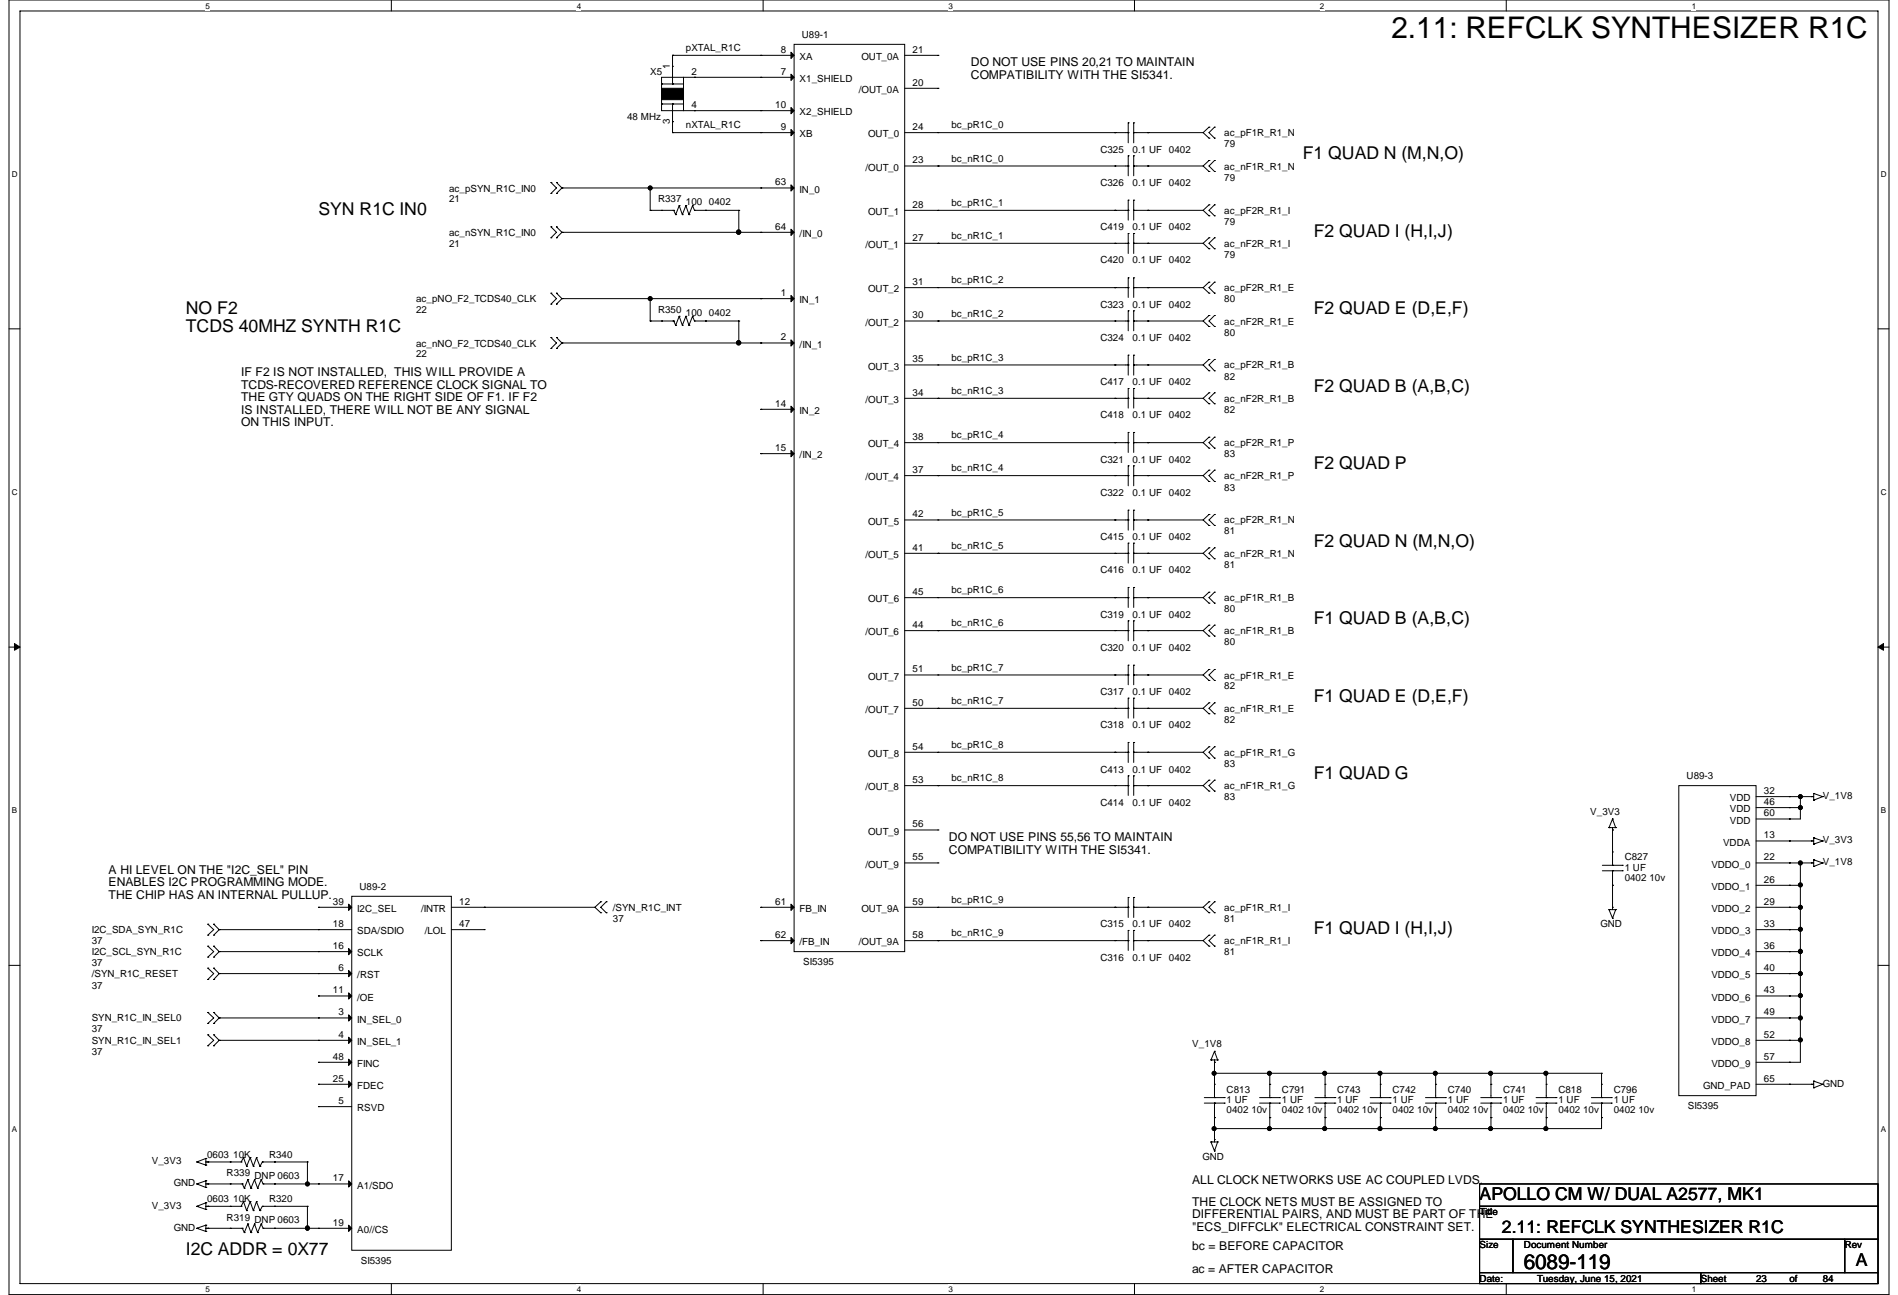
[picture p105: page 23]

U89-1 pXTAL_R1C /OUT_0A C325 0.1 UF 0402 63 C326 0.1 UF 0402 C420 0.1 UF 0402 | 2.11: REFCLK SYNTHESIZER R1C F1 QUAD N (M,N,O)

DO NOT USE PINS 20,21 TO MAINTAIN
COMPATIBILITY WITH THE SI5341.

IF F2 IS NOT INSTALLED, THIS WILL PROVIDE A
THE GTY QUADS ON THE RIGHT SIDE OF F1. IF F2
IS INSTALLED, THERE WILL NOT BE ANY SIGNAL

C | TCDS-RECOVERED REFERENCE CLOCK SIGNAL TO C417 0.1 UF 0402 F2 QUAD B (A,B,C) IN_2 C418 0.1 UF 0402 ON THIS INPUT. /IN_2 F2 QUAD P C321 0.1 UF 0402 C322 0.1 UF 0402 C415 0.1 UF 0402 F2 QUAD N (M,N,O) C416 0.1 UF 0402 C319 0.1 UF 0402 F1 QUAD B (A,B,C) | C

B | C317 0.1 UF 0402 F1 QUAD E (D,E,F) C318 0.1 UF 0402 C413 0.1 UF 0402 F1 QUAD G 56 | | B

DO NOT USE PINS 55,56 TO MAINTAIN

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

# 2.12: LEDS AND LEVEL SHIFTERS

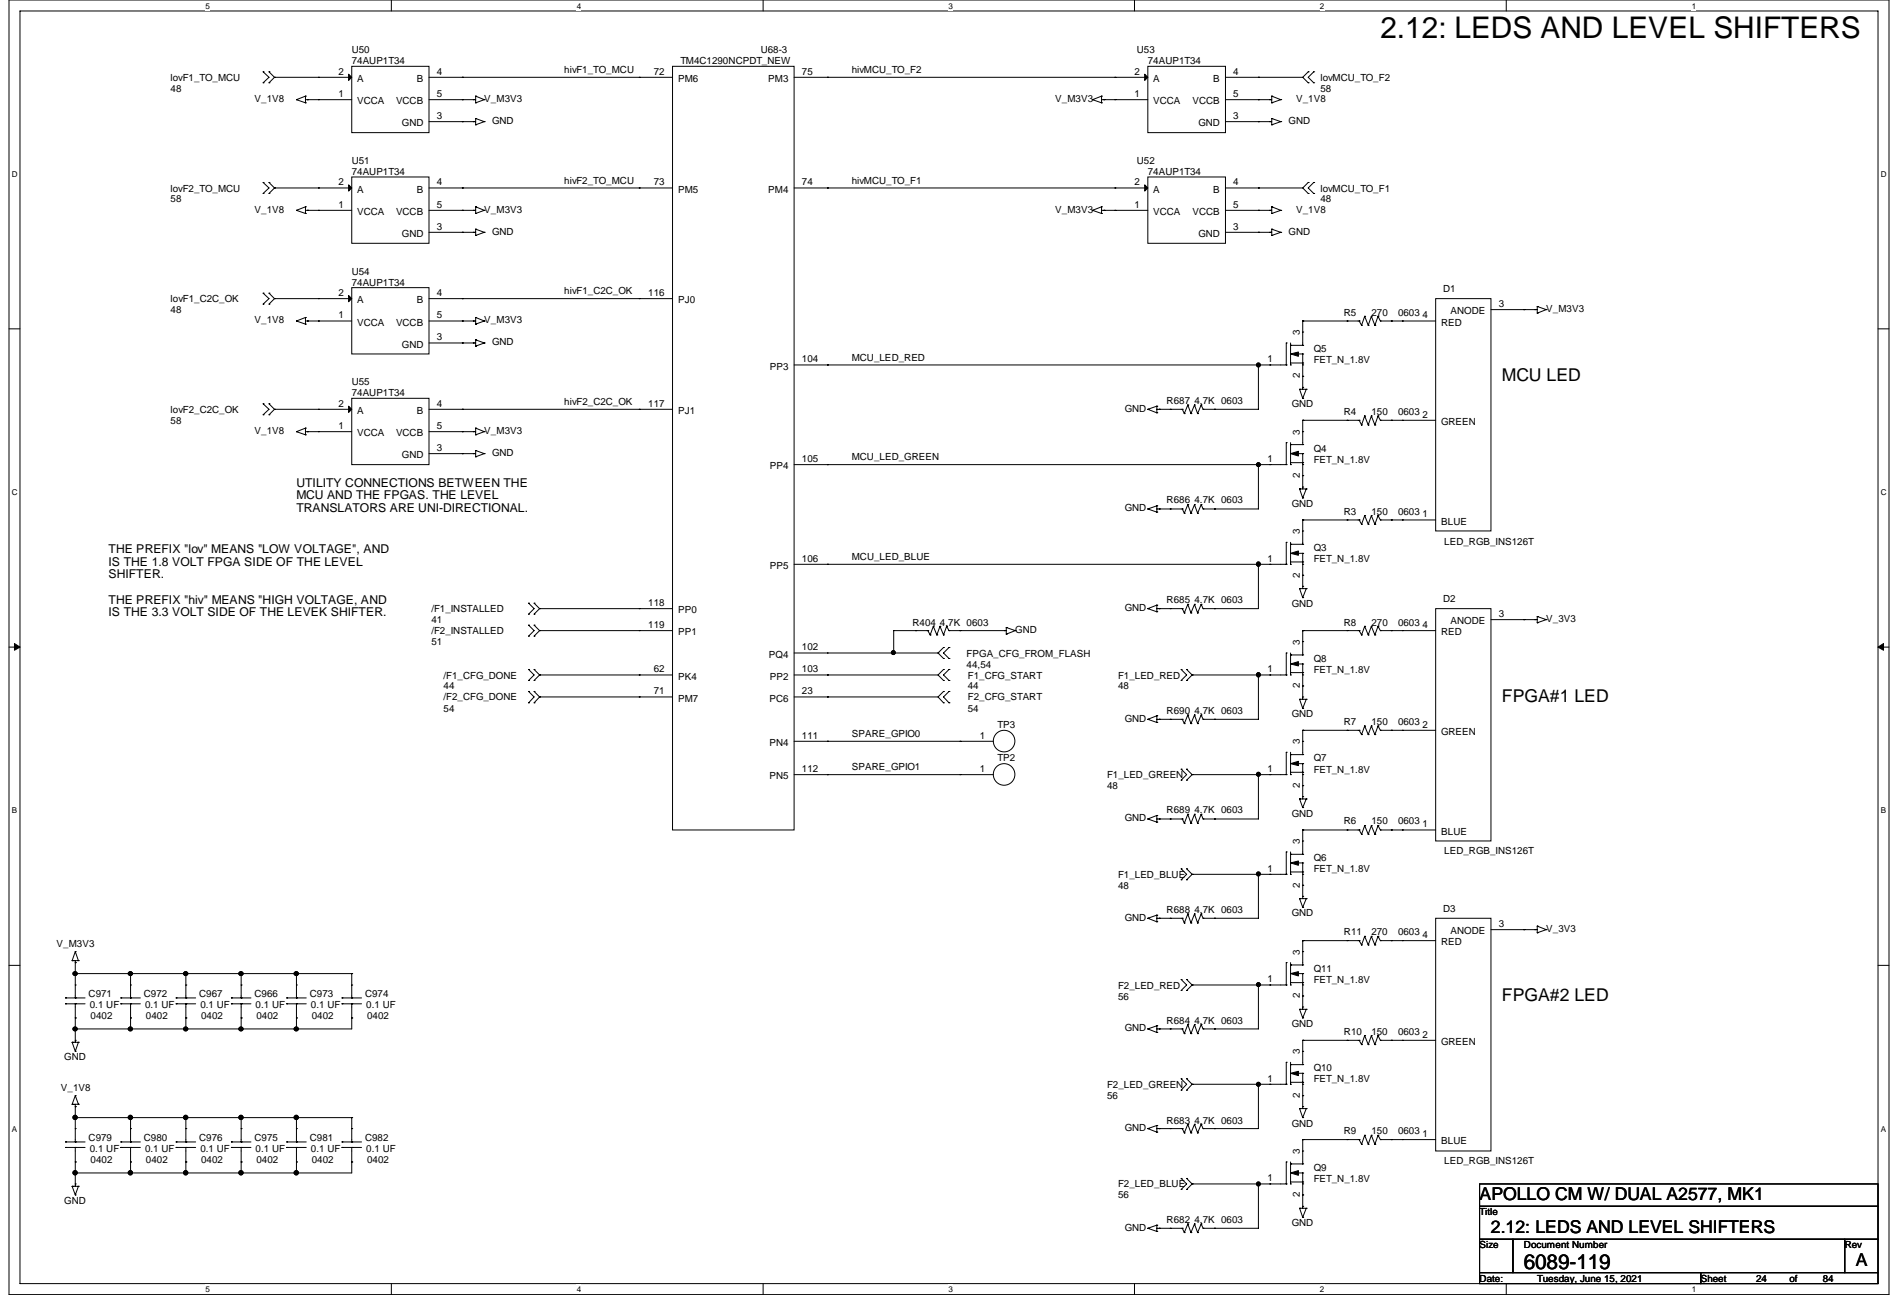
[picture p106: page 24]

C | IS THE 3.3 VOLT SIDE OF THE LEVEK SHIFTER. 41 119 R404 4.7K 0603 | R4 150 0603 2 R3 150 0603 1 3 ANODE V_3V3 R8 270 0603 4 | C

UTILITY CONNECTIONS BETWEEN THE
MCU AND THE FPGAS. THE LEVEL
TRANSLATORS ARE UNI-DIRECTIONAL.

THE PREFIX "lov" MEANS "LOW VOLTAGE", AND
IS THE 1.8 VOLT FPGA SIDE OF THE LEVEL
SHIFTER.
THE PREFIX "hiv" MEANS "HIGH VOLTAGE, AND

B | TP3 | R7 150 0603 2 R6 150 0603 1 3 V_3V3 R11 270 0603 4 ANODE | B

2.12: LEDS AND LEVEL SHIFTERS

Tuesday, June 15, 2021 Tuesday, June 15, 2021 Tuesday, June 15, 2021 24 24 24 84 84 84

# THE "AB" QUADS ARE DEDICATED TO TCDS SIGNALS. THE "L" QUADS CONTAIN BOTH

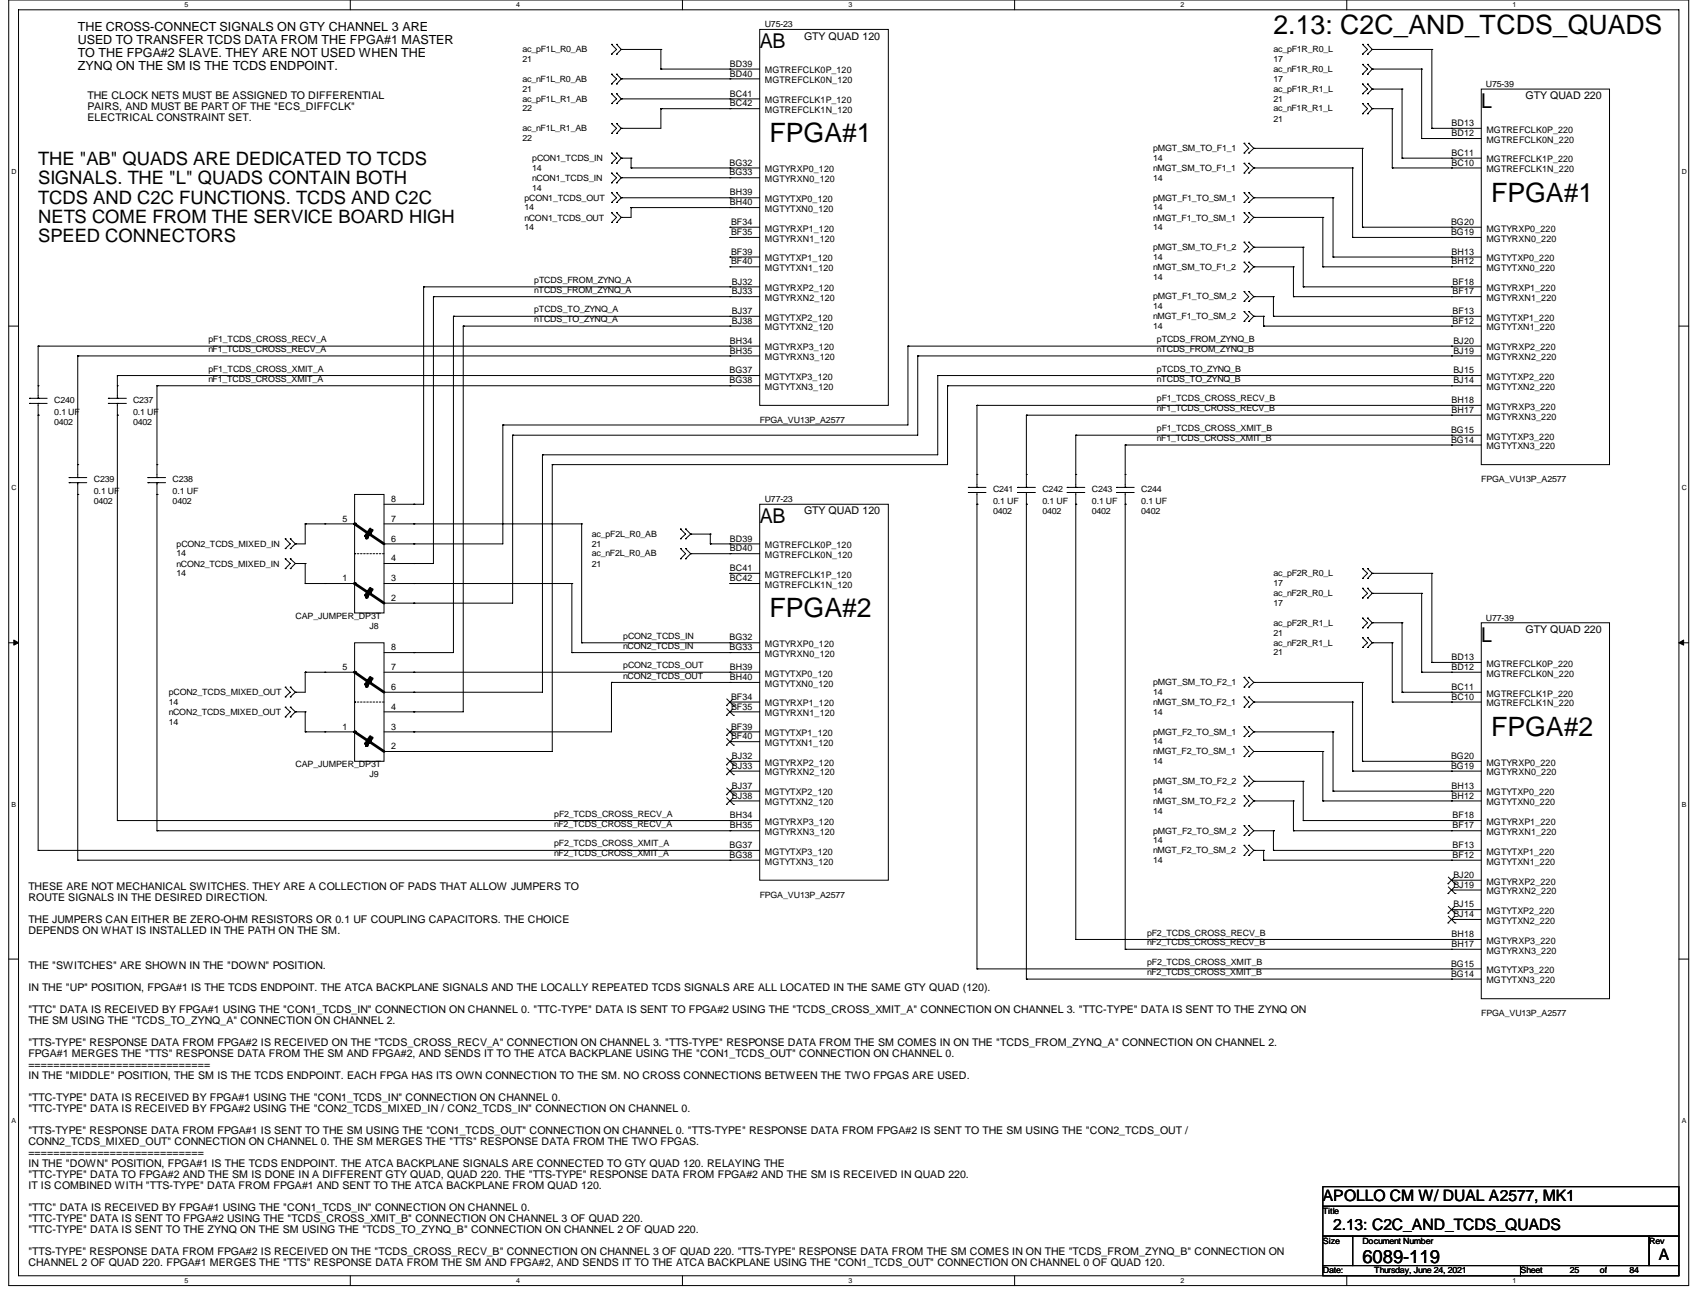
[picture p107: page 25]

THE CROSS-CONNECT SIGNALS ON GTY CHANNEL 3 ARE USED TO TRANSFER TCDS DATA FROM THE FPGA#1 MASTER | 2.13: C2C_AND_TCDS_QUADS U75-23 GTY QUAD 120 AB

TO THE FPGA#2 SLAVE. THEY ARE NOT USED WHEN THE
ZYNQ ON THE SM IS THE TCDS ENDPOINT.

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

TCDS AND C2C FUNCTIONS. TCDS AND C2C
NETS COME FROM THE SERVICE BOARD HIGH
SPEED CONNECTORS

C | | BH34 | pTCDS_FROM_ZYNQ_B BJ20 | C

THESE ARE NOT MECHANICAL SWITCHES. THEY ARE A COLLECTION OF PADS THAT ALLOW JUMPERS TO
ROUTE SIGNALS IN THE DESIRED DIRECTION.

THE JUMPERS CAN EITHER BE ZERO-OHM RESISTORS OR 0.1 UF COUPLING CAPACITORS. THE CHOICE
DEPENDS ON WHAT IS INSTALLED IN THE PATH ON THE SM.

THE "SWITCHES" ARE SHOWN IN THE "DOWN" POSITION.

IN THE "UP" POSITION, FPGA#1 IS THE TCDS ENDPOINT. THE ATCA BACKPLANE SIGNALS AND THE LOCALLY REPEATED TCDS SIGNALS ARE ALL LOCATED IN THE SAME GTY QUAD (120).

"TTC" DATA IS RECEIVED BY FPGA#1 USING THE "CON1_TCDS_IN" CONNECTION ON CHANNEL 0. "TTC-TYPE" DATA IS SENT TO FPGA#2 USING THE "TCDS_CROSS_XMIT_A" CONNECTION ON CHANNEL 3. "TTC-TYPE" DATA IS SENT TO THE ZYNQ ON
THE SM USING THE "TCDS_TO_ZYNQ_A" CONNECTION ON CHANNEL 2.

"TTS-TYPE" RESPONSE DATA FROM FPGA#2 IS RECEIVED ON THE "TCDS_CROSS_RECV_A" CONNECTION ON CHANNEL 3. "TTS-TYPE" RESPONSE DATA FROM THE SM COMES IN ON THE "TCDS_FROM_ZYNQ_A" CONNECTION ON CHANNEL 2.
FPGA#1 MERGES THE "TTS" RESPONSE DATA FROM THE SM AND FPGA#2, AND SENDS IT TO THE ATCA BACKPLANE USING THE "CON1_TCDS_OUT" CONNECTION ON CHANNEL 0.
IN THE "MIDDLE" POSITION, THE SM IS THE TCDS ENDPOINT. EACH FPGA HAS ITS OWN CONNECTION TO THE SM. NO CROSS CONNECTIONS BETWEEN THE TWO FPGAS ARE USED.

"TTC-TYPE" DATA IS RECEIVED BY FPGA#1 USING THE "CON1_TCDS_IN" CONNECTION ON CHANNEL 0.
"TTC-TYPE" DATA IS RECEIVED BY FPGA#2 USING THE "CON2_TCDS_MIXED_IN / CON2_TCDS_IN" CONNECTION ON CHANNEL 0.
"TTS-TYPE" RESPONSE DATA FROM FPGA#1 IS SENT TO THE SM USING THE "CON1_TCDS_OUT" CONNECTION ON CHANNEL 0. "TTS-TYPE" RESPONSE DATA FROM FPGA#2 IS SENT TO THE SM USING THE "CON2_TCDS_OUT /
CONN2_TCDS_MIXED_OUT" CONNECTION ON CHANNEL 0. THE SM MERGES THE "TTS" RESPONSE DATA FROM THE TWO FPGAS.
IN THE "DOWN" POSITION, FPGA#1 IS THE TCDS ENDPOINT. THE ATCA BACKPLANE SIGNALS ARE CONNECTED TO GTY QUAD 120. RELAYING THE
"TTC-TYPE" DATA TO FPGA#2 AND THE SM IS DONE IN A DIFFERENT GTY QUAD, QUAD 220. THE "TTS-TYPE" RESPONSE DATA FROM FPGA#2 AND THE SM IS RECEIVED IN QUAD 220.
IT IS COMBINED WITH "TTS-TYPE" DATA FROM FPGA#1 AND SENT TO THE ATCA BACKPLANE FROM QUAD 120.

"TTC" DATA IS RECEIVED BY FPGA#1 USING THE "CON1_TCDS_IN" CONNECTION ON CHANNEL 0.
"TTC-TYPE" DATA IS SENT TO FPGA#2 USING THE "TCDS_CROSS_XMIT_B" CONNECTION ON CHANNEL 3 OF QUAD 220.
"TTC-TYPE" DATA IS SENT TO THE ZYNQ ON THE SM USING THE "TCDS_TO_ZYNQ_B" CONNECTION ON CHANNEL 2 OF QUAD 220.

"TTS-TYPE" RESPONSE DATA FROM FPGA#2 IS RECEIVED ON THE "TCDS_CROSS_RECV_B" CONNECTION ON CHANNEL 3 OF QUAD 220. "TTS-TYPE" RESPONSE DATA FROM THE SM COMES IN ON THE "TCDS_FROM_ZYNQ_B" CONNECTION ON
CHANNEL 2 OF QUAD 220. FPGA#1 MERGES THE "TTS" RESPONSE DATA FROM THE SM AND FPGA#2, AND SENDS IT TO THE ATCA BACKPLANE USING THE "CON1_TCDS_OUT" CONNECTION ON CHANNEL 0 OF QUAD 120.

## SPREAD THESE CAPACITORS AROUND THE BOARD

2 4 NOTE 1 10 UF + 0402 0.005 22 UF | | 3.01: POWER MANAGEMENT M3V3 U123 1 S² S¹

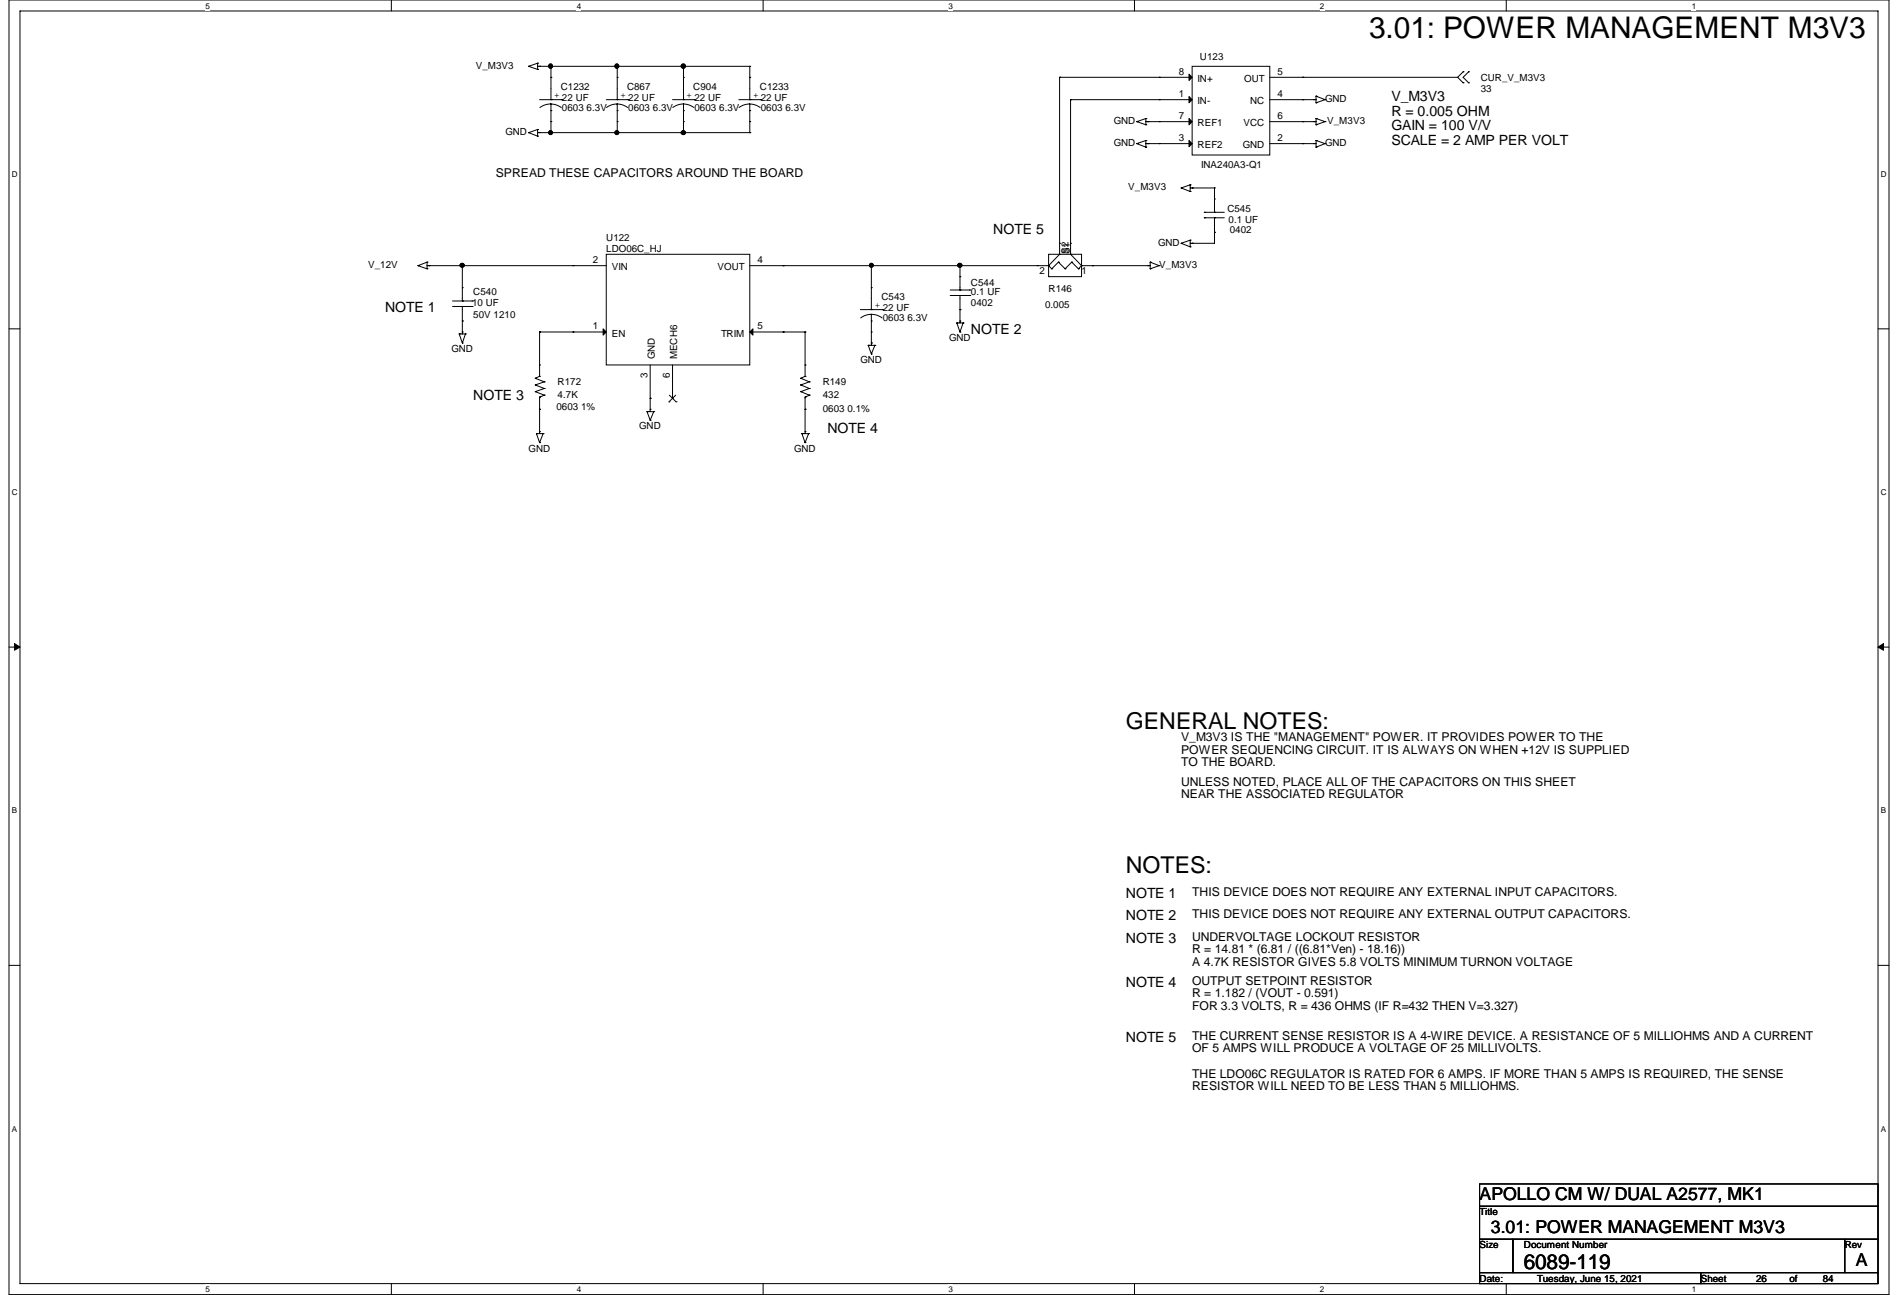
[picture p108: page 26]

C | GND | C

B | GENERAL NOTES: V_M3V3 IS THE "MANAGEMENT" POWER. IT PROVIDES POWER TO THE POWER SEQUENCING CIRCUIT. IT IS ALWAYS ON WHEN +12V IS SUPPLIED TO THE BOARD. UNLESS NOTED, PLACE ALL OF THE CAPACITORS ON THIS SHEET NEAR THE ASSOCIATED REGULATOR NOTES: THIS DEVICE DOES NOT REQUIRE ANY EXTERNAL INPUT CAPACITORS. NOTE 1 NOTE 2 THIS DEVICE DOES NOT REQUIRE ANY EXTERNAL OUTPUT CAPACITORS. NOTE 3 UNDERVOLTAGE LOCKOUT RESISTOR R = 14.81 * (6.81 / ((6.81*Ven) - 18.16)) A 4.7K RESISTOR GIVES 5.8 VOLTS MINIMUM TURNON VOLTAGE | B

OUTPUT SETPOINT RESISTOR NOTE 4 R = 1.182 / (VOUT - 0.591) FOR 3.3 VOLTS, R = 436 OHMS (IF R=432 THEN V=3.327) NOTE 5 THE CURRENT SENSE RESISTOR IS A 4-WIRE DEVICE. A RESISTANCE OF 5 MILLIOHMS AND A CURRENT OF 5 AMPS WILL PRODUCE A VOLTAGE OF 25 MILLIVOLTS. THE LDO06C REGULATOR IS RATED FOR 6 AMPS. IF MORE THAN 5 AMPS IS REQUIRED, THE SENSE RESISTOR WILL NEED TO BE LESS THAN 5 MILLIOHMS. 3.01: POWER MANAGEMENT M3V3 3.01: POWER MANAGEMENT M3V3 3.01: POWER MANAGEMENT M3V3 Tuesday, June 15, 2021 Tuesday, June 15, 2021 Tuesday, June 15, 2021 26 26 26 84 84 84

# I2C ADDR = 0X40 (AND 0X41)

## NOTE 6

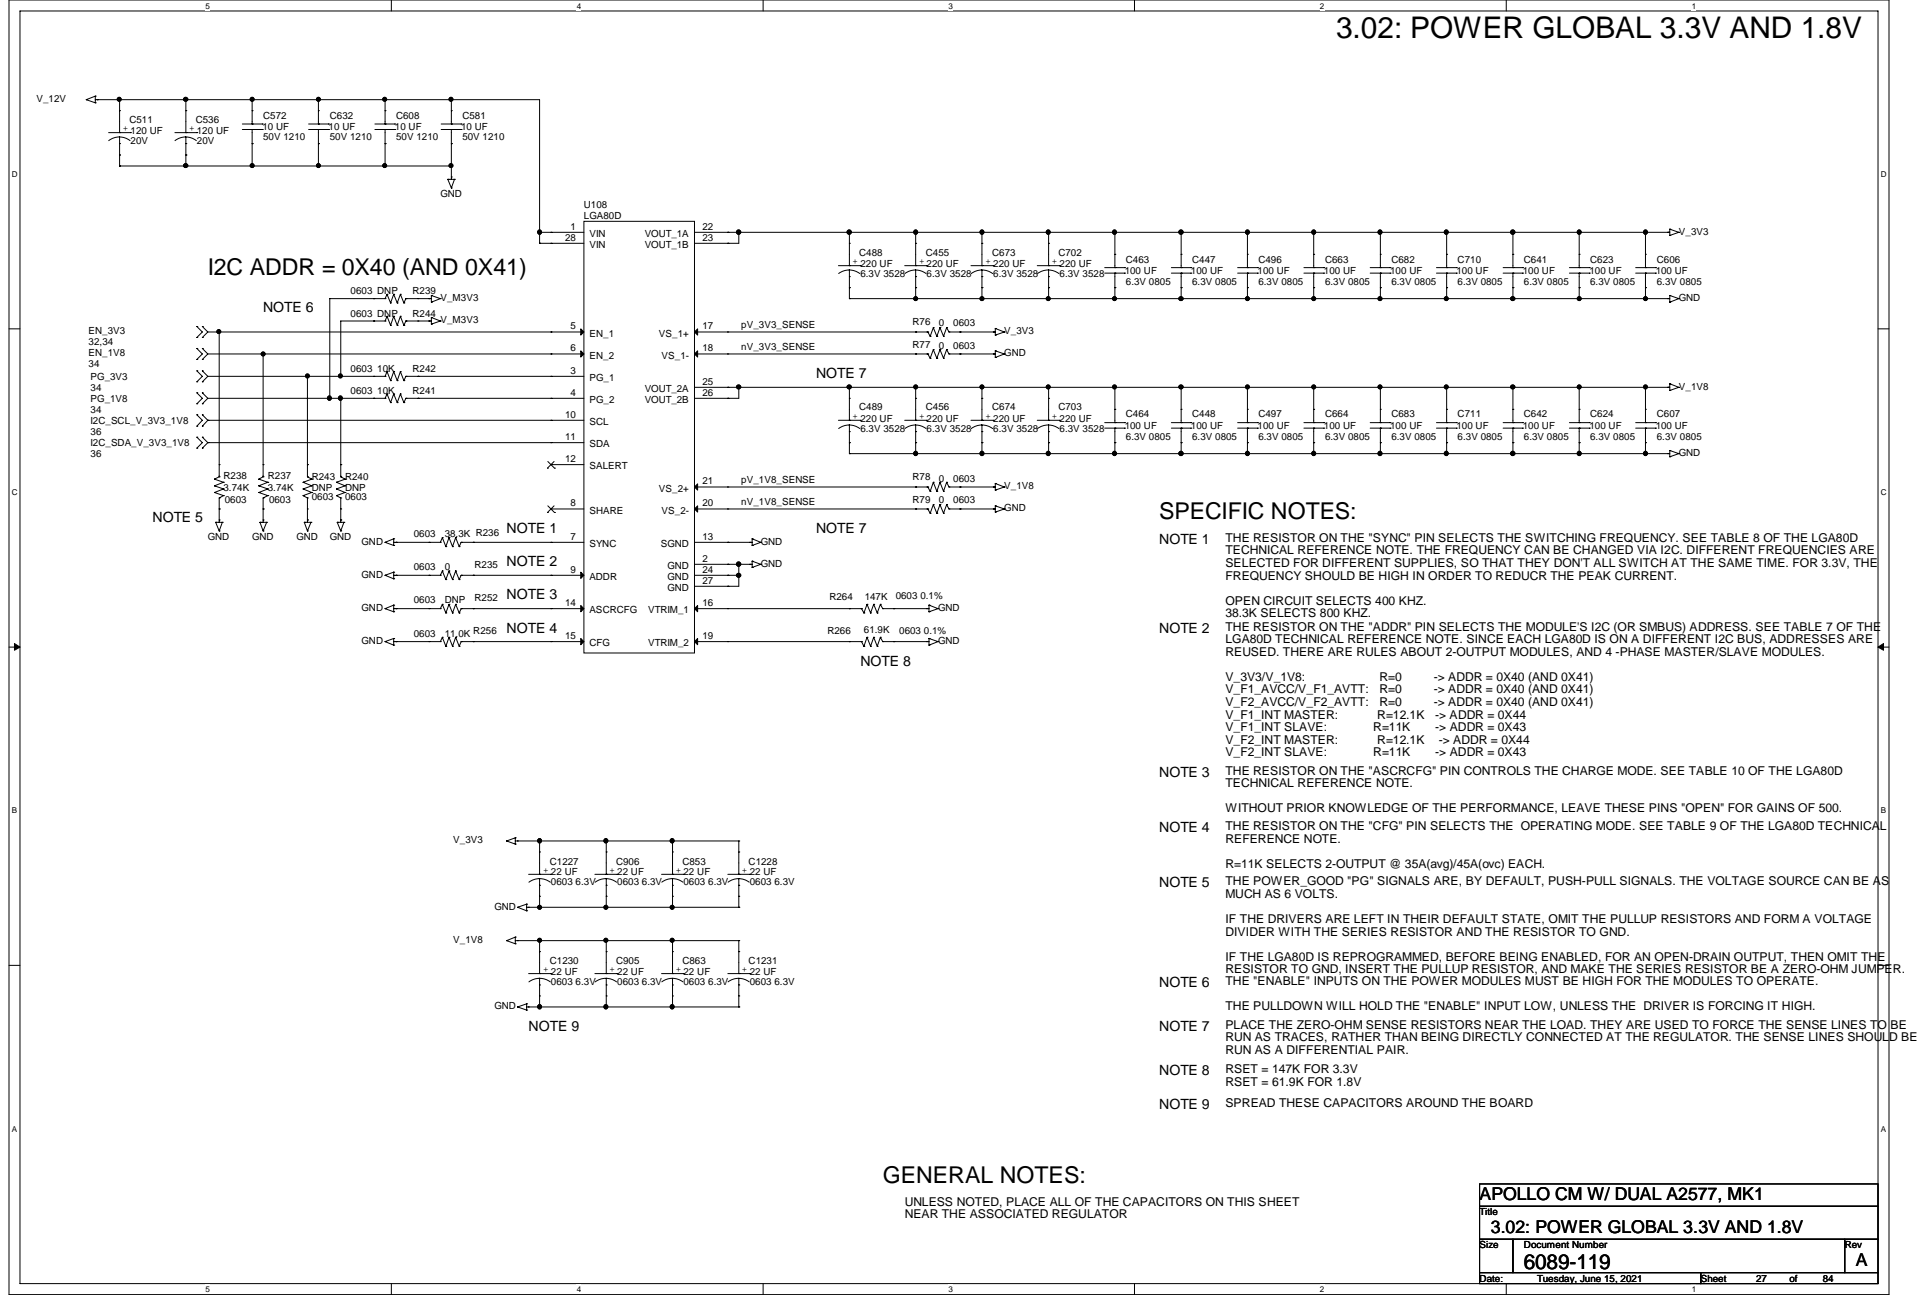
[picture p109: page 27]

THE RESISTOR ON THE "SYNC" PIN SELECTS THE SWITCHING FREQUENCY. SEE TABLE 8 OF THE LGA80D
TECHNICAL REFERENCE NOTE. THE FREQUENCY CAN BE CHANGED VIA I2C. DIFFERENT FREQUENCIES ARE
SELECTED FOR DIFFERENT SUPPLIES, SO THAT THEY DON'T ALL SWITCH AT THE SAME TIME. FOR 3.3V, THE
FREQUENCY SHOULD BE HIGH IN ORDER TO REDUCR THE PEAK CURRENT.
OPEN CIRCUIT SELECTS 400 KHZ.
38.3K SELECTS 800 KHZ.
THE RESISTOR ON THE "ADDR" PIN SELECTS THE MODULE'S I2C (OR SMBUS) ADDRESS. SEE TABLE 7 OF THE
LGA80D TECHNICAL REFERENCE NOTE. SINCE EACH LGA80D IS ON A DIFFERENT I2C BUS, ADDRESSES ARE
REUSED. THERE ARE RULES ABOUT 2-OUTPUT MODULES, AND 4 -PHASE MASTER/SLAVE MODULES.
THE RESISTOR ON THE "ASCRCFG" PIN CONTROLS THE CHARGE MODE. SEE TABLE 10 OF THE LGA80D
TECHNICAL REFERENCE NOTE.
WITHOUT PRIOR KNOWLEDGE OF THE PERFORMANCE, LEAVE THESE PINS "OPEN" FOR GAINS OF 500.

THE RESISTOR ON THE "CFG" PIN SELECTS THE OPERATING MODE. SEE TABLE 9 OF THE LGA80D TECHNICAL
REFERENCE NOTE.
R=11K SELECTS 2-OUTPUT @ 35A(avg)/45A(ovc) EACH.
THE POWER_GOOD "PG" SIGNALS ARE, BY DEFAULT, PUSH-PULL SIGNALS. THE VOLTAGE SOURCE CAN BE AS
MUCH AS 6 VOLTS.
IF THE DRIVERS ARE LEFT IN THEIR DEFAULT STATE, OMIT THE PULLUP RESISTORS AND FORM A VOLTAGE
DIVIDER WITH THE SERIES RESISTOR AND THE RESISTOR TO GND.
IF THE LGA80D IS REPROGRAMMED, BEFORE BEING ENABLED, FOR AN OPEN-DRAIN OUTPUT, THEN OMIT THE
RESISTOR TO GND, INSERT THE PULLUP RESISTOR, AND MAKE THE SERIES RESISTOR BE A ZERO-OHM JUMPER.
THE "ENABLE" INPUTS ON THE POWER MODULES MUST BE HIGH FOR THE MODULES TO OPERATE.
THE PULLDOWN WILL HOLD THE "ENABLE" INPUT LOW, UNLESS THE DRIVER IS FORCING IT HIGH.
PLACE THE ZERO-OHM SENSE RESISTORS NEAR THE LOAD. THEY ARE USED TO FORCE THE SENSE LINES TO BE
RUN AS TRACES, RATHER THAN BEING DIRECTLY CONNECTED AT THE REGULATOR. THE SENSE LINES SHOULD BE
RUN AS A DIFFERENTIAL PAIR.
RSET = 147K FOR 3.3V
RSET = 61.9K FOR 1.8V
SPREAD THESE CAPACITORS AROUND THE BOARD

UNLESS NOTED, PLACE ALL OF THE CAPACITORS ON THIS SHEET
NEAR THE ASSOCIATED REGULATOR

A

# I2C ADDR = 0X44

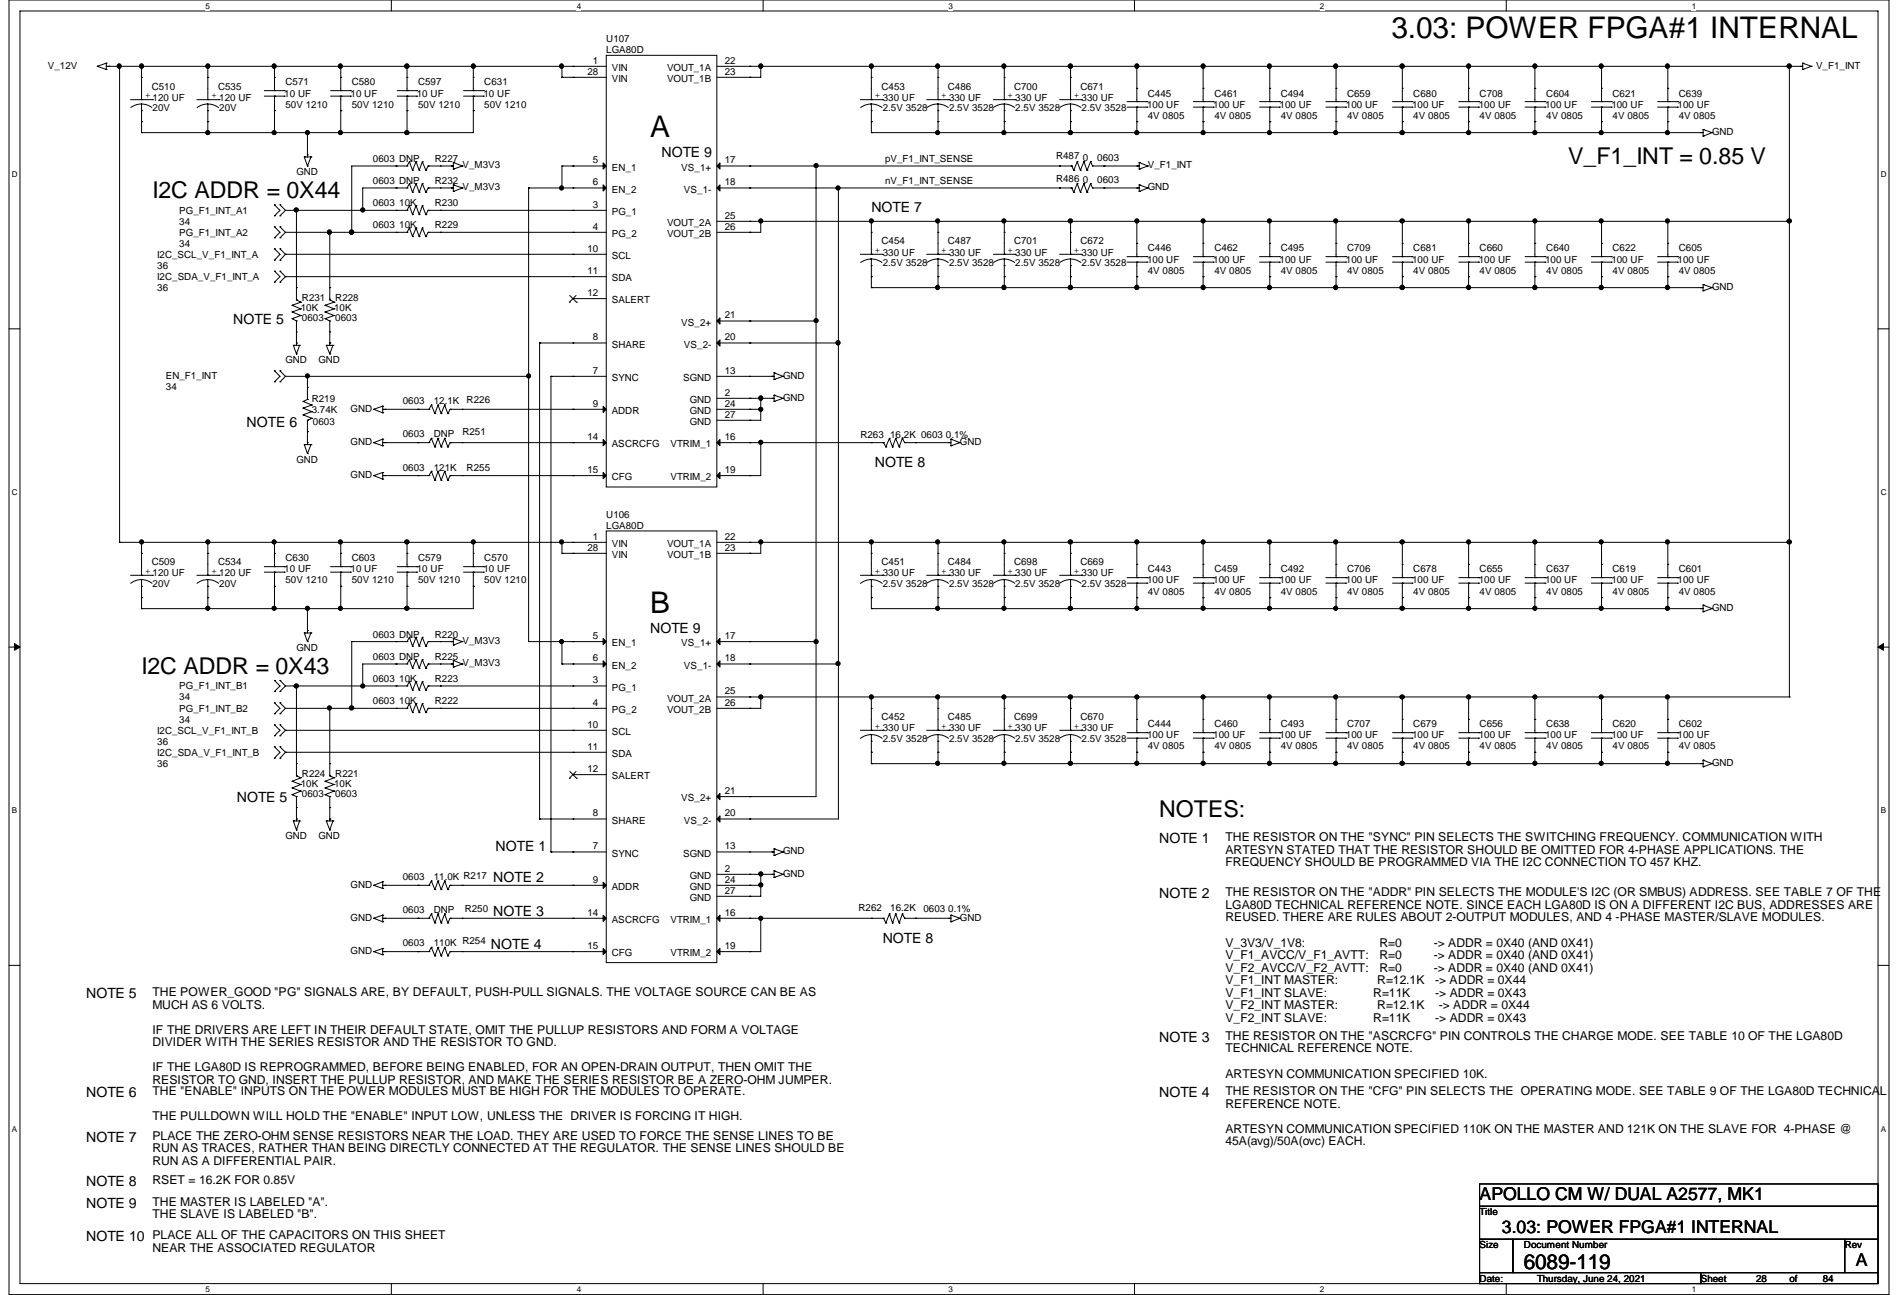
[picture p110: page 28]

U107 LGA80D | 3.03: POWER FPGA#1 INTERNAL

C | + + 10 UF 10 UF 10 UF 120 UF 120 UF | | | R263 16.2K 0603 0.1% GND NOTE 8 100 UF 100 UF 100 UF 100 UF 100 UF 100 UF 100 UF 100 UF 100 UF 2.5V 3528 2.5V 3528 2.5V 3528 2.5V 3528 | C

THE RESISTOR ON THE "SYNC" PIN SELECTS THE SWITCHING FREQUENCY. COMMUNICATION WITH
ARTESYN STATED THAT THE RESISTOR SHOULD BE OMITTED FOR 4-PHASE APPLICATIONS. THE
FREQUENCY SHOULD BE PROGRAMMED VIA THE I2C CONNECTION TO 457 KHZ.

NOTE 2 THE RESISTOR ON THE "ADDR" PIN SELECTS THE MODULE'S I2C (OR SMBUS) ADDRESS. SEE TABLE 7 OF THE

LGA80D TECHNICAL REFERENCE NOTE. SINCE EACH LGA80D IS ON A DIFFERENT I2C BUS, ADDRESSES ARE
REUSED. THERE ARE RULES ABOUT 2-OUTPUT MODULES, AND 4 -PHASE MASTER/SLAVE MODULES.
THE RESISTOR ON THE "ASCRCFG" PIN CONTROLS THE CHARGE MODE. SEE TABLE 10 OF THE LGA80D
TECHNICAL REFERENCE NOTE.
ARTESYN COMMUNICATION SPECIFIED 10K.
THE RESISTOR ON THE "CFG" PIN SELECTS THE OPERATING MODE. SEE TABLE 9 OF THE LGA80D TECHNICAL
REFERENCE NOTE.
ARTESYN COMMUNICATION SPECIFIED 110K ON THE MASTER AND 121K ON THE SLAVE FOR 4-PHASE @
45A(avg)/50A(ovc) EACH.

THE POWER_GOOD "PG" SIGNALS ARE, BY DEFAULT, PUSH-PULL SIGNALS. THE VOLTAGE SOURCE CAN BE AS
MUCH AS 6 VOLTS.
IF THE DRIVERS ARE LEFT IN THEIR DEFAULT STATE, OMIT THE PULLUP RESISTORS AND FORM A VOLTAGE
DIVIDER WITH THE SERIES RESISTOR AND THE RESISTOR TO GND.
IF THE LGA80D IS REPROGRAMMED, BEFORE BEING ENABLED, FOR AN OPEN-DRAIN OUTPUT, THEN OMIT THE
RESISTOR TO GND, INSERT THE PULLUP RESISTOR, AND MAKE THE SERIES RESISTOR BE A ZERO-OHM JUMPER.
THE "ENABLE" INPUTS ON THE POWER MODULES MUST BE HIGH FOR THE MODULES TO OPERATE.
THE PULLDOWN WILL HOLD THE "ENABLE" INPUT LOW, UNLESS THE DRIVER IS FORCING IT HIGH.
PLACE THE ZERO-OHM SENSE RESISTORS NEAR THE LOAD. THEY ARE USED TO FORCE THE SENSE LINES TO BE
RUN AS TRACES, RATHER THAN BEING DIRECTLY CONNECTED AT THE REGULATOR. THE SENSE LINES SHOULD BE
RUN AS A DIFFERENTIAL PAIR.
RSET = 16.2K FOR 0.85V

NOTE 8
NOTE 9 THE MASTER IS LABELED "A".

THE SLAVE IS LABELED "B".
PLACE ALL OF THE CAPACITORS ON THIS SHEET
NEAR THE ASSOCIATED REGULATOR

# V_F1_AVCC = 0.9 V
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
