mfkiwl/Cornell_CM_Rev2_HW/(list of files, drawings)

Other design files:
PCB_Rev2A/6089-119_reva_a2577x2.opj
PCB_Rev2B/6089-119-revb.opj
