mfkiwl/Cornell_CM_Rev2_HW/(commit log)

2021-02-22 Initial CMv2 repo
    [CMv2_TM4C_controller_pin_specs.xlsx]
2021-02-26 Updated pins connected to the SM
    [CMv2_TM4C_controller_pin_specs.xlsx]
2021-04-01 Update schematic PDF
2021-07-11 Latest schematics
2021-07-11 Updated schematic page numbers
    [CMv2_TM4C_controller_pin_specs.xlsx]
2021-11-23 Back to default I2C address range 0x68-0x6b
2021-11-29 Create Si5395-RevA-default-Registers.h
    Added file containing the default register contents after power-up. Configure by sending register's whose contents differs from the default.
2021-12-09 deleted sleep statemnet, added step printout
2022-01-25 Updated Rev2B files
    [6089-119-revb.opj, 6089-119_reva_a2577x2.opj]
2022-04-14 New R1Bv0003 for testing TCDS
    [Si5341-RevD-R0Av0003-Registers.csv, Si5395-RevA-R1Av0003-Registers.csv, Si5395-RevA-R1Bv0003-Registers.csv]
2022-04-29 updating LoadSynth.py to clean up the printout messages and not hang
2022-05-17 Created hardware BOM, updated checkout procedure
    [6089-119-RevB_HARDWARE_BOM_17May2022.xlsx]
2022-07-18 Updated assembly and inventory details
    [CMv2_Inventory.xlsx]
2022-07-18 Added spreadsheet to describe configurations
    [ConfigurationIndex.xlsx]
2022-10-12 New clock configuration files
    [CMv2_Inventory.xlsx, ConfigurationIndex.xlsx]
2022-12-07 Inventory update
    [CMv2_Inventory.xlsx]
2022-12-08 Made clock file R1Bv0005
    [ConfigurationIndex.xlsx]
2022-12-16 R0Av0006 clock files
    [CMv2_Inventory.xlsx, ConfigurationIndex.xlsx]
2022-12-19 modifying LoadSynth to switch bewteen r0a and r0b for the fpgas depending on which synth is getting programmed
2022-12-19 adding semaphore to LoadSynth.py and small fix to read-out-lines in the case of 'stuck'
    [LoadSynth.py]
2022-12-20 created R1Cv0004
    [ConfigurationIndex.xlsx]
2023-02-13 Corrected block diagram for "1.10 External Clocks" and "1.11 TCDS Simplified"
    [6089-119-revb.opj]
2024-01-19 Update ConfigurationIndex.xlsx
    Added R1Bv0006
    [ConfigurationIndex.xlsx]
